microresearch/allcolours/comparator_v2/draftlayoutknobs_sm.png

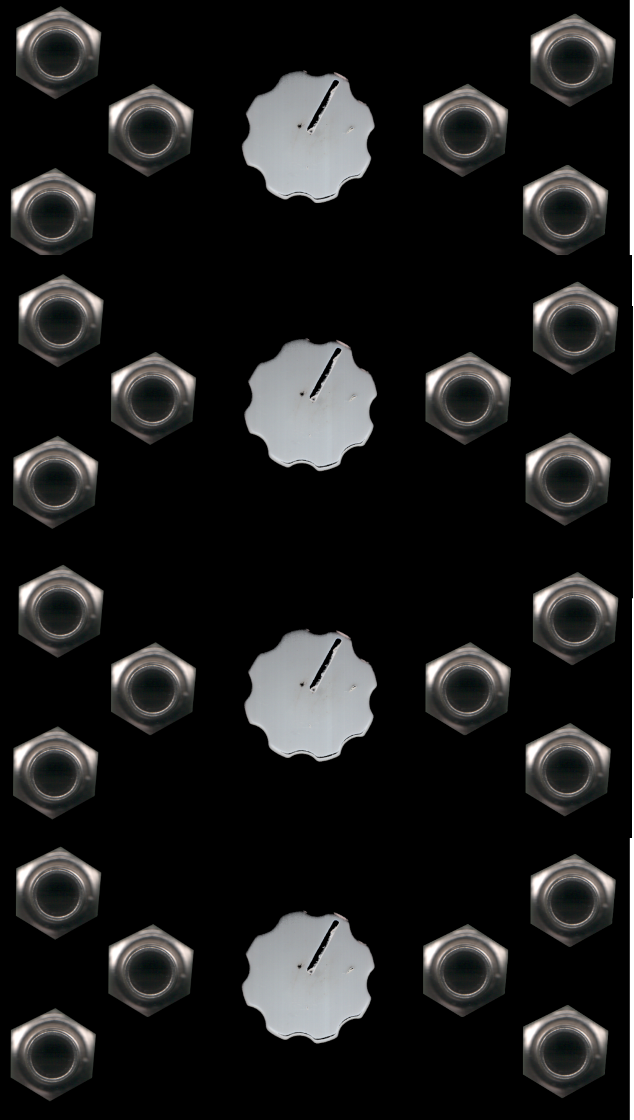
comparator_v2/draftlayoutknobs_sm.png
