microresearch/allcolours/all_colours_hardware_notes.org

* notes/phrases

- a flip flop is both memory and switch, swithcing back to oscillation to envelope and to change
- the gate is a gatekeeper
- self switching is the latch which is memory, positive feedback

* for manual/website

AURORA CONSURGENS ALL COLOURS AC

- start with Aurora Consurgens/rising dawn == All Colours stuff (see notebook - where???)
- A suggested signal path high frequency noise channeled to the gatekeeper ... same for low frequency

high and low, left and right, as above so below

- panels as a series of snakes/dragons from Ripley (collect these here alongisde other sources)

dragons also descending in harley 2407 - mouths in the basin/fountain

twin dragons also from 2407 manuscript sig page

** basic description (not for manual)

ouroboric noise at all frequencies

segments, quarters hung drawn and quartered...

walk ins from newer SR description

constructed for self-patching - this should always be undertaken in ouroboric fashion, feedbacking between the four segments...

* 3/7

clock as central - noise as clock, clock comparatored with noise,
shift reg clock, squared up noise as clock

clock as pulses

clock -> shift reg // filter // comp // as noise

all colours as pulse/noise/filter

ripley scroll

* 10/7

Shift reg/mostly in software:

https://www.embeddedrelated.com/showarticle/1112.php

https://www.avrfreaks.net/forum/256-bit-shift-register-required?page=all

http://electro-music.com/forum/topic-23881.html

* 19/7

- switch to MAX7490 - switched cap all purpose 2nd order x2 (so we can cascade
  for 4th order as compared to 8th order for MAX7400):

https://www.mouser.de/datasheet/2/256/MAX7490-MAX7491-91768.pdf

+5v, ext clock 100:1, QSOP16, 

- flip flop for shift register - flips on each clock/pulse

- shift register from http://www.cgs.synth.net/modules/cgs13v2_gated_comparator.html works well

16 shifted outs for clock OUTS in circle around

XOR also/ INS all buffered for fingers - TESTED

- to start adding to a test circuit...

* 26/7

- finger tested - op amp/buffer --|>---[] []---|>comp]=- (comparator with diode and 100k to GND)

- comparator also with finger voltage divider...

- question of AVR and/or shift reg/XOR etc. - but we need multiple ins
  and outs for AVR so maybe better served with ARM or with ATMEGA128

- TEST: how fast we can run shift reg, speeds and settings for various PWM

* 30/7

- manual in the form of a poster

- all digital sections (7490, AVR and even between both CLOCK) as blackboxed for 12v in and out = protection/ins and/or shift levels, CV in also

pulse inputs:
https://electronics.stackexchange.com/questions/43498/how-can-i-use-a-12-v-input-on-a-digital-arduino-pin
zener and resistor also as in microbd/SIR

pulse out as 2n2222, pulse in as transistor now

avr is 5v currently

- timing - for SR included code and simple pulse on/off is 130 KHz, fastest we can go with no code is 480 KHz

* 10/8

- have 16 pulse ins and outs and configure length of SR in software (maybe add one extra cv)

* 21/8

- have 7490 for bandpass or highpass and 7400 for lowpass (as is 8th stage and easier)
- gating of noise as pulses with primitive envelope/VCA with single transistor:

http://www.electro-music.com/forum/topic-33190-25.html

* 23/8

- maybe 7 ins/outs for pulses to micro, 7 envelopes-7 env is too many?

* 29/9

- see new ouroboros design as centre piece - perhaps exposed gold all
- check comparator out voltage and if we need to mix with micro/pwm for filter clock in
- new design follows eagle/worm/toad/earth
- earth as ripples in ripley sea
- LFSR as outer ouroboros
- check all possible signal paths for fingers and patchables
- standalone - fingers only with one input and out, euro - patchable internally and externally
- Q of switch for filter input between noise and other source (hand) 4066, 4053 - now dg419

* 29/11

- set 7490 as high pass and spec resistors - 10K for R2 and R4 and 200K for R3
- how to resolve finger/filter clock routings? - with another analogue switch // dg419

- list all jacks: *check this*

filter: in, clock in, lpoutx3, hpoutx3 [for feedback]

AVR/LFSR: cv_in, cv_in, clock pulse in, pulse in, pulse out, hf pulse out, hf pulse in

noise: 2x noise out for patchings, comp1, comp2, compout for processing

ouroboros: in and out

envelopes? - maybe leave as fingers only or one envelope in, in2, out

/////

- what is size in HP (for standalone we could use 4ms pod as 26, 32 or 60 HP - also frap tools)= 32HP=162.5mm or 42HP?=213mm

*20HP=101.4mm*

(height 128.5)

- how many pulse in/outs from atmega 6in 6out 2env? 6 ouroboros...

pulse in and out low and high frequency versions??? where to place?

6x pulse in/out low +1 pulse in HF, +1 pulse out HF

- sketch analogue only version for larger home etch... - fingers and two jacks...
- how to connect top and bottom pcb - jack height = 11mm (smd options for top panel?), how many connections 

eg reich: SL 2X36G SMD2,54 on one side and 8.5mm on the other

- comparator on one noise source

- normal signal path noise->comp->filter/pwm clock on filter->LP/HP OUT

- check comp as usual/flat gives straight noise out - which it would never do so we need to make this modular/seperate

* 30/11

- decision to make all patchable by jack and finger. so no switches/dg419, no norms
- thus we need to work out common patches so we can have all jacks

layers: 

filter
avr/LFSR/pulses
noise-ouroboros-osc

where we put comparator/env/low and high freq sections?

comparator=gatekeeper/triangle

- lose filter comp as we have comparator as modular, lose also avr comp for clock (replaced with pulse in)

- maybe add extra modular comp

* 4/12 ++  19/12

TODO:

- +check footprints for both projects...+
- misc graphical elements and overlays...
- noise as drops for analogue/etc
- flip-flops/toggle analogue switches (for touch open analogue version):

flip flops: 4013, 7474, 7473

dg419 or 4066/4053 or even transistor switch (as in rough envelope but then we have one way only - but we can use for other audio paths)

the simplest thing to do is to AC couple the in/out pins and bias them
to the middle of the 4053's power supply. In a +9V system, this only
needs a two resistor divider and a cap, then a resistor and capacitor
per in/out pin.

what are paths to switch

circles/layers:
1-exposed comparator
2-ouroboros
3-switched noise
4-SR
5-filter (paths in?) 

- test 7490 as bandpass again with noise source
- question of mhz for pwm -> test 

- *place low pass on output in case pwm comes through*

- for analogue only: flipflops for shift register so we have access to
  all ins (which are also outs but guess simpler/unbuffered), delay
  (switchable) on ouroboros - cap to gnd

- question of bias for ouroboros...

TEST: flipflop touch switch and SR, bias on ouroboros. delay on ouroboros

refs:

http://mickeydelp.com/blog/anatomy-of-a-drum-machine?

http://www.sdiy.org/richardc64/new_drums/dr110/dr110a1.html

transistor comparator: http://ch00ftech.com/2012/06/20/2279/

question of abstracting out connections and elements. eg. clocks, different clock sources and should we divide these?

* 3/1 design notes

- panel breakout for euro/less analogue version: replace pads, *how many?*, include voltages and in/out - interchangeable front panels hand-made perhaps
- hand drawn transistor ouroboros in centre
- led triggered by micro in middle underneath exposed/no soldermask portion (how to expose all?)

* 7/1 tests:

- 1M on ouroboros makes things quieter and more stable - we could use finger pads for bias up and down

- TODO/TEST:

- test sr cell idea(?) from philips pdf
- capacitor delay on ouroboros - say 1n between collector and base (noisier but need to see how it works properly)...

// for simple All Colours

+- pwm mhz changes DONE+

+- 7490 bandpass with noise sourceDONE+

- flip/flop touch 4013

- in out transistor micro pulses and inv/non-inv amps for finger ins? (buffers on first straight followers)

OUT - lose pull down and reduce collector to 1k, base is 10k - at highest freqency we lose gain (MHz)

IN - could reduce base resistor (47k) but seems to work ok with buffered signals, test more, and no pulldown, and with hc14?

- offsetted clocks with logical operations across clock rings - SR is
  NOT pulses (we could AND it with its clock), but out of micro SR
  simulation IS pulses

- different smd transistors tested for noise generators and re-check BEC layout etc...

* 29/1 2019 from touch: analogue/breakup tests

- only so many fingers, so use more flipflopped paths as a way of patching
- audio in/out path should not use fingers
- test individual circuits and keep simple ones as insignias...
- pads too small and too close to gnd/other signals
- for ouroboros we need switching in/out to avoid oscillation
- check transistor layouts!

* 7/2

- what we could do for test SMD assembly/quote - STM, base board or front panel with ouroboros and other simple circuits...

* 12/2

- ALL pulses/SR are in interrupts, all as multiple pulse outs without modes/cases for these, modes only for how SR connects and for slower SR stuff

- open and close ouroboros in one place with both touch flipflops and finger/transistor in

- spiral out from ouroboros with switch/latch/env elements/recursive/noise

* 20/3

- add extra 7490 in chain for extra poles
- add 4 or 8 bit DAC on shift register/AVR

* 21/6

- for all colours smaller panel: 20hp, one side is gold on bare
  pcb, other side is gold on black mask (or black mask on gold)

filtered low freq pwm, 4 bit DAC (for both low and high sides),
trimmers for noise level on back, finger osc centre pads into mix,
maybe top or bottom is diff amp (TO TEST) and other is comparator (x2
on each side)...

- tested comparator with pwm in and this can be interesting with external CV
- also mix back filter feedback is very crackly and could pulse nicely somehow? (env returned?)
- we need to swop pwm around so 16 bit is HF to get good range, and 8 bit is LF but we want to be able to change pulse width
- check all possible paths

* 25/7

- avr at 16 MHz 8 bit is too slow for fast shift register action so options:

outboard flipflops under hardware control - too complex
STM - which one, small package, easy development
FPGA - nice in long term?

we need:

1 or 2 timed and 2 pin interrupts, 2xPWM outs (so 3 or 4 timers), 4x CV ins ADC

GPIO in and out (3.3v): how many: 4ins(2 are interrupts), 5 pulse out, 1x4bitDACs,  2PWm outs, 4CV in (total 19!)

stm32 as we can use worm code and stlink programmer...

choose _==*> STM32F103CBT6 - see peaks, braids  - LQFP-48  72 MHz 5euros -> test board ordered

3 timers and one PWM... ok

//setup programming/build env/makefile/try pwm/gpio/ADC/interrupts/schematic

////////////////

///NO to below as programming is usb only via IC:

Cortex-M0+ - teensy LC, 48 MHz

M4 - teensy 3.2 72/96MHz 

MKL26Z64VFT4 Cortex-M0+

MK20DX256VLH7 Cortex-M4

//coding/programming - but teensy is programmed via usb?

https://github.com/PaulStoffregen/cores/blob/master/teensy3/Makefile

http://kevincuzner.com/2014/04/28/teensy-3-1-bare-metal/

https://github.com/djmdjm/teensy3

* 26/7 +

- different clocks for high and low pwm but keep diff of audio signals in to filters

*but how do we deal with PWM filter?*

STM32F103 base: https://github.com/trebisky/stm32f103/tree/master/interrupt

https://github.com/avislab/STM32F103/tree/master/Example_ADC

peaks: https://github.com/pichenettes/eurorack/tree/master/peaks

braids: https://github.com/pichenettes/eurorack/tree/master/braids

// TODO with blue pill test board:

- basic makefile, programming connection, blinky LED (GPIO pin 13 on C), how fast toggle pins=3.3 MHz with -O3

quick test: stm thing has from top: VDD, SWCLK, GND, SWDIO

we gnd boot0 on blue pill board, programmer header on this with usb (powered) at top is from left: 3v3, SWDIO, SWCLK, GND

and using templates example and:

:  st-flash write blink-cmsis_firmware.bin 0x08000000

this works/flashes!

//////////////

- pin input and pin interrupts, pin mappings, one or two PWM, timer interrupts x2 maybe, DAC=PA0-PA7, PB0, PB1

organise pins around what works for pwm and interrupts: TIM2 and 3 seem have global interrupts...

there are 4 timers -> 2 int->2 and 3 test, 2 pwm->1 and 4

- translate to schematic depending on timers etc.

** findings

- PWM is fast, but interrupt timer and interrupt pins peak at around
  700 KHz (which for high could translate as around 10-14K which is OK
  but we need to execute stuff!)

** refs

https://github.com/istepaniuk/stm32-templates.git

http://stefanfrings.de/stm32/stm32f1.html

https://satoshinm.github.io/blog/171212_stm32_blue_pill_arm_development_board_first_look_bare_metal_programming.html

https://github.com/rogerclarkmelbourne/Arduino_STM32

http://www.diller-technologies.de/stm32_wide.html#interrupts_extern

* 17/9

- panel left will need full solder mask and circles for ... IN or OUT?

  and circles need gold/mask or just soldermask - 5mm radius, 0.2mm thickness - and watch as
  some footprints are reversed/mirrored ???

* 23/9

- basic PCB assembled test: no heat and all voltages seem fine
- TODO: +test programming of STM+ and basic hardware

programming works fine!

TESTS/TODO: print jack layout, noise out, comps, filter with pwm, pulse in and out, finish programming, panels, xl for assembly quote 

* 9/10

- tested both noise outs - fine
- panel finished - check basic hardware before ordering - size is 101.4x128.5

* 10/10

- testing so far: we need to re-adjust /adj/ resistors on all comparators -> what did we use (we used 1k for testing now)

for noise we can use 10k-15k on positive, 1k-4k7 on negative.

but will depend on levels, also for pwm (level is 0-10v)?

- both PWMs now working fine/adjust range and dividers - filters working, check levels etc...
- ends of ADC knobs for speed are clicky - smoothing or???

* 14/10

PCB CHANGES:

- top of comp -> + adj res is now 10k, and lower to GND is 4.7k, changed on schematic but not on PCB/now changed on PCB

- we need to change the 4 incoming res to 100N caps by hand on PCB -> redo each precise location/recorded

comphf1in/r27->c10 153.71, 119.99 X

comphf_clkin/r44->c12 154.275, 79.95 

complf1in/r26->c11 104.53, 72.68 X

complf_clkin/r62->c13 102.3, 89.875 X

->>>DONE

- we need to change the 4392 comparator for a fast op amp with higher common mode input voltage, maybe also all op amps on 12v supply or?

!changed back to TL082 except for fast noise op amp!

* 21/10

- try replace 4392 with TLE2072 (mouser: 595-TLE2072IDR ) and see if bleedthrough /// 4392 on fast noise source is ok!
- no impedance issues on comp inputs
- TODO: recheck all noises, comps and filter levels with scope, clicks were
  not adc smoothing but changes - fixed to some degree with preload
  for pwm values but we can also try smoothing, check pulse in/with
  interrupts and pulse out, check timer interrupts

- study SR stuff and define precisely all modes, implement and test modes

modes.org -> max 64 modes= 4PWM x 16SR

* 28/10

- minimal bleedthrough with TLE2072 as U12 sub (rework on pcb an schematic)-DONE

doesn't bleed on pwm but signal in on C1ch 

-------> highest speed is 280KHz vpp 4.2v with TLE2072, with TL082 we
have 3.4v which seems to work fine for filter and with no
bleedthrough...

- check all levels VPP:

PWMH: 3.8v
PWML: 3.8v
noiseL: 2v (maybe increase R19)
noiseH: 3v (maybe increase R12)
compLC: 5v - as these 2 are limited by filter clock input diodes
compHC: 5v
compLA: 7v
compHA: 8v
filter outH: 2v
filter outL: 1.6v peak - maybe more gain on these ? - input we halve on way in from diffaudio which is the 2 compsLA and HA 

- check pulse outs: DONE all working
- check interrupt ins and regular pulse ins

problem is that we are on the same interrupt for both clock pins in: void EXTI9_5_IRQHandler(void)

[note if we want other pulse ins as interrupts these are on: PB6 and PB10 which are EXTI: 6 and EXTI: 10 I guess?

so 10 (HF side) would be on different interrupt: EXTI15_10_IRQHandler

but both work ok as interrupts - sample code toggles pulse out on each side... DONE

- check 2x timer interrupts: we use TIM2 for HF and TIM4 or LF! DONE!

- test that both mode CV knobs work ADC0 and ADC1 !-> yes!

/////////////////

- adc smoothing if we need // not necessary so far but might be for modes...

- define clearly all modes

* 29/10

- schematic reworked and some problems fixed so will need to re-order and test again

- started on modes// tested simple pulse outs and simple SR codeDONE but
  need to doublecheck with test.c lap code to make sureDONE

- speed of updates/sr interrupt means we can't use speed as offset, but maybe in pulses code!

* 30/10

// TODO: before we fill out all modes, deal with length and spacings - SRlengthh should not be <2
// ----: also deal with how we space the out bits - now is just length/2-DONE

// copy working length code from mode 0 to rest->DONE but we need to re-test all of them

// test lf and hf together with latest mode code - CLOSE

// thinking also whether clock/pulse should be toggle or other pulse as toggle?
// as other pulse is not normed to anything - leave as clock as toggle DONE

* 31/10

- added LF code - in TIM2 interrupt we need to watch how fast we can run it - otherwise it doesn't run - check all possibles!
- case 7 - electronotes crossover seems to work so far

* 1/11

- all SR modes implemented on high side - to re-test one by one, copy over to low

// questions of tap out for each

- start on clocked modes and pwm modes...

* 18/11  +

- TODO: test power/bleedDONE, clarify code, test modes, re-check/order PCB-DONE, re-test-check amp parts to alter, check panel/print itDONE

power is: 120mA at +12V, 30mA at -12V, 0mA at 5v

- test mode/case 7/electronotes on lap TESTED/DONE!

* 24/11+

- to re-do all SR as lower bits = faster = (so change looker and SR taps also) and other codes/re-test each mode and tweak DONE

////////////

- finish all modes with PWM
- test which modes can do without pulses in (not clock, other)

* 27/11+

- we need to fix levels (high freq noise now with 100k in feedback
  gives 5 VPP), fix range of comparators for this - so each is say
  4.7k top and bottom to give 2.5v-7.5v with centre at 5v

- testing HF SR modes DONE

* 9/12+

- change pulse outs to 1k from 10v to transistor TODO/DONE on schematic
  
- TODO: re-test all modes, amplitude tests with new R12, R19 (mark)

- question of SR/modes speed [on/off in pwm mode is 120 KHz max on x200 - do we need this to be faster?]

can't get much faster - new model on modes 0 in both gives us less instructions...

* 30/12

- changes on schematic and PCB: r61 to 24k, r102->24k, r12->100k, r19 to 240k TO TEST... how much 12,19 will vary with noise sources?

finalised here to R61=27k, r102=10k (for filters)

r12=100k, r19=470k for noise sources

- xls BOM format for pcbcart in progress/close to finished, double check before quote, check all new values also to finish

- software updates 

- *one sr as clock for the other - but hard to implement across different interrupts or... ? - maybe keep for next SR module*

* 6/1/2020

- how to scale filters 1v/oct? // logarithmic - we have 0-5 volts so that is 5 octaves

speedh=(ADCBuffer[2]>>4)+312; // adjust these base settings

so 12 bits is 4096

but which way round (we want end of log bit at lowest so subtract from Y)... and what is our range - here it is from 312 (highest frequency) to 4095+312 (lowest)

(2^5 = 32x)

freq for 4096 is: 12MHz (fastest)->312 = 38k / 32=1.2k approx which is a value of what in pwm = 10000 so that is our range (13 bits approx or map this to less bits in lookup)

or do we just map 2^5 and add the 312?

where is log_gen - here now!

so we need to measure this and check this somehow

[from worm: // 1v/oct for 5v = 2^5 = x32  generated by: log_gen.py
// xx=numpy.logspace(0, 5, num=1024, endpoint=True, base=2.0) # num is now many we want]

* 7/1/2020

- now PWM ranges from 7.5KHz to 220KHZ which is around 32x. to test with fixed voltage increments...

- 2nd build has all working but both low noise is 3vpp, high is 1vpp which is too low (both should be ideally around 6v), swop out Q1 for LF, Q3 for HF to try to fix

otherwise all fine...

- should we have SR timing also as logarithmic - test this (what scale though - at present it is: 

  speedhh=ADCBuffer[2]>>6;     // test changing counter for LF and HF IRQ 

so that's 10 bits - value 0-1024 for countings... but do we want this as octaves then we would only have 32 graduations or less as there is prescalar of 8 on this...

or how to do this without prescalar and period? or at least a lower prescalar? but we have both LF and HF sides running in this one...TEST?

- is it possible to have extra PWM modes for linear and range towards the top and bottom in both cases? (possibly 128 modes in that case)?

- do we make DAC for PWM follow the log array or....?

- *we need to test PWM DAC spacings and also this log option!*

// recheck schematic/all and rematch up parts to check is all there (print both)... check diodes=checked and caps=checked orientDONE -> nearly ready for quote...

* 8/1

list of TODOs for software and hardware before we do quote:

- test PWM range with 1v steps - DONE and FIXED!

- test SR timing as log and if we can go higher on prescalar/period with longer speedhh etc.

we can't go higher so can't really do a 1v log there - *so we need to decide what kind of range we have here* 

but maybe it should be logarithmic so more detailed at upper end... tho. this will involve repeats -> question of range is the one but *LOG IT*

- can we work in 128 modes with split of linear/exp and how to do this
  fast (can we handle 128 modes?) = test slippage, also would be more
  than 128 but maybe limit to selected modes...

so test slippage first: *we can only really have 64 modes*

- do we have PWM DAC follow LOG array? should be... test say mode 0 with DAC - DONE but gurgling results ->

maybe use less bits, spacings (but these will have to be dependent on size so we end up with lots of arrays, anyways)..

PWM sounds better withOUT LOG option and wide range which makes it gurgly, or what can we use to effect range?

////

- test PWM DAC spacings (how could these also be variable in one mode perhaps - in pulse mode?)

- do all modes make sense - what alternative modes there could be which take advantage of internal access to each SR bit?:::

//- CV as chance of a bit leaking or spreading either side, what could
be malfunctioning logic with CV as chance on bits, swap and msk bits
across two SRs,

(also. differing taps, shifting taps arrays) - *maybe we can have differing sets of modes for each side to get over constraints - eg. on lf side we have close taps*

0- pwm follows speed cv 

1- pwms follow clock pulse in for each - how we do this? speed CV as divider/multiplier of this - how to do for LOG scale 

2- pwm follows DAC from SR + pwm follows DAC - different range or spacings maybe in pulse modes - can have different PWM modes paired with pulse/cv modes?

3- pwm is offset against the other (with each speed as plus/minus offset) - if both have this mode then left one is set by speed CV
// how often do we update this last one...????? and we need to record this somewhere (or is as PWM -> check?)

analyse modes - what sounds the same, what new we can add

*also what we can keep for next one - eg. shifting the arrays of taps, arrays of spacings, one sr as clock for other (would need to be as function pointer maybe - try this out)*

* 9/1

- re-testing earlier comparator vs. newest and now stick with newer as less offset issues DONE-NO!see below

- TODO: fix on and test modes, any mode differences across each and alt taps stuff:

shifting the arrays of taps (4 taps in each one, limited to length) -> shift and wraparound 

* 13/1

hardware changes:

- we will revert to earlier comparator for better sound maybe.. (100k
  in on gnd is needed) and rest as old, but with one side comp gnded
  and we will need to select values - TODO, re-order PCB... extra parts and extra caps for +- power...

- C7 needs to be 1uF tantalum! 25V

- new diodes are 1N4148: Diodes - General Purpose, Power, Switching SURFACE MOUNT FAST SWITCHING DIODE  

1N4148W-7-F  Diodes Incorporated SOD-123 

- changed c7, changed comparator, changed 12v on pulse and pwm outs and added divider for pulse outs, added two protection diodes for 7400/7490

- added 1K in on both filter clocks.

[note in previous version lower should be 20k and upper 10k?)

* 14/1 TODO: 

- summarise software TODO:

1- review all modes and maybe squeeze in new mode with shifted tap arrays (test this anyways), also more modes for internal SR access *like what?*

list these, test these, note that we can have different modes for each side and different pwm/dac modes also depending on modes

potentially we could have ADC/DAC mode (now mode 12) which also sets the spacing of the taps, shifts these taps in real time...

add in as many modes as we can imagine and then trim down, also alt PWM modes...

2- what is the range for SR timing - it should also be logarithmic but not 1v/oct
3- PWM DAC spacings and maybe extra mode
4- for PWM how do we combine clock and knob in one...(clock is multiplier of knob?) but PWM is log array = we combine in mode 1 now = not as a single mode
5- so extra pwm mode with DAC spacings - also different ranges
5.5- for pwm and SR modes:  either 4x sections of 16 or 16 sections of 4??? latter is easier... try both
6- implement all modes and test - see notes below also for fixes
7- clean up comments and ordering of modes so that for example change of length is BANG in the quarters/middle of CV

* 15/1

- checked and doublechecked, added vias

- thinking to norm noiself_out to pulself1_in1 and noisehf_out to pulsehf1_in1 but we need to test this -> *test with all modes*

- do we have ADC in mode (for PWM out) - would be in pulse modes IN PROCESS mode 12...

- and also maybe we can get rid of pull downs on pulse in transistors: R79, R91, R104, R107 -> leave these for optional pull down 1M

TEST THIS! otherwise all ready to go - but perhaps finish and test software until we order... TESTED!

to order pcbcart: board is Board Size (width) 	101.2 mm 	Board Size (height) 	106.2 mm 

* 17/1 __+++

- norming works and all seems ok
- levels checked on older comparator: offset is maybe 300mV, Vpp is 8.5v (but without divider) - with divider is 4.5v
- changed lower divider of comps above to 47k - TESTED so around 2v positive

- re-check SR logic of shifts
- new ADC/DAC mode to test
- any additional or experimental modes

//NEW

- maybe norm pulseouts to diff audio in  instead of comparator so is full signal flow - try this idea out for different modes-> *STICK WITH NORMS AS IS*

- *Upper or lower bits for DAC out?* - how is this for other designs? mostly on lower bits

OUTS (but they have no DAC in):
TM: first 8 bits where pulse comes in
electronotes: wide spacing. lowest bits where shift in happens seems most popular
wiard: full 8 bits
others: top bit which is shifted out 

- ADC in on mode 12 is at upper bits now... *TEST*

how does spacing for DAC out work?

8 bits from different positions towards lower end...

DACOUT= ((shift_registerh>>pos[SRlengthh][0])&0x01) + ((shift_registerh>>pos[SRlengthh][1])&0x02) + ((shift_registerh>>pos[SRlengthh][2])&0x04) // etc 

pos[32][8]={

just need to calculate 8 bit arrays for positions based on length - basic positions table <<1 each time...

*TEST both options and spacings*

- mode where we invert speed of SR against PWM so does not track each other // where this could be

- fixed mode 13- electronotes: CV selects which bits to set to 1 = chance of change -> with lookup array -> TESTED/DONE

- question of entry of extra pulse bits in modes 10+

* 21/1

software:
- clean up codeDONE
- positions table for DACOUT spacings *DONE/TO_TEST*

*Note that spacings could be say in HF code side only (as is NOT a low pass)...*

- SR counter/timing range/array? speedhh *DONE/TO_TEST*
- combine clock and knob for mode 1 of PWM-discarded
- PWM/DAC range - *DONE/TO_TEST*
///

- new modes: to code and test:

+ shifting the array of taps (by CV or by pulse? try both), HOW both works? *DONEforfirstsetTEST-mode23*

CV shifts one selected by pulse 32=5 bits (%length), clock pulse shifts one selected by pulse 

+ from TM - TM with probability CV (using random bits from other SR!) // combined with variable length -> pulse mode

+ mode where we invert speed of SR against PWM so does not track each
  other // where this could be? - or we have pwm mode which inverts
  this... and get rid of following pwm mode was mode 3 (or mode 3 does
  that kind of thing anyways) = *finish and TEST!*

+ we can insert pulses into SR at points determined by CV or by pulses in - *DONEforfirstsetTEST-mode24*

+ we can make SR loops within SR at certain points/sizes determined by CV or pulses in - *DONEforfirstsetTEST-mode24*

* 24/1

- maybe ditch clock/pwm mode and following mode to just have CV/DAC modes doubled up by SR CV (speed/cv) working in opposite direction...

(do this outside modes for adc)

so 1-pwm from vc, 2-pwm from dac and next two are inverted *TEST*

* 28/1

- PCB ordered: all_colours_28012020.zip

* 29/1

TODO: 

- test all changes and new PWM mode work

---> do we use ADC/CV for offset in PWM DAC mode or - else inversion makes no sense ? otherwise we have 1 extra mode to deal with (3)

- test lengthbitl and lengthbith changes
- any other speedups
- re-check all the log arrays and logic
- test and finalise modes, which new modes to use?
- port all mdoes to LF and re-test all for speed

extra mode TODO:
+ from TM - TM with probability CV (using random bits from other SR!) // combined with variable length -> pulse mode *DONE-toTEST*

+ new mode with independent LFSR clocking regular SR (only in CV as speed) *TO TEST!*

*also added in length via incoming bit - this could also be used in modes which don't use the extra bit TEST*

* 7/2 +

- testing first of DAC/PWM modes -> we don't add offset from speedCV
  as this complexifies things, but it could be nice to fiddle with
  range somehow, 

- speedhh in that loop in general could be slower at one end (loggy this). logger: 2^14 -> *tested and seems a good range*

- but should DAC be loggy or straight? *loggy*

- what extra mode could be - different range for DAC or follower/offset mode as before? and how we could do range thing otherwise?

- 4th PWM mode could use bith/pulseout as gate to change the PWM (CV->PWM) *To implement and test...* - testing and change is not great

options for mode 3: 

-different range for DAC -maybe
-follower/offset mode -maybe
-gate mode - maybe
-offset+DAC mode noX

//- how to implement and test dual/crossover SR modes - for next SR model? *TODO* //

- extra mode - bits swop LF to HF *TO_TEST*

- that we don't necessarily need same sets of modes on each side so we can have lots of extra modes

* 17/2+

TODO:

- test new modes

extra modes which pulse SR using clock or input bits: only advance if
we have a bit but still output, only output if we have a bit etc... so
that we can gate on and off -> in both sets of pulse/speed modes!

TESTED above in speed modes only... TODO: implement and test in pulse modesTESTING-DONE

- *more maybe on LF side these ones*

/////// done and testingsDONE but can be expanded across different modes which don't make use of certain bits

extra modes use pulse or input bit as length controller

extra modes can also choose to output a pulse only if there is bith (modes for fast side only)

extra mode in which pulse on is triggered by bitH but gated off by input bit or pulse
  
/////

with extra modes we have 35 which is more than 16 across each side...

identify core modes which can be expanded and which we can lose...

which are more on low side=those which are gated

on high side=variable pulse side and short pulses (inversion of gating)

- finalise basic modes/test across both low and high side and test speed of these all together
- finalise PWM/DAC modes and test how both work together

* 24/2+

- test extra modes 50-53-TESTED... and also implement test:

      from case 26:
	// Independent LFSR clocking regular SR (only in CV as speed) - TESTED/WORKING!
	// can use input bit as length of either of the SR
	// also can still use in clocking side of things
	// no use of input bit...

TESTED

also we can use input bit as OR (in all modes with no input bit used)

- also extra mode where we use pulse to gate if we add in the input so
  can have like pulse noise in, or straight pulsing or gating of noise
  or another signal out (maybe this on LF side). use it as a toggled gate/tap TESTED

* 26/2+

- we can also use independent LFSR to clock own LFSR-DONE/tested!

- we can make a grid of uses of: CV, input clock pulse, clock pulse,
  SR type // and parameters such as gating, length etc. (= maybe as
  manual or just to classify or for new SR module)

- also for this one or for new SR module -> one SR clocks the other, gates the other, sets length of the other etc.

* 27/+

- check CMOS cookbook - eg. pulse in (CV mode only) divides down output SR ? how?

- refine looped SR so is logic XX on incoming bitTESTED/WORKING

- +how we could double pulses for filter clock?+

* 16/3+

- vary with CV the number of bits we shift!? TODO/TEST!TESTED fine

* 22/3+

- new hardware tested all fine - maybe re-check all levels! TODO! - 

* 26/3+

- re-checking modes/listening/ we need 16 modes... 8 each cv/pulse?

*THESE are CV modes*

- CV side HF: 3, 4, 7, 9, +4 from: 23, (25), 26or28, 29, 34, 35or36, (41)

*but now we want to have 16 each:*

*CV_HF: 0, 1, 2, 3, 4, 7, 9, 23, 25, 26, 28, 29, 34, 35, 36, 41*
*CV_LF: 0, 1, 2, 3, 4, 7, 9, 23, 30, 32, 33, 34, 35, 37, 39, 40*

- LF: 0or1, 9, 30or31, 32or33, 35, 37, 39, 40

       //->>>>>>>>>>>>>> 0- pulse (PB5) toggles loopback to OR with new input bit (PB6) /or just accept new input bit (CGS)

       LF**//->>>>>>>>>>>>>> 1- pulse (PB5) toggles loopback to XOR with new input bit (PB6) /or just accept new input bit (CGS)

       //->>>>>>>>>>>>>> 2- loopback ORed with input bit and pulses flip/leak bits INSIDE the SR selected with counter and pulse

       HF**//->>>>>>>>>>>>>> 3- pulse(1) inverts the cycling bit in - this is Turing Machine - cycle bit or invert bit (**no extra input bit is used)

       HF**//->>>>>>>>>>>>>> 4- parity for loopback XOR is determined by pulsed bits in -> select bits with pulse and queue 

       //->>>>>>>>>>>>>> 5- wiard1: pulse selects new data or loop old back into SR

       //->>>>>>>>>>>>>> 6- wiard2: pulse selects new data or inverted loop old back into SR

       HF**//->>>>>>>>>>>>>> 7- electronotes: bits of the first SR determine (via NAND) if we recycle 2nd SR, or add new bit from the first SR - no input needed Q of lengths?

       //->>>>>>>>>>>>>> 8- SHORT PULSES OUT as mode 0: pulse (PB7) toggles loopback to OR with new input bit (PB10) /or just accept new input bit (CGS)

	LFandHF**// 9- LFSR noise only with varying taps depending on length with new bit ORed in depending on pulse - for LF we can do mirroring!

      HF**case 23: // experimental modes 23+ here and 32+ in pulses - TESTED/WORKING!
	// shifting the array of LFSR taps = ghost_tapsH on the high side
	// clock pulse shifts one selected by pulse 

      case 24:
	// Insert pulses into SR at points determined by CV or by pulses in - very similar to mode 2 above - TESTED/WORKING!

      HF**case 25:
	// SR loops within SR at certain points?/sizes determined by CV or pulses in = basic SR of OR with incoming bits - TESTED/WORKING!

      HF**case 26:
	// Independent LFSR clocking regular SR (only in CV as speed) - TESTED/WORKING!
	// can use input bit as length of either SR
	// also can still use in clocking side of things
	// no use of input bit...

      case 27: //too complex?
	// if we have a bit then change/swop that bit from LFSR side... (could also be OR or other relation) - TESTED/WORKING! changed/TESTED

	/*
          extra modes which pulse SR using clock or input bits: only advance if
	  we have a bit but still output, only output if we have a bit etc, advance but only output if we have a bit: so 3 options:

	  if we have a bit: advance/output // advance/out anyways if or not // advance anyways, output if

	  that we can gate on and off -> in both sets of pulse/speed modes!	  
	*/

      HF**case 28:
	// Independent LFSR clocking regular SR (only in CV as speed) - as mode 26 but now we use 0x0080 bit also to see if we shift things...
	// no use of input bit... - TESTED/WORKING!

      HF**case 29:
	//->>>>>>>>>>>>>> 3- pulse(1) inverts the cycling bit in - this is Turing Machine - cycle bit or invert bit (**no extra input bit is used)-> our 3 options if we have a bit 0x0080

      LF**case 30:
	//->>>>>>>>>>>>>> 3- pulse(1) inverts the cycling bit in - this is Turing Machine - cycle bit or invert bit (**no extra input bit is used)-> our 3 options if we have a bit 0x0080

      case 31:
	//->>>>>>>>>>>>>> 3- pulse(1) inverts the cycling bit in - this is Turing Machine - cycle bit or invert bit (**no extra input bit is used)-> our 3 options if we have a bit 0x0080

      LF**case 32:
	// extra mode in which (both) pulse on is triggered by bitH but gated off by input bit or pulse - but do we need like a toggle?????
	//-BASE it on::: >>>>>>>>>>>>>> 3- pulse(1) inverts the cycling bit in - this is Turing Machine - cycle bit or invert bit (**no extra input bit is used)

      case 33: // and invert the above
	// extra mode in which (both) pulse on is triggered by bitH but gated off by input bit or pulse - but do we need like a toggle?????
	//-BASE it on::: >>>>>>>>>>>>>> 3- pulse(1) inverts the cycling bit in - this is Turing Machine - cycle bit or invert bit (**no extra input bit is used)
	
      HF**case 34:
	// extra modes use pulse or input bit as length of SR controller: see mode 42 below
	/// length thing	
	
      LF**case 35:
	// Independent LFSR clocking regular SR (only in CV as speed) - TESTED/WORKING!
	// can use input bit as length of either SR = here is regularSR

      case 36:
	// Independent LFSR clocking regular SR (only in CV as speed) - TESTED/WORKING!
	// can use input bit as length of either SR = here is shift_regx

      LF**case 37:
	// Independent LFSR clocking regular SR (only in CV as speed) - TESTED/WORKING!
	// with input bit or'ed in

      case 38:
	// follows case 3 TM but we TESTY - use 0x0080 to toggle any output = gating
	//->>>>>>>>>>>>>> 3- pulse(1) inverts the cycling bit in - this is Turing Machine - cycle bit or invert bit

      LF**case 39:
	// as above but LFSR?

      LF**case 40:
	// pulse in means a divide/flip flop

      HF**case 41:
	// pulse in means double a step..

*//// THESE ones are PULSE MODES:*

*but now we want to have 16 each:*

*PULSE_HF: 10, 11, 12, 13, 14, 15, 43, 44, 45, 48, 50, 52, 53, 56, 57, 58*
*PULSE_LF: 10, 11, 12, 13, 14, 15, 43, 44, 45, 48, 50, 52, 53, 56, 57, 58*

- pulse side HF: 10, 11, 12, 13,  43, 45 or 46, 52, 53
- LF: 14, 15, 44, 48, 10, 11, 12, 13

    **BOTHcase 10:
      //->>>>>>>>>>>>>> entry into SR from CV - TM = no input bit 

    **BOTHcase 11: // MAYBE put this in middle of CV select mode for easy access TODO
      //->>>>>>>>>>>>>> CV selects length of SR which will stay with us .. -> LFSR here
	
    **BOTHcase 12: // works fine with cv in
      //->>>>>>>>>>>>>> NEW mode TESTY: entry of ADC in from CV into upper bits?

    **BOTHcase 13:
      //->>>>>>>>>>>>>> Electronotes: CV selects which bits to set to 1 = chance of change

    LF**case 14: // could replace mode or one of these ???
      //->>>>>>>>>>>>>> uses CV as speed/flipflop/clock divider
	
    LF**case 15:
      //->>>>>>>>>>>>>> as mode 14=speed divider with XOR rungler: XOR out with input bit

      // experimental modes some tested!
    case 42:
      // + from TM - TM with probability CV (using random bits from other SR!) // combined with variable length -> pulse mode - TESTED/WORKING!

    HF**case 43:
      // as above but other way round with CV for length and incoming bits for probability of TM

      // more experimental modes
	/* 

	  modes 10 and 13 don't use input bit 0x0400 so we can use this for= case 10 as test case// try with 13:

          extra modes which pulse SR using clock or input bits: only advance if - *more maybe on LF side these ones*
	  we have a bit but still output, only output if we have a bit etc, advance but only output if we have a bit: so 3 options:

	  if we have a bit: advance/output // advance/out anyways if or not // advance anyways, output if

	  that we can gate on and off -> in both sets of pulse/speed modes!	  

	*/
      
   LF**case 44:
      // as mode 10 
      //->>>>>>>>>>>>>> entry into SR from CV - TM = no input bit = 1st option of above... - *more maybe on LF side these ones*

    HF**case 45:
      //->>>>>>>>>>>>>> entry into SR from CV - TM = no input bit = 3rd option of above...

    case 46:
      //->>>>>>>>>>>>>> entry into SR from CV - TM = no input bit = 2nd option of above...

    case 47:
      // *we could use CV to set length of pulse (say up to 128 which is 7 bits >> 9)*
      //->>>>>>>>>>>>>> as mode 14=speed divider with XOR rungler: XOR out with input bit
      	// - TESTED/WORKING! - not so exciting ....

    LF**case 48:
      //      	  extra mode in which pulse on is triggered by bitH but gated off by input bit or pulse
      // use mode 13 as example here:::
      //->>>>>>>>>>>>>> Electronotes: CV selects which bits to set to 1 = chance of change

    case 49:
      // and we can have the inversion of 48
      //      	  extra mode in which pulse on is triggered by bitH but gated off by input bit or pulse
      // use mode 13 as example here:::
      //->>>>>>>>>>>>>> Electronotes: CV selects which bits to set to 1 = chance of change

      /// TO TEST: mode 13 with the 3 timing options
    case 50:
      //->>>>>>>>>>>>>> Electronotes: CV selects which bits to set to 1 = chance of change

    case 51:
      //->>>>>>>>>>>>>> Electronotes: CV selects which bits to set to 1 = chance of change

    HF**case 52:
      //->>>>>>>>>>>>>> Electronotes: CV selects which bits to set to 1 = chance of change

      /////////////new /exp      
    HF**case 53:
      // - after case 25 - SR loops within SR at certain points?/sizes determined by CV or pulses in = basic SR of OR with incoming bits

    case 54:
      // - after case 25 - SR loops within SR at certain points?/sizes determined by CV or pulses in = basic SR of OR with incoming bits
      // shift only on that bit

    case 55:
      // another loop variation, bith and loopback XORed (or other logic eg. OR) back in to first bit:
      //       - TESTED/working
	
    case 56:
      // Independent LFSR clocking regular SR (only in CV as speed) - TESTED/WORKING!
      // can use CV as length of either SR = here is regularSR

    case 57:
      // Independent LFSR clocking regular SR (only in CV as speed) - TESTED/WORKING!
      // can use CV as length of either SR = here is SRx

    case 58: // change the shifting amount - sort of works but not a great range and we need to take care of length

* 27/3+

- still question of slowest speeds of DAC PWM SR mode -> slower on LF side or?

note:: *2- pwm follows DAC from SR + pwm follows DAC - different range or spacings maybe in pulse modes - can have different PWM modes paired with pulse/cv modes?*

* 28/3+

- now thinking to have no DAC mode so just the 2 pwm modes inverted, so we have 32 modes on each side -so 16 cv, and 16 pulse

* 1/4/2020+

- implemented high side of modes. TODO: port required modes over to left side, test individually and  test all with speeds...

- if we can go faster in main.c? max is 40 in   TIM_TimeBase_InitStructure.TIM_Period = 40;

- re-checked all levels VPP:

PWMH: 4.4
PWML: 4.4
noiseL: 4
noiseH: 6
compLC: 4.5
compHC: 4.5
compLA: 4.4
compHA: 4.4
filter outH: 5v
filter outL: 5v

////
- maybe compare switch with function call approach -> how to automate this?

with func call approach in func_it.c we can come down to period 38 but this needs to be tested thoroughly

* 2/4 

- tested func call and is not fast/ crashes on interrupt to back to other which is stable at 50 Period. trying a few speedups here...

48 now

- maybe also identify which modes are slowest
- we need to decide if we change SR lengths across the whole thing?

////

- note for MANUAL - that we can untie comparatored noise from filter diff in by plugging blank/nowhere cable into diff - then we an use comp just for normed SR in say

* 14/4

- ongoing testing - speed dropped to 50
- we don't change length for all functions but just in certain functions... static tho as needs to run across some...
- re-test each SR mode after this - we leave arrays as they are...

* 18/4

- we lowered PWM on LF side so starts slower - divider now of 1
- new version with mode 0 (right side) as DAC - to test out

* 21/4

- keeping with DAC mode but might need slowing down - can't have different timings tho as we still have SR pulsings...

testing 16 bit loggen for SR, can also be 15 bits

DAC should now not be LOG - so we need to change this...

- more ADC and bit inputs maybe in modes working with DAC - so we have maybe all modes in the switch and no if...

eg. case 18 we had ADC in -> now we copy and play with new versions here for ADC/DAC modes

* 25/4

- added new modes for DAC side but now we need to do large integration and rework all DAC/log stuff - maybe some modes have different ranges

* 29/4

- re-working log stuff: remember to add in new modes for DAC and we can also change range of DAC in some cases if we like
- working first on lf side

- there are 10 DAC mode now - so 9 new modes... how do we distribute these - maybe need even more DAC modes in this case

- *test each pulse mode with straight DAC to see which make sense to keep!*

- *should also be inverted or we're stuck at the high end!*

* 1/5 // 4/5

- working through and fixed inversion on 32-47 LF DAC modes
- TODO: fix 48-63 HF test DAC modes on pulse side and re-investigate the new pulse DAC modes with the change of inversion FIX

FIXED - now all modes should be there - 

+that there could also be a few DAC modes where we process the SR faster than the DAC (say DAC is 4x slower in some cases) -> this on speed/sv side only+

*Test each and every mode AGAIN!*

// in process - changed mode 39 so that we can trigger PWM out!

*in some cases maybe change DAC range*

*TEST, PLAY?RECORD and then clean up code*

* 5/5 // 12/5

- testing out interpolation in mode 47 seems to work ok but do we want this?
- try equal weighting DAC? also seems to work?

- TIM3 for LF pre-scalar as 0 or 1?

- test current with overclock to 128 MHz???

- +more amplitude on output of filters - HF- R102 (try 18K) was 10k, LF- R61 (try 33k) was 27k+

+revert these to 10K as we made other changes - could be say 12k both+

- LF as 10k and HF now as 10k

- recap on adjustable resistors to *leave OFF BOM*: noise high: R19 noise low: R12

- finalize DAC policy = *mix it up, equal weightings, OR just interpolate, OR interpolate only in speed mode...*

- *we need to add 10uF for 7490_IN_LOW (both)*
- *also remove diodes on IN LOW too, remove c40 or keep as jumpered 10R*
- *for 2 upper PWM comps we have now 15k upper and 1k lower for divider*

- dividers for TIM1 and TIM3 changed for overclock...

- added even slower SR array

- maybe second (lower one which is: on LF, on HF) pulse out should be divided down for some variation - try on 47! DONE both sides

and go back to not-so-slow SR speed array DONE - tested, but we need to decide if we want all modes to have same divider or *YES*

- top of each filter range is kind of arbitrary - seems C8 on HF, LF we don't know

new array for LF much lower...

measure current now???

[former: power is: 120mA at +12V, 30mA at -12V, 0mA at 5v] - recheck now is more like 145/150 so not so much difference...

now is 170mA at +12V, 30mA at =12)

* 15/5/2020

- we need smoothing on DACs for speeds DONE
- added smoothing also for modes and seems about right now - +TO TEST!+ - tested OK!

* 22/5/2020

- testing interpolation - fixed overflow but need to test on HARDWARE
- fixed and working on hardware but needed to reduce speed of interrupt in main.c
- maybe 12k or 15k on HF filter (testing now with 15k)

* 2/6/2020++

- implementing divide down on HF side - question of modes such as 20,21 to test which already do divide downs, watch for lengthbith! // to test

- TODO: DAC modes:

 interpol 32-47 (CV) - DONE, TESTED but we can have different ranges for some...

 spacings 48-63 (pulse) - DONE/TO_TEST note that some of these have special DAC out modes already (which - these are 58-63 on HF side) TESTED

- test all pulses OUT and dividers on HF side - DONE

- fixed pulse divider on mode 20 and 21 - do this also for low side when we check thatDONE
- fixed lengthbith so makes sense now -   do this also for low side when we check thatDONE

- finish divide down on LF side and test allDONE

- interpol and spacings for LF side and test all

- changed mode 38 on both sides

* 4/2/2020

- finished all DAC modes on both sides - to test all in practice

- on low side we also have different ranges???

- new exp. mode -> so we take DAC from other SR and use this as speed! frees up CV and PULSE... mode 65 - but where shall we put this on each side - to replace?

lose 25 on LF side - as this just repeats and then we can place as mode 31 but we need to add as CV mode DONE

and on HF side what to replace? but we want as 15 so is part of CV

or as mode 1 so we can find it!

* 5/2/2020

- we changed interpol in mode 32 so is every x bits - do this for all or keep different programs?

(to do this also for unweighted DAC modes 48->58 - test in 48 -> revert back to no timing here as is smoother

- speed control by DAC is now as mode 0 and placed inside speed loop on both sides_ TEST if IN or OUT!?
- fixed smoothing which was missing mode 0

- program different DACs across DAC modes - so some with different ranges and some with speeds

// so we have on each side: 

0-15 -CV NO DAC
16-31 -pulse NO DAC

//DACS:
32-48 -CV and DAC -> interpol options (how many bits to wait if any, all modes now have basic waiting) and different ranges in either case

49-57 -pulse and unweighted DAC - different ranges, 8, 16 or 32 bits, weighted DAC in some cases 

58-63 -pulse and other DACS

* for quote

board is Board Size (width) 	101.2 mm 	Board Size (height) 	106.2 mm 

order new prototype TODO

all_colours_1911 already ordered

allcolours_in_progress.xls

* TRACKLIST

These are in fromzoom_2020 on intenso HD: copied to recordings here in AC as first:

387: internal patching and single DUSG as modulation source 
394: internal patching, static (no twiddling)
435: internal patching, single DUSG, some smooth slow changes
439: internal patching, single DUSG, some smooth slow changes
451: dual DUSG with changes across all, small changes
453: same 2 modulations **
454: as above

- july_zoom_transfer?

low no ext 152 160*
high 154 161-ext*
156** 165** 159

low 166/163 with ext env in

- fromzoomoct30? 

no ext 000, 3,4,5,6,7,8,13,14,15/16,9extmod**,10lowextmod, 50-hi-speech in, 54-no cv, 55low

- octnovdec2020 - latest (keep all on zoom)// octnovdecstillonzoom

0017 - hf with one external source in (DUSG) mode 57
0018 - as above mode 58
0019 - as above +1 extra modulation source mode 61
0020//21 - as above mode 62
0022 - as above mode 63

* future module - name? Heaven's Gate, Walker, Stalker

- note that Turing machine 8 bit DAC uses DAC0800

https://www.mouser.co.uk/ProductDetail/Texas-Instruments/DAC0800LCMX-NOPB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

- from TM - TM with probability CV (or probability from other SR!) combined with variable length

- from above:

also what we can keep for next one - eg. shifting the arrays of taps, arrays of spacings, one sr as clock for other (would need to be as function pointer maybe - try this out)

* older notes

- ignore other all_colours schematics in ERD!
- copy and add to git so can change schematic - DONE

- add one shot flip flop. monoflop/uniflop from DDR book - where we put this or
  could be in atmega? - makes pulses of uniform length before 7400?
  and after comparator

monoflop=monostable multivibrator?

- Henry noise seems to be low for input into 7400/test
- external clock for 7400 only works with comparator/noise not external signal
- test inputs to 7400

  - add clock input diode limiters DONE added on proto
  - add maxim 7400 input limiters using tl071 DONE
  - is Sample/HOld working? - try reverse GSD to DSG for our 2N5457 and try remove R20 - maybe needs re-design for right parts and slew NOT USED
  - how to deal with multiple switching paths for feedback JACKS
  - shift register in feedback path? ATMEGA
  - further elaboration with hand/finger/capacitive sensing mandala? - changing high freq clock with hand/fingers?

* older key 

sockets from left into pins 

sockets: 2143 ???why???

pins: 00001234

CO  comp out
BI  buffer in
BO  buffer out
BI  buffer in
BO  buffer out
SHI samp/hold in
SHO samp/hold out
SHC samp/hold clock

COC comp cv
COI comp in
HNO henry noise out
YNO yusynth noise out
74O 7400 out
74C 7400 clock
74I 7400 in
G   GND
