microresearch/allcolours/TOAD/notes.org

** towards manual = booklet/fanzine

language of vision of ripley

*Which Venom kills, and saveth such as Venom chance to take*

When busie at my Book I was upon a certain Night,
This Vision here exprest appear’d unto my dimmed sight:
A Toad full Ruddy I saw, did drink the juice of Grapes so fast,
Till over-charged with the broth, his Bowels all to brast:
And after that, from poyson’d Bulk he cast his Venom fell,
For Grief and Pain whereof his Members all began to swell;
With drops of Poysoned sweat approaching thus his secret Den,
His Cave with blasts of fumous Air he all bewhited then:
And from the which in space a Golden Humour did ensue,
Whose falling drops from high did stain the soyl with ruddy hue.
And when his Corps the force of vital breath began to lack,
This dying Toad became forthwith like Coal for colour Black:
Thus drowned in his proper veins of poysoned flood;
For term of Eighty days and Four he rotting stood
By Tryal then this Venom to expel I did desire;
For which I did commit his Carkass to a gentle Fire:
Which done, a Wonder to the sight, but more to be rehearst;
The Toad with Colours rare through every side was pierc’d;
And White appear’d when all the sundry hews were past:
Which after being tincted Ruddy, for evermore did last.
Then of the Venom handled thus a Medicine I did make;
Which Venom kills, and saveth such as Venom chance to take:
Glory be to him the granter of such secret ways,
Dominion, and Honour both, with Worship, and with Praise.
Amen.

Which Venom kills, and saveth such as Venom chance to take

 Sweet are the uses of adversity;
         Which like the toad, ugly and venomous,
         Wears yet a precious jewel in his head.

see: https://www.alchemywebsite.com/toad.html

- collect resources
- what we need to show: normings, possible patches
- desc: hermaphrodite analogue computer driven by the times of pulses

Mindlin
Sprott

the operators in the centre of the scroll - the 7+1 roundels joined... notes on this!

*headings of sections like in: http://www.levity.com/alchemy/rpvision.html*

- show norms

- show patches: 

- bare patch sheets

- info: hot, general, norms, background

** basic description

hermaphrodite analogue computer driven by the times of pulses

** HW/desc notes

- +12v 100mA
- -12v 100mA

is now 24HP=121.6mm. depth

** 17/10/2023

need more metallic droney tracks,,, feedbackyyy, lower frequency

17/10 is 587++

- recordings review...

looking at earlier and now down from 586 (latest) to 410...

could look earlier

489-550odd are all very low volume but could be salvaged...

** 21/9/2023

- solved mismatch as XXX board is probably earlier with 1st and 2nd integrators in opposite formation to non-XXX

latest is M20 2nd left as int1_out, M12 as int2_out

R2 and R7 as 33k now ...

** 20/9/2023

- looking last time at voltages for 4051, 4024, change 330R we had back to 1k

+R2 and R7 on XX marked board now 33k which gives us +8/-8v (max for 4024/4051 is 18v)+

** 10/8/2023

- cell multipliers are designed for 5v as unity gain (as we don't divide on the multiplier) - should we change or not?
- top ones are not the case - but they need to stay at 10v for internals 

see below:

NON//- think about doubling top mults so x2 total... R115, 116, 117 -> 680K // ordered 0805 

can fix in UTIL/offset????

** 12/7/2023

manual/basic description* 

Q of peaky re-test????*

** 17/7/2023

- think about doubling top mults so x2 total... R115, 116, 117 -> 660K =- just have 511K // or halve non multed inputs=20k on r69, r79 

// trying but hard to see differences

// *key is if we want 10v or 5v to be peak 1x - as we have 10v from offset!*

** 3/7/2023

PCB TODO:

DONE- swop norms on M11 and M19: this in FINAL_FINAL

DONEnew file for:
- swop position of [M11][M12] and [M20][M19] and swop around so normy on outside
- maybe add pinheader for main outs/cell outs and un-normed cell ins: how many?
- also swop as above...

//checked/ check flow and I/O

** 29/6/2023

Qs - why IN4 and IN5 go so easily thru?

- tests with changing all mults to 47k (os x8 not x4) just raises pitch...

// other options: just with multiplier... leave as is!

leave weights for offsets...//weight 1,2 and 3 INs as x8, x4, x2 or x1 and test with/without multipliers

- thinking to swop norms for M11=nowCOMP1_IN (1Y) and M19=nowCOMP2_IN (last one) on edges

** 27-28/6/2023

- DONE/28/6/tested same: replicate hardware so we know that all works fine: add in norms on
  older board to match new ones - norm for comp2 and norm comps to
  intergrators...

- DONEtrial ad633 to see if match voltages: we have (as is /10 on result of multiplication - we just compensate 4x out amp for /2 on each input)

- say for 10v is 1x in multiplier (we could halve that and have x8: 47k and 330k (300k is there) ... *maybe trial this on all mults?*

- TEST: IN4 and IN5 - do they ever have a changing output signal? values there...

[... +as seems like 3rd integrator doesn't work so well/possibly in  comparator... as seems fine with changing signal rather than
  pulse... but seems ok with basic input - more about norming+ ]

** 23/6/2023

TOAD and CD: later wavs - 253, 254, 255, 256, 257, 258, 259**

** 22/6/2023

- checking HW, seems fine so far... add new norms to our diagram! // was added

CD/AC/TOAD: 240->249.wav

MANUALA?

** 9/6/2023

- checked DRC all new - should be fine for assembly/BOM after test last prototype...

** 7/6/2023

- changed very slightly M20 position... updated new panel for this shift...

** 19/5/2023

- revised PCB for new norms: new norm for comp2, also norm comp1 and comp2 to integratorVCAs

, removed 3 jacks and swopped m19 and m20 so comp/norm is on the outside

to check/send after playing with...

** 17/5/2023

CD and TOAD (and offset):
186.wav
187.wav
188.wav **
189.wav - +AC too
190.wav - +AC
191.wav - +AC
192.wav - +AC
193.wav - +AC
194.wav - +AC
195.wav - +AC
196.wav - +AC  ***
197.wav - +AC
198.wav - +AC
199.wav - +AC

[last ones till 195 signum in=int1out, signum out to clock on int2, also signum out to free collector in]

** 16/5/2023

- DONE: do we need to swop M20 and M19 so input is on outside? swopped...

- how we diagram for manual the normings?

*tests and changes to test on:*

- +voltage from divider and also 330R there for current/any bleed??? - dividers now 22k seems very samey,,, R3 and R13 still 330R+

*NOOO!!*

(we can change lower part of dividers for power supply to 22k to raise voltage there to 7.5v but... -> R2 and R7

- NON!amplify square (eg. 2.5 x 2.5=6.25 /10=0.625 *4 = 2.5) = 1x1 =1 = 8x???  700k on R75 // or try 470k

- amp signum (reduce R34 56k to????)??

- NON!amp on all multipliers so 5v is 1x = 8x then so 100k/700k // leave inner cell mults as is??? R115, R116, R117

all signals high so no amps...

*start on manual ideas*

** 15/5/2023

further tests from notebook and below:

- SIGNUM: 1.8vpp but works ok

- DONEschematic: added extra TOAD out jack, new norm for comp2 - means?, also norm comp1 and comp2 to integratorVCAs

DONE//TODO: how to map out basic bintic filter and sprott - diagrams,,,? 

** 8-9/5/2023

- DONE:TODOnorm of cmp2/clk2 to 2nd set ins?

- fixing PCB:

1st 2 cells working... check 3rd - no!

3rd cell now works: - fixed was badly placed R23, checked all parts, continuity, replaced 4051, very weak signal peaked at 10v from last section....

//NON! -bleed is more about norming...  or first 2 work otherwise and 3rd is fine??? // compare to breadboard each section...

- multiplier signal seems fine - just last part INT3...
- changed R3 and R13 to 330ohm for more power but still...

(we can change lower part of dividers for power supply to 22k to raise voltage there to 7.5v but... -> R2 and R7

what is overall current? what is measured voltage? 11.8v -11.9v

from pnp/npn power - 5v is a bit low...

91mA -V
90mA +V

///square seems low? ok - compare to breadboard//

- work through all signal path... // do we want the normings...?

TEST/TODO//change:

- DONEadd extra TOAD INT1 out
- change VDD from transistors... and see how this effects things
- try amping multiplier a bit...
- check full signal path
- re-test signum (we have norms there too)... INT3->SIGNUM

** DONE: 

//size of PCB: height of seg base pcb was 108mm

is now 24HP=121.6mm

+TRY width is 28HP=142.24mm+

DONE- check norms, check all schematic, see how looks as PCB/parts/size*

*DID WE//no!:norm multipliers to +V and need to adjust for 5v in/mult????means that we should double out (we have 1/2 in and x4 out so far)*

// DONE:norm in mindlin*, do clock normsX, other norms??? (multX and clock inX)

- DONEwe can norm both XY mult inputs to clock input! - means clock in on say Y in on both

- DONEprint TOAD/ripley to size... panel design and size

- NO:if we want extra multiplier and fix signum equation for variable B and C (probably not...)

- **but we can also start to think about expanders for TOAD (more*
  multipliers, if we can start to look further into neural spiking
  equations)...

- **also as expander we can have switched comparators and signum*

** 16/4/2023

- checked SVF setup patch - TOAD out from collector (as HP) works well in all configs 

- but for norming to make sense we would need to insert blank jacks to cut connections...

- that we can also have different weightings for multipliers... (x10, x100)... TRY THIS!

** 12/4/2023

RECHECKS!!
- DONE- still peaky//re-check sprott again// then with fixed signum

- mindlin in basic format... INV3 and INV4 (no in resistor) are now fixed 100n integrators...

- check peaks/floor/ceiling in all sections - bit by bit - without feedback?

trashed first VCA (replaced part chasing offsets from source), first switched cap is odd for sure)

multiplier instead of VCA for offset Q - how to test??? // and we need to double output for 5v

** 11/4/2023

- DONE:return to THAT style multipliers... and think on how could deal with 10x in INV/collector...

- DONEretest comparator circuit, 

DONE//TEST-10x on INV

- check ins and outs on schematic

** 6/4/2023

DONEpatch notes: clock in from pulse out of main audio CD and main CD into one of xy of toad

- TESTED 10k in to mults/1k out // and 1k out of integrator (NOT from VCA) - but should be fine...

- CHANGED now///tested straight clock in: bleeds in signal and does not give fine clock... added divider after diode and 47k GND - fixed...

4.2v is high level in...

- we can norm both XY mult inputs to clock input!

- do we want 4x mults in - so add one mult

** 4/4/2023

- tested offset thing - needs to adjust VCA/amp values 
- TODO: 
-test 10k in to mults, test with straight signal into counter//see below
-layout/prototype schematic

** 2/4/2023

103.wav all ins from CD!
104.wav with AC also

** 1/4/2023++

- already more or less tested with input impedance and out for each section. out=1k, in=10k/100k

// just test multiplier... with 10k in

decide on 10k ins...

- for INTcells we have 100k in already, but need out

- invertor could be 10k/100k - we have 10k already
- adapt multiplier... 10k in // which we did test
- signum is 10k // can be 100k - not so diferent

- TODO: test with signal into counter (no protection, no comparator - say use AC comp out) -> pin1 but we need to lose R20/1K and D3...
- DONE - test with offset/atten board/vca to build/test BUILT 

TESTED:
- now with sprott signum section as fixed and followed by multiplier - no INV after and works ok. but still very high
- trying now without amp after mults (as was in THAT) but still with divided input - similar and peaky...
- now with no dividers (as we first had) - somehow bit rougher so maybe keep as option
- then Mindlin - seems fine. to test further...

** 31/3/2023

- all switched cap sections seem to behave differently - adding 100nf on -rail to schematic - TO_TEST - seems much more stable!

2nd integrator has very high output though...

/// to change back mults to see what differences are...

[maybe after patch sprott - first with signum as we have it (but then no mult) _inv then... - need fixed signum!]

sprott so far - first integrator is very high

// note integrator cell is vca followed by integration

///TODO:

- DONEtry fixed signum with multiplier in // [check sign again but looks like inverted...]

- make offset/atten board and try mindlin with this on mult ins...
- check again mindlin with VCA before integrator in each cell
- check voltage for VCA to open, adjust to 5V and find simulations .txt

- trial with first multiplier option (not analogue thing)
- figure out all impedances (esp for offset and atten, and if that should be seperate)
- document well and design as normed modular system...
- base with jacks and no panel yet // with or without norming

** 30/3/2023+

- modular scheme???

// test new schemes

Mindlin: new layout fine, still clipping, to trial THAT multiplier works

behaves differently on last switched caps - so maybe first is not functioning well (square waves)...

but no indication why that is??? replacing one cap...47nF check... no wasn't it

- *TOAD_FINAL/TOAD2 is the one...* // maybe make copy of this! *FINAL_FINAL*

//start working on this for modular scheme

// new layout of sprott to test: fixed signum into mult. *but do we need to invert it? test and document this clearly*

- breadboard vca and offsets... // or solder... 
- comparators and delta sig - delta sig is on other board - to be tested!

** newer 22/7/2022+

// how to fix hard hitting: retrial Mindlin with just multipliers then trial extensions...DONE - still hits hard but can follow with smaller amp...

or go back to dual/double filter notion: shared/normed clock - shared ins/as/outs?

** 2/10

- pcb/proto for Mindlin... and also utilities as one we have

should it hit bounds (we follow circuit exactly)????

** 1/10

mindlin seems always hit peaks....

- fixed resistor works ok, but some variable?

no extension

all bit high frequency as is... how to lower + we need fixed resistors

** 28-30/10/2022

first attempts with Mindlin: first attempts still peak...

- DONEtoo many VCAs, to trial with fixed resistors, trial with 2 mults replaced by VCA, and extension from sprottXX

- design/test double filter proto - where to cross over.... proto 2x independent filters with all crossovers exposed on pins...

(or part build old big proto board to handle sprott as we have all there - just a bit messy on breadboard for mindlin...)

// sprott has 3x integrators

// 

sprott/filter:

- 1st inv feedback goes straght into inv / no 10k/100k

in chamberlain example we have 100k/200r divider for 3080

** 27/10/2022

- +check all elements for reason hard clip then:+ just bintic, extended bintic : both go to rails quite often, vca2 from 1st to 2nd inv is key somehow

fixed feedback from 2nd integrator into inv/adder

vca input should not go to zero in!

1st 2 vcas could be chained/same control

(in case now we double up first vca,,, fixed)

 just mindlin with mults

breadboard vca was 2x at max.../// fixed now

** 26/10/2022

- trial with 2k into each INTegrator... DONE - helps a bit with sound but still clips/hard

- question if peaking is hardware fault - trial each integrator... (3rd is not at fault, could be 1st) - tested first two as fixed to no avail...

*** 13/10/2022

- fixed hardware problem below. but still too aggressive and hitting bounds...

*** 11/10/2022

- output is still too high (20 Vpp from B3???), sometimes for all

is issue with last integrator???? U6 or U1 // fixed as was power on q1 transistor - replaced

*** 6/10/2022 ++

- TOAD_FINAL/TOAD2 is the one... 

- check schematic against breadboard 
  - we have scaling of multiplier vca on inverted op amp (see below) followed by +

shoud be x10 or x100 ???

  - is B2->B2RET pos or neg? - this effects direction of pot POSITIVE
  - we have VCA between 1st inv and 1st int which works well - do we need vca then on audio in (total 7 VCA?)
  - check the 3 outs!

//// circuit itself to fix on: multiplier, VCA from inv to first integrator, + or -  B2->B2RET

- check ERC/DONE

- check footprints - again which ones we use for production??? -> but in kicad 6 we need check all SOIC, 1206=3126 (metric), 

Xcheck NPNX MMBT3904

Xcheck PNP!!! MMBT3906

- start on PCB layout - height is? width we determine but for x knobs and x outs we could say X U

height of seg base pcb was 108mm

width was 101.3 = 20HP

// we have 11 jacks: 6 VCA, 3 outs, clock in, input

6 pots: 6 VCA sections - but see below for 7

*** 25/7

- we calculate sprott res r68 as 2.5M - what do we have? 2.2M

- testing fully extended with vca also 1st inv->1st int so 7x vca if we include input.. works well

// multiplier always seems a bit lacking... but *now realising that was from mindlin we got rid of other 2x mults which divide by 10 is all out of scale*

- but if we return those we lose VCAs or is over complex - then fixed paths back...

or we amplify output of 2nd mult with inv op-amp then non-inv vca WORKING - multiply by 10 to scale up

still q of switch feedback 1st inv

- test other options and switching of +- 1st int return... (clk norm to sprott out, out1 from 1st int to input)

*** 23/7

- start from scratch, tested all VCA and all switched capsDONE - on basic bintic damping does little, trial also with 10k to gnd, still nothing much, 
- test multipliers...DONE

TODO:
- DONEtrial straight Mindlin // working well - again B2->return invertor is inverted pot // extended from b3 2nd int with extra INT and sprott also works ok

Q of first invertor vca to int (some odd sounds but), extended vca b3 to 3rd int - could be// not so exciting...

= trial again with first invertor to vca without extension

- trial straight sprott
- try just potTODO on cgs/bintic

** oops

Sprott extended Mindlin now // mistake in proto so no more so...

3out, 1clkin, 1input

6xCvins 6xknobs 

norms: OUT3(sprott) for feedback in, OUT1 for clk

// 21/7/2022 error on prototype as we had last stage of multiplier going back to B3 and not on to BB3 (and B3 was straight to BB3)

// we need to re-check all.../// in bintic 1st integrator return is inverted//

** previous:

- switched sprott/mindlin
- one slower mindlin controls another...
- sort mult outs and level of outs is too hot
- direction of knobs - eg. vca1 from 1st int back to inv should be inverted as goes high to low

** 27/6/2022

- working on schematic, added 3x OUTS: B2->OUT1, B3->OUT2, new OUT3 from sigg/sprott

3out
1clkin
1input

6xCvins 6xknobs 

** 13/6/2022

- DONE-draw up schematic we have bit - *we still need to consider level - do when we prototype* of outs and different outs

3x OUTs: B2, B3, 

- drawn up/to re-check, check and check again...

// mark which way pots should go for VCA - *on damp/1st inv vca should be other way round*

test signum out//out we have is 1st int//2nd int - would be 3 outs - working but 1st can be with 10k to our regular schematic out..

** 7/6/2022

// as it is now switched version seems cover different frequencies and
also we have vca of mindlin isolated - only works for that one, we
would need to share signal to vca for entry into sprott 3rd

*retry addition: addition now from 2nd integrator looks good so far - with standard sprott with inversion!*

- reworked some loose conns on smd pcb

- forgot one fixed 10k feedback path (from 2nd int to inv) on switched sprott - to re-try.,..
seems more unstable/oscillating at high freq with switch in... but that could just be breadboarding

- need take account of both feedbacks... or just leave in mindlin one... 

// measured 7.5v comes out as 5v

** 6/6/2022

Mindlin:

Mindlin extended justnow: we go to invert from 2nd integ then into 3rd integ->sprott
*but before we had extension after 2nd mult! - better/kindof... still not convinced on extension

- think about double mindlin, controlled slews into mindlin VCA???

no vca between inv and 1st int... 

** 4/6/2022

- redo solo with corrections- so all 10k input into invertor - works much better with input (re-check again)

- try sprott extension - works well with out from 2nd int to pot to
  bb3/r1 (3rd int) then into signum and then into independent inv and back in 10k first
  inv

TRY: could also replace pot with inv vca and do without inv here... TEST with extra VCA borrowed from input - tested.fine

** 3/6/2022

- we will have to redo mindlin as we had all feedback on one 10k into first invertorDONEimproved...

- remake of sprott but still sign of 1st int is wrong (+ still) when we use invertor on breadboard, but not on pcb???

pcb one has 1k dd1 into inv // and on sprott we go straight in (try this) - so that was solution

TODO: solo mindlin with correctionsGOOD, switched sprott/mindlin, extended mindlinYES/switchedNON

** 2/6/2022

- testing with switch across both (top of ADG is inv of lower section so switches in 1st int feedback and Gsprott section)
works ok, bit switchy but problem/question is int1 (d1-dd1) now works only with NON-INV ??? 

- to re-test +sprott+ and mindlin alone, finally remake extended mindlin, test switch in or out extension

// +whichever decision input on mindlin is dominating-was mistake on ins+ and out is too heavy/strong

** 1/6/2022

- 2x parallel filters with control and cross routing/switches - or just possibility of this for 2 of them

- TODO: basic touch switch module with ADG412 instead of 4066 and changed logic/power (see touch_toggle_smd) - make up in KICAD

working with touch_toggle and use _Q (pin 2) for inversion - so for 2x spdt we have lower 412 as on/upper as inverted

[need to add comparator and test this]

** 31/5/2022

- added in 3rd/int->sprott from 1st int (v out) and back into feedback path and seems to work well - maybe doesn't need switch...

[into BB3, R1 to sig1 and sig2/outfromsig to 1st inv in (no inv), so we keep original mindlin feedback

still on mindlin input is a odd as cuts so much...

- test switch - ADG 412 BRZ  SO16 slim: switch working in itself, but need to test with finger thing and comparator setup

- re-test sprott with manual connection for r9/feedback

** 30/5/2022

- input into mindlin? could also be VCA - so total of 6 VCA??? also
  need to try with proper inv - (remove r9 fixed feedback or just use
  074 on breadboard - tried)

- what are possible outs from Mindlin? from 1st int, 2nd int - v and w... we tried and v (first int) is harder and louder

- *from Sprott?*

... and one is in [enclosed G function] - so does it matter if that is shared with one Mindlin out?

- check we can just enter into either Mindlin or Sprott and switch outs?

- number of VCAs for each - should be equal if we have/try vca from inv to first integrator

each has 5 VCAs so far (for mindline: 4+1 if we test new mindlin one - tested and works ok - +VCA as sprott)

but in sprott one VCA is in [G/signum] - control goes to both? split?

// -[inv]-[int 1]->[int 2]->[G/signumetc->feedback to inv]
                 ->feedback+/- to inv [mind is +, sprott is -         

// just to document: idea is now to have as above - two integrators and switch in difference of mindlin, sprott....

5 VCA in, 2 clock in, 2 or 3 outs, touch in // size//design is central toad from Ripley

** 12/5/2022

- extend with extra integrator/bintic and signum neg into signum but
  we don't have spare VCA so just use pot/inv (not inv4)// also hard to know where to extend from....

tried from out of 2nd integrator/not neg -> bb3 then r1 into signum and back into first integrator - (invertor)

mindlin test layout: 
R1 highest - C3 x
R2 lowest - C1
R3 mid - C2 x
r1 and r3 were mults

and C4 is first R

** 10/5/2022

- either dual/split or switching (then need to find good switch) or some hybrid of this
2 branches join...

*first Mindlin notes:*

- setup as book but 1st R between integrators works well at 100ohm (tried 1k.10k then is more like sprott ringing)

- can also be VCA (noninv)

- try: replace invertors with VCA inv (to test)DONE... +on one it only works with one of the invertors??? (inv4) which is the one we turned into integrator! [but with that extra integrator+

- simplifying... we can remove B(t) multiplier and just use VCA, same for E(t) or vice versa

- q scaling of these ins and also of VCA vs mult (see above - both do similar job)

+r2 doesn't do much,,,but...+

** 9/5/2022

- thinking about split/combine of mindlin/sprott - that can be just 2 sides rather than doubled up, and with norms across one to other
or switches of paths one to other...
- also norm of sprott out back to its own clock
- investigate other outs: B1x, B2x, B3x, R1 (we use)

- now patch mindlin: nada at first (also norm q for 2 inputs), multiplier always hot: *ad633 ar soic has different pins to what we have on pcb...*

+where are DIP for testings?+

- think of smaller utilities eg. onebit/sigmadelta

** 6/5/2022

analogue thing: 

- *for G(x)= -B(x) + Csgn(x) // which is just with inverter before the G(x) so is what we had below with last VCA inverted!*

but we have adjustable ratio within the signum...

from sprott (a new class): B=1.2, C=2.0

1/1.2 for signal = 8.333k vs 1k ref
Vs/C = 10/2 = 50k for signum

but on coeff6: signum = same more or less as signal: try with own circuit (and scope?): r68 (leave as 2M)

** 5/5/2022

- signum trials with analogue thing:

implemented with comparator and with no input we have chaos with exact
equation/layout but with very precise settings for signum relationship!

also very low freq but now add inbetween coeffs - still low and unstable 

coeff5 is signum amount
coeff6 is siganl in Cx-bsgnX

- trial last integrator is not switched - change last INV4 (r90) to 10n integrator and ditch r89:

again nothing when have last VCA non-inverted....// and double checked vca4 is all fine

- under what conditions it stops (as is just extra feedback?)

Q if is inversion before b3 which counts or??? as long as there is inversion (so can also be after signum)
try sans signum(still inversion issue)

*stability of signum with no gnd bias on comparator?* - how to re-test this 

- maybe ditch signum so is just bintic merge with mindlin // bintic vs. mindlin...

** 4/5/2022

- fixed up all VCAs with new values (not think on CV in now) 

- test BINTIC [d1->dd1 inv], rest +

bintic is fine, but still SIGNUM thing on positive vca (so minus back in) just bumps down/up to rails...

** 3/5/2022

- according to equations last/3rd/signum path should not be inverting ????

X''' = -G(x) + Ax'' + x'

- 100k also in last path is necessary (we have 22k in R72 already but up to 100K)

- worried about impedance in LM13700 inputs - how can we change this - LM13700 is fine but prob in current control

also 1k in bintics to check and 100k for gnd on damper to maybe add...

Iabc is control current max 2mA // recalculate

say for 1st R40 and R41 is 100K then r44 is 22k (we can also change top in pot/divider) - seems to work fine as is with changes noted

- temp remove r9 to test 1st invertor as is offset...// replaced

** 2/5/2022

- if we invert b3->bb3 (so input to 3rd integral - x which goes to
  signum) then seems stable and quite interesting 

** 29/4/2022

r68 try 1.5m according to calcs for 12v // try 2m as no 1.5 -- trying but still unstable

** 28/4/2022

- revisiting - had to resolder u1 1st amp does have connection to b3 through r9 which explains what we thought was bleed

////
- +basic bintic with 2x switched caps and 3x vca is strong on clock and not much input+ - was one cap unsoldered now fixed and behaves well...
- bit now with 3x bintic/integrators and signum is 10v no signal out from R1->out amplifier

signals from others... is bb3 bin/int working??? fixed r24 and worked a bit/not now//signum?

d1 to dd1 is inverted...

- how did we calc values for VCAs - halving signal at max?

** 22/12/2021

- if we think of a simple switching analogue comp - with several 4066
  switch points which can be switched by hand (a switch, touch/toggle)
  or by CV->comparator

what voltage can 4066 handle/what is its max power? as on touch toggle
we use +-9v to power - i think is 18v so we need to design around this

** 19/10/2021

TOAD test/configurations: bottom ad633 needs replacing,
sigma-delta-comparator is wrong way round for data return so only
works with invQ - but why doesn’t work with high freq AC signal - as
need to raise gnd from clk comparator as in bintic comp...  bintic to
test still, vca to test fully-works

- we change r68 for x-signum(x) as the signum is very high (-12 to +12v) so we have 1M for the moment and looks better

- we need to test bintic with VCA

sort of works in odd ways but ok with simple set up with 2x switched caps and damping in signum/or inversion

TODO from above/notes: swop sigma-delt comp +- for data return, fix clock comparator in there/test on breadboard maybe

** //////

In progress - from previous filter design but now merge of SIGNUM
chaos, WASP 4069 filter with extra integrator, and bintic switched
cap filter:

To note for new schematic:

- +12v and GND only throughout except first and last stage
- maybe add OTA/VCA on input too
- OTA control of b1/bb1 - b2/bb2 and b3/bb3 is all from same CV - one knob/cv

- OTA control of VCA in, damping?? and SIGNUM feedback is all CV - so 2 or 3 more knob/CV

- all 4069 are seperate to avoid heating - do we need to GND extra pins? no

- TEST: WASP feedback with diodes ->

- On breadboard is from where damping would be //2nd stage// - we just have 100k and
  pot at moment - test with wasp feedback - tested and works well but
  we can't put under voltage control

- Original damping option with 22k (or otherwise) to GND and OTA
  feedback (on sprott that was inverting then into inverting in so we
  test it non-inverting ??) TEST

- test LM13700 with extra op-amp (we tried this for first stage B1/BB1 and seems to work but then we need to go inv and inv - TEST for all

- prototype PCB with all stages pluggable, NLC-style SIGNUM also patchable and invert/non-inv input options for each OTA  

- note that in HAIBLE/DUAL WASP there is 1k in parallel with 10k LIN pot and 1k and diode at bottom of pot - this is to turn into log pot?

- in sprott what we have for last SIGNUM feedback stage is x-signum(x) which is same as in Sprott paper "A new class of chaotic circuit"

G(x)=Bx-Csgn(x) which plugs into x``` + Ax`` + x` = G(x)

x``` + Ax`` + x` = Bx-Csgn(x)

so: x``` + Ax`` + x` - [Bx-Csgn(x)] = 0

which is close to:

sprott manual is ax``` + bx`` + [cSGN(x) - dx] = 0

where is x` ??? 

* TODO

- front vca or not? TESTED and gets complicated...

so we have 3 mid stages controlled by one CV, damping-CV, SIGNUM CV = 3xCV so maybe

- 47k for ota stages

- test different feedback options for damping/first feedback loop:
  tested 51k to GND and straight 13700 through (+) and this works
  fine: maybe leave WASP feedback as an option on test pcb

- test all feedthrough 13700 with extra op amp and inv/inv setup - so 2 extra to do - seems to work out also but values will need to be tweaked

- test extra op-amp on signum but then we reverse the OTA! - tested but not sure - so leave as is...

- maybe leave out alt signum
