microresearch/allcolours/SR_segments/notes.org

* notes started 30/9/2020

** 18/1/2021

TODO: 

- Code basics for 4x shift registers for SEGMENTS - add artificial drift and dropped bits
- wrap up schematic notes and I/O

** schematic 

pulses/ADC for CV/amps. in and out.

- 6 bits ADC in (what is switched voltage in?) level pot and CV also for input
- X bits DAC out from STM as this gives us more configuration but we still need to amp and buffer

- 4 shift registers: noise (top), left and right, overlay (lower) with mode(knob only), speed, length (with cv both), 
- left and right have clock/pulse and pulse in, 2 outs/divided one
- noise and overlay have clock in, overlay/out has 2 pulse outs

total pulses: 6 in, 6 out

- ADC/noise in mode for noise, DAC/out mode for overlay

+or just 2 SR with each own ADC, DAC and overlay...???+

- how drop or walk-ins could work with each?

- DAC is now from the STM32F446 as in TOUCH - we copy micro.sch across

but we keep ADC as analogue 6 bits in 

** notes 30/12/2020+

- +note that now we have only 4x pulse outs which is one from each SR!+

** 1/4/2021

- now there are 6 pulse outs, 2 from each side, 2 from lower and fake norming ones which could be from uppers
- only one PWM clock to drive normed clock in for ADC/LFSER top
