microresearch/allcolours/touch_toggle_final/touch_toggle_latest_panel/donum_deus_progress001_new_cutpanel.png

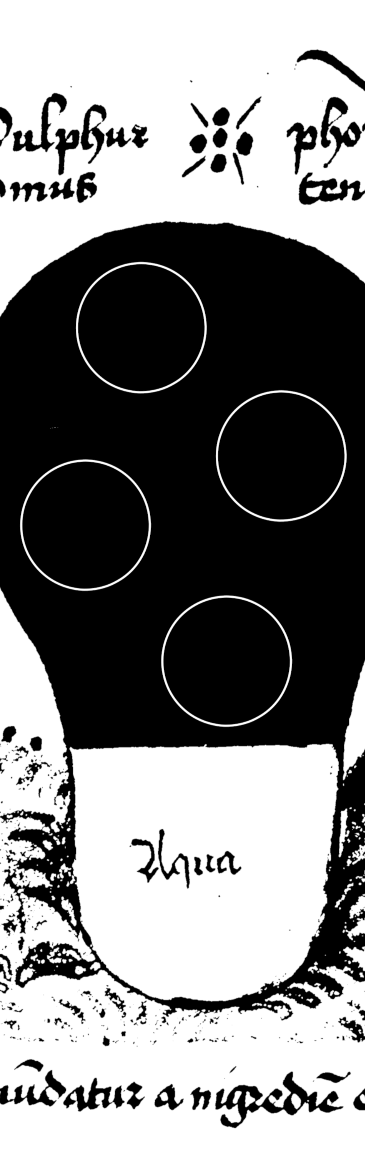
touch_toggle_final/touch_toggle_latest_panel/donum_deus_progress001_new_cutpanel.png
