microresearch/allcolours/SR_segments/heavensG_BOM_in_progress27092021.xls

Manufacturer | Manufacturer Part Number | Designator | Qty | Description | Case | SMD, BGA, LCC, OR TH | Top/Bottom | Points | Total Points | Comment
KEMET | C0805C104J5RAC | C2, C9, C10, C11, C15, C17, C18, C21, C23, C24, C25, C26, C27, C28, C29, C38, C42, C43 | 18 | 50V 0.1uF X7R 0805 5% | 0805 | SMD | Bottom | 2 | 36
KEMET | C0805C100J3HACTU | C1 | 1 | 25V 10pF X8R 0805 5% | 0805 | SMD | Bottom | 2 | 2
AVX | TAJA105M025SNJ | C40 | 1 | Tantalum Capacitors - Solid SMD 25V 1uF 20% 1206 Code A | 1206 A | SMD | Bottom | 2 | 2
AVX | TAJA475M025SNJ | C22 | 1 | Tantalum Capacitors - Solid SMD 25V 4.7uF 20% 1206 Code A | 1206 A | SMD | Bottom | 2 | 2
AVX | TAJA106K010YNJ | C8, C14, C16 | 3 | Tantalum Capacitors - Solid SMD 10V 10uF 10% 1206 Code A ESR= 3 Ohms AEC-Q200 | 1206 A | SMD | Bottom | 2 | 6
AVX | TCJA106M020R0150E | C12, C13, C39 | 3 | Tantalum Capacitors - Polymer SMD 20V 10uF 20% 1206 Code A ESR=150mOhm | 1206 A | SMD | Bottom | 2 | 6
KEMET | C0805C470J5HACTU | C7 | 1 | Multilayer Ceramic Capacitors MLCC - SMD/SMT 50V 47pF X8R 0805 5% | 0805 | SMD | Bottom | 2 | 2
KEMET | C0805C180J5HACTU | C19, C20 | 2 | Multilayer Ceramic Capacitors MLCC - SMD/SMT 50V 18pF X8R 0805 5% | 0805 | SMD | Bottom | 2 | 4
KEMET | C0805C102J5RAC | C30, C31, C32, C33, C34, C35, C36, C37 | 8 | Multilayer Ceramic Capacitors MLCC - SMD/SMT 50V 1000pF X7R 0805 5% | 0805 | SMD | Bottom | 2 | 16
Diodes Incorporated | 1N5819HW-7-F | D7, D8 | 2 | Schottky Diodes & Rectifiers Vr/40V Io/1A T/R SOD-123 | SOD-123 | SMD | Bottom | 2 | 6
Texas Instruments | LM4040C10IDBZR | D9 | 1 | Voltage References 10-V Prec Micropower Shunt 0.5% accuracy SOT23-3 | SOT-23-3 | SMD | Bottom | 3 | 3
KEMET | MMZ1608A252BTD25 | L1 | 1 | Ferrite Beads 2500ohms 200mA 25% DCR=800mOh 0603 | 0603 | SMD | Bottom | 2 | 2
ON Semiconductor | MMBT3904LT1G | Q7, Q8, Q9, Q10, Q11, Q12, Q13, Q14, Q15, Q16, Q17, Q18 | 12 | Bipolar Transistors - BJT NPN GENERAL PURPOSE NPN_BEC SOT23-3 | SOT-23-3 | SMD | Bottom | 3 | 36
Panasonic | ERJ-6GEYJ101V | R98 | 1 | Thick Film Resistors - SMD 0805 100ohms 5% AEC-Q200 125mW | 0805 | SMD | Bottom | 2 | 2
Panasonic | ERJ-6GEYJ104V | R1, R36, R39, R45, R51, R57, R62, R64, R66, R68, R74, R76, R78, R80, R92, R95 | 16 | Thick Film Resistors - SMD 0805 100Kohms 5% AEC-Q200 125mW | 0805 | SMD | Bottom | 2 | 32
Panasonic | ERJ-6GEYJ103V | R38, R42, R44, R49, R50, R55, R56, R61, R86, R89, R94, R97 | 12 | Thick Film Resistors - SMD 0805 10Kohms 5% AEC-Q200 125mW | 0805 | SMD | Bottom | 2 | 24
Panasonic | ERJ-6GEYJ134V | R35 | 1 | Thick Film Resistors - SMD 0805 130Kohms 5% AEC-Q200 125mW | 0805 | SMD | Bottom | 2 | 2
Panasonic | ERJ-T06J102V | R37, R41, R43, R47, R48, R53, R54, R58, R60, R87, R88, R90, R91 | 13 | Thick Film Resistors - SMD 0805 1Kohms 5% AEC-Q200 250mW | 0805 | SMD | Bottom | 2 | 26
Panasonic | ERJ-6GEYJ105V | R40, R46, R52, R59, R93, R96 | 6 | Thick Film Resistors - SMD 0805 1Mohms 5% AEC-Q200 250mW | 0805 | SMD | Bottom | 2 | 12
Panasonic | ERJ-6GEYJ204V | R2, R63, R65, R67, R69, R75, R77, R79, R81 | 9 | Thick Film Resistors - SMD 0805 200Kohms 5% AEC-Q200 125mW | 0805 | SMD | Bottom | 2 | 18
Panasonic | ERJ-6GEYJ333V | R3 | 1 | Thick Film Resistors - SMD 0805 33Kohms 5% AEC-Q200 125mW | 0805 | SMD | Bottom | 2 | 2
Panasonic | ERJ-6GEYJ683V | R34 | 1 | Thick Film Resistors - SMD 0805 68K ohms 5% AEC-Q200 125mW | 0805 | SMD | Bottom | 2 | 2
Panasonic | ERJ-6GEYJ203V | R33 | 1 | Thick Film Resistors - SMD 0805 20Kohms 5% AEC-Q200 125mW | 0805 | SMD | Bottom | 2 | 2
YAGEO | RC0805FR-0766K5L | R70, R71, R72, R73, R82, R83, R84, R85 | 8 | Thick Film Resistors - SMD 66.5Kohms 1% | 0805 | SMD | Bottom | 2 | 16
Texas Instruments | LM1117IDTX-3.3/NOPB | U7 | 1 | 3.3V LDO Voltage Regulators 800mA LDO Linear Reg TO-252 | TO-252 | SMD | Bottom | 3 | 3
Texas Instruments | LM1117IDTX-5.0/NOPB | U6 | 1 | 5V LDO Voltage Regulators 800mA LDO Linear Reg TO-252 | TO-252 | SMD | Bottom | 3 | 3
MICROCHIP | MCP6002T-I/SN | U1, U9, U10, U11, U12 | 5 | MCP6002 Operational Amplifiers - Op Amps Dual 1.8V 1MHz SOIC-8 | SOIC-8-N | SMD | Bottom | 8 | 40
STMicroelectronics | STM32F446RET6 | U8 | 1 | STM32F446 ARM Microcontrollers - MCU 32BIT Cortex M4 LQFP-64 | LQFP-64_10x10mm | SMD | Bottom | 64 | 64 | LQFP-64 (10x10mm)
STMicroelectronics | TL071CDT | U4 | 1 | TL071 Operational Amplifiers - Op Amps Single low noise JFET SOIC-8 | SOIC-8-N | SMD | Bottom | 8 | 8
ECS | ECS-80-18-5PX-TR | Y1 | 1 | Crystals CRYSTAL 8MHz HC49-SD SMD | HC49-SD | SMD | Bottom | 2 | 2 | HC49/US
