microresearch/allcolours/touch/touch_kicad_new2024/touch_final_000_22050223.xls

Manufacturer | Manufacturer Part Number | Designator | Qty | Description | Case | SMD, BGA, LCC, OR TH | Top/Bottom | Points | Total Points | Comment
KEMET | C0805C104J5RAC | C4, C6, C8, C31, C33, C34, C35, C36, C37, C38, C49, C50, C51, C52, C53, C54, C55, C56, C57, C58, C59, C60, C63, C64, C65, C66 | 26 | 50V 0.1uF X7R 0805 5% | 0805 | SMD | Bottom | 2 | 52
AVX | TAJA475M025SNJ | C21, C22, C23, C24, C32 | 5 | Tantalum Capacitors - Solid SMD 25V 4.7uF 20% 1206 Code A | 1206 A | SMD | Bottom | 2 | 10
AVX | TAJA106K010YNJ | C3, C5, C7 | 3 | Tantalum Capacitors - Solid SMD 10V 10uF 10% 1206 Code A ESR= 3 Ohms AEC-Q200 | 1206 A | SMD | Bottom | 2 | 6
AVX | TCJA106M020R0150E | C1, C2 | 2 | Tantalum Capacitors - Polymer SMD 20V 10uF 20% 1206 Code A ESR=150mOhm | 1206 A | SMD | Bottom | 2 | 4
KEMET | C0805C101J5HACTU | C25, C26, C27, C28 | 4 | Multilayer Ceramic Capacitors MLCC - SMD/SMT 50V 100pF X8R 0805 5% | 0805 | SMD | Bottom | 2 | 8
KEMET | C0805C180J5HACTU | C29, C30 | 2 | Multilayer Ceramic Capacitors MLCC - SMD/SMT 50V 18pF X8R 0805 5% | 0805 | SMD | Bottom | 2 | 4
KEMET | C0805C102J5RAC | C9, C10, C11, C12, C13, C14, C15, C16, C17, C18, C19, C20 | 12 | Multilayer Ceramic Capacitors MLCC - SMD/SMT 50V 1000pF X7R 0805 5% | 0805 | SMD | Bottom | 2 | 24
MULTICOMP PRO | BAT54S+ | D8, D6, D3, D4, D5, D11, D9, D7, D10 | 9 | Small Signal Schottky Diode, Dual Series, 30 V, 200 mA, 400 mV, 600 mA | SOT-23-3 | SMD | Bottom | 3 | 27
Diodes Incorporated | 1N5819HW-7-F | D1, D2 | 2 | Schottky Diodes & Rectifiers Vr/40V Io/1A T/R SOD-123 | SOD-123 | SMD | Bottom | 2 | 4
KEMET | MMZ1608A252BTD25 | L1 | 1 | Ferrite Beads 2500ohms 200mA 25% DCR=800mOh 0603 | 0603 | SMD | Bottom | 2 | 2
Panasonic | ERJ-T06J102V | R1, R2, R3, R4, R5, R6, R15, R16, R17, R18, R35, R36, R37, R38, R39, R40, R47, R48, R49, R50, R51, R61, R62, R63, R64, R65, R66 | 27 | Thick Film Resistors - SMD 0805 1Kohms 5% AEC-Q200 250mW | 0805 | SMD | Bottom | 2 | 54
Panasonic | ERJ-6GEYJ224V | R7, R8, R9, R10, R67, R68, R69, R70 | 8 | Thick Film Resistors – SMD 0805 220Kohms 5% AEC-Q200 125mW | 0805 | SMD | Bottom | 2 | 16
Panasonic | ERJ-6GEYJ333V | R11, R12, R13, R14 | 4 | Thick Film Resistors - SMD 0805 33Kohms 5% AEC-Q200 125mW | 0805 | SMD | Bottom | 2 | 8
Panasonic | ERJ-6GEYJ104V | R19, R20, R21, R22 | 4 | Thick Film Resistors - SMD 0805 100Kohms 5% AEC-Q200 125mW | 0805 | SMD | Bottom | 2 | 8
Panasonic | ERJ-6GEYJ103V | R27, R28, R71, R85, R86, R87, R88, R89, R90 | 9 | Thick Film Resistors - SMD 0805 10Kohms 5% AEC-Q200 125mW | 0805 | SMD | Bottom | 2 | 18
Panasonic | ERJ-6GEYJ101V | R46 | 1 | Thick Film Resistors - SMD 0805 100ohms 5% AEC-Q200 125mW | 0805 | SMD | Bottom | 2 | 2
Panasonic | ERJ-6GEYJ203V | R25, R52 | 2 | Thick Film Resistors - SMD 0805 20Kohms 5% AEC-Q200 125mW | 0805 | SMD | Bottom | 2 | 4
Panasonic | ERJ-6GEYJ273V | R23, R24, R26 | 3 | Thick Film Resistors - SMD 0805 27Kohms 5% AEC-Q200 125mW | 0805 | SMD | Bottom | 2 | 6
Panasonic | ERJ-6GEYJ335V | R29, R30, R31, R32, R33, R34, R41, R42, R43, R44, R45 | 11 | Thick Film Resistors - SMD 0805 3.3Mohms 5% AEC-Q200 250mW | 0805 | SMD | Bottom | 2 | 22
Panasonic | ERJ-6GEYJ621V | R53, R54, R55, R56, R57, R58, R59, R60 | 8 | Thick Film Resistors - SMD 0805 620ohms 5% AEC-Q200 125mW | 0805 | SMD | Bottom | 2 | 16
ON Semiconductor | MMBT3906LT1G | Q1, Q2, Q3, Q4 | 4 | Bipolar Transistors - BJT PNP GENERAL PURPOSE PNP_BEC SOT23-3 | SOT-23-3 | SMD | Bottom | 3 | 12
Texas Instruments | CD40106BM | U13, U14 | 2 | Inverters Hex Schmitt Trigger Six Trigger Circuit | SOIC-14-NSMD |  | Bottom | 14 | 28
Texas Instruments | CD4051BM96 | U6 | 1 | Multiplexer Switch ICs CMOS Sgl 8-Ch Ana Multipl/Dmultiplexer | SOIC-16-N | SMD | Bottom | 16 | 16
Texas Instruments | LM13700M/NOPB | U7, U8 | 2 | Transconductance Amplifier, 2 Amplifier, 36 V, 2 MHz, -5 V, 5 V, SOIC | SOIC-16-N | SMD | Bottom | 16 | 32
Texas Instruments | TL074CDR | U3, U4, U5, U9, U10 | 5 | Operational Amplifier, 4 Amplifier, 3 MHz, 13 V/µs, 7V to 36V, SOIC, 14 Pins | SOIC-14-N | SMD | Bottom | 14 | 70
Texas Instruments | LM1117IDTX-3.3/NOPB | U2 | 1 | 3.3V LDO Voltage Regulators 800mA LDO Linear Reg TO-252 | TO-252 | SMD | Bottom | 3 | 3
Texas Instruments | LM1117IDTX-5.0/NOPB | U1 | 1 | 5V LDO Voltage Regulators 800mA LDO Linear Reg TO-252 | TO-252 | SMD | Bottom | 3 | 3
STMicroelectronics | STM32F413RGT6 | U11 | 1 | STM32F413 ARM Microcontrollers - MCU 32BIT Cortex M4 LQFP-64 | LQFP-64_10x10mm | SMD | Bottom | 64 | 64 | LQFP-64 (10x10mm)
ECS | ECS-80-18-5PX-TR | Y1 | 1 | Crystals CRYSTAL 8MHz HC49-SD SMD | HC49-SD | SMD | Bottom | 2 | 2 | HC49/US
