microresearch/allcolours/comparator_v2/comparator_guidelines.dxf

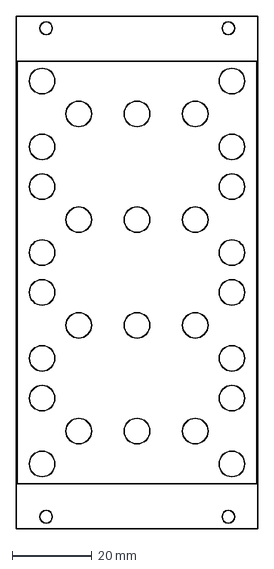
[picture p3: CAD file, 2023-06-08]
comparator_v2/comparator_guidelines.dxf
60.6 x 128.5 mm
