microresearch/allcolours/populus/touch_toggle_KICAD/touch_toggle_latest_ADG.step

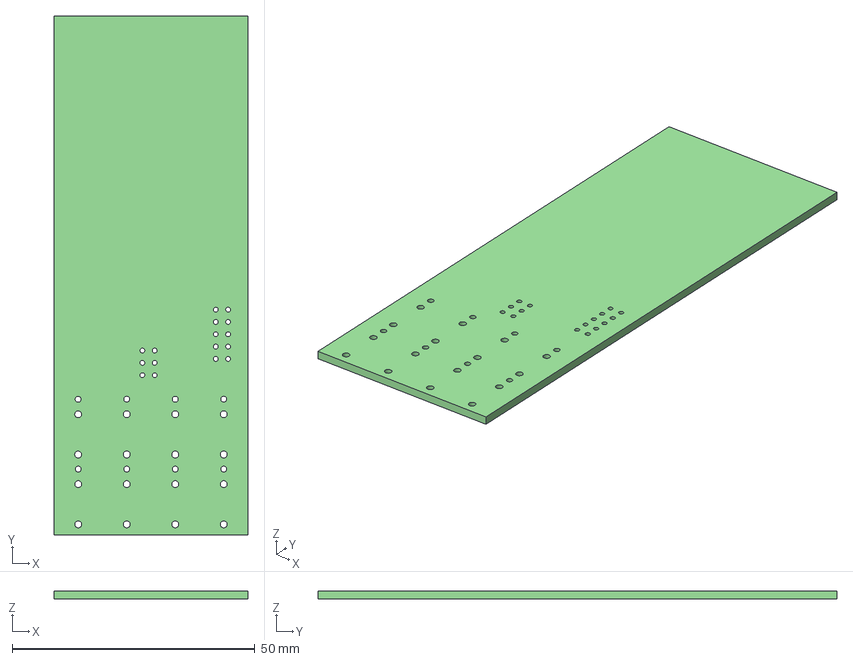
[picture p4: CAD file, 2023-06-08]
populus/touch_toggle_KICAD/touch_toggle_latest_ADG.step
40.0 x 107.0 x 1.60 mm
