microresearch/allcolours/comparator_v2/comparator_guidelines_v2.dxf

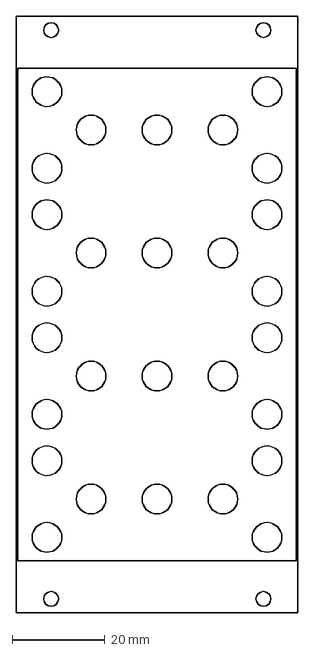
[picture p5: CAD file, 2023-06-08]
comparator_v2/comparator_guidelines_v2.dxf
60.6 x 128.5 mm
