microresearch/allcolours/SR_segments/dossier_segments.pdf

# SEGMENTS

## anonymous

## March 8, 2021

# 1 SEGMENTS

## 1. PROGRESS/NOTES

## - Second set PCBs ordered - 0403

2

## 2. SCHEMATICS

3

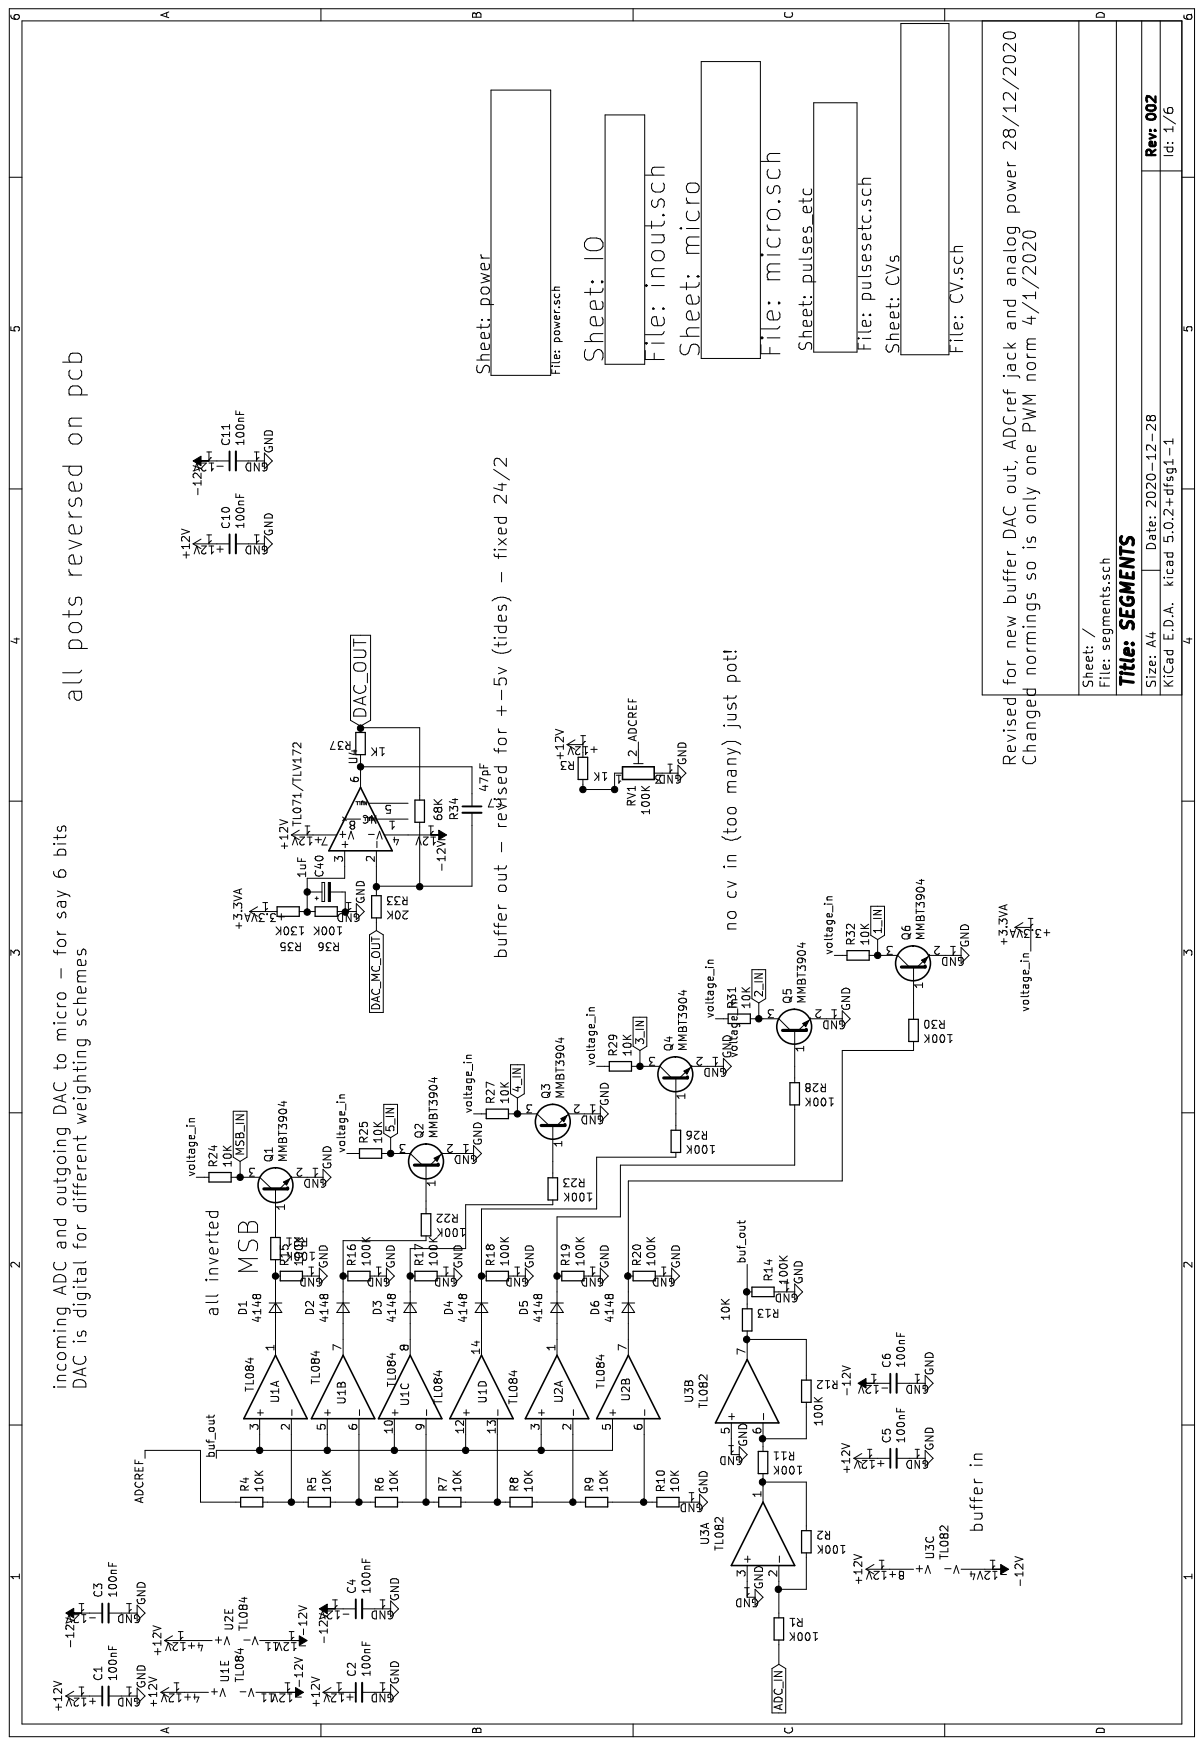
[picture p6: page 3]

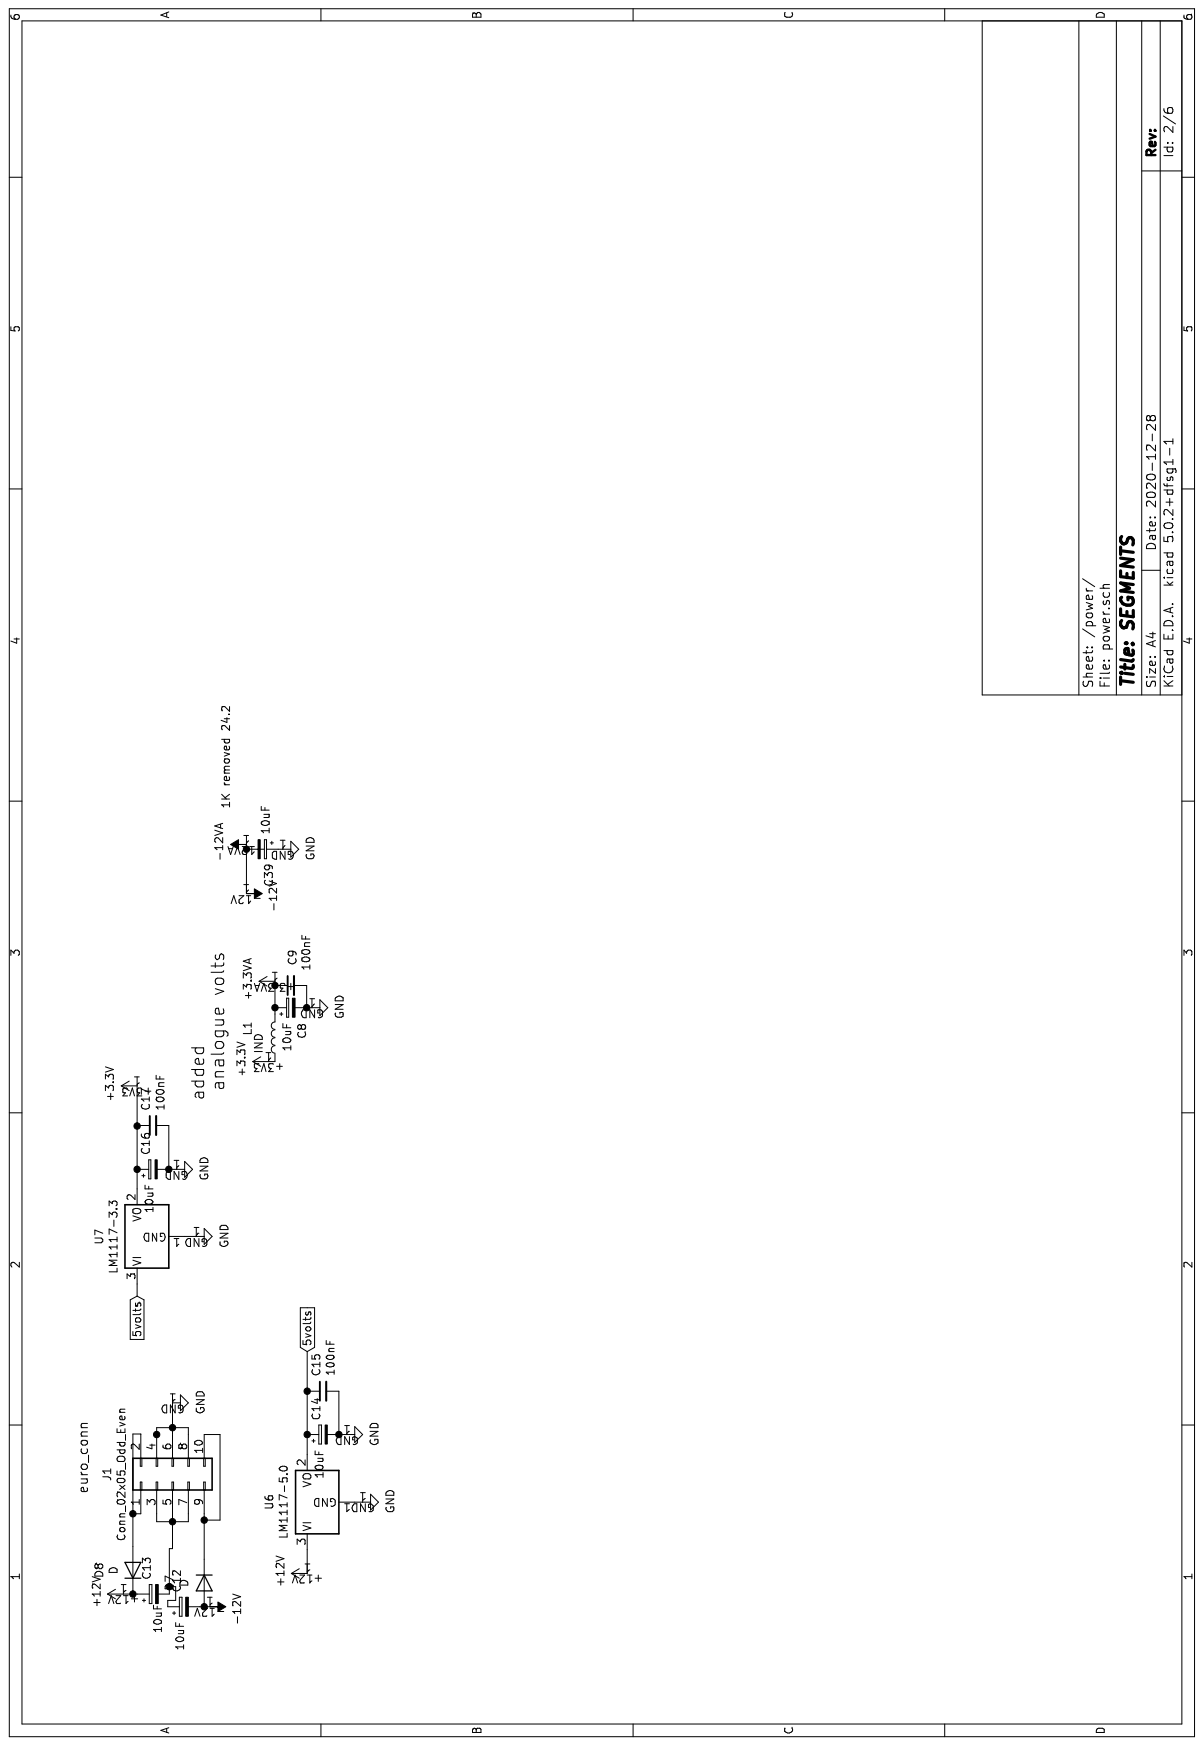
[picture p7: page 4]

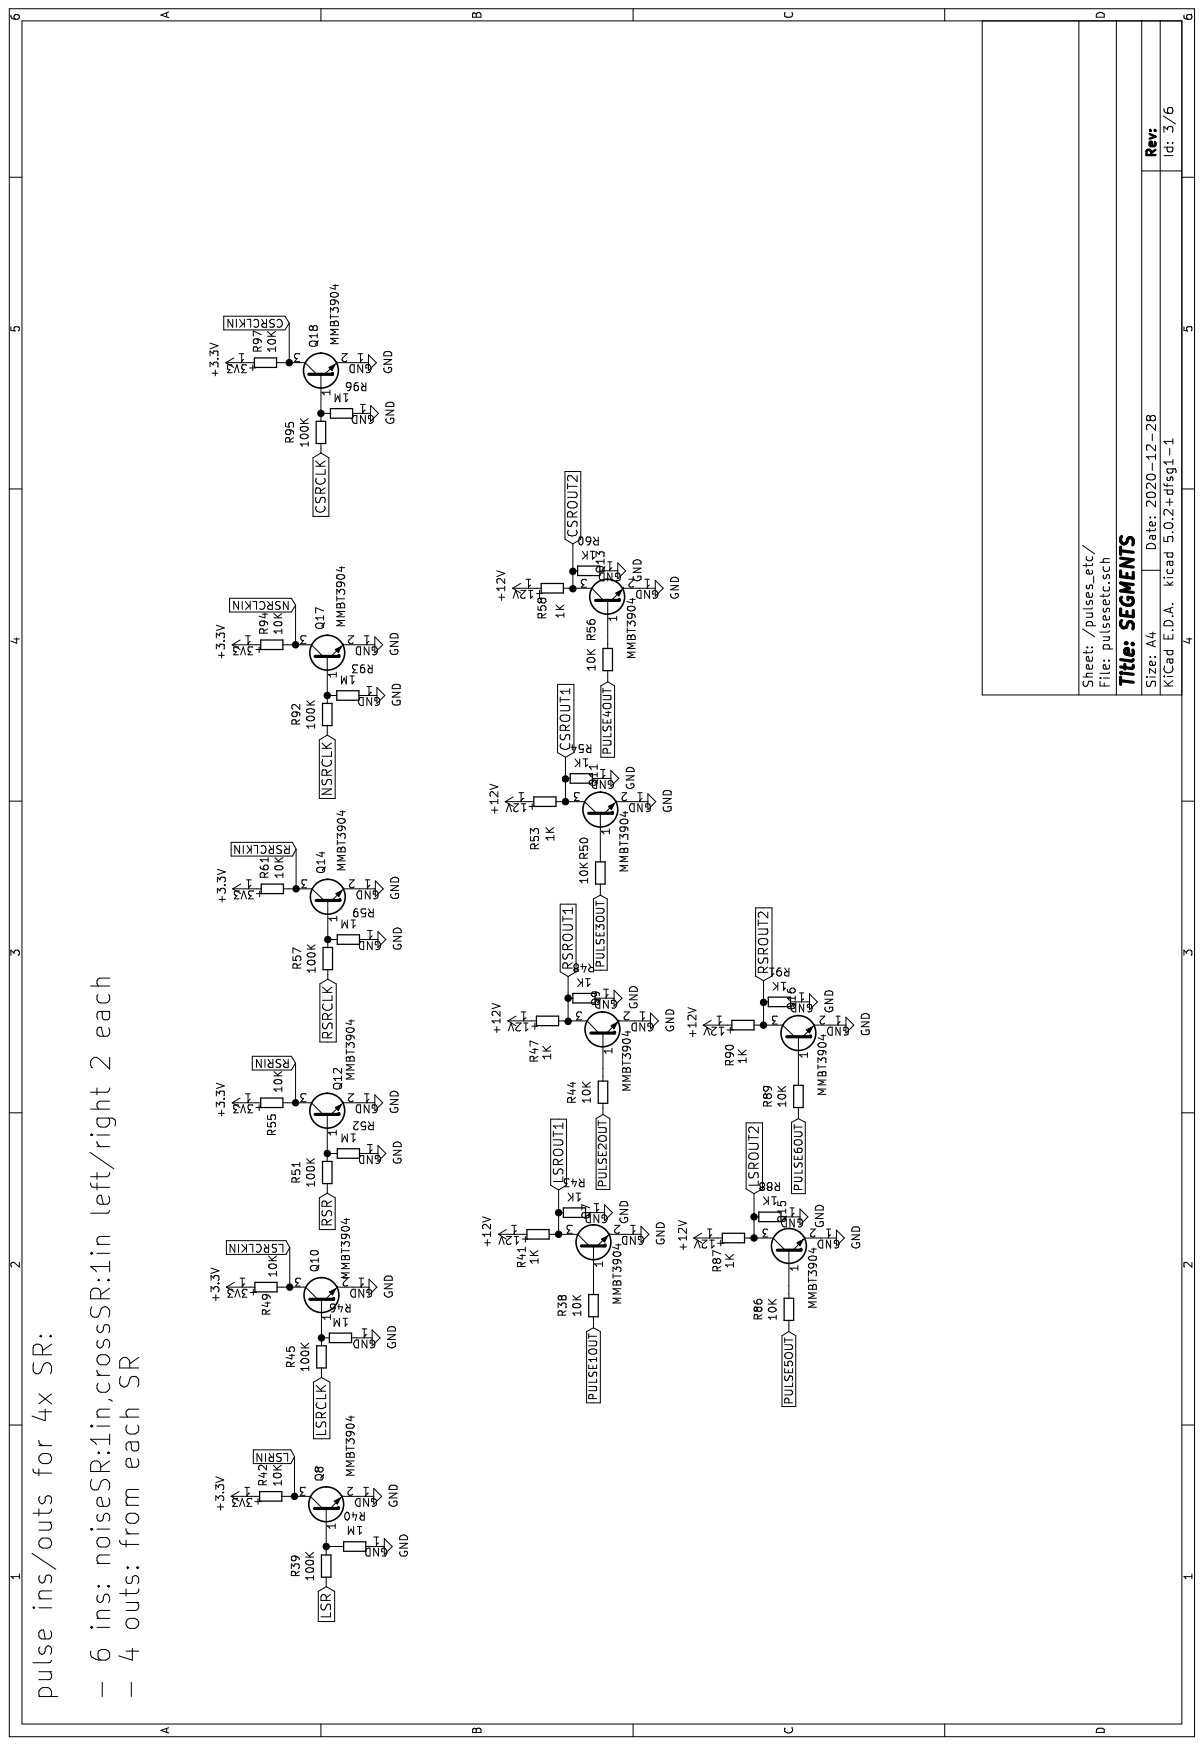
[picture p8: page 5]

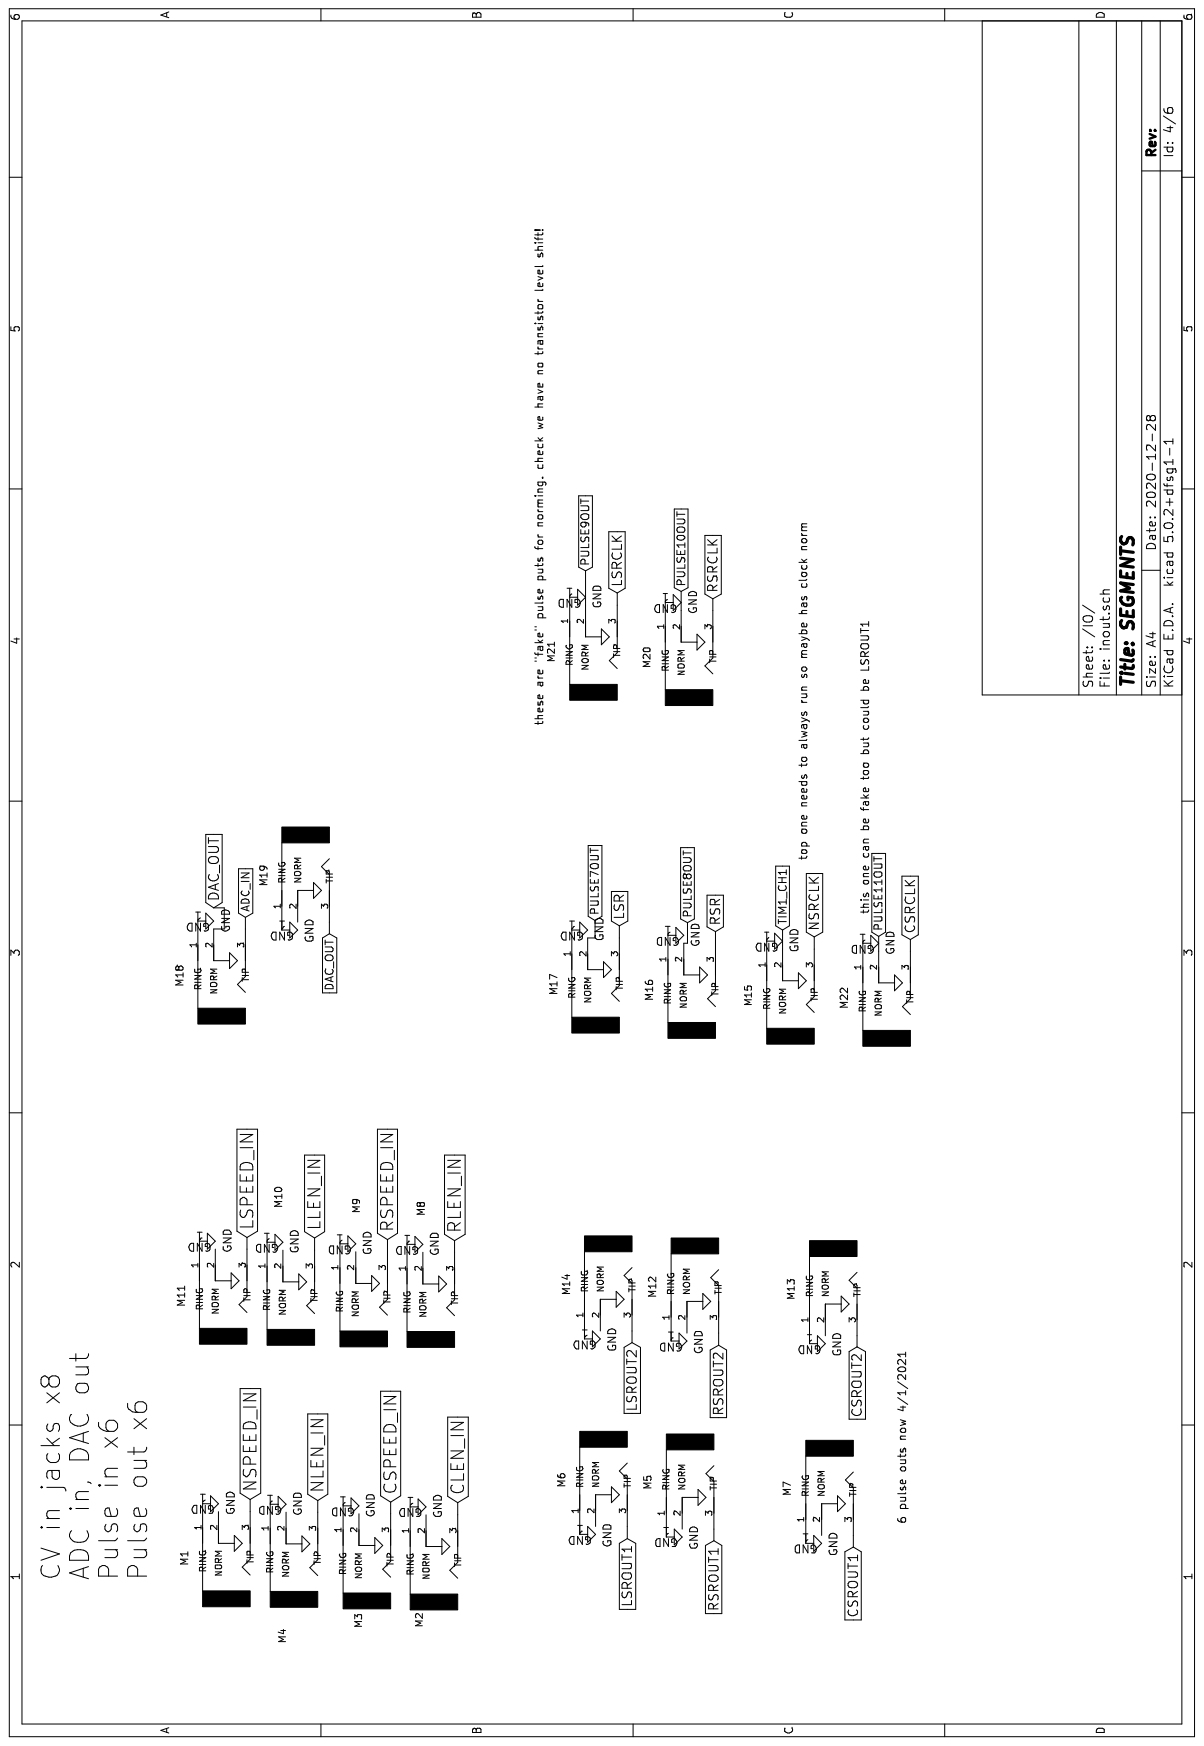
[picture p9: page 6]

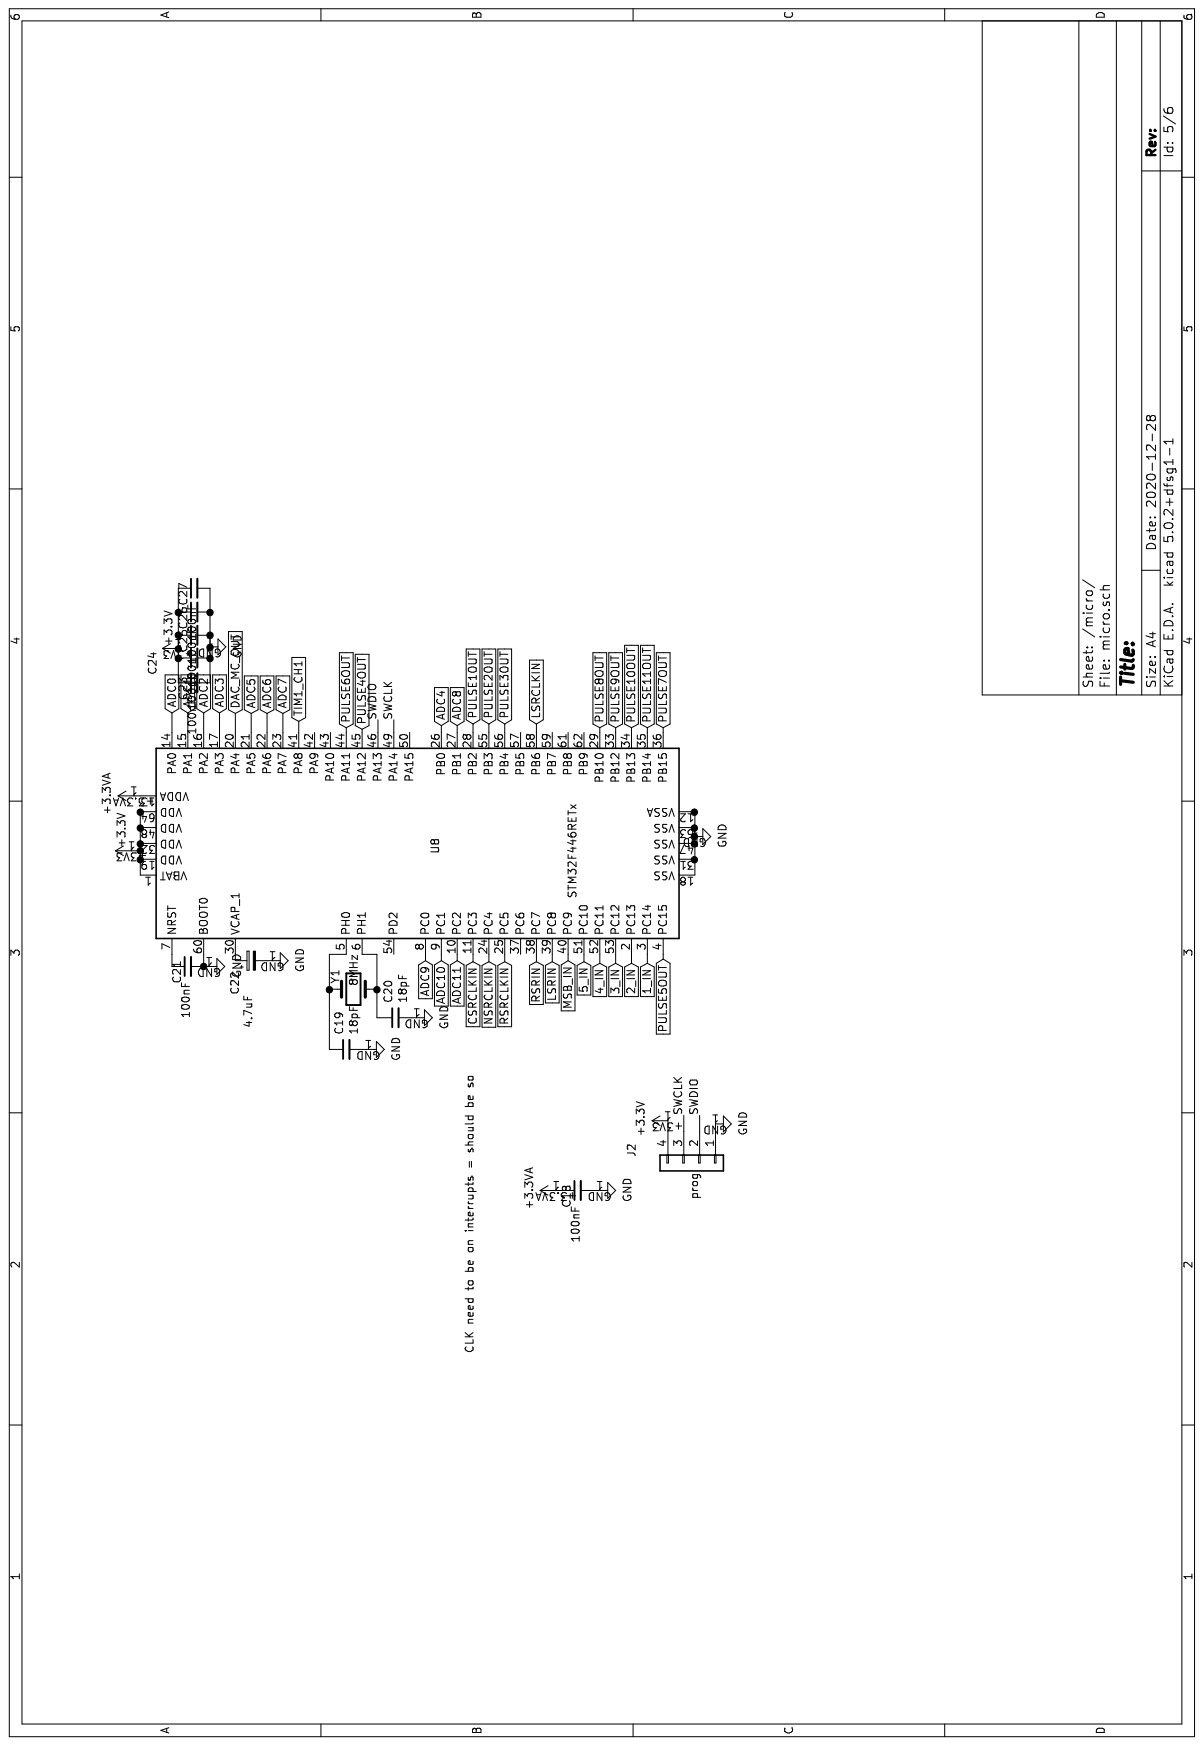
[picture p10: page 7]

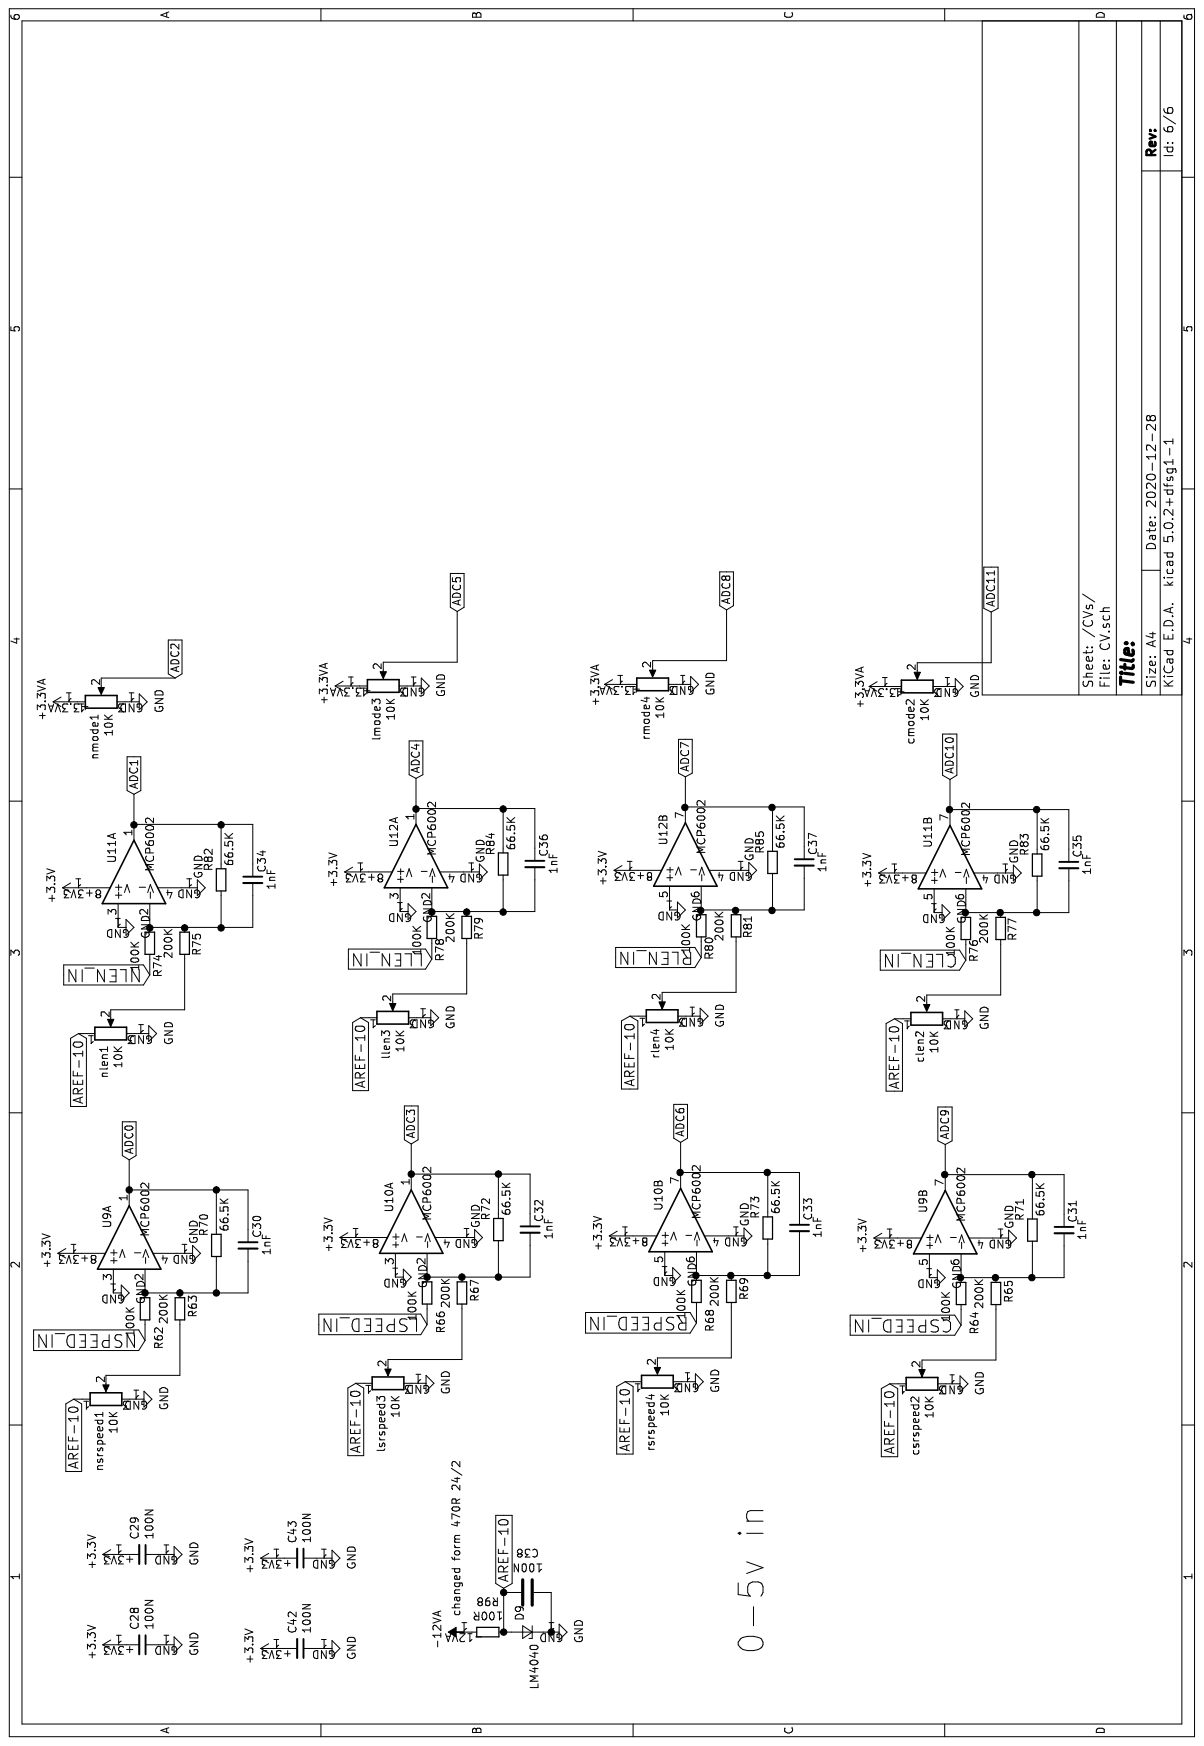
[picture p11: page 8]

## 3. PANEL layout

10

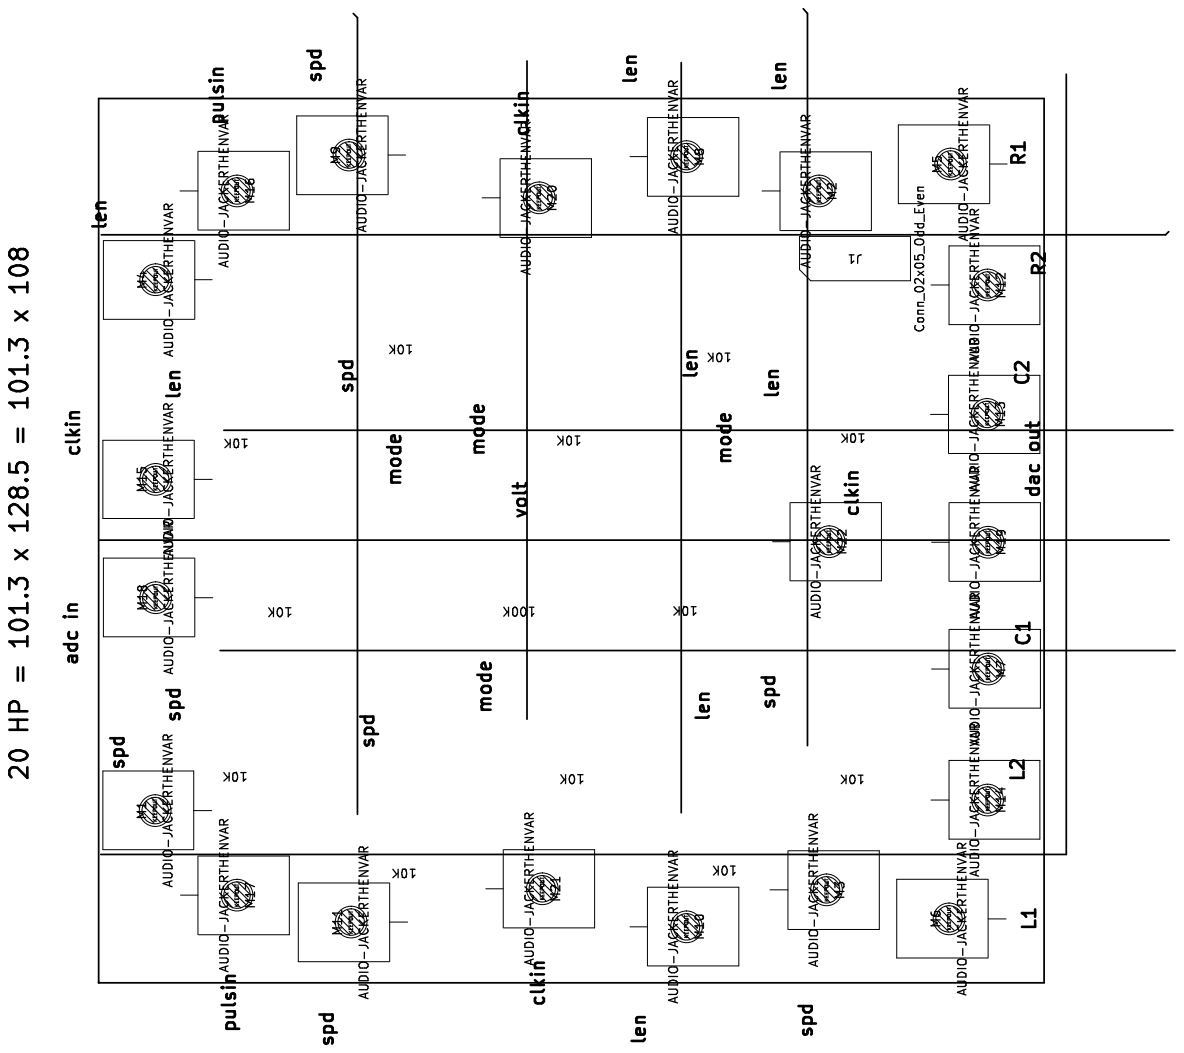
[picture p12: page 10]

## 4. PCB

12

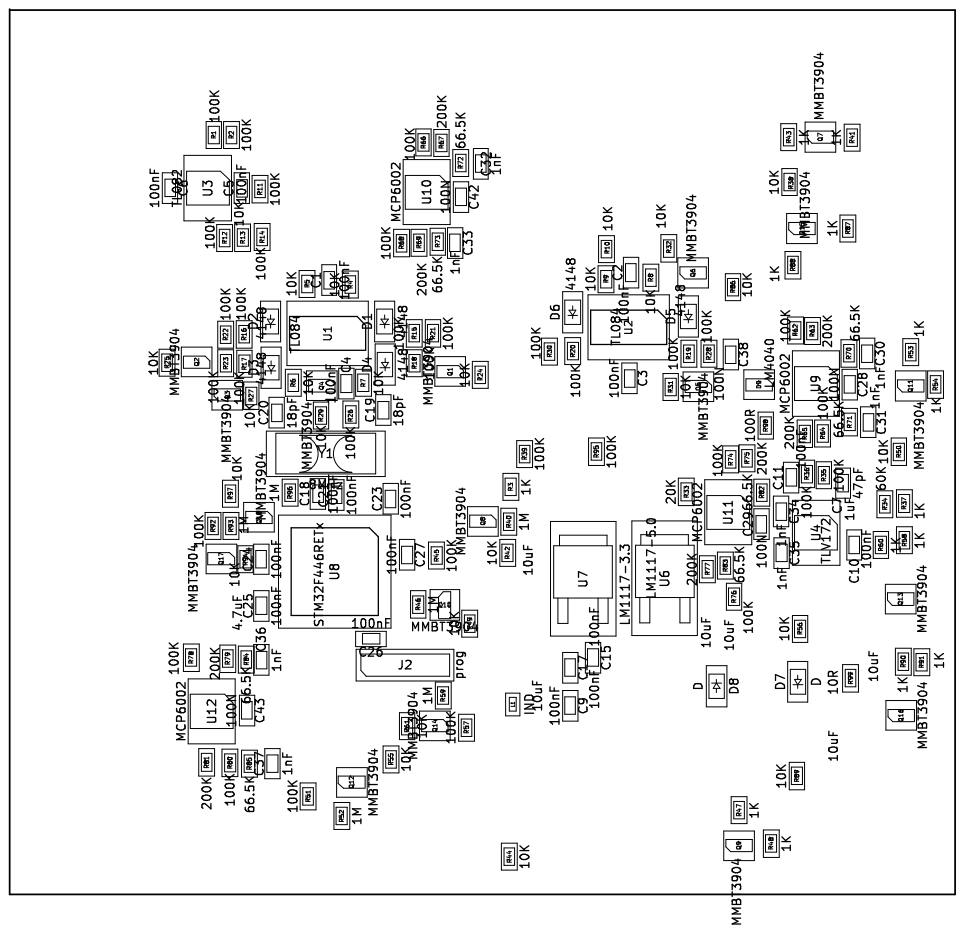
[picture p13: page 12]

## 5. BOM and orderings

14

# SEGMENTS BOM REV 002

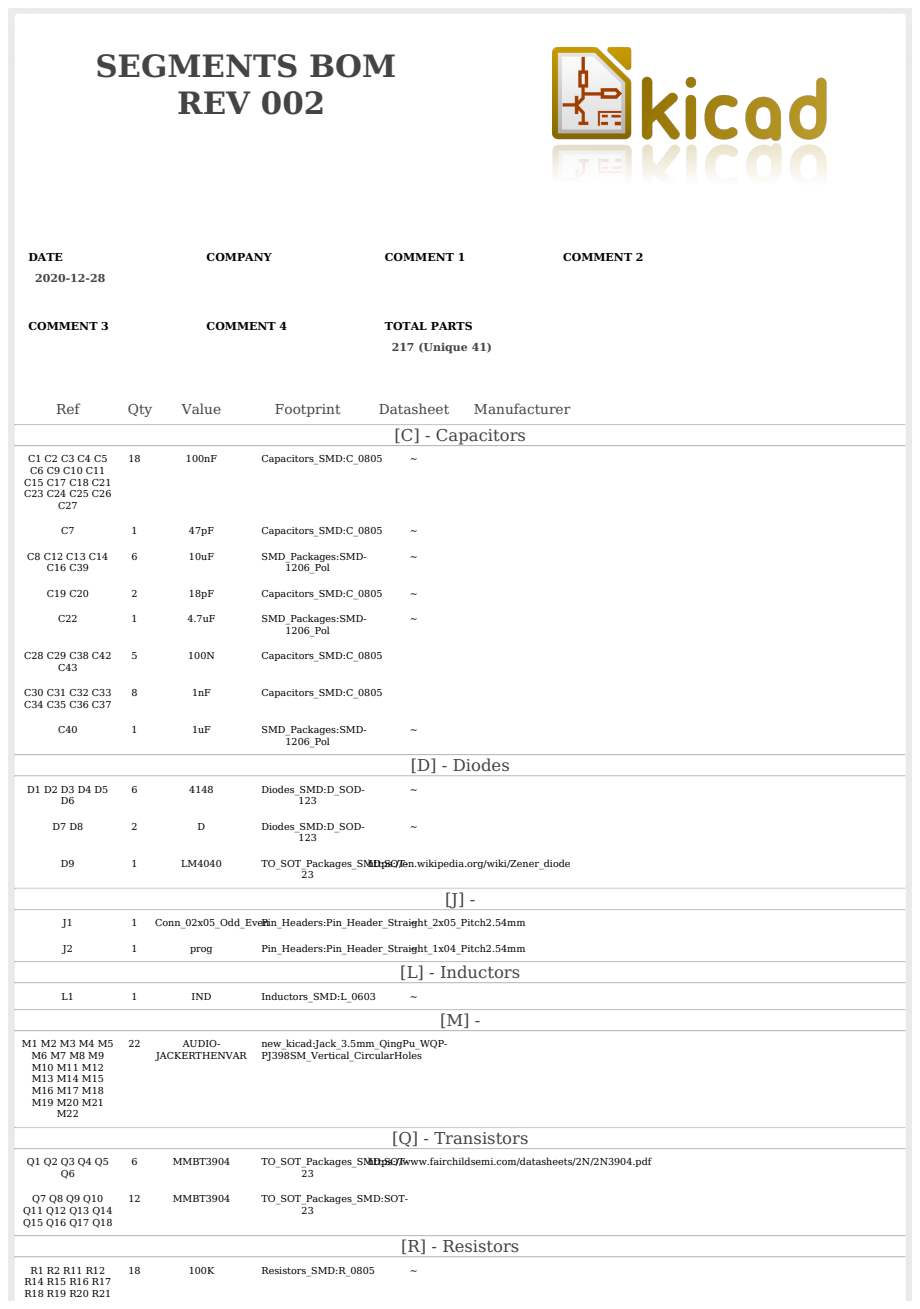
[picture p14: page 14]

https://en.wikipedia.org/wiki/Zener_diode

https://www.fairchildsemi.com/datasheets/2N/2N3904.pdf

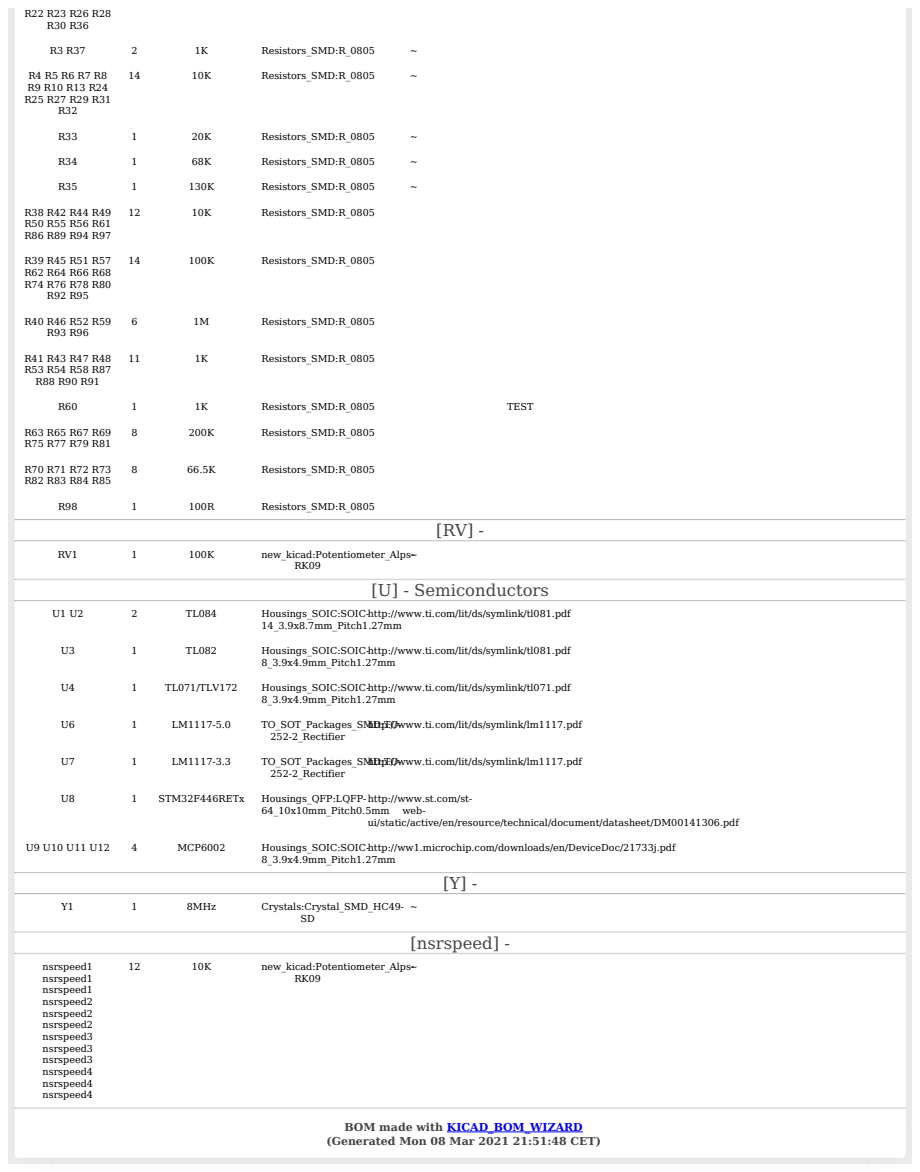
[picture p15: page 15]

http://www.ti.com/lit/ds/symlink/tl081.pdf

http://www.ti.com/lit/ds/symlink/tl071.pdf

http://www.ti.com/lit/ds/symlink/lm1117.pdf

http://www.st.com/st- web-

ui/static/active/en/resource/technical/document/datasheet/DM00141306.pdf

http://ww1.microchip.com/downloads/en/DeviceDoc/21733j.pdf

BOM made with KICAD_BOM_WIZARD
(Generated Mon 08 Mar 2021 21:51:48 CET)
