microresearch/allcolours/SR_segments/segments/layout.pdf

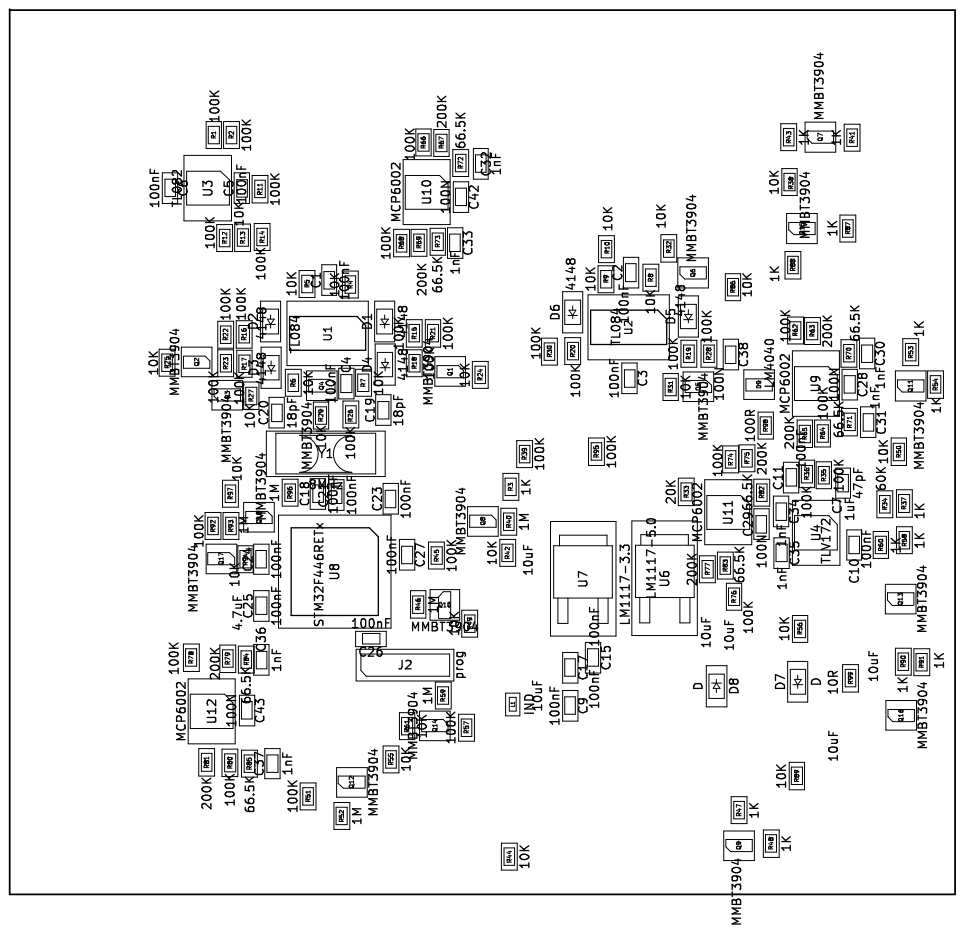
[picture p16: page 1]
