microresearch/allcolours/SR_segments/segments/panel.pdf

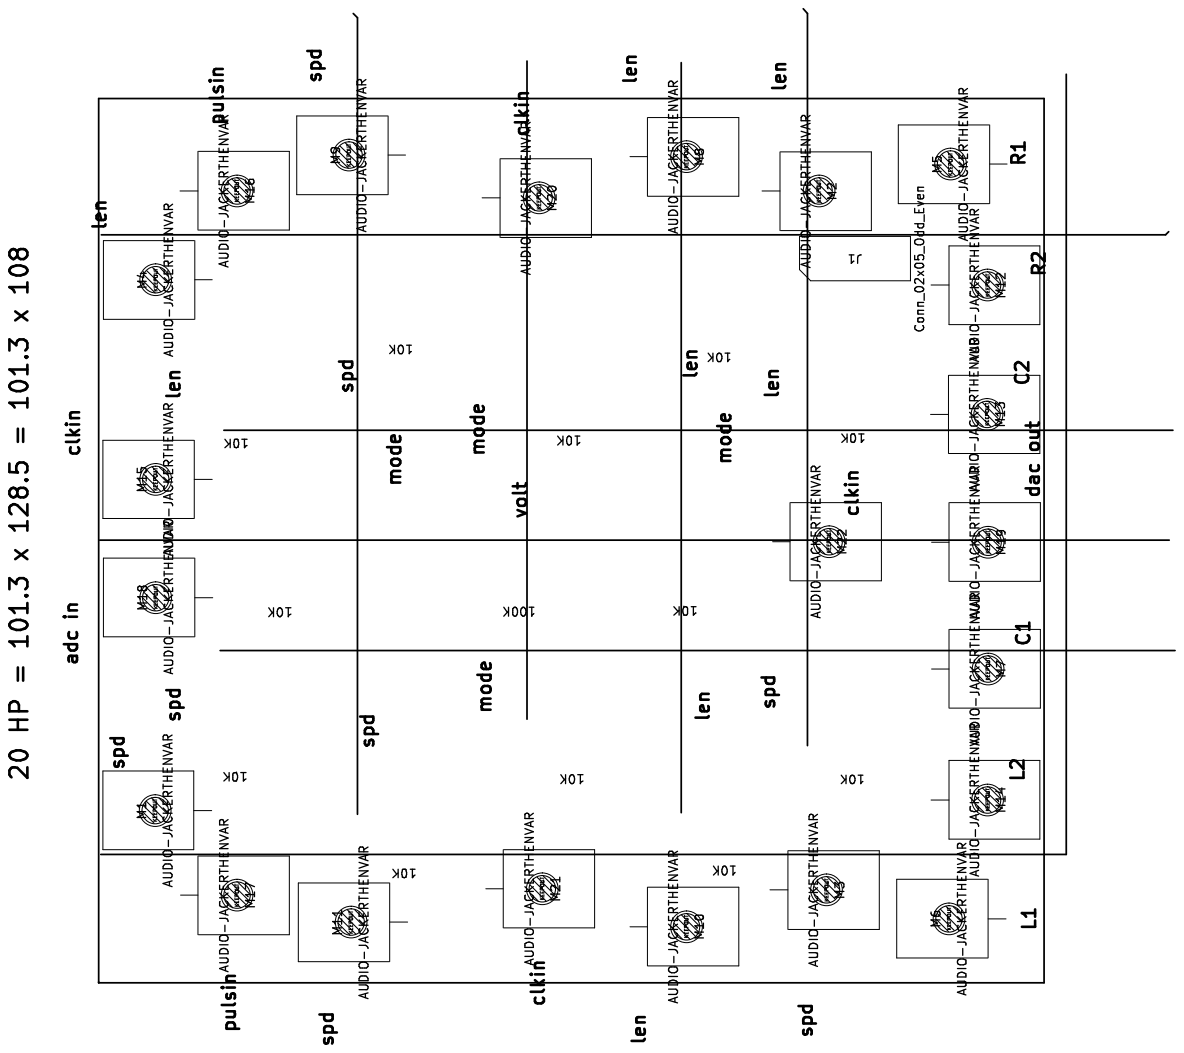
[picture p17: page 1]
