microresearch/allcolours/touch/touch_kicad_new2024/touch_panel_filter/NEWmoontestpanelfilled.-F_Cu.pdf

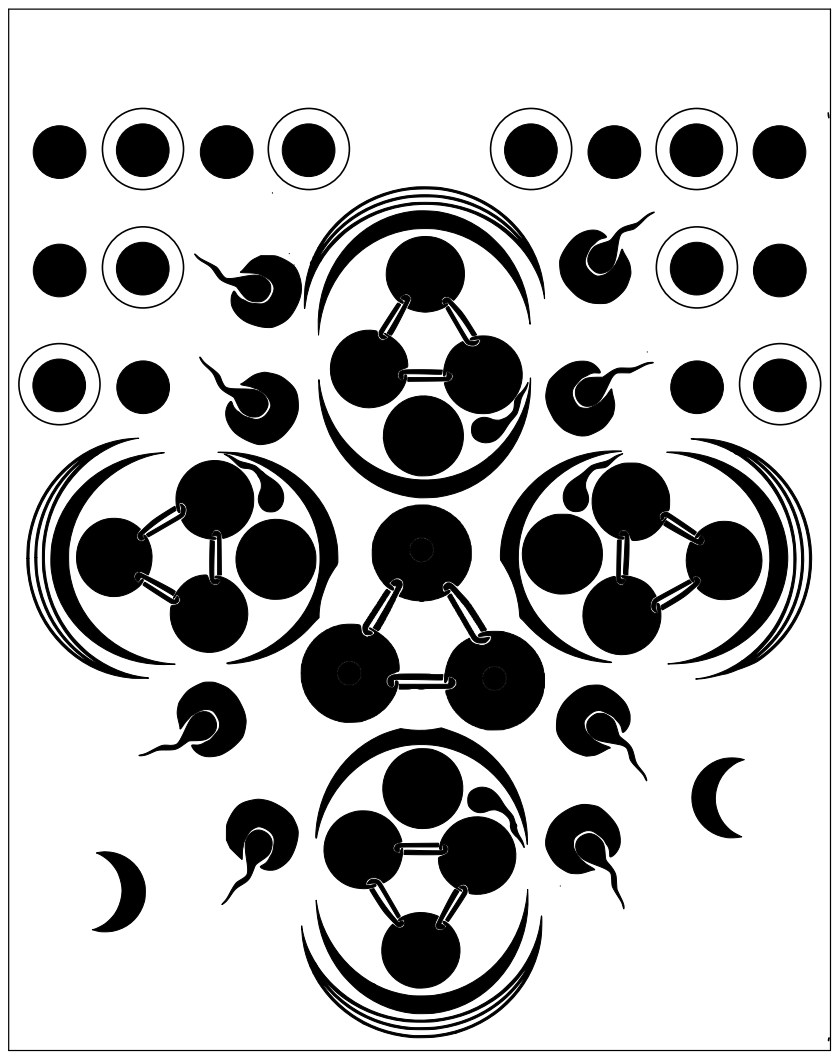
[picture p18: page 1]
