microresearch/allcolours/touch/touch_kicad_new2024/touch_panel_filter/NEWmoontestpanelfilled.-F_Fab.pdf

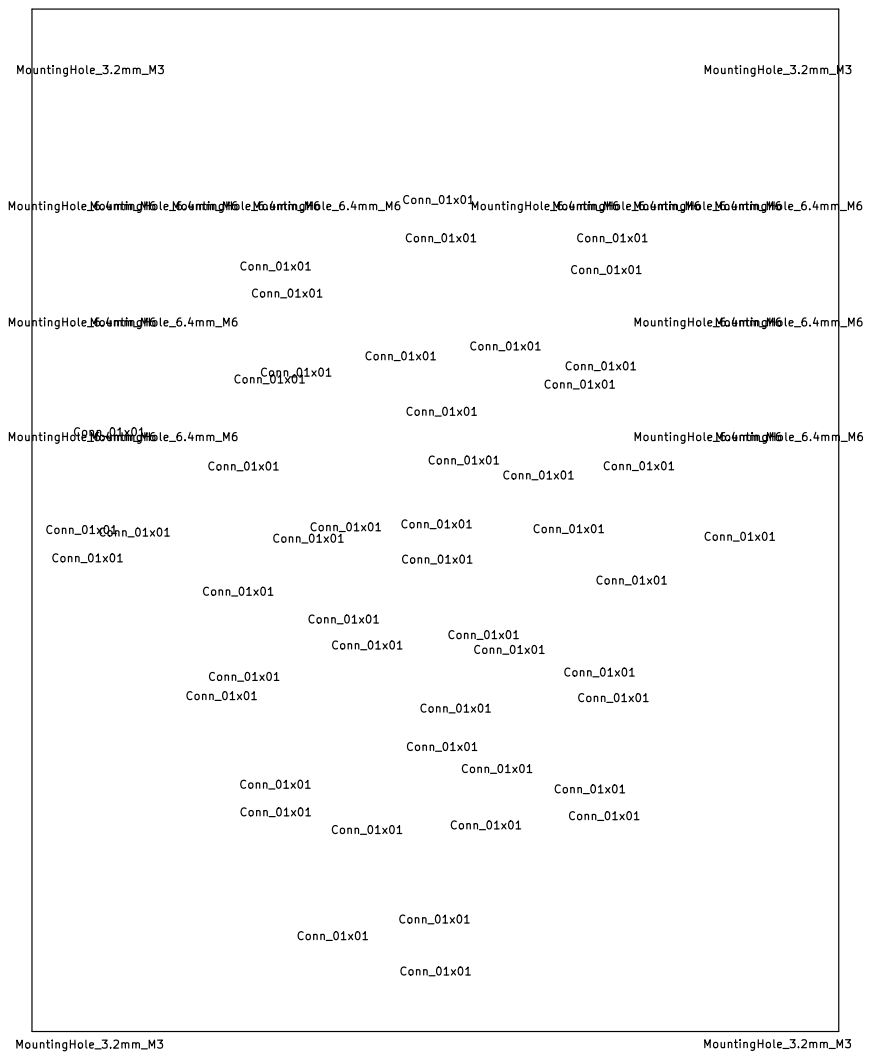
[picture p19: page 1]
