microresearch/allcolours/populus/POPULUS_kicad_old-panelnew/populus_panel/populus_panel.kicad_pcb

## KiCad design populus/POPULUS_kicad_old-panelnew/populus_panel/populus_panel.kicad_pcb (2024-10-09, an earlier design)

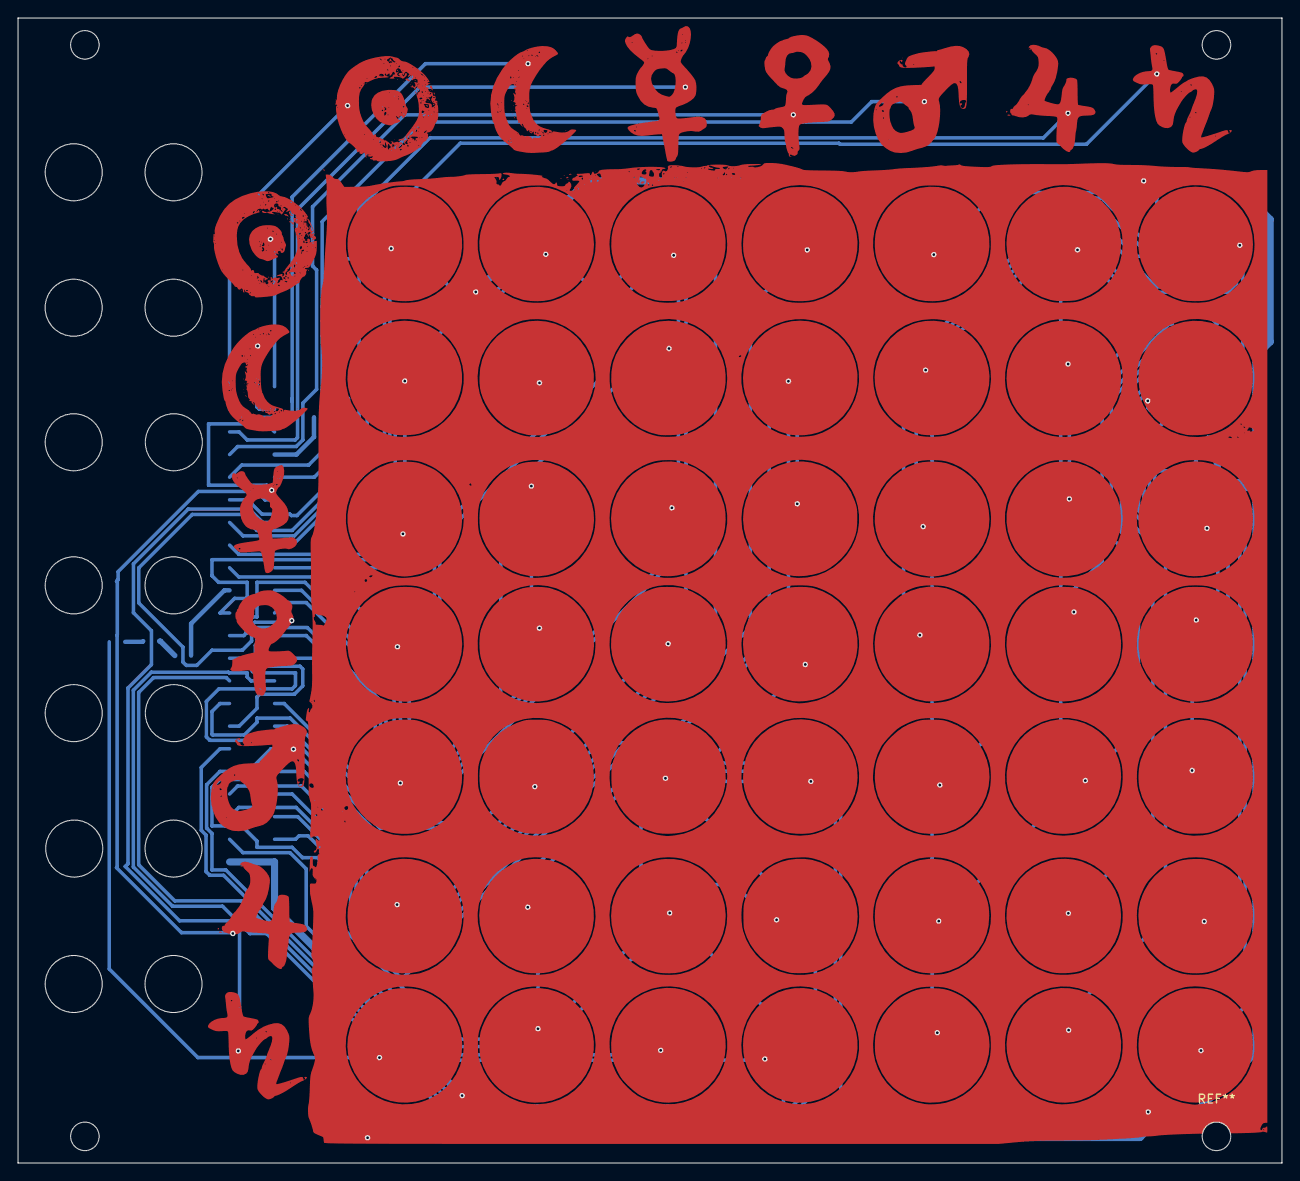
[picture p20: board populus_panel.kicad_pcb from above]

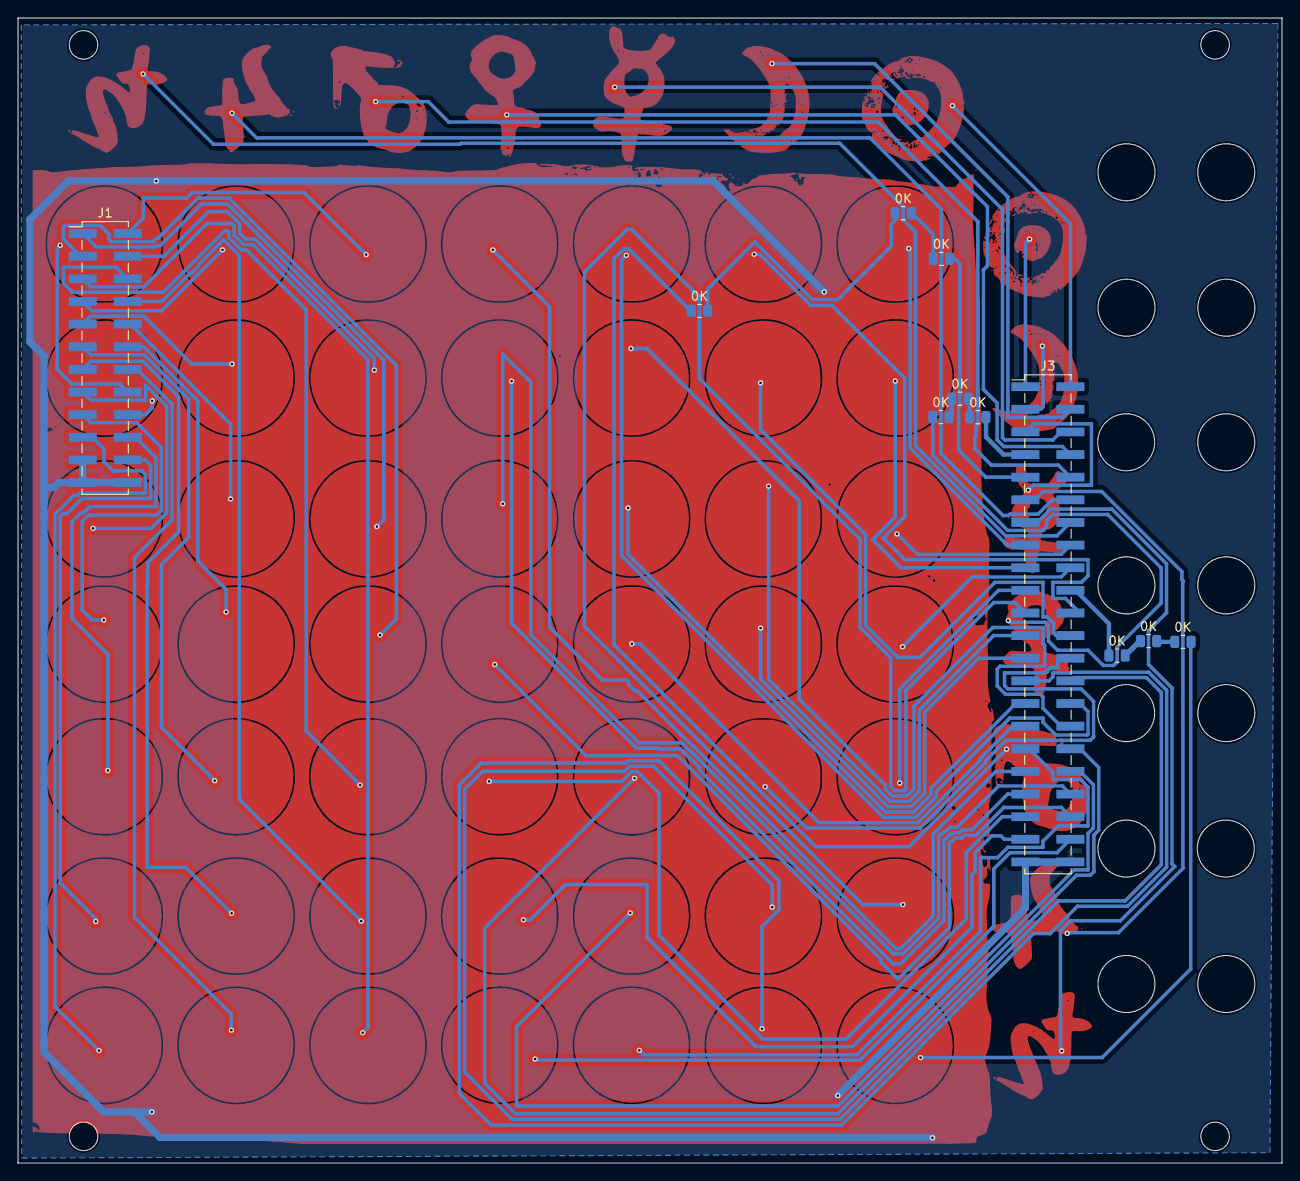
[picture p21: board populus_panel.kicad_pcb from below]

Board: 2 copper layers, 141.8 x 128.5 mm, 78 parts (11 on the bottom side), 64 nets.

Parts:
0K, 0K#2, 0K#3, 0K#4, 0K#5, 0K#6, 0K#7, 0K#8, 0K#9: R_0805_2012Metric
J1: Conn_02x12_Odd_Even; PinHeader_2x12_P2.54mm_Vertical_SMD
J2, J4, J5, J6, J7, J8, J9, J10, J11, J12, J13, J14, J15, J16, J17, J18, J19, J20, J21, J22, J23, J24, J25, J26, J27, J28, J29, J30, J31, J32, J33, J34, J35, J36, J37, J38, J39, J40, J41, J42, J43, J44, J45, J47, J48, J49, J50, J51, J52, J53, J54, J55, J56, J57, J58, J59, J60, J61, J62, J63, J64, J65, J66, J67, J68, J69, J70: Conn_01x01_Pin; TestPoint_Pad_1.0x1.0mm_nosilk
J3: Conn_02x18_Odd_Even; PinHeader_2x22_P2.54mm_Vertical_SMD

Connections:
/In1: J2.1, J3.1
/In2: J3.3, J4.1
/In3: J3.5, J5.1
/In4: 0K.1, 0K.2, 0K#2.1, 0K#2.2, 0K#8.1, 0K#8.2, J3.7, J6.1
/In5: 0K#6.1, 0K#6.2, 0K#7.1, 0K#7.2, 0K#9.1, 0K#9.2, J3.9, J7.1
/In6: J3.11, J8.1
/In7: J3.13, J9.1
/OutA: J3.2, J45.1
/OutB: J3.4, J44.1
/OutC: J3.6, J43.1
/OutD: J3.8, J42.1
/OutE: J3.10, J41.1
/OutF: J3.12, J40.1
/OutG: J3.14, J39.1
/SW_A1: J3.15, J10.1
/SW_A2: J3.17, J11.1
/SW_A3: J3.16, J38.1
/SW_A4: J3.18, J37.1
/SW_A5: J3.19, J12.1
/SW_A6: J3.21, J13.1
/SW_A7: 0K#3.1, 0K#3.2, 0K#4.1, 0K#4.2, 0K#5.1, 0K#5.2, J3.20, J36.1
/SW_B1: J3.22, J35.1
/SW_B2: J3.24, J34.1
/SW_B3: J3.23, J14.1
/SW_B4: J3.25, J15.1
/SW_B5: J3.26, J33.1
/SW_B6: J3.28, J32.1
/SW_B7: J3.27, J16.1
/SW_C1: J3.30, J31.1
/SW_C2: J3.32, J30.1
/SW_C3: J3.29, J17.1
/SW_C4: J3.31, J18.1
/SW_C5: J3.34, J29.1
/SW_C6: J3.36, J28.1
/SW_C7: J3.33, J19.1
/SW_D1: J3.35, J20.1
/SW_D2: J3.37, J21.1
/SW_D3: J3.38, J27.1
/SW_D4: J3.40, J26.1
/SW_D5: J3.39, J22.1
/SW_D6: J3.41, J23.1
/SW_D7: J3.42, J25.1
/SW_E1: J1.2, J70.1
/SW_E2: J1.4, J69.1
/SW_E3: J1.1, J47.1
/SW_E4: J1.3, J48.1
/SW_E5: J1.6, J68.1
/SW_E6: J1.8, J67.1
/SW_E7: J1.5, J49.1
/SW_F1: J1.7, J50.1
/SW_F2: J1.9, J51.1
/SW_F3: J1.10, J66.1
/SW_F4: J1.12, J65.1
/SW_F5: J1.11, J52.1
/SW_F6: J1.13, J53.1
/SW_F7: J1.14, J64.1
/SW_G1: J1.16, J63.1
/SW_G2: J1.18, J62.1
/SW_G3: J1.15, J54.1
/SW_G4: J1.17, J55.1
/SW_G5: J1.20, J61.1
/SW_G6: J1.22, J60.1
/SW_G7: J1.19, J56.1
GND: J1.21, J1.23, J1.24, J3.43, J3.44, J24.1, J57.1, J58.1, J59.1
