microresearch/allcolours/touch/touch_kicad_new2024/touch.kicad_pcb

## KiCad design touch/touch_kicad_new2024/touch.kicad_pcb (continued)

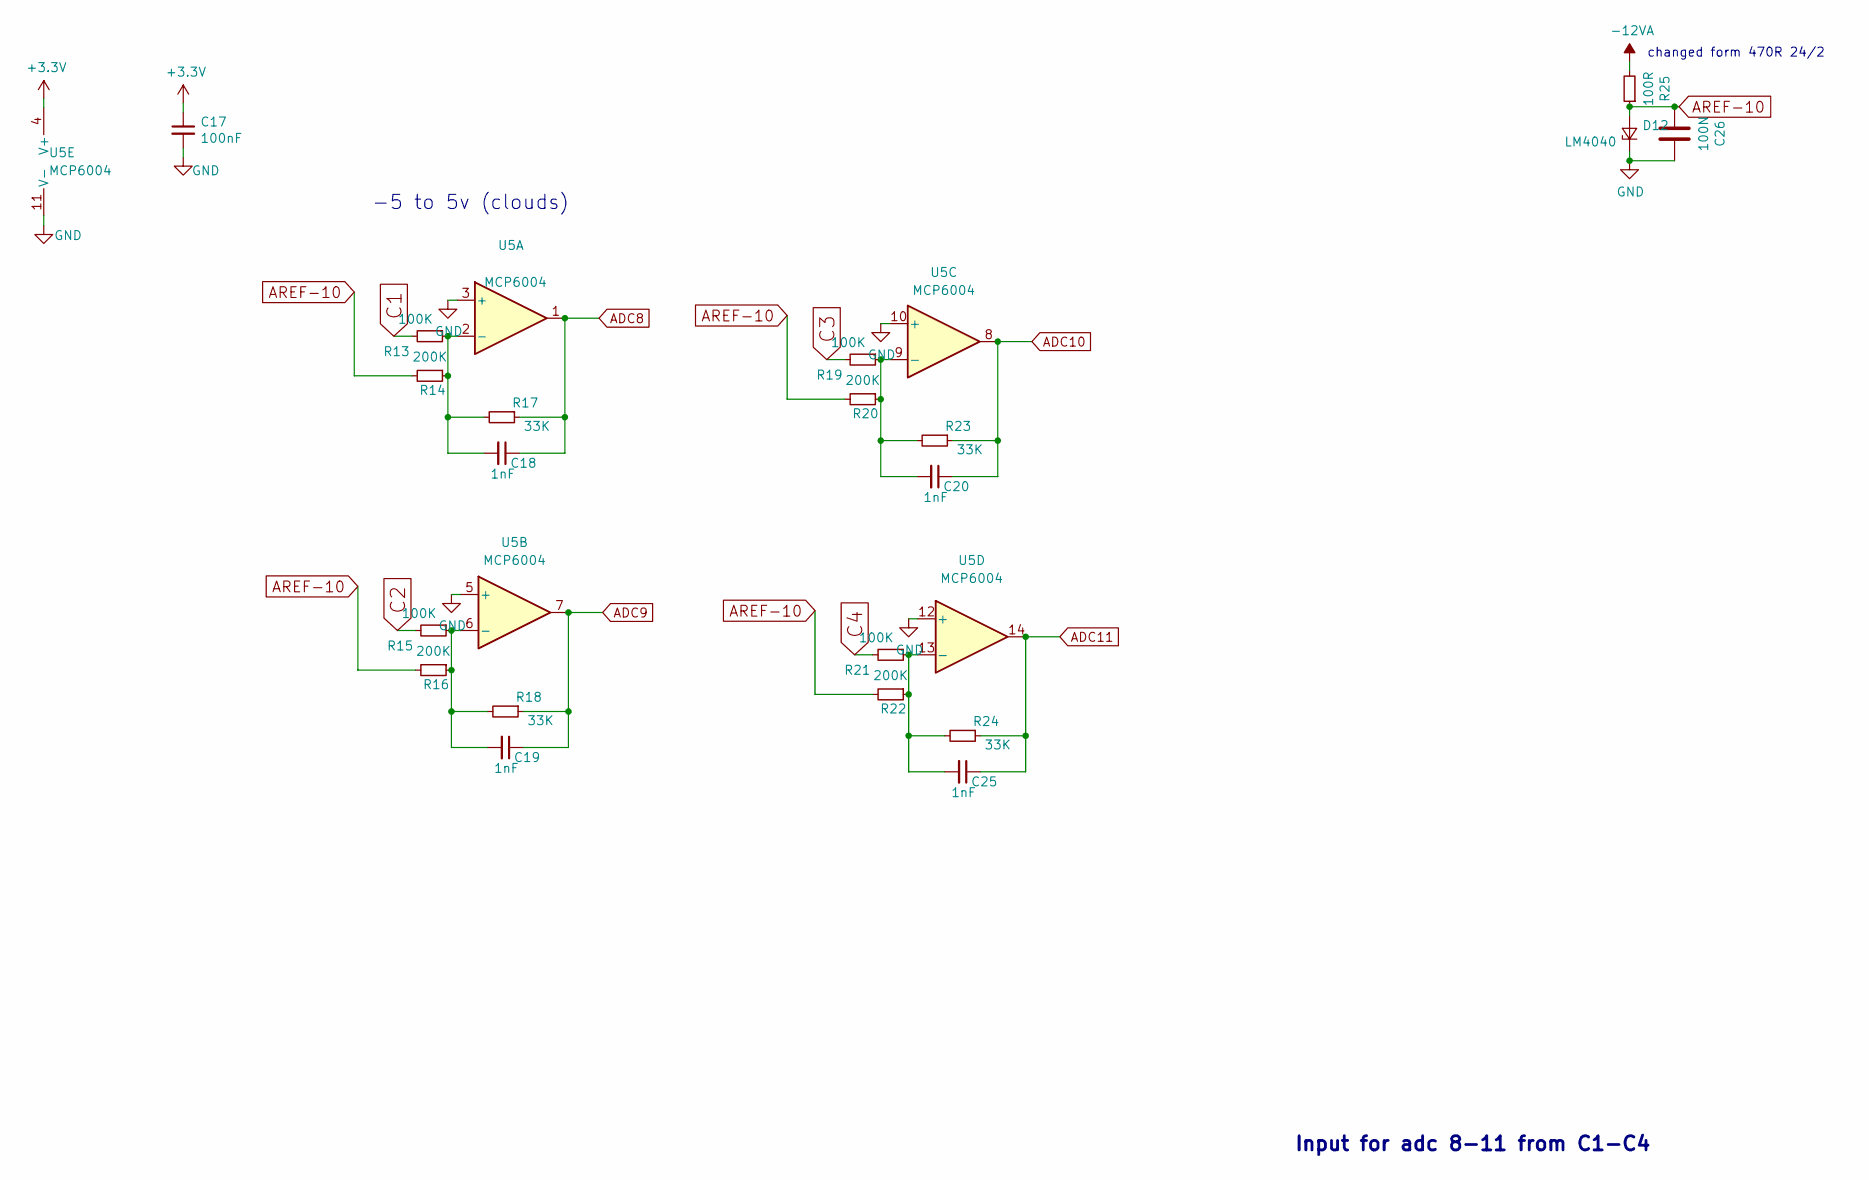
[picture p29: schematic inp.kicad_sch]

Parts:
C17: 100nF; C_0805_2012Metric
C18, C19, C20, C25: 1nF; C_0805_2012Metric
C26: 100N; C_0805_2012Metric
D12: LM4040; SOT-23
R13, R15, R19, R21: 100K; R_0805_2012Metric
R14, R16, R20, R22: 200K; R_0805_2012Metric
R17, R18, R23, R24: 33K; R_0805_2012Metric
R25: 100R; R_0805_2012Metric
U5: MCP6004; SOIC-14_3.9x8.7mm_P1.27mm

Connections:
+3.3V: C17.1, U5.4 (V+); also elsewhere on the board
-12VA: R25.2
ADC8: C18.1, R17.1, U5.1; also elsewhere on the board
ADC9: C19.1, R18.1, U5.7; also elsewhere on the board
ADC10: C20.1, R23.1, U5.8; also elsewhere on the board
ADC11: C25.1, R24.1, U5.14; also elsewhere on the board
AREF-10: C26.2, D12.2 (A), R14.2, R16.2, R20.2, R22.2, R25.1
C1: R13.2; also elsewhere on the board
C2: R15.2; also elsewhere on the board
C3: R19.2; also elsewhere on the board
C4: R21.2; also elsewhere on the board
GND: C17.2, C26.1, D12.1 (K), U5.3 (+), U5.5 (+), U5.10 (+), U5.11 (V-), U5.12 (+); also elsewhere on the board
unnamed: C18.2, R13.1, R14.1, R17.2, U5.2 (-)
unnamed: C19.2, R15.1, R16.1, R18.2, U5.6 (-)
unnamed: C20.2, R19.1, R20.1, R23.2, U5.9 (-)
unnamed: C25.2, R21.1, R22.1, R24.2, U5.13 (-)

Notes on the sheet:
Input for adc 8-11 from C1-C4
changed form 470R 24/2
-5 to 5v (clouds)

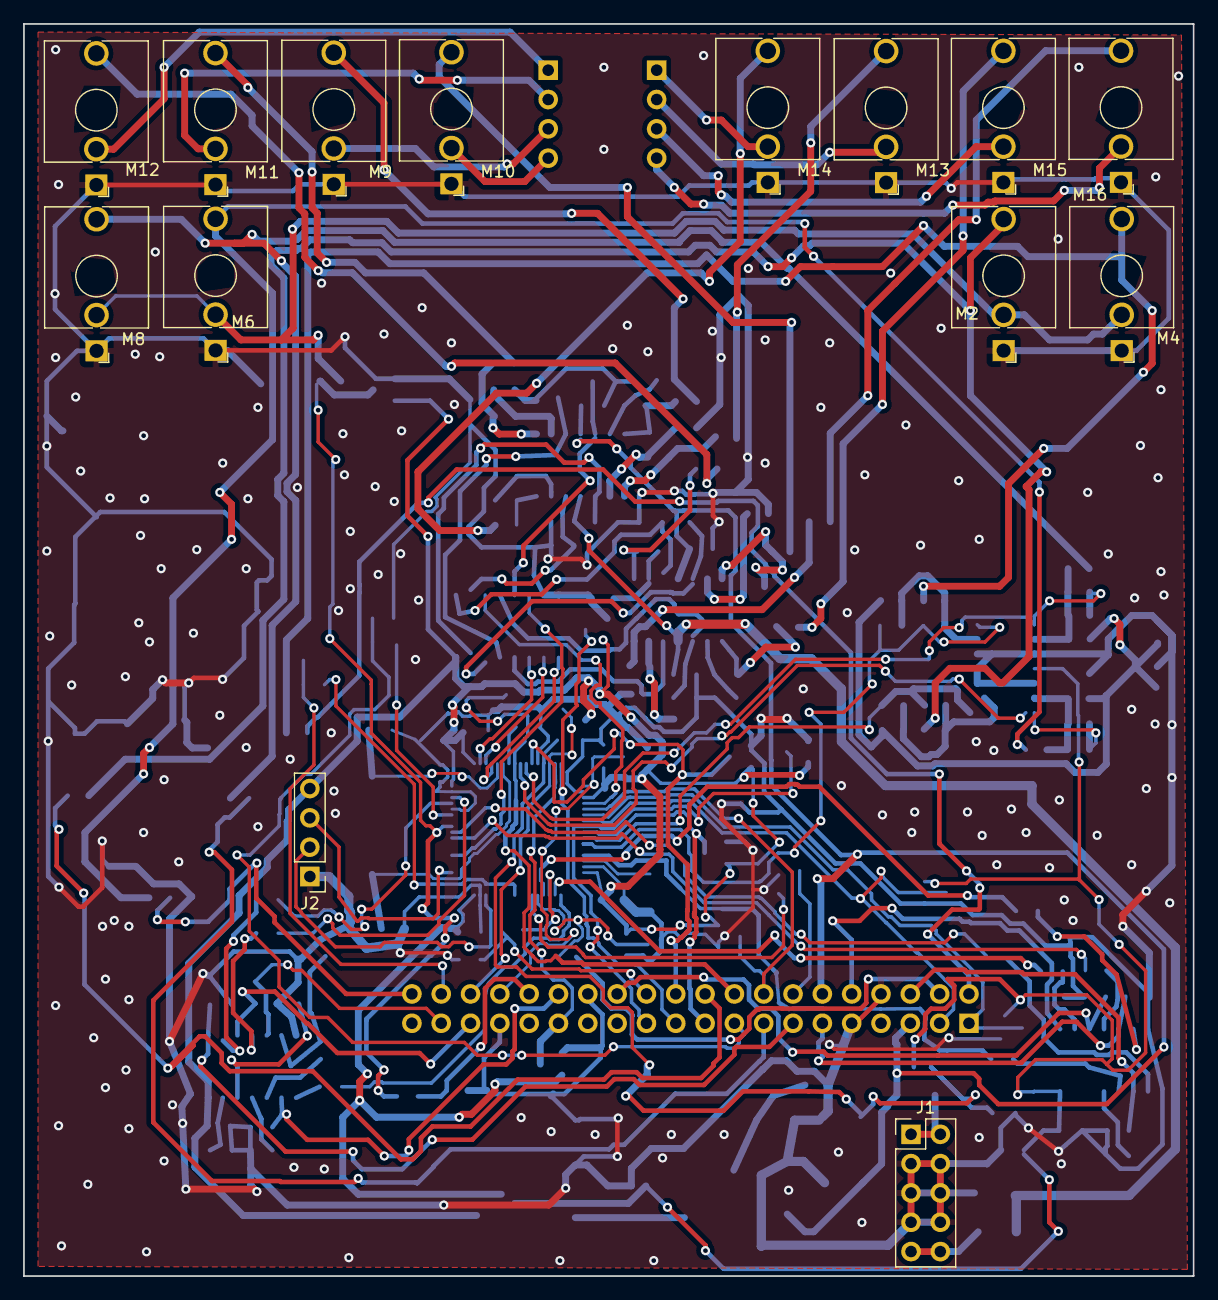
[picture p30: board touch/touch_kicad_new2024/touch.kicad_pcb from above]

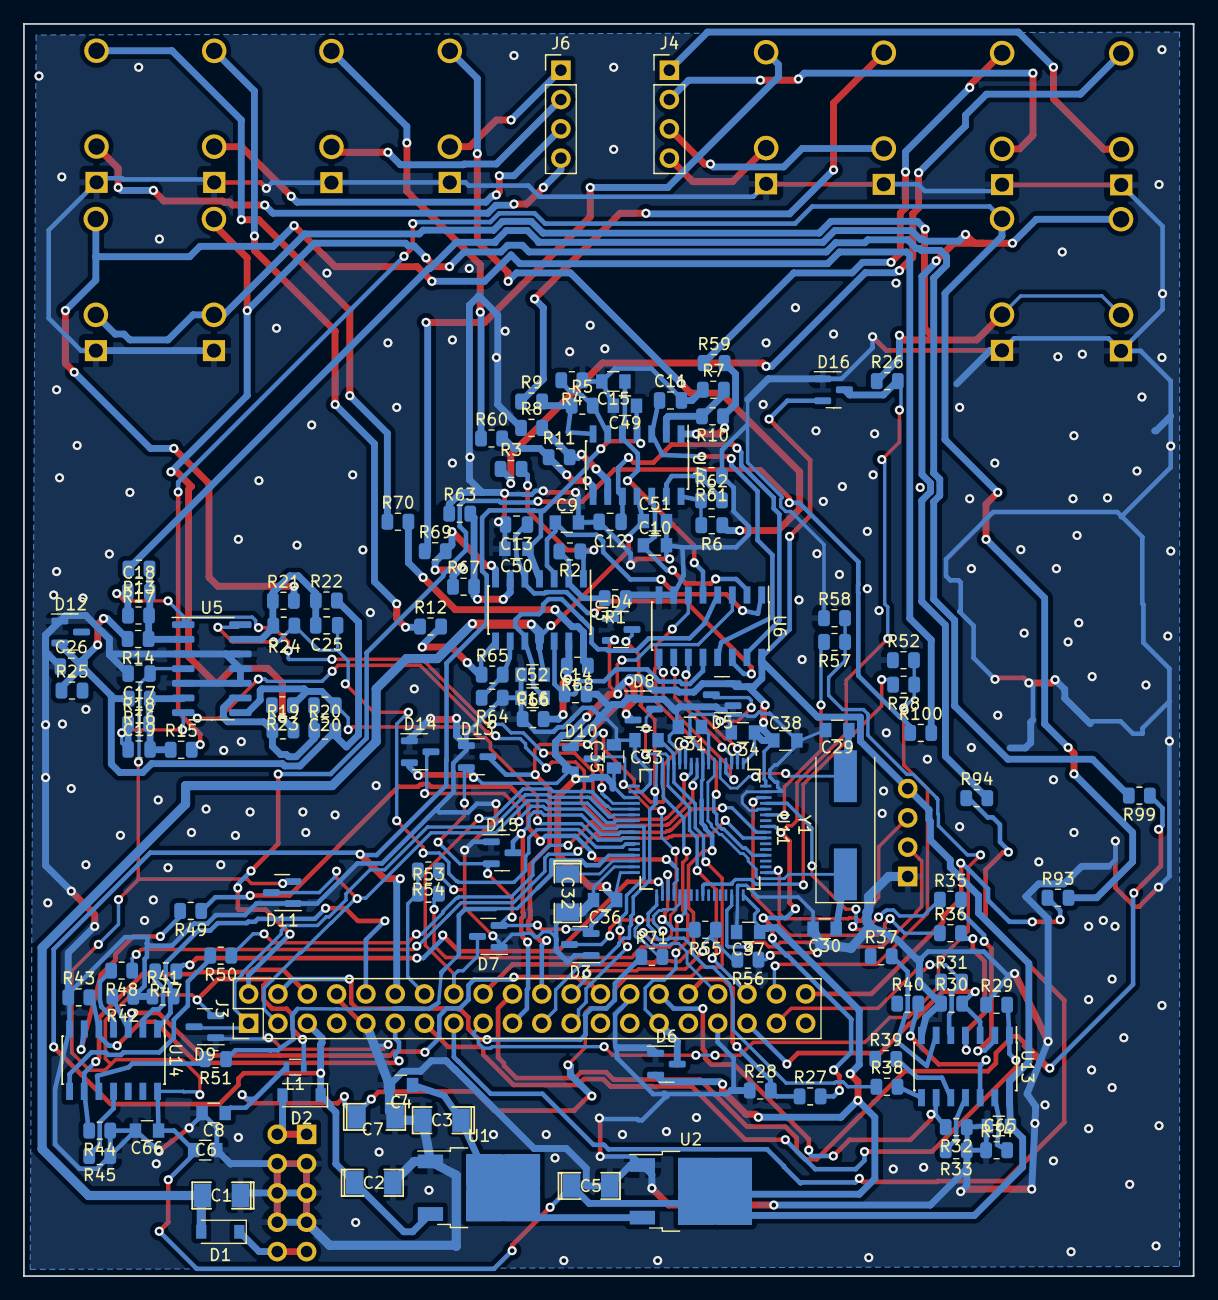
[picture p31: board touch/touch_kicad_new2024/touch.kicad_pcb from below]

Board: 2 copper layers, 101.3 x 108.5 mm, 157 parts (143 on the bottom side), 130 nets.
