microresearch/allcolours/pyro000_PCB/pyro000_kicad.kicad_pcb

## KiCad design pyro000_PCB/pyro000_kicad.kicad_pcb (2024-08-30)

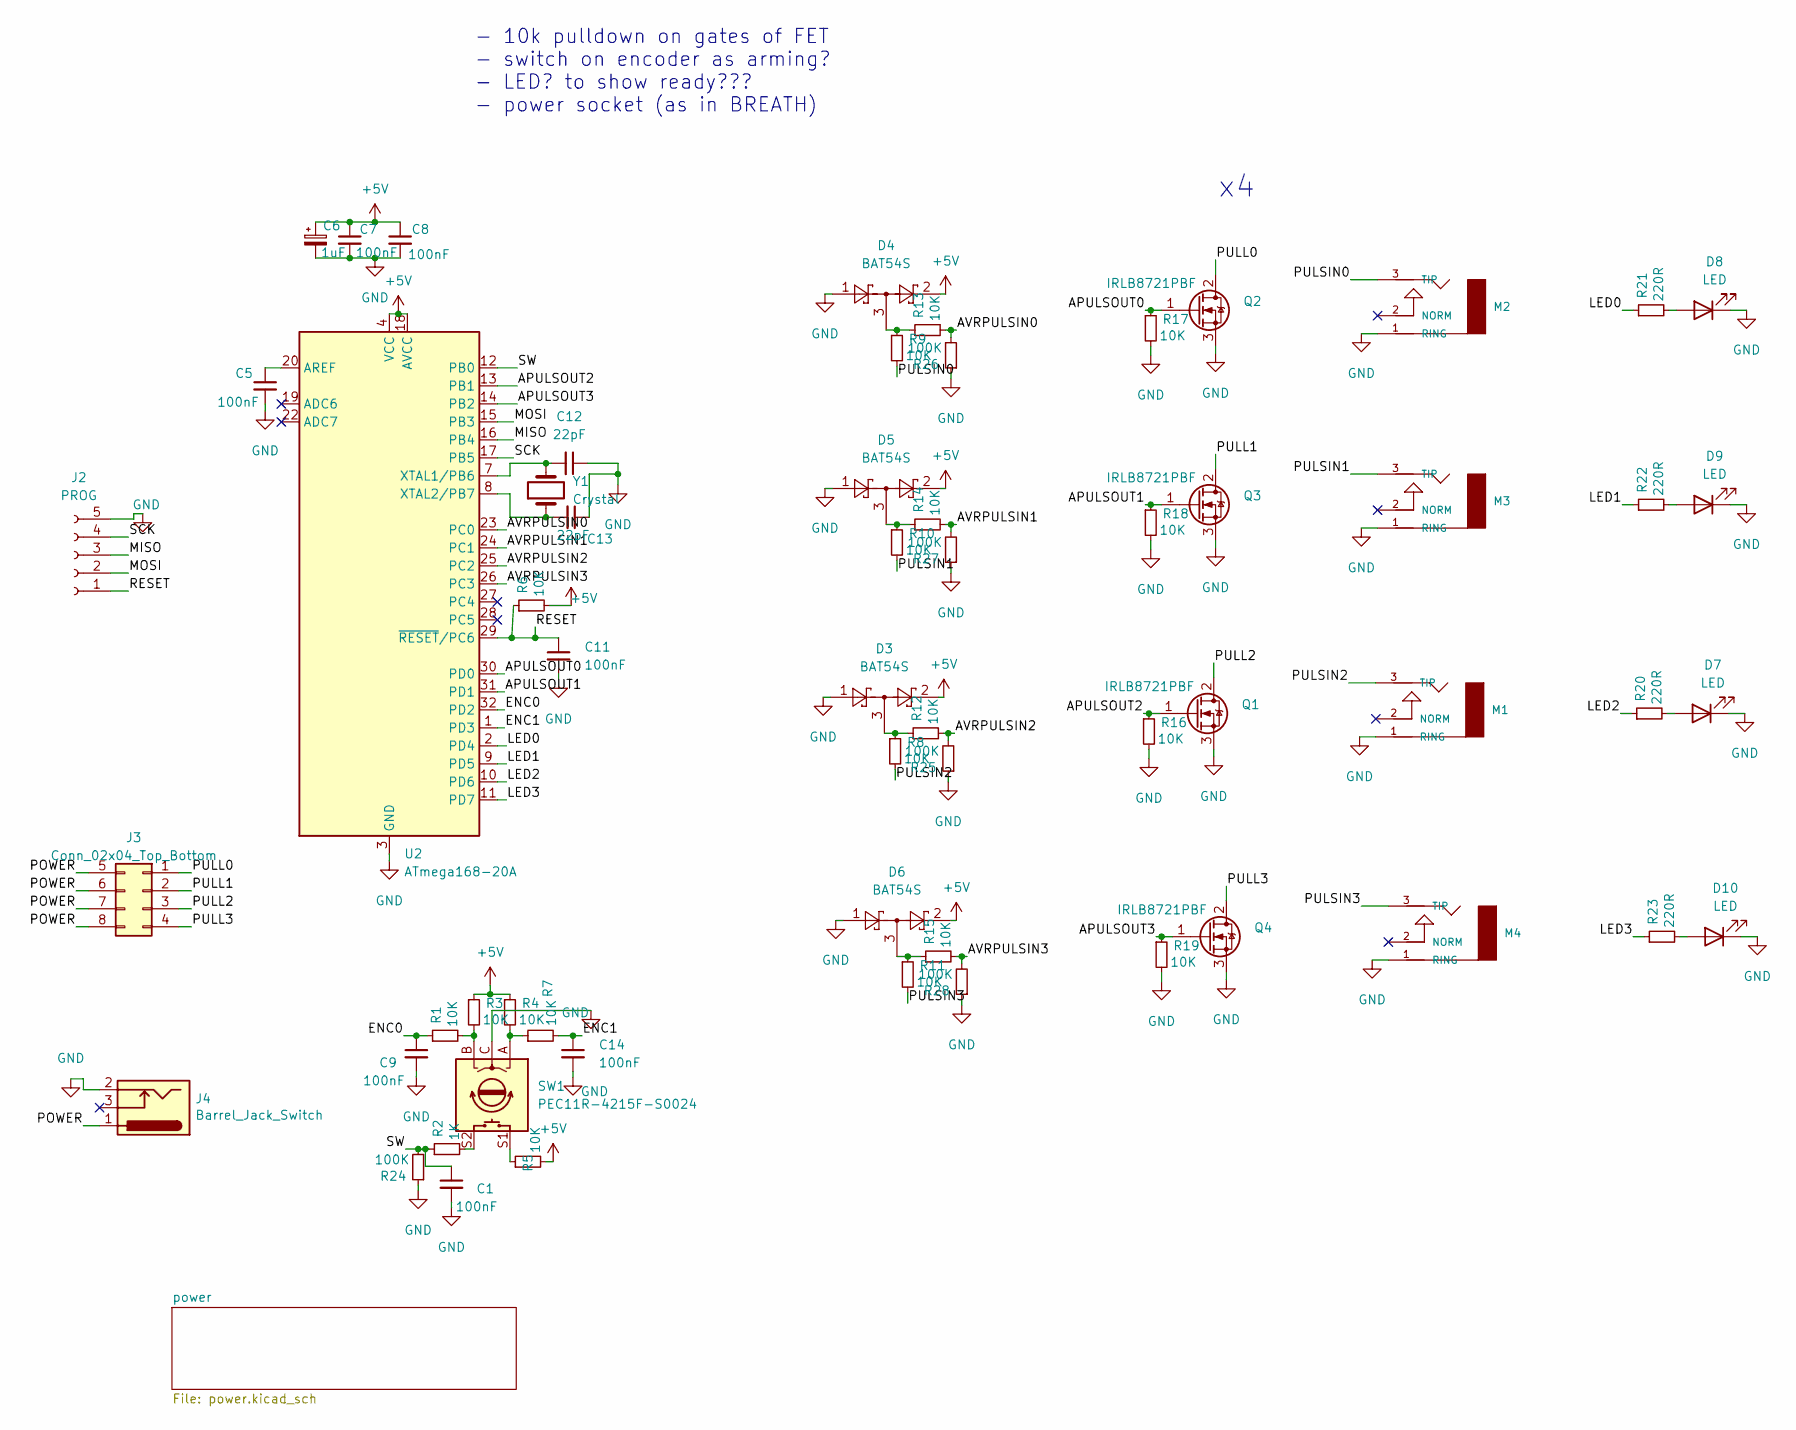
[picture p36: schematic pyro000_kicad.kicad_sch]

Parts:
C1, C5, C7, C8, C9, C11, C14: 100nF; C_0805_2012Metric; LCSC C49678
C6: 1uF; C_0805_2012Metric; LCSC C1953188
C12, C13: 22pF; C_0805_2012Metric; LCSC C1804
D3, D4, D5, D6: BAT54S; SOT-23; LCSC C8592
D7, D8, D9, D10: LED; LED_0805_2012Metric; LCSC C2827267
J2: PROG; PinHeader_1x05_P2.54mm_Vertical
J3: Conn_02x04_Top_Bottom; Push_terminals_2x4_Cliff_FE6930
J4: Barrel_Jack_Switch; BARREL_JACK
M1, M2, M3, M4: AUDIO-JACKERTHENVAR-PJ398-allcolours-rescue; Jack_3.5mm_QingPu_WQP-PJ398SM_Vertical_CircularHolesKEEPOUT
Q1, Q2, Q3, Q4: IRLB8721PBF; TO-220-3_Horizontal_TabDown_DrainHeatSink
R1, R3, R4, R5, R6, R7, R8, R9, R10, R11, R12, R13, R14, R15, R16, R17, R18, R19: 10K; R_0805_2012Metric; LCSC C17414
R2: 1K; R_0805_2012Metric; LCSC C17513
R20, R21, R22, R23: 220R; R_0805_2012Metric; LCSC C114519
R24, R25, R26, R27, R28: 100K; R_0805_2012Metric; LCSC C149504
SW1: PEC11R-4215F-S0024; XDCR_PEC11R-4215F-S0024
U2: ATmega168-20A; TQFP-32_7x7mm_P0.8mm; LCSC C8728
Y1: Crystal; Crystal_SMD_HC49-SD

Connections:
+5V: C6.1, C7.1, C8.1, D3.2, D4.2, D5.2, D6.2, R3.1, R4.1, R5.2, R6.2, U2.4 (VCC), U2.6 (VCC), U2.18 (AVCC); also elsewhere on the board
/APULSOUT0: Q2.1 (G), R17.1, U2.30 (PD0)
/APULSOUT1: Q3.1 (G), R18.1, U2.31 (PD1)
/APULSOUT2: Q1.1 (G), R16.1, U2.13 (PB1)
/APULSOUT3: Q4.1 (G), R19.1, U2.14 (PB2)
/AVRPULSIN0: R13.2, R26.2, U2.23 (PC0)
/AVRPULSIN1: R14.2, R27.2, U2.24 (PC1)
/AVRPULSIN2: R12.2, R25.2, U2.25 (PC2)
/AVRPULSIN3: R15.2, R28.2, U2.26 (PC3)
/ENC0: C9.1, R1.1, U2.32 (PD2)
/ENC1: C14.1, R7.2, U2.1 (PD3)
/LED0: R21.1, U2.2 (PD4)
/LED1: R22.1, U2.9 (PD5)
/LED2: R20.1, U2.10 (PD6)
/LED3: R23.1, U2.11 (PD7)
/MISO: J2.3, U2.16 (PB4)
/MOSI: J2.2, U2.15 (PB3)
/POWER: J3.5, J3.6, J3.7, J3.8, J4.1
/PULL0: J3.1, Q2.2 (D)
/PULL1: J3.2, Q3.2 (D)
/PULL2: J3.3, Q1.2 (D)
/PULL3: J3.4, Q4.2 (D)
/PULSIN0: M2.3 (TIP), R9.2
/PULSIN1: M3.3 (TIP), R10.2
/PULSIN2: M1.3 (TIP), R8.2
/PULSIN3: M4.3 (TIP), R11.2
/RESET: C11.1, J2.1, R6.1, U2.29 (~RESET/PC6)
/SCK: J2.4, U2.17 (PB5)
/SW: C1.1, R2.1, R24.2, U2.12 (PB0)
GND: C1.2, C5.2, C6.2, C7.2, C8.2, C9.2, C11.2, C12.1, C13.1, C14.2, D3.1, D4.1, D5.1, D6.1, D7.1 (K), D8.1 (K), D9.1 (K), D10.1 (K), J2.5, J4.2, M1.1 (RING), M1.2 (NORM), M2.1 (RING), M2.2 (NORM), M3.1 (RING), M3.2 (NORM), M4.1 (RING), M4.2 (NORM), Q1.3 (S), Q2.3 (S), Q3.3 (S), Q4.3 (S), R16.2, R17.2, R18.2, R19.2, R24.1, R25.1, R26.1, R27.1, R28.1, SW1.C, U2.3 (GND), U2.5 (GND), U2.21 (GND); also elsewhere on the board
unnamed: C5.1, U2.20 (AREF)
unnamed: C12.2, U2.7 (XTAL1/PB6), Y1.2
unnamed: C13.2, U2.8 (XTAL2/PB7), Y1.1
unnamed: D3.3, R8.1, R12.1
unnamed: D4.3, R9.1, R13.1
unnamed: D5.3, R10.1, R14.1
unnamed: D6.3, R11.1, R15.1
unnamed: D7.2 (A), R20.2
unnamed: D8.2 (A), R21.2
unnamed: D9.2 (A), R22.2
unnamed: D10.2 (A), R23.2
unnamed: R1.2, R3.2, SW1.B
unnamed: R2.2, SW1.S2
unnamed: R4.2, R7.1, SW1.A
unnamed: R5.1, SW1.S1

Notes on the sheet:
- 10k pulldown on gates of FET - switch on encoder as arming? - LED? to show ready??? - power socket (as in BREATH)

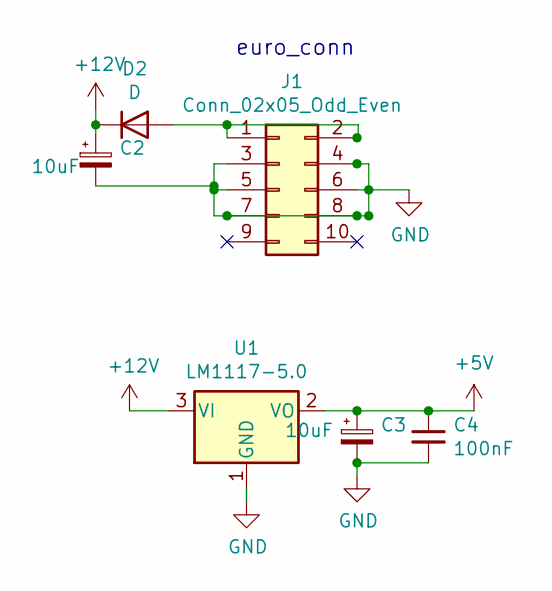
[picture p37: schematic power.kicad_sch]

Parts:
C2, C3: 10uF; CP_EIA-3216-18_Kemet-A
C4: 100nF; C_0805_2012Metric
D2: D; D_SOD-123
J1: Conn_02x05_Odd_Even; PinHeader_2x05_P2.54mm_Vertical
U1: LM1117-5.0; TO-252-2

Connections:
+5V: C3.1, C4.1, U1.2 (VO); also elsewhere on the board
+12V: C2.1, D2.1 (K), U1.3 (VI)
GND: C2.2, C3.2, C4.2, J1.3, J1.4, J1.5, J1.6, J1.7, J1.8, U1.1 (GND); also elsewhere on the board
unnamed: D2.2 (A), J1.1, J1.2

Notes on the sheet:
euro_conn
