microresearch/allcolours/pyro000_PCB/pyro000_kicad.kicad_pcb

## KiCad design pyro000_PCB/pyro000_kicad.kicad_pcb (continued)

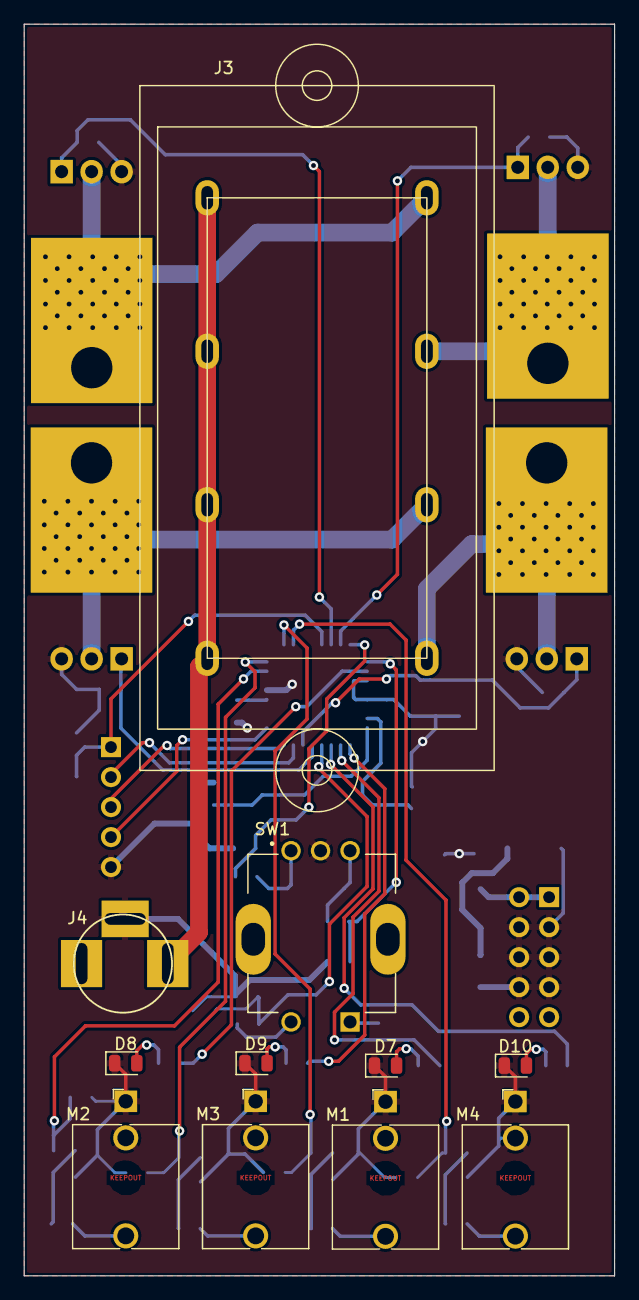
[picture p38: board pyro000_kicad.kicad_pcb from above]

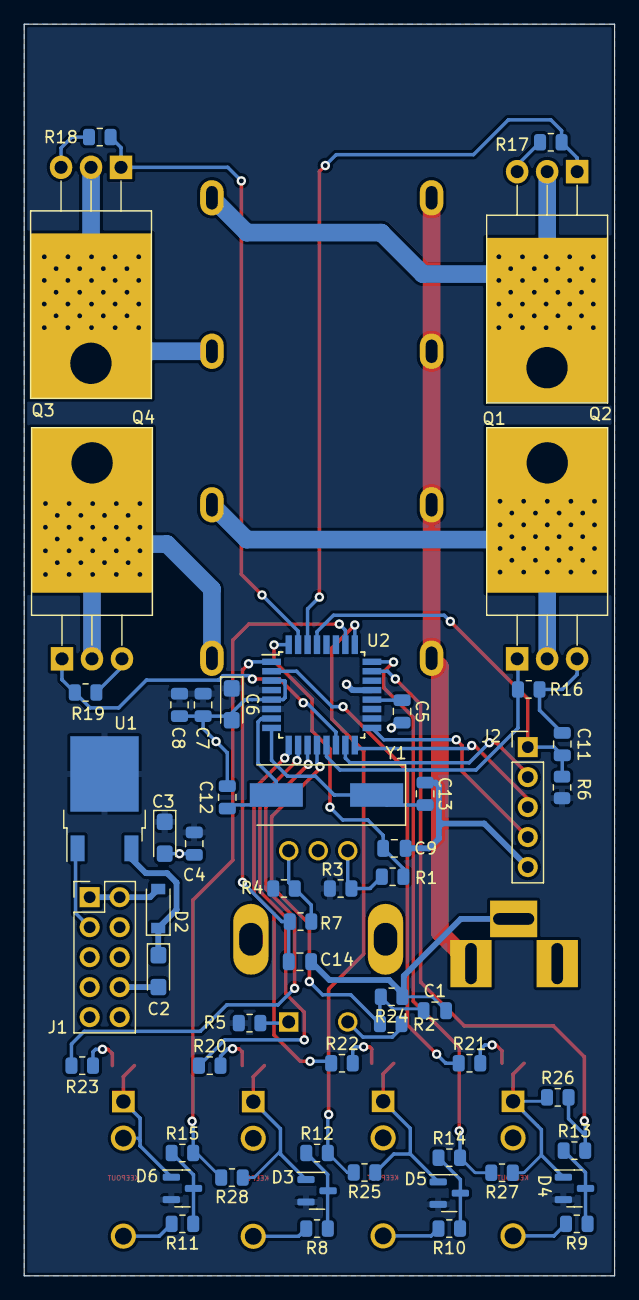
[picture p39: board pyro000_kicad.kicad_pcb from below]

Board: 2 copper layers, 50.0 x 106.0 mm, 66 parts (55 on the bottom side), 47 nets.
