microresearch/allcolours/touch/touch_kicad_new2024/touch_panel/touch_panel.kicad_pcb

## KiCad design touch/touch_kicad_new2024/touch_panel/touch_panel.kicad_pcb (2020-12-01)

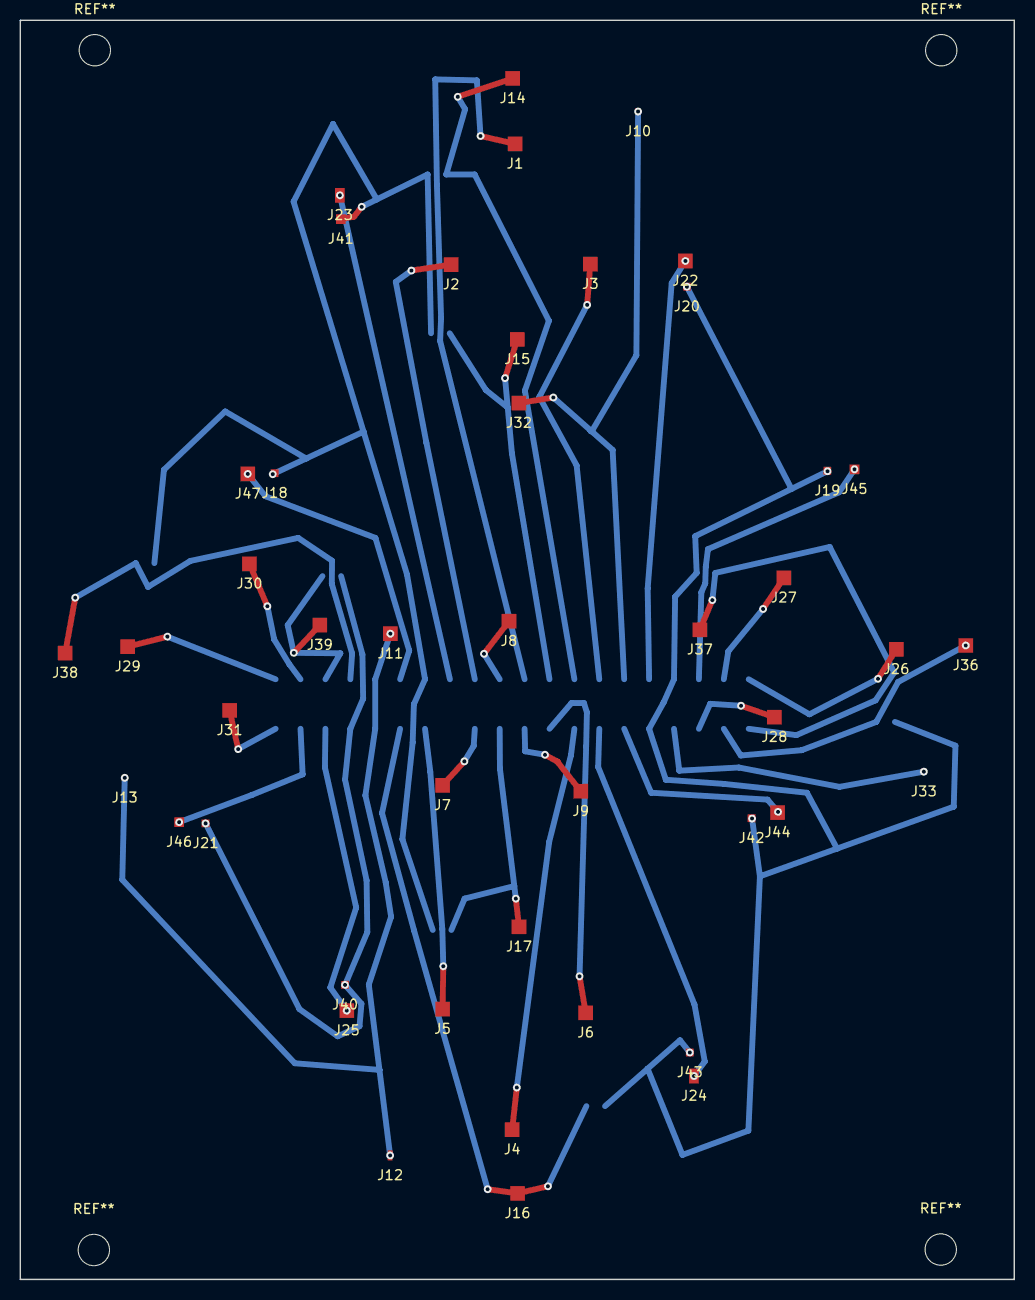
[picture p40: board touch/touch_kicad_new2024/touch_panel/touch_panel.kicad_pcb from above]

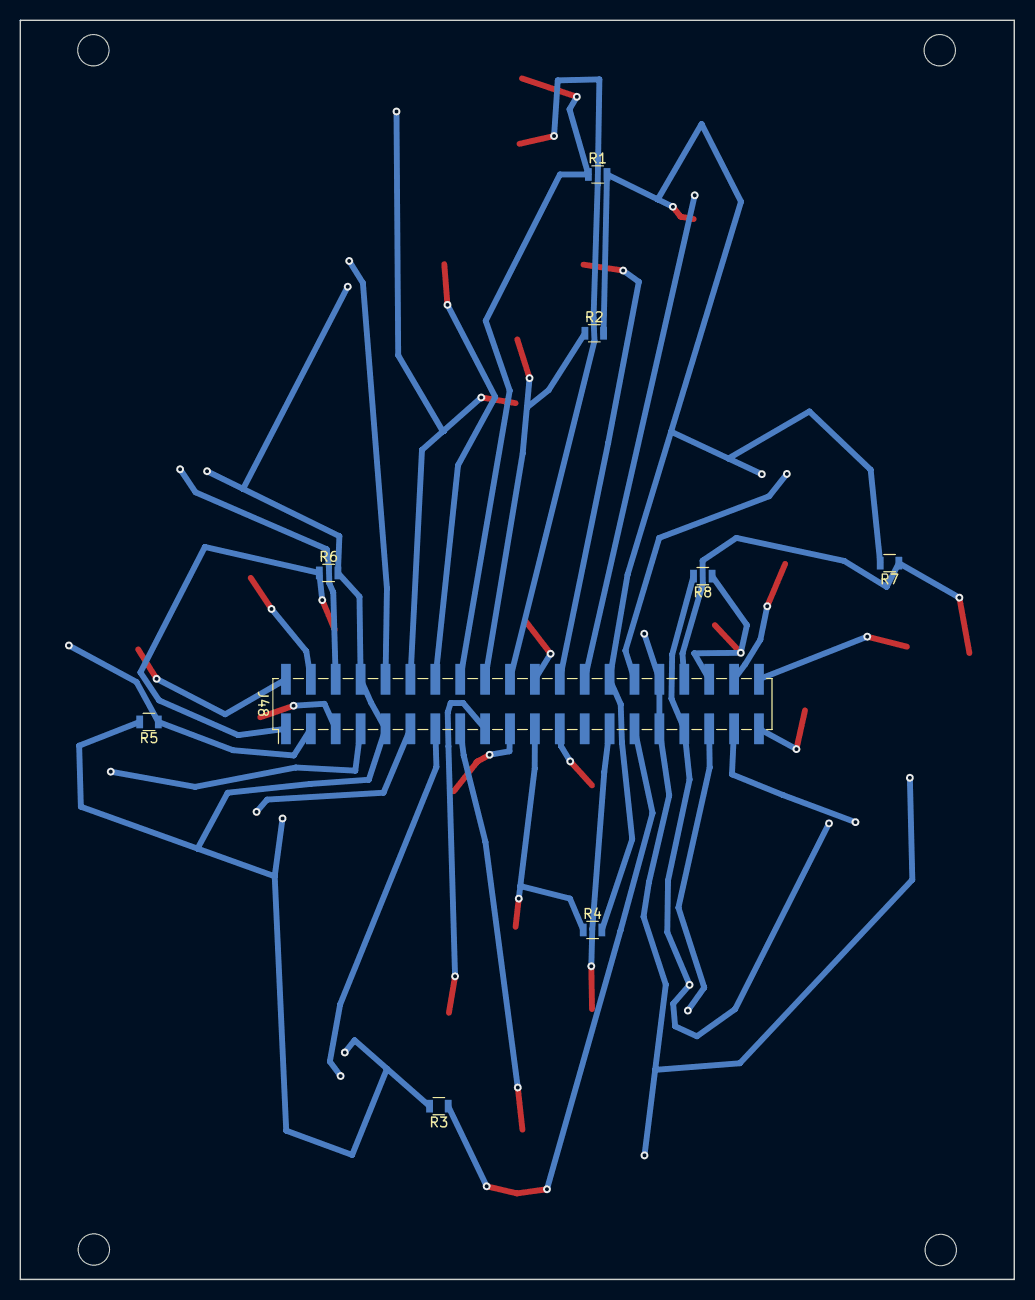
[picture p41: board touch/touch_kicad_new2024/touch_panel/touch_panel.kicad_pcb from below]

Board: 2 copper layers, 101.4 x 128.5 mm, 54 parts (9 on the bottom side), 33 nets.

Parts:
J1, J2, J3, J4, J5, J6, J7, J8, J9, J10, J11, J12, J13, J14, J15, J16, J17, J18, J19, J20, J21, J22, J23, J24, J25, J26, J27, J28, J29, J30, J31, J32, J33, J36, J37, J38, J39, J40, J41, J42, J43, J44, J45, J46, J47: Conn_01x01; Measurement_Point_Square-SMD-Pad_Small
J48: Conn_02x20_Counter_Clockwise; Pin_Header_Straight_2x20_Pitch2.54mm_SMD
R1, R2, R3, R4, R5, R6, R7, R8: 470K; R_0805

Connections:
+3.3VA: J10.1, J11.1, J12.1, J13.1, J32.1, J33.1, J48.7, J48.12, J48.25, J48.31, J48.32
ADC0: J17.1, J48.21, R4.1
ADC1: J16.1, J48.29, R3.1
ADC2: J39.1, J48.36, R8.1
ADC3: J38.1, J48.34, R7.1
ADC4: J15.1, J48.18, R2.1
ADC5: J14.1, J48.16, R1.1
ADC6: J37.1, J48.1, R6.1
ADC7: J36.1, J48.3, R5.1
B1: J5.1, J48.27
B2: J30.1, J48.38
B3: J2.1, J48.24
B4: J27.1, J48.4
C1: J4.1, J48.15
C2: J29.1, J48.40
C3: J1.1, J48.20
C4: J26.1, J48.2
F1: J24.1, J48.13
F2: J25.1, J48.35
F3: J46.1, J48.37
F4: J47.1, J48.30
F5: J22.1, J48.10
F6: J23.1, J48.26
F7: J44.1, J48.11
F8: J45.1, J48.6
Fplay: J7.1, J48.23
Fpush: J8.1, J48.22
Frec: J9.1, J48.19
GND: J18.1, J19.1, J20.1, J21.1, J40.1, J41.1, J42.1, J43.1, J48.8, J48.9, J48.28, J48.33, R1.2, R2.2, R3.2, R4.2, R5.2, R6.2, R7.2, R8.2
IN1: J6.1, J48.17
IN2: J31.1, J48.39
IN3: J3.1, J48.14
IN4: J28.1, J48.5
