microresearch/allcolours/touch_toggle_final/touch_toggle_latest_panel/latest_panel_kicad/latest_panel_kicad.kicad_pcb

## KiCad design touch_toggle_final/touch_toggle_latest_panel/latest_panel_kicad/latest_panel_kicad.kicad_pcb (2023-12-01)

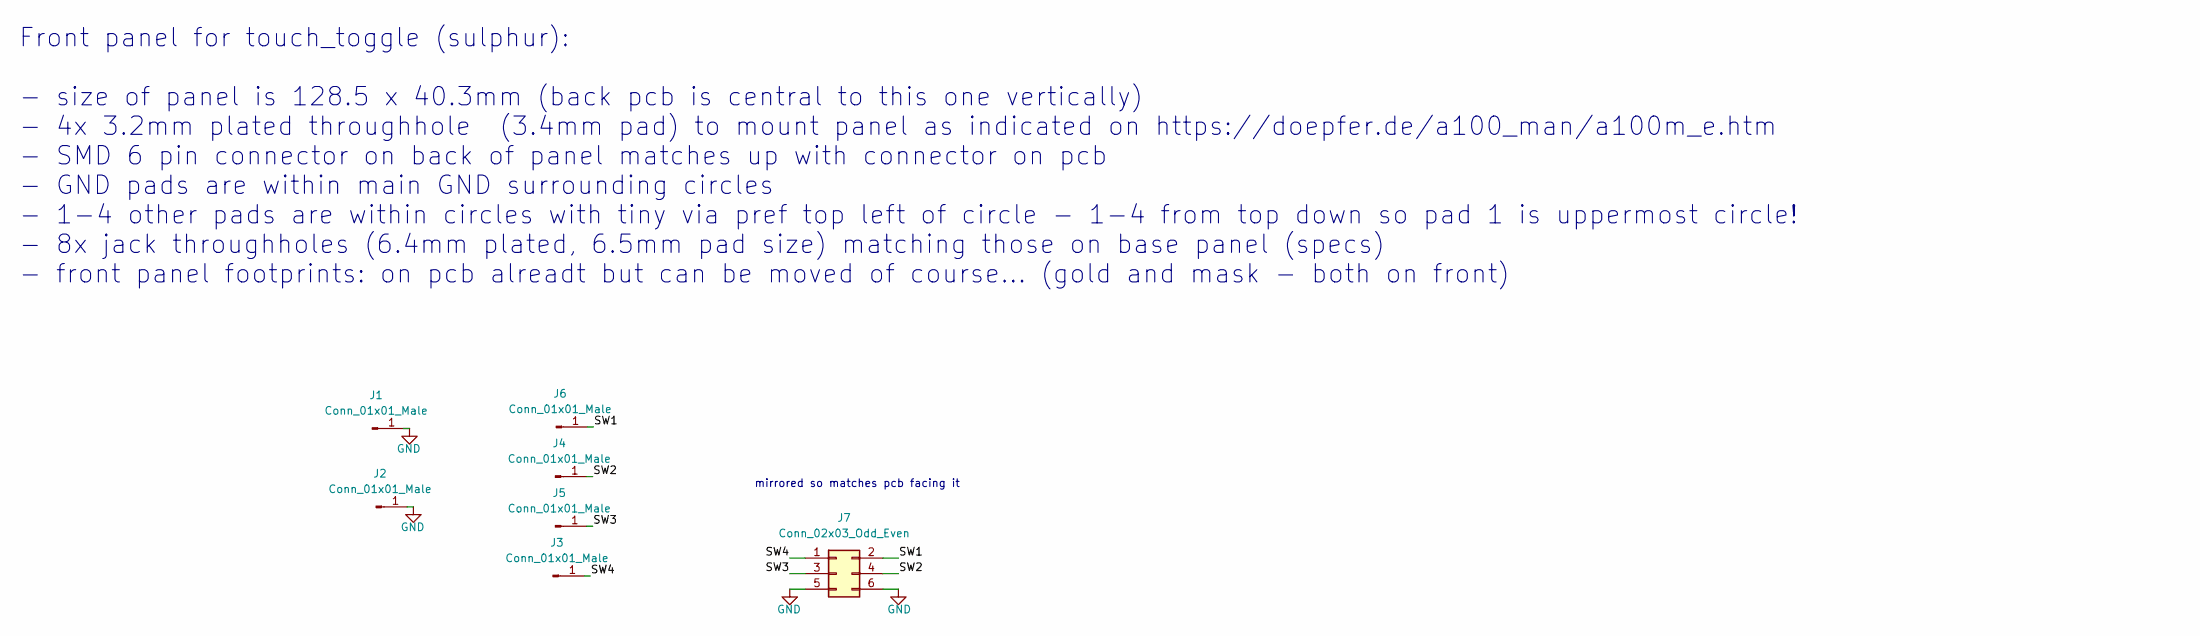
[picture p47: schematic latest_panel_kicad.kicad_sch]

Parts:
J1, J2, J3, J4, J5, J6: Conn_01x01_Male; TestPoint_Pad_1.5x1.5mm
J7: Conn_02x03_Odd_Even; PinHeader_2x03_P2.54mm_Vertical_SMD

Connections:
/SW1: J6.1, J7.2
/SW2: J4.1, J7.4
/SW3: J5.1, J7.3
/SW4: J3.1, J7.1
GND: J1.1, J2.1, J7.5, J7.6

Notes on the sheet:
Front panel for touch_toggle (sulphur): - size of panel is 128.5 x 40.3mm (back pcb is central to this one vertically) - 4x 3.2mm plated throughhole (3.4mm pad) to mount panel as indicated on https://doepfer.de/a100_man/a100m_e.htm - SMD 6 pin connector on back of panel matches up with connector on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
mirrored so matches pcb facing it

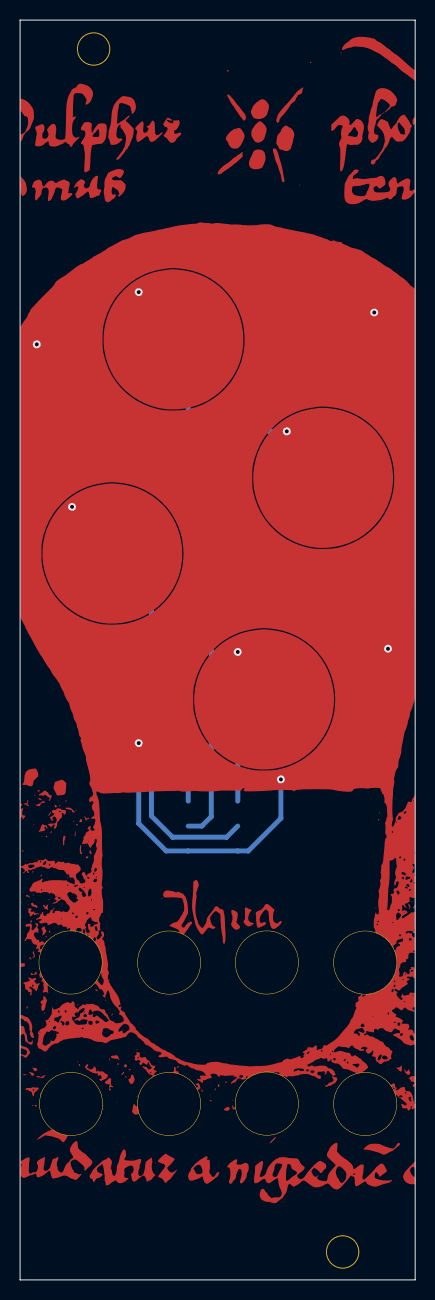
[picture p48: board latest_panel_kicad.kicad_pcb from above]

Board: 2 copper layers, 40.3 x 128.5 mm, 7 parts (1 on the bottom side), 5 nets.
