microresearch/allcolours/Offset_torework/offset_kicad.kicad_pcb

## KiCad design Offset_torework/offset_kicad.kicad_pcb (2023-12-01)

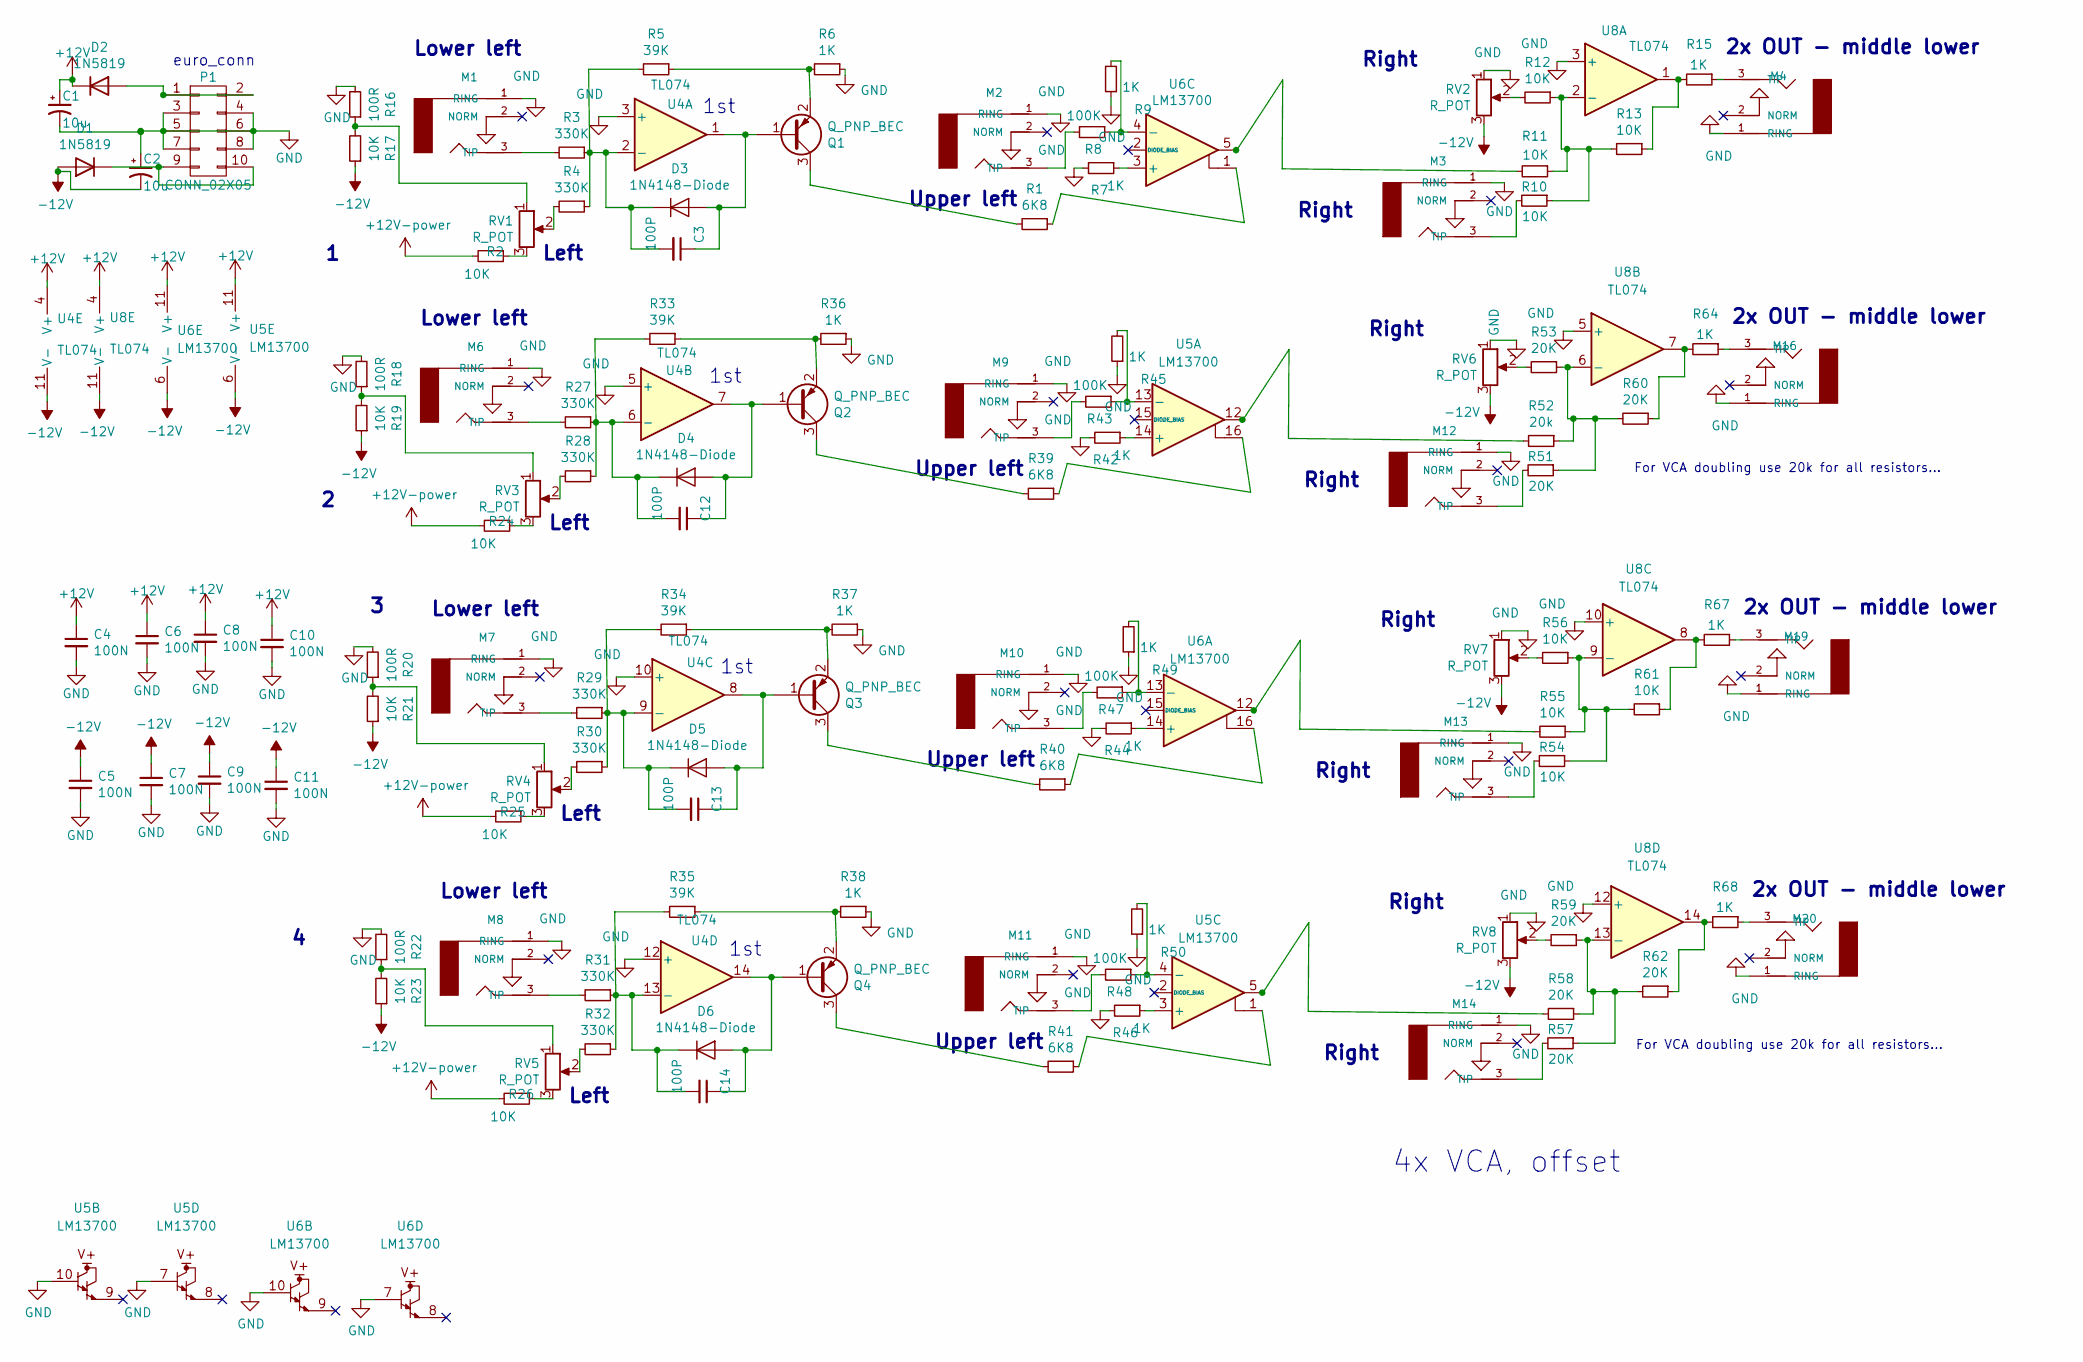
[picture p49: schematic offset_kicad.kicad_sch]

Parts:
C1, C2: 10u; CP_EIA-3216-18_Kemet-A
C3, C12, C13, C14: 100P; C_0805_2012Metric; LCSC C1790
C4, C5, C6, C7, C8, C9, C10, C11: 100N; C_0805_2012Metric; LCSC C49678
D1, D2: 1N5819; D_SOD-123; LCSC C82544
D3, D4, D5, D6: 1N4148-Diode; D_SOD-123; LCSC C81598
M1, M2, M3, M4, M6, M7, M8, M9, M10, M11, M12, M13, M14, M16, M19, M20: AUDIO-JACKERTHENVAR-PJ398; Jack_3.5mm_QingPu_WQP-PJ398SM_Vertical_CircularHolesKEEPOUT
P1: CONN_02X05; PinHeader_2x05_P2.54mm_Vertical
Q1, Q2, Q3, Q4: Q_PNP_BEC; SOT-23; LCSC C53444
R1, R39, R40, R41: 6K8; R_0805_2012Metric; LCSC C114550
R2, R10, R11, R12, R13, R17, R19, R21, R23, R24, R25, R26, R54, R55, R56, R61: 10K; R_0805_2012Metric; LCSC C17414
R3, R4, R27, R28, R29, R30, R31, R32: 330K; R_0805_2012Metric; LCSC C17629
R5, R33, R34, R35: 39K; R_0805_2012Metric; LCSC C25632
R6, R8, R9, R15, R36, R37, R38, R43, R45, R47, R48, R49, R50, R64, R67, R68: 1K; R_0805_2012Metric; LCSC C17513
R7, R42, R44, R46: 100K; R_0805_2012Metric; LCSC C149504
R16, R18, R20, R22: 100R; R_0805_2012Metric; LCSC C106949
R51, R53, R57, R58, R59, R60, R62: 20K; R_0805_2012Metric; LCSC C4328
R52: 20k; R_0805_2012Metric; LCSC C4328
RV1, RV2, RV3, RV4, RV5, RV6, RV7, RV8: R_POT; Potentiometer_Alps-RK09
U4, U8: TL074; SOIC-14_3.9x8.7mm_P1.27mm; LCSC C12594
U5, U6: LM13700; SOIC-16_3.9x9.9mm_P1.27mm; LCSC C174050

Connections:
-12V: C2.2, C5.1, C7.1, C9.1, C11.1, D1.2 (A), R17.1, R19.1, R21.1, R23.1, RV2.3, RV6.3, RV7.3, RV8.3, U4.11 (V-), U5.6 (V-), U6.6 (V-), U8.11 (V-)
GND: C1.2, C2.1, C4.2, C5.2, C6.2, C7.2, C8.2, C9.2, C10.2, C11.2, M1.1 (RING), M2.1 (RING), M3.1 (RING), M4.1 (RING), M6.1 (RING), M7.1 (RING), M8.1 (RING), M9.1 (RING), M10.1 (RING), M11.1 (RING), M12.1 (RING), M13.1 (RING), M14.1 (RING), M16.1 (RING), M19.1 (RING), M20.1 (RING), P1.3, P1.4, P1.5, P1.6, P1.7, P1.8, R6.1, R8.2, R9.1, R16.2, R18.2, R20.2, R22.2, R36.1, R37.1, R38.1, R43.2, R45.1, R47.2, R48.2, R49.1, R50.1, RV2.1, RV6.1, RV7.1, RV8.1, U4.3 (+), U4.5 (+), U4.10 (+), U4.12 (+), U5.7, U5.10, U6.7, U6.10, U8.3 (+), U8.5 (+), U8.10 (+), U8.12 (+)
unnamed: C3.1, D3.2 (A), Q1.1 (B), U4.1
unnamed: C3.2, D3.1 (K), R3.1, R4.1, R5.2, U4.2 (-)
unnamed: C12.1, D4.2 (A), Q2.1 (B), U4.7
unnamed: C12.2, D4.1 (K), R27.1, R28.1, R33.2, U4.6 (-)
unnamed: C13.1, D5.2 (A), Q3.1 (B), U4.8
unnamed: C13.2, D5.1 (K), R29.1, R30.1, R34.2, U4.9 (-)
unnamed: C14.1, D6.2 (A), Q4.1 (B), U4.14
unnamed: C14.2, D6.1 (K), R31.1, R32.1, R35.2, U4.13 (-)
unnamed: D1.1 (K), P1.9, P1.10
unnamed: D2.2 (A), P1.1, P1.2
unnamed: M1.3 (TIP), R3.2
unnamed: M2.3 (TIP), R7.2
unnamed: M3.3 (TIP), R10.2
unnamed: M4.3 (TIP), R15.1
unnamed: M6.3 (TIP), R27.2
unnamed: M7.3 (TIP), R29.2
unnamed: M8.3 (TIP), R31.2
unnamed: M9.3 (TIP), R42.2
unnamed: M10.3 (TIP), R44.2
unnamed: M11.3 (TIP), R46.2
unnamed: M12.3 (TIP), R51.2
unnamed: M13.3 (TIP), R54.2
unnamed: M14.3 (TIP), R57.2
unnamed: M16.3 (TIP), R64.1
unnamed: M19.3 (TIP), R67.1
unnamed: M20.3 (TIP), R68.1
unnamed: Q1.2 (E), R5.1, R6.2
unnamed: Q1.3 (C), R1.2
unnamed: Q2.2 (E), R33.1, R36.2
unnamed: Q2.3 (C), R39.2
unnamed: Q3.2 (E), R34.1, R37.2
unnamed: Q3.3 (C), R40.2
unnamed: Q4.2 (E), R35.1, R38.2
unnamed: Q4.3 (C), R41.2
unnamed: R1.1, U6.1
unnamed: R2.1, RV1.3
unnamed: R4.2, RV1.2
unnamed: R7.1, R9.2, U6.4 (-)
unnamed: R8.1, U6.3 (+)
unnamed: R10.1, R11.1, R12.1, R13.2, U8.2 (-)
unnamed: R11.2, U6.5
unnamed: R12.2, RV2.2
unnamed: R13.1, R15.2, U8.1
unnamed: R16.1, R17.2, RV1.1
unnamed: R18.1, R19.2, RV3.1
unnamed: R20.1, R21.2, RV4.1
unnamed: R22.1, R23.2, RV5.1
unnamed: R24.1, RV3.3
unnamed: R25.1, RV4.3
unnamed: R26.1, RV5.3
unnamed: R28.2, RV3.2
unnamed: R30.2, RV4.2
unnamed: R32.2, RV5.2
unnamed: R39.1, U5.16
unnamed: R40.1, U6.16
unnamed: R41.1, U5.1
unnamed: R42.1, R45.2, U5.13 (-)
unnamed: R43.1, U5.14 (+)
unnamed: R44.1, R49.2, U6.13 (-)
unnamed: R46.1, R50.2, U5.4 (-)
unnamed: R47.1, U6.14 (+)
unnamed: R48.1, U5.3 (+)
unnamed: R51.1, R52.1, R53.1, R60.2, U8.6 (-)
unnamed: R52.2, U5.12
unnamed: R53.2, RV6.2
unnamed: R54.1, R55.1, R56.1, R61.2, U8.9 (-)
unnamed: R55.2, U6.12
unnamed: R56.2, RV7.2
unnamed: R57.1, R58.1, R59.1, R62.2, U8.13 (-)
unnamed: R58.2, U5.5
unnamed: R59.2, RV8.2
unnamed: R60.1, R64.2, U8.7
unnamed: R61.1, R67.2, U8.8
unnamed: R62.1, R68.2, U8.14

Notes on the sheet:
Upper left
Lower left
1st
4x VCA, offset
2x OUT - middle lower
Left
For VCA doubling use 20k for all resistors...
Right
euro_conn
Right

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
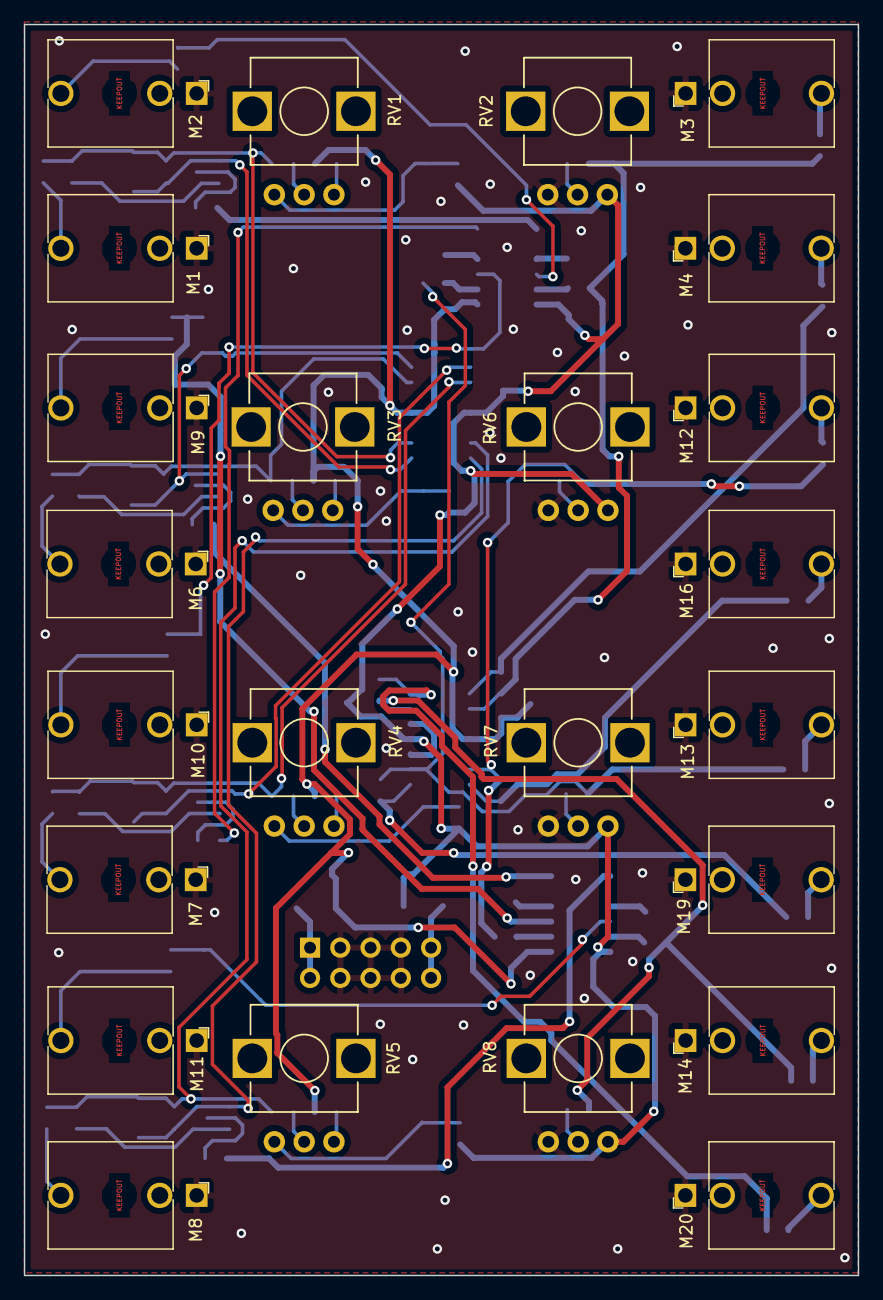
[picture p50: board offset_kicad.kicad_pcb from above]

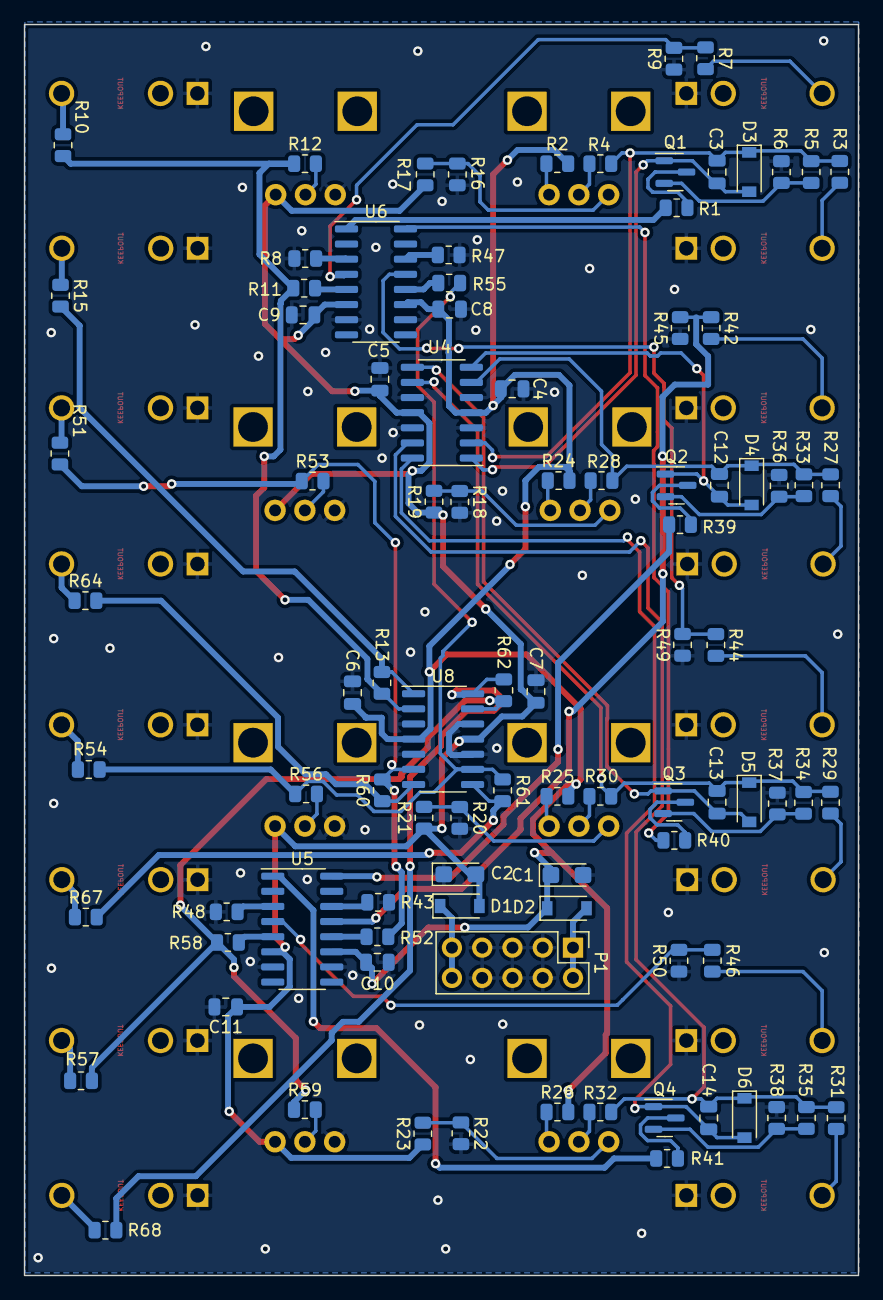
[picture p51: board offset_kicad.kicad_pcb from below]

Board: 2 copper layers, 70.0 x 105.0 mm, 117 parts (93 on the bottom side), 77 nets.
