microresearch/allcolours/TOAD/FINAL_FINAL/toad2.kicad_pcb

## KiCad design TOAD/FINAL_FINAL/toad2.kicad_pcb (2023-07-03)

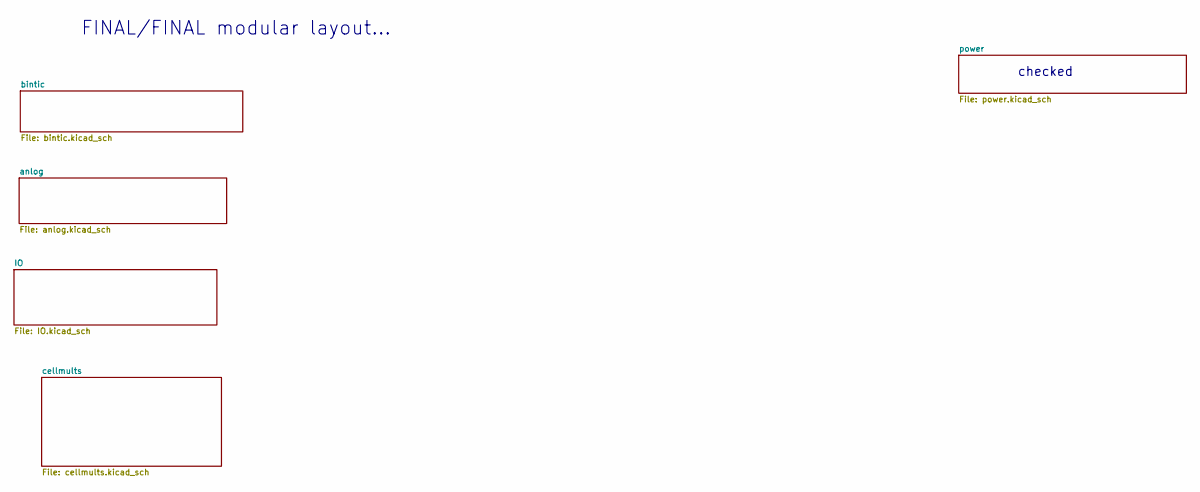
[picture p52: schematic toad2.kicad_sch]

Notes on the sheet:
FINAL/FINAL modular layout...
checked

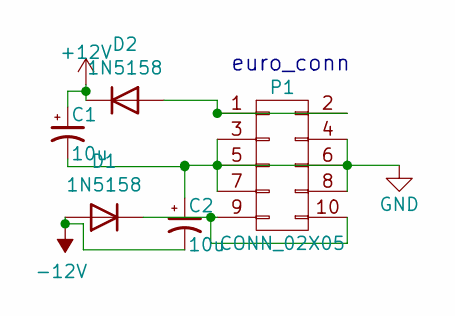
[picture p53: schematic power.kicad_sch]

Parts:
C1, C2: 10u; CP_EIA-3216-18_Kemet-A
D1, D2: 1N5158; D_SOD-123
P1: CONN_02X05; PinHeader_2x05_P2.54mm_Vertical

Connections:
-12V: C2.2, D1.2 (A); also elsewhere on the board
GND: C1.2, C2.1, P1.3, P1.4, P1.5, P1.6, P1.7, P1.8; also elsewhere on the board
unnamed: D1.1 (K), P1.9, P1.10
unnamed: D2.2 (A), P1.1, P1.2

Notes on the sheet:
euro_conn

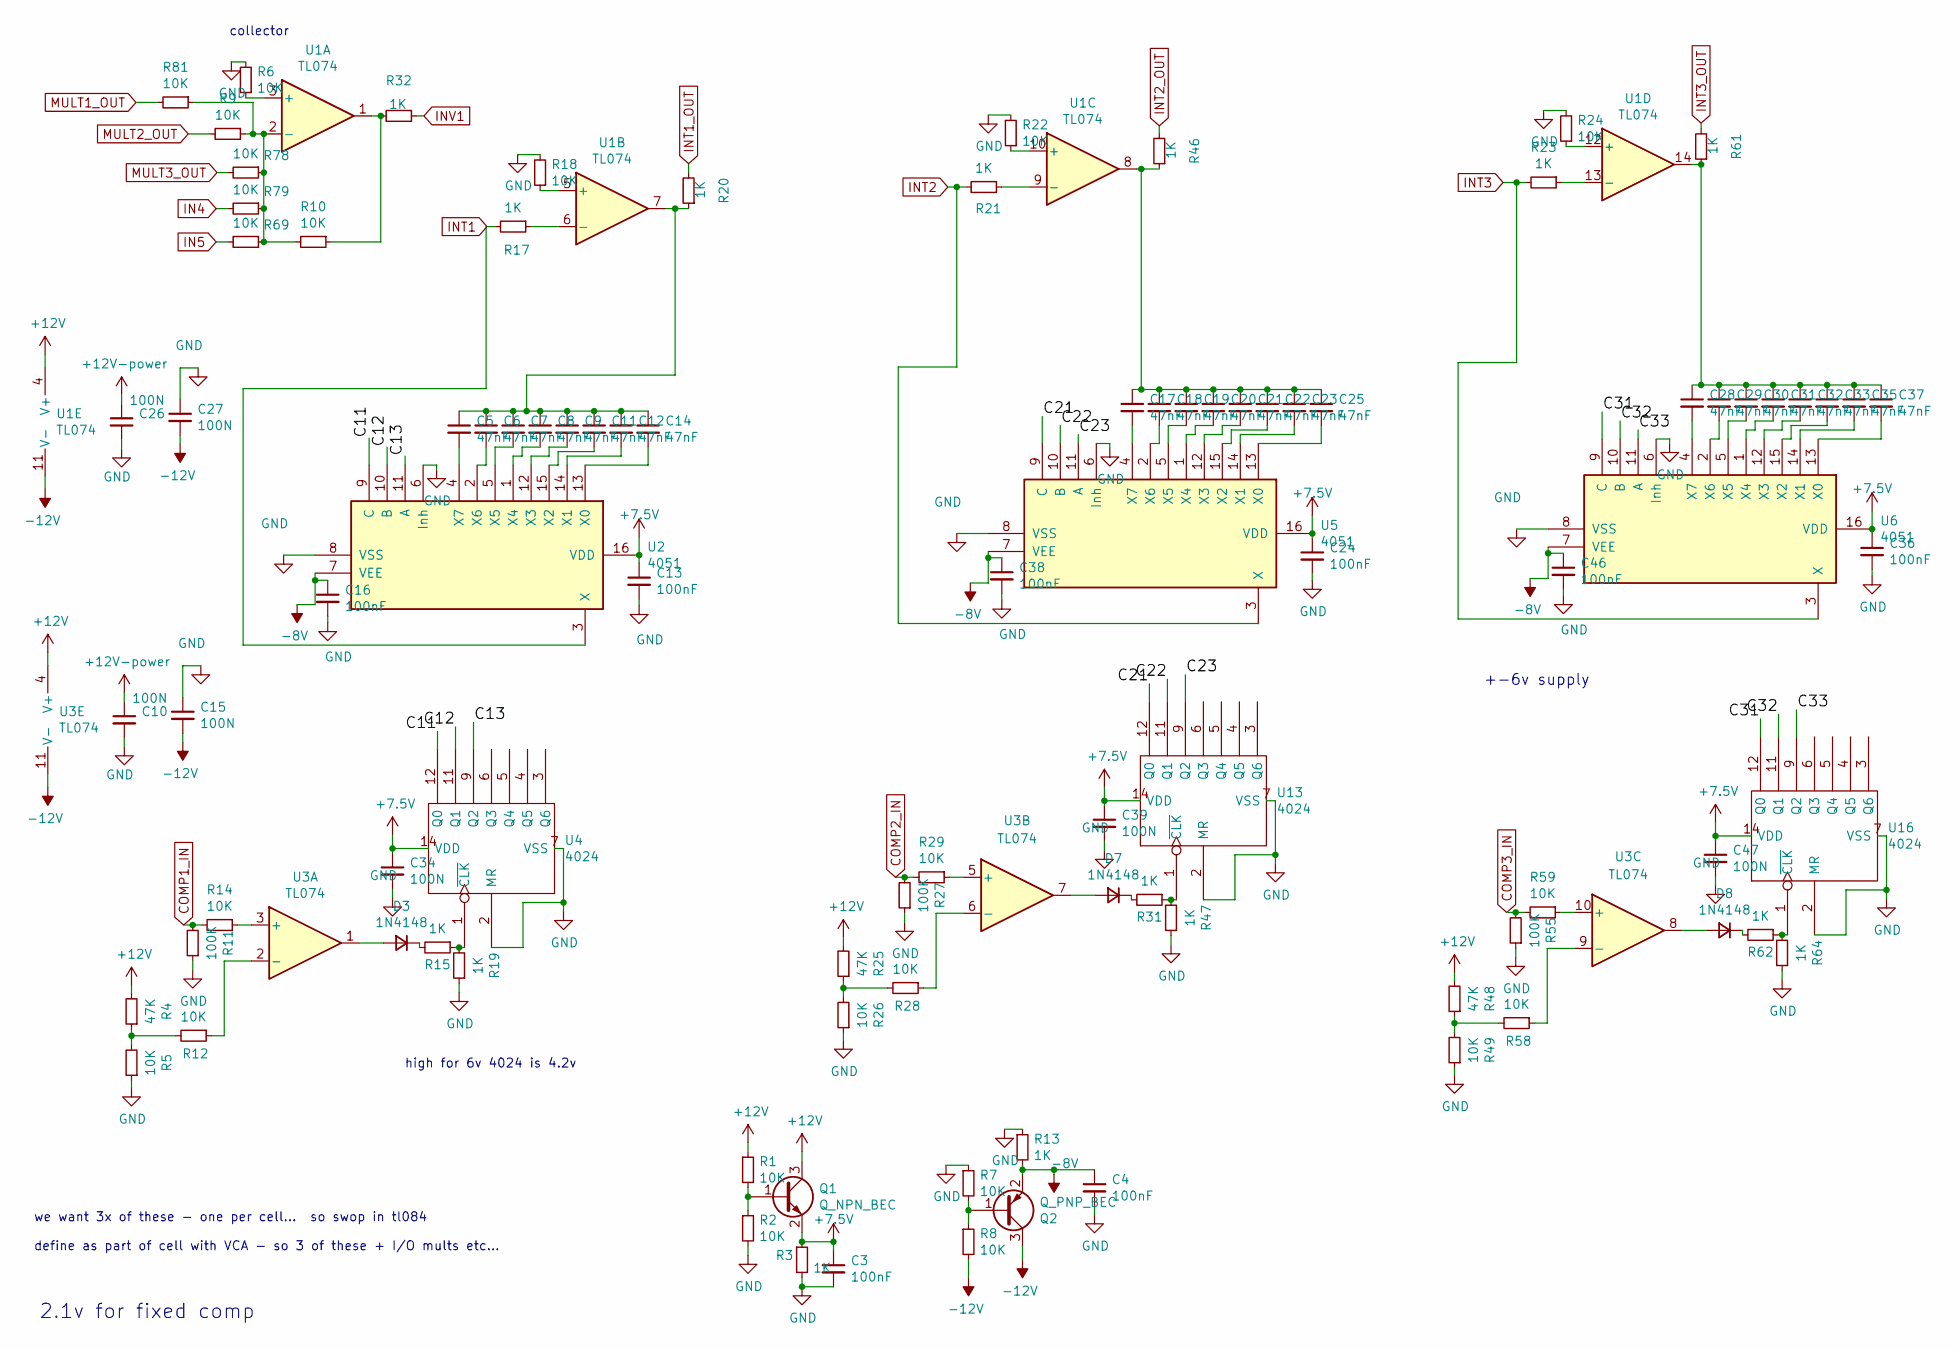
[picture p54: schematic bintic.kicad_sch]

Parts:
C3, C4, C13, C16, C24, C36, C38, C46: 100nF; C_0805_2012Metric
C5, C6, C7, C8, C9, C11, C12, C14, C17, C18, C19, C20, C21, C22, C23, C25, C28, C29, C30, C31, C32, C33, C35, C37: 47nF; C_0805_2012Metric
C10, C15, C26, C27, C34, C39, C47: 100N; C_0805_2012Metric
D3, D7, D8: 1N4148; D_SOD-123
Q1: Q_NPN_BEC; TSOT-23
Q2: Q_PNP_BEC; TSOT-23
R1, R2, R5, R6, R7, R8, R9, R10, R12, R14, R18, R22, R24, R26, R28, R29, R49, R58, R59, R69, R78, R79, R81: 10K; R_0805_2012Metric
R3, R13, R15, R17, R19, R20, R21, R23, R31, R32, R46, R47, R61, R62, R64: 1K; R_0805_2012Metric
R4, R25, R48: 47K; R_0805_2012Metric
R11, R27, R55: 100K; R_0805_2012Metric
U1, U3: TL074; SOIC-14_3.9x8.7mm_P1.27mm
U2, U5, U6: 4051; SOIC-16_3.9x9.9mm_P1.27mm
U4, U13, U16: 4024; SOIC-14_3.9x8.7mm_P1.27mm

Connections:
+7.5V: C3.1, C13.1, C24.1, C34.1, C36.1, C39.1, C47.1, Q1.2 (E), R3.1, U2.16 (VDD), U4.14 (VDD), U5.16 (VDD), U6.16 (VDD), U13.14 (VDD), U16.14 (VDD)
-8V: C4.1, C16.1, C38.1, C46.1, Q2.2 (E), R13.2, U2.7 (VEE), U5.7 (VEE), U6.7 (VEE)
-12V: C15.2, C27.2, Q2.3 (C), R8.2, U1.11 (V-), U3.11 (V-); also elsewhere on the board
/bintic/C11: U2.9 (C), U4.12 (Q0)
/bintic/C12: U2.10 (B), U4.11 (Q1)
/bintic/C13: U2.11 (A), U4.9 (Q2)
/bintic/C21: U5.9 (C), U13.12 (Q0)
/bintic/C22: U5.10 (B), U13.11 (Q1)
/bintic/C23: U5.11 (A), U13.9 (Q2)
/bintic/C31: U6.9 (C), U16.12 (Q0)
/bintic/C32: U6.10 (B), U16.11 (Q1)
/bintic/C33: U6.11 (A), U16.9 (Q2)
COMP1_IN: R11.2, R14.2; also elsewhere on the board
COMP2_IN: R27.2, R29.2; also elsewhere on the board
COMP3_IN: R55.2, R59.2; also elsewhere on the board
GND: C3.2, C4.2, C10.2, C13.2, C15.1, C16.2, C24.2, C26.2, C27.1, C34.2, C36.2, C38.2, C39.2, C46.2, C47.2, R2.2, R3.2, R5.1, R6.2, R7.1, R11.1, R13.1, R18.2, R19.1, R22.2, R24.2, R26.1, R27.1, R47.1, R49.1, R55.1, R64.1, U2.6 (Inh), U2.8 (VSS), U4.2 (MR), U4.7 (VSS), U5.6 (Inh), U5.8 (VSS), U6.6 (Inh), U6.8 (VSS), U13.2 (MR), U13.7 (VSS), U16.2 (MR), U16.7 (VSS); also elsewhere on the board
IN4: R79.2; also elsewhere on the board
IN5: R69.2; also elsewhere on the board
INT1: R17.2, U2.3 (X); also elsewhere on the board
INT1_OUT: R20.2; also elsewhere on the board
INT2: R21.2, U5.3 (X); also elsewhere on the board
INT2_OUT: R46.2; also elsewhere on the board
INT3: R23.2, U6.3 (X); also elsewhere on the board
INT3_OUT: R61.2; also elsewhere on the board
INV1: R32.1; also elsewhere on the board
MULT1_OUT: R81.2; also elsewhere on the board
MULT2_OUT: R9.2; also elsewhere on the board
MULT3_OUT: R78.2; also elsewhere on the board
unnamed: C5.2, U2.4 (X7)
unnamed: C6.2, U2.2 (X6)
unnamed: C7.2, U2.5 (X5)
unnamed: C8.2, U2.1 (X4)
unnamed: C9.2, U2.12 (X3)
unnamed: C5.1, C6.1, C7.1, C8.1, C9.1, C11.1, C12.1, C14.1, R20.1, U1.7
unnamed: C11.2, U2.15 (X2)
unnamed: C12.2, U2.14 (X1)
unnamed: C14.2, U2.13 (X0)
unnamed: C17.1, C18.1, C19.1, C20.1, C21.1, C22.1, C23.1, C25.1, R46.1, U1.8
unnamed: C17.2, U5.4 (X7)
unnamed: C18.2, U5.2 (X6)
unnamed: C19.2, U5.5 (X5)
unnamed: C20.2, U5.1 (X4)
unnamed: C21.2, U5.12 (X3)
unnamed: C22.2, U5.15 (X2)
unnamed: C23.2, U5.14 (X1)
unnamed: C25.2, U5.13 (X0)
unnamed: C28.1, C29.1, C30.1, C31.1, C32.1, C33.1, C35.1, C37.1, R61.1, U1.14
unnamed: C28.2, U6.4 (X7)
unnamed: C29.2, U6.2 (X6)
unnamed: C30.2, U6.5 (X5)
unnamed: C31.2, U6.1 (X4)
unnamed: C32.2, U6.12 (X3)
unnamed: C33.2, U6.15 (X2)
unnamed: C35.2, U6.14 (X1)
unnamed: C37.2, U6.13 (X0)
unnamed: D3.1 (K), R15.2
unnamed: D3.2 (A), U3.1
unnamed: D7.1 (K), R31.2
unnamed: D7.2 (A), U3.7
unnamed: D8.1 (K), R62.2
unnamed: D8.2 (A), U3.8
unnamed: Q1.1 (B), R1.2, R2.1
unnamed: Q2.1 (B), R7.2, R8.1
unnamed: R6.1, U1.3 (+)
unnamed: R10.1, R32.2, U1.1
unnamed: R9.1, R10.2, R69.1, R78.1, R79.1, R81.1, U1.2 (-)
unnamed: R12.1, U3.2 (-)
unnamed: R4.1, R5.2, R12.2
unnamed: R14.1, U3.3 (+)
unnamed: R15.1, R19.2, U4.1 (~CLK)
unnamed: R17.1, U1.6 (-)
unnamed: R18.1, U1.5 (+)
unnamed: R21.1, U1.9 (-)
unnamed: R22.1, U1.10 (+)
unnamed: R23.1, U1.13 (-)
unnamed: R24.1, U1.12 (+)
unnamed: R25.1, R26.2, R28.2
unnamed: R28.1, U3.6 (-)
unnamed: R29.1, U3.5 (+)
unnamed: R31.1, R47.2, U13.1 (~CLK)
unnamed: R48.1, R49.2, R58.2
unnamed: R58.1, U3.9 (-)
unnamed: R59.1, U3.10 (+)
unnamed: R62.1, R64.2, U16.1 (~CLK)

Notes on the sheet:
+-6v supply
high for 6v 4024 is 4.2v
we want 3x of these - one per cell... so swop in tl084 define as part of cell with VCA - so 3 of these + I/O mults etc...
2.1v for fixed comp
collector

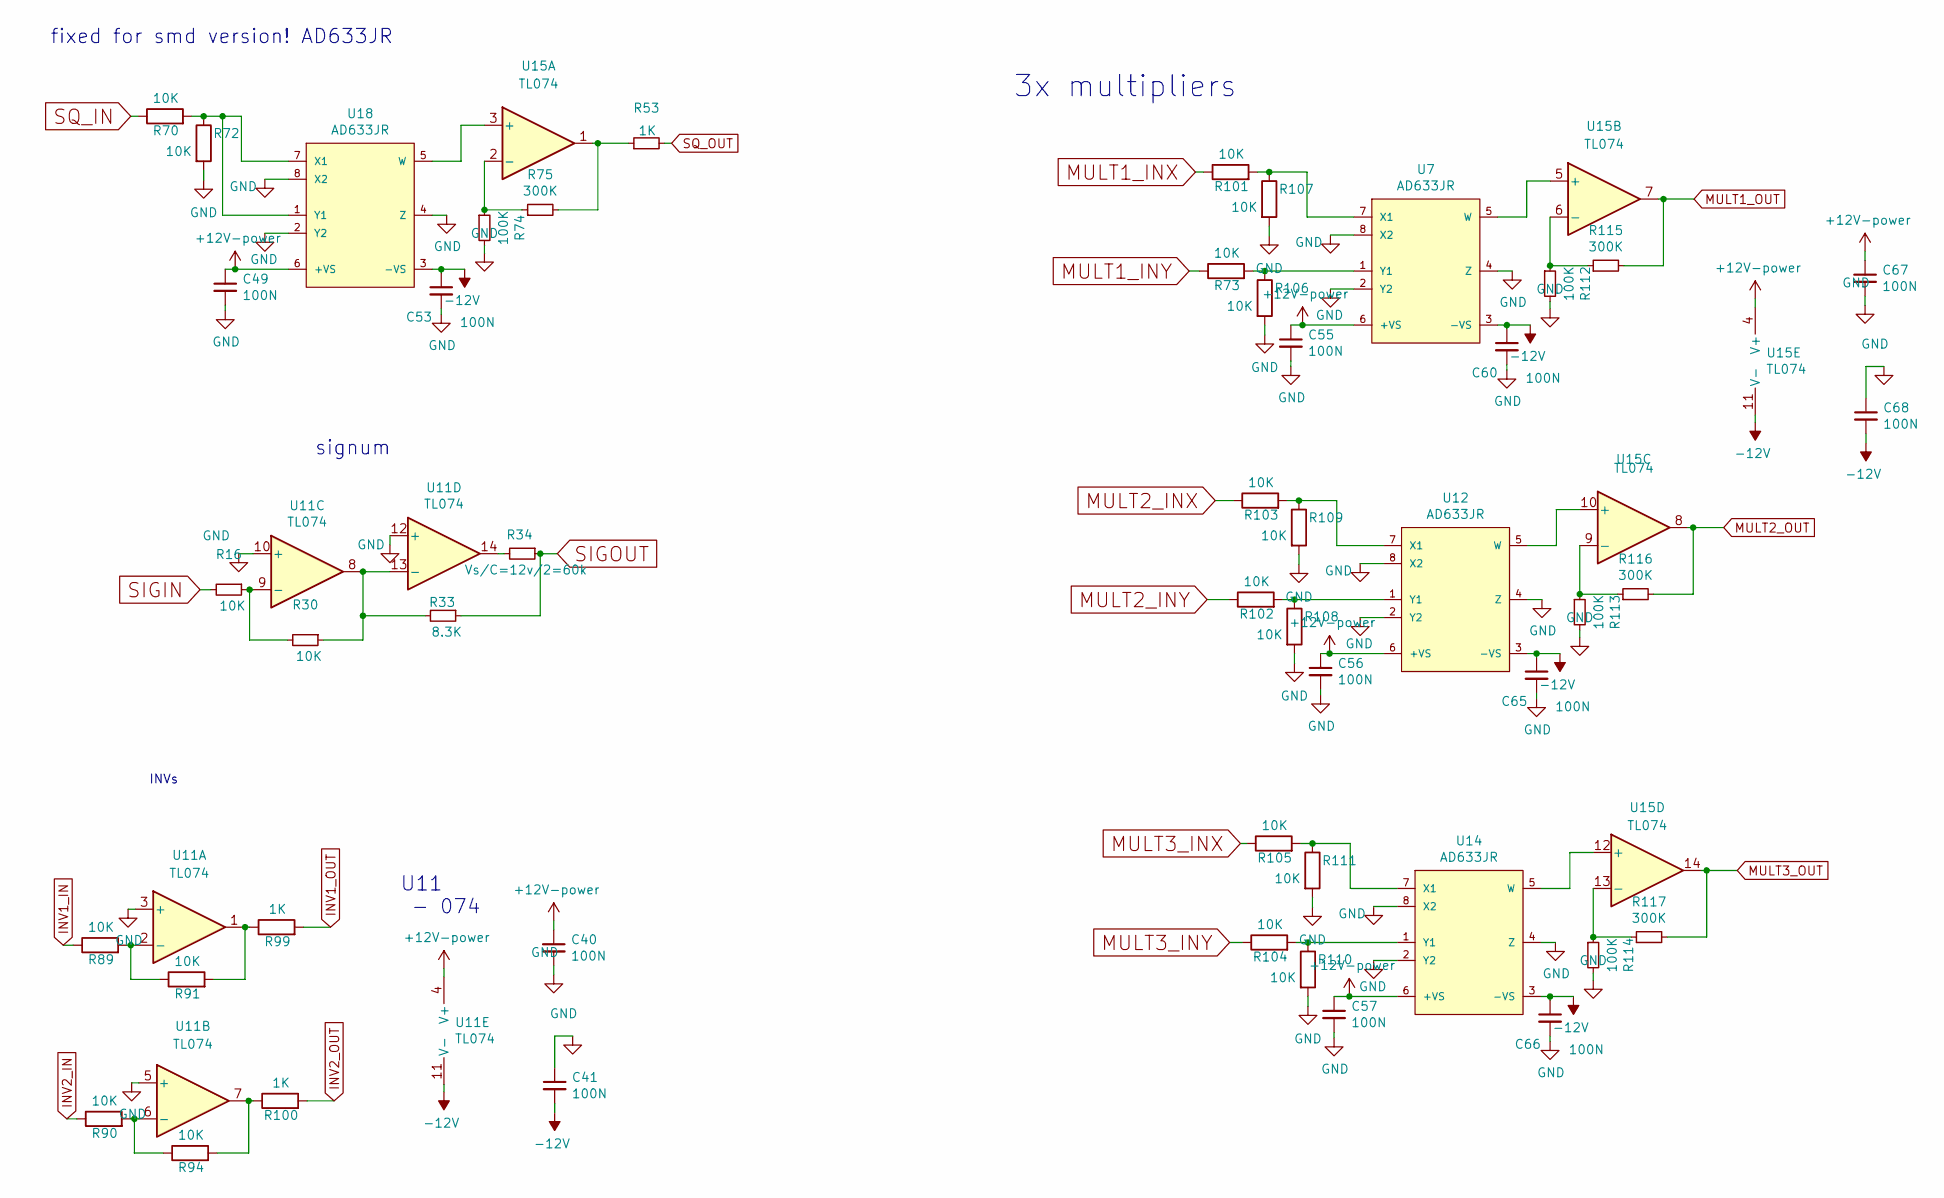
[picture p55: schematic anlog.kicad_sch]

Parts:
C40, C41, C49, C53, C55, C56, C57, C60, C65, C66, C67, C68: 100N; C_0805_2012Metric
R16, R30, R70, R72, R73, R89, R90, R91, R94, R101, R102, R103, R104, R105, R106, R107, R108, R109, R110, R111: 10K; R_0805_2012Metric
R33: 8.3K; R_0805_2012Metric
R34: Vs/C=12v/2=60k; R_0805_2012Metric
R53, R99, R100: 1K; R_0805_2012Metric
R74, R112, R113, R114: 100K; R_0805_2012Metric
R75, R115, R116, R117: 300K; R_0805_2012Metric
U7, U12, U14, U18: AD633JR; SOIC-8_3.9x4.9mm_P1.27mm
U11, U15: TL074; SOIC-14_3.9x8.7mm_P1.27mm

Connections:
-12V: C41.2, C53.1, C60.1, C65.1, C66.1, C68.2, U7.3 (-VS), U11.11 (V-), U12.3 (-VS), U14.3 (-VS), U15.11 (V-), U18.3 (-VS); also elsewhere on the board
GND: C40.2, C41.1, C49.2, C53.2, C55.2, C56.2, C57.2, C60.2, C65.2, C66.2, C67.2, C68.1, R72.2, R74.2, R106.2, R107.2, R108.2, R109.2, R110.2, R111.2, R112.2, R113.2, R114.2, U7.2 (Y2), U7.4 (Z), U7.8 (X2), U11.3 (+), U11.5 (+), U11.10 (+), U11.12 (+), U12.2 (Y2), U12.4 (Z), U12.8 (X2), U14.2 (Y2), U14.4 (Z), U14.8 (X2), U18.2 (Y2), U18.4 (Z), U18.8 (X2); also elsewhere on the board
INV1_IN: R89.1; also elsewhere on the board
INV1_OUT: R99.2; also elsewhere on the board
INV2_IN: R90.1; also elsewhere on the board
INV2_OUT: R100.2; also elsewhere on the board
MULT1_INX: R101.1; also elsewhere on the board
MULT1_INY: R73.1; also elsewhere on the board
MULT1_OUT: R115.2, U15.7; also elsewhere on the board
MULT2_INX: R103.1; also elsewhere on the board
MULT2_INY: R102.1; also elsewhere on the board
MULT2_OUT: R116.2, U15.8; also elsewhere on the board
MULT3_INX: R105.1; also elsewhere on the board
MULT3_INY: R104.1; also elsewhere on the board
MULT3_OUT: R117.2, U15.14; also elsewhere on the board
unnamed: R16.1, R30.2, U11.9 (-)
unnamed: R30.1, R33.2, U11.8, U11.13 (-)
unnamed: R34.2, U11.14
unnamed: R53.1, R75.2, U15.1
unnamed: R70.2, R72.1, U18.1 (Y1), U18.7 (X1)
unnamed: R74.1, R75.1, U15.2 (-)
unnamed: R89.2, R91.1, U11.2 (-)
unnamed: R90.2, R94.1, U11.6 (-)
unnamed: R91.2, R99.1, U11.1
unnamed: R94.2, R100.1, U11.7
unnamed: R101.2, R107.1, U7.7 (X1)
unnamed: R102.2, R108.1, U12.1 (Y1)
unnamed: R103.2, R109.1, U12.7 (X1)
unnamed: R104.2, R110.1, U14.1 (Y1)
unnamed: R105.2, R111.1, U14.7 (X1)
unnamed: R73.2, R106.1, U7.1 (Y1)
unnamed: R112.1, R115.1, U15.6 (-)
unnamed: R113.1, R116.1, U15.9 (-)
unnamed: R114.1, R117.1, U15.13 (-)
unnamed: U12.5 (W), U15.10 (+)
unnamed: U14.5 (W), U15.12 (+)
unnamed: U15.3 (+), U18.5 (W)
unnamed: U7.5 (W), U15.5 (+)
SIGIN: R16.2; also elsewhere on the board
SIGOUT: R33.1, R34.1; also elsewhere on the board
SQ_IN: R70.1; also elsewhere on the board
SQ_OUT: R53.2; also elsewhere on the board

Notes on the sheet:
U11 - 074
3x multipliers
INVs
fixed for smd version! AD633JR
signum

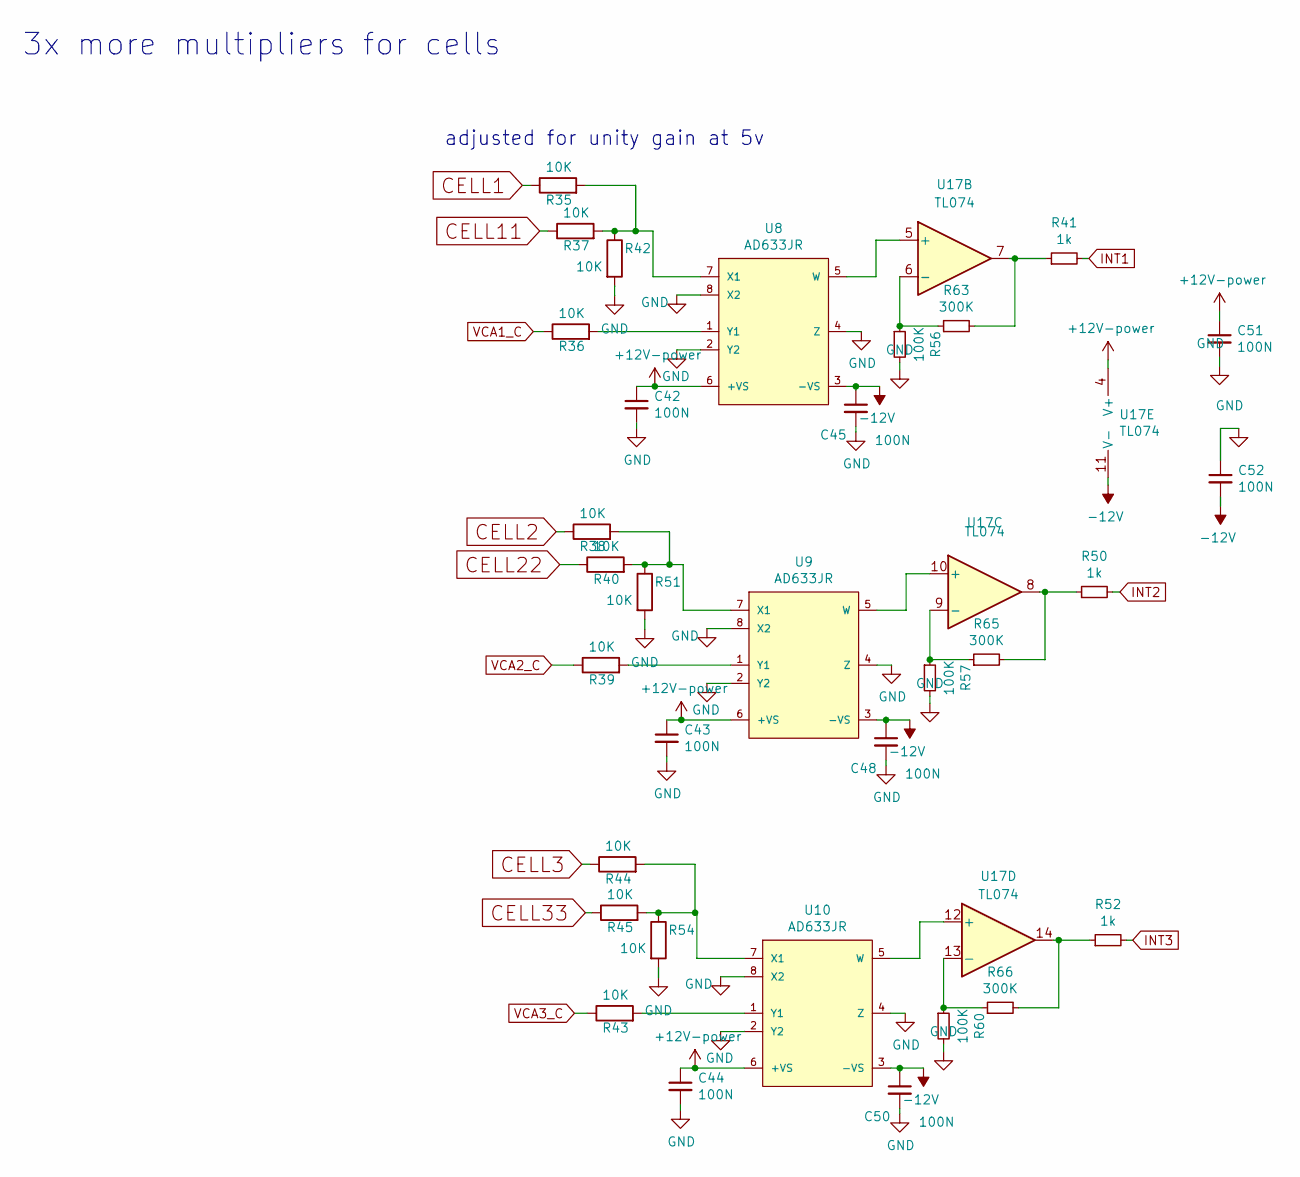
[picture p56: schematic cellmults.kicad_sch]

Parts:
C42, C43, C44, C45, C48, C50, C51, C52: 100N; C_0805_2012Metric
R35, R36, R37, R38, R39, R40, R42, R43, R44, R45, R51, R54: 10K; R_0805_2012Metric
R41, R50, R52: 1k; R_0805_2012Metric
R56, R57, R60: 100K; R_0805_2012Metric
R63, R65, R66: 300K; R_0805_2012Metric
U8, U9, U10: AD633JR; SOIC-8_3.9x4.9mm_P1.27mm
U17: TL074; SOIC-14_3.9x8.7mm_P1.27mm

Connections:
-12V: C45.1, C48.1, C50.1, C52.2, U8.3 (-VS), U9.3 (-VS), U10.3 (-VS), U17.11 (V-); also elsewhere on the board
CELL1: R35.1; also elsewhere on the board
CELL2: R38.1; also elsewhere on the board
CELL3: R44.1; also elsewhere on the board
CELL11: R37.1; also elsewhere on the board
CELL22: R40.1; also elsewhere on the board
CELL33: R45.1; also elsewhere on the board
GND: C42.2, C43.2, C44.2, C45.2, C48.2, C50.2, C51.2, C52.1, R42.2, R51.2, R54.2, R56.2, R57.2, R60.2, U8.2 (Y2), U8.4 (Z), U8.8 (X2), U9.2 (Y2), U9.4 (Z), U9.8 (X2), U10.2 (Y2), U10.4 (Z), U10.8 (X2); also elsewhere on the board
INT1: R41.2; also elsewhere on the board
INT2: R50.2; also elsewhere on the board
INT3: R52.2; also elsewhere on the board
unnamed: R35.2, R37.2, R42.1, U8.7 (X1)
unnamed: R36.2, U8.1 (Y1)
unnamed: R38.2, R40.2, R51.1, U9.7 (X1)
unnamed: R39.2, U9.1 (Y1)
unnamed: R41.1, R63.2, U17.7
unnamed: R43.2, U10.1 (Y1)
unnamed: R44.2, R45.2, R54.1, U10.7 (X1)
unnamed: R50.1, R65.2, U17.8
unnamed: R52.1, R66.2, U17.14
unnamed: R56.1, R63.1, U17.6 (-)
unnamed: R57.1, R65.1, U17.9 (-)
unnamed: R60.1, R66.1, U17.13 (-)
unnamed: U10.5 (W), U17.12 (+)
unnamed: U8.5 (W), U17.5 (+)
unnamed: U9.5 (W), U17.10 (+)
VCA1_C: R36.1; also elsewhere on the board
VCA2_C: R39.1; also elsewhere on the board
VCA3_C: R43.1; also elsewhere on the board

Notes on the sheet:
adjusted for unity gain at 5v
3x more multipliers for cells
