microresearch/allcolours/TOAD/FINAL_FINAL/toad2.kicad_pcb

## KiCad design TOAD/FINAL_FINAL/toad2.kicad_pcb (continued)

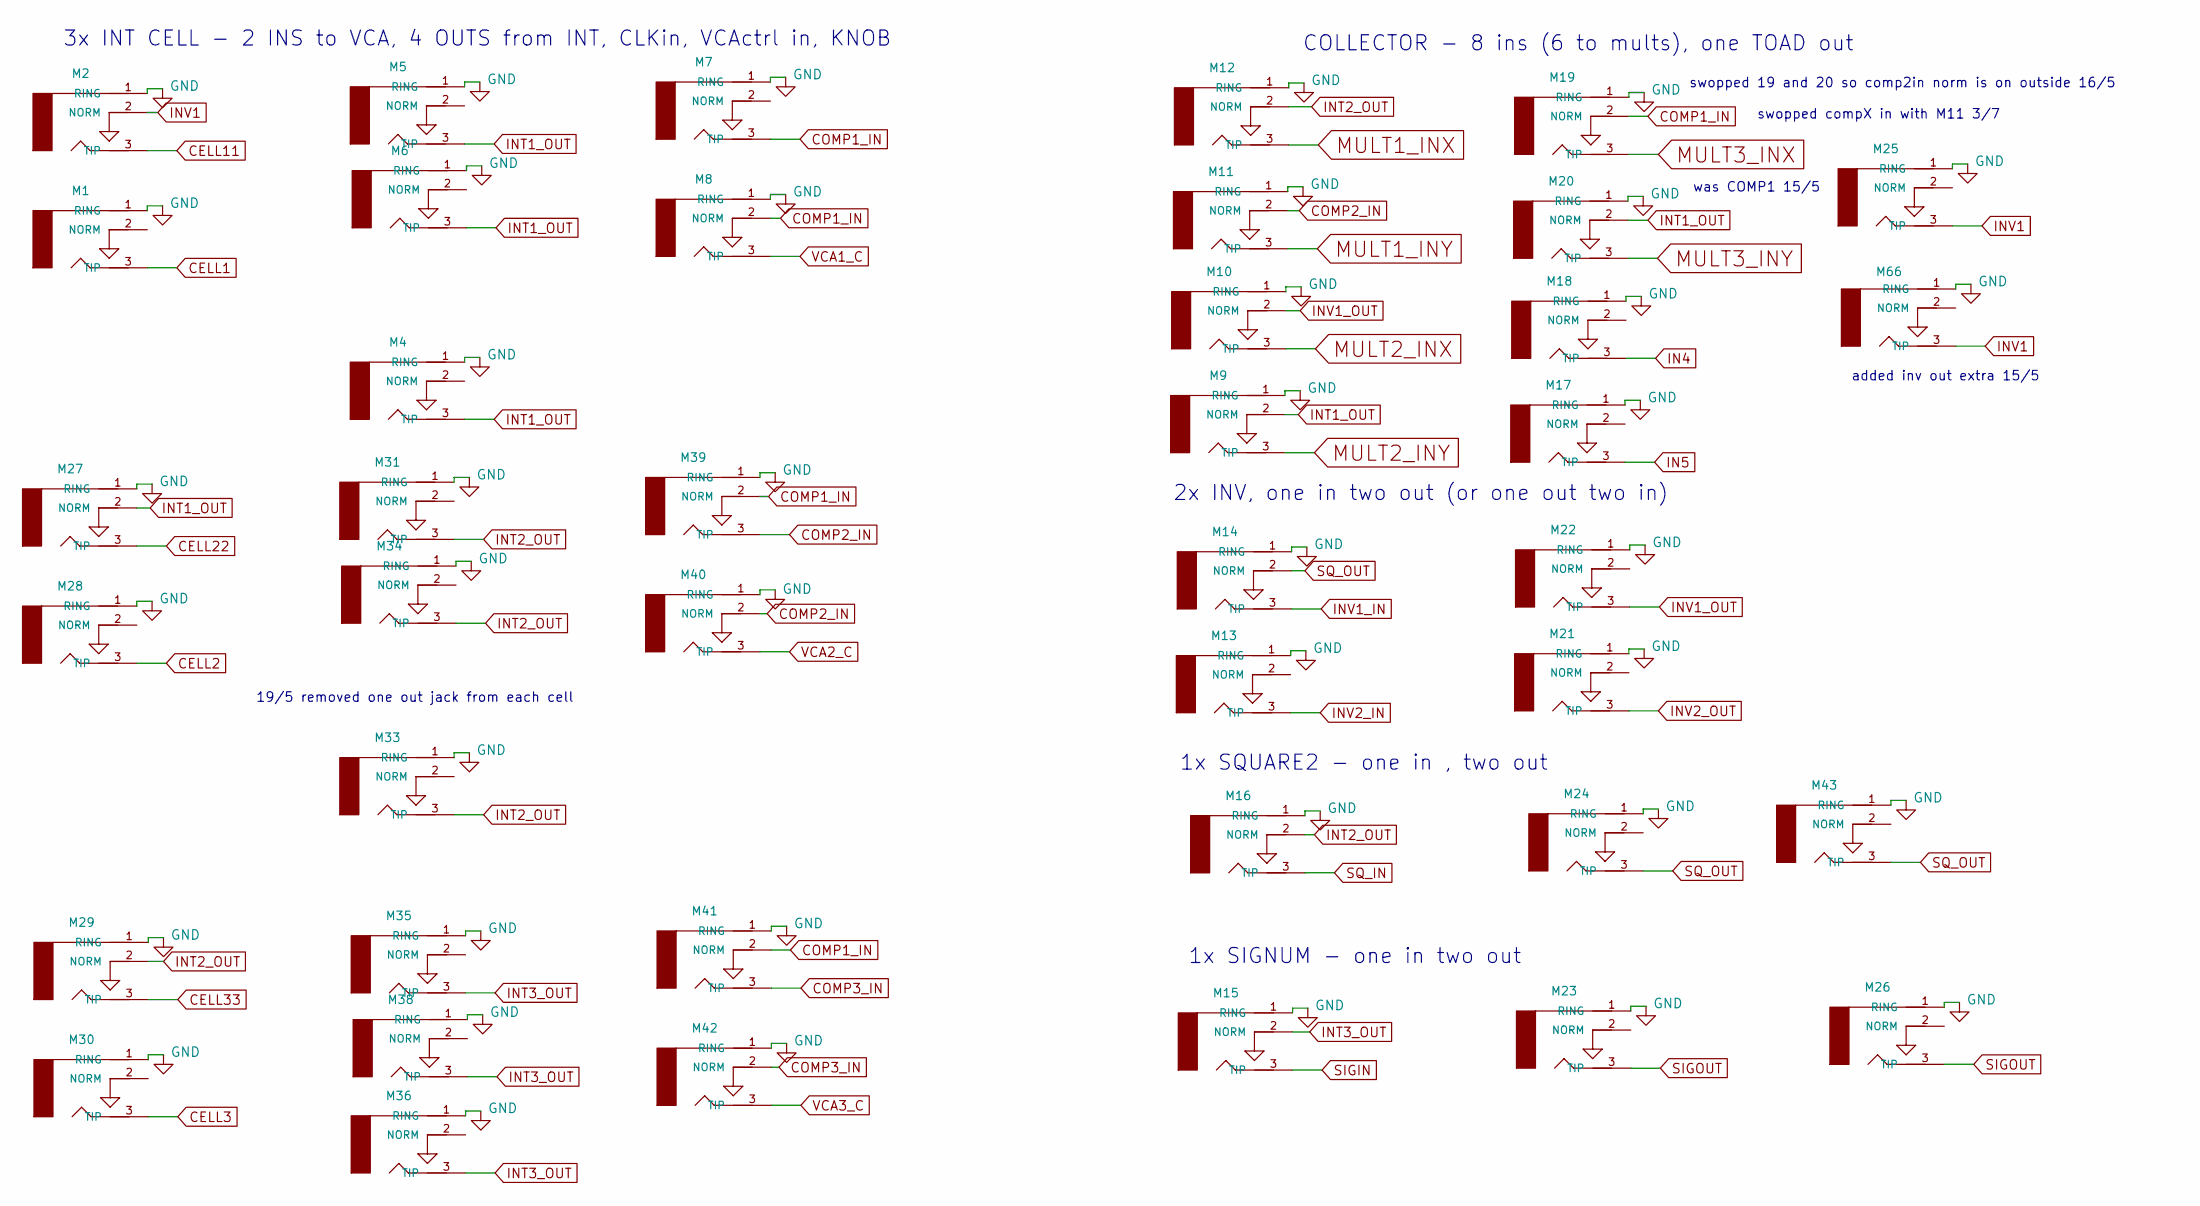
[picture p57: schematic IO.kicad_sch]

Parts:
M1, M2, M4, M5, M6, M7, M8, M9, M10, M11, M12, M13, M14, M15, M16, M17, M18, M19, M20, M21, M22, M23, M24, M25, M26, M27, M28, M29, M30, M31, M33, M34, M35, M36, M38, M39, M40, M41, M42, M43, M66: AUDIO-JACKERTHENVAR-PJ398-allcolours-rescue; Jack_3.5mm_QingPu_WQP-PJ398SM_Vertical_CircularHoles

Connections:
CELL1: M1.3 (TIP); also elsewhere on the board
CELL2: M28.3 (TIP); also elsewhere on the board
CELL3: M30.3 (TIP); also elsewhere on the board
CELL11: M2.3 (TIP); also elsewhere on the board
CELL22: M27.3 (TIP); also elsewhere on the board
CELL33: M29.3 (TIP); also elsewhere on the board
COMP1_IN: M7.3 (TIP), M8.2 (NORM), M19.2 (NORM), M39.2 (NORM), M41.2 (NORM); also elsewhere on the board
COMP2_IN: M11.2 (NORM), M39.3 (TIP), M40.2 (NORM); also elsewhere on the board
COMP3_IN: M41.3 (TIP), M42.2 (NORM); also elsewhere on the board
GND: M1.1 (RING), M2.1 (RING), M4.1 (RING), M5.1 (RING), M6.1 (RING), M7.1 (RING), M8.1 (RING), M9.1 (RING), M10.1 (RING), M11.1 (RING), M12.1 (RING), M13.1 (RING), M14.1 (RING), M15.1 (RING), M16.1 (RING), M17.1 (RING), M18.1 (RING), M19.1 (RING), M20.1 (RING), M21.1 (RING), M22.1 (RING), M23.1 (RING), M24.1 (RING), M25.1 (RING), M26.1 (RING), M27.1 (RING), M28.1 (RING), M29.1 (RING), M30.1 (RING), M31.1 (RING), M33.1 (RING), M34.1 (RING), M35.1 (RING), M36.1 (RING), M38.1 (RING), M39.1 (RING), M40.1 (RING), M41.1 (RING), M42.1 (RING), M43.1 (RING), M66.1 (RING); also elsewhere on the board
IN4: M18.3 (TIP); also elsewhere on the board
IN5: M17.3 (TIP); also elsewhere on the board
INT1_OUT: M4.3 (TIP), M5.3 (TIP), M6.3 (TIP), M9.2 (NORM), M20.2 (NORM), M27.2 (NORM); also elsewhere on the board
INT2_OUT: M12.2 (NORM), M16.2 (NORM), M29.2 (NORM), M31.3 (TIP), M33.3 (TIP), M34.3 (TIP); also elsewhere on the board
INT3_OUT: M15.2 (NORM), M35.3 (TIP), M36.3 (TIP), M38.3 (TIP); also elsewhere on the board
INV1: M2.2 (NORM), M25.3 (TIP), M66.3 (TIP); also elsewhere on the board
INV1_IN: M14.3 (TIP); also elsewhere on the board
INV1_OUT: M10.2 (NORM), M22.3 (TIP); also elsewhere on the board
INV2_IN: M13.3 (TIP); also elsewhere on the board
INV2_OUT: M21.3 (TIP); also elsewhere on the board
MULT1_INX: M12.3 (TIP); also elsewhere on the board
MULT1_INY: M11.3 (TIP); also elsewhere on the board
MULT2_INX: M10.3 (TIP); also elsewhere on the board
MULT2_INY: M9.3 (TIP); also elsewhere on the board
MULT3_INX: M19.3 (TIP); also elsewhere on the board
MULT3_INY: M20.3 (TIP); also elsewhere on the board
SIGIN: M15.3 (TIP); also elsewhere on the board
SIGOUT: M23.3 (TIP), M26.3 (TIP); also elsewhere on the board
SQ_IN: M16.3 (TIP); also elsewhere on the board
SQ_OUT: M14.2 (NORM), M24.3 (TIP), M43.3 (TIP); also elsewhere on the board
VCA1_C: M8.3 (TIP); also elsewhere on the board
VCA2_C: M40.3 (TIP); also elsewhere on the board
VCA3_C: M42.3 (TIP); also elsewhere on the board

Notes on the sheet:
was COMP1 15/5
1x SQUARE2 - one in , two out
1x SIGNUM - one in two out
COLLECTOR - 8 ins (6 to mults), one TOAD out
19/5 removed one out jack from each cell
swopped 19 and 20 so comp2in norm is on outside 16/5
swopped compX in with M11 3/7
2x INV, one in two out (or one out two in)
added inv out extra 15/5
3x INT CELL - 2 INS to VCA, 4 OUTS from INT, CLKin, VCActrl in, KNOB

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
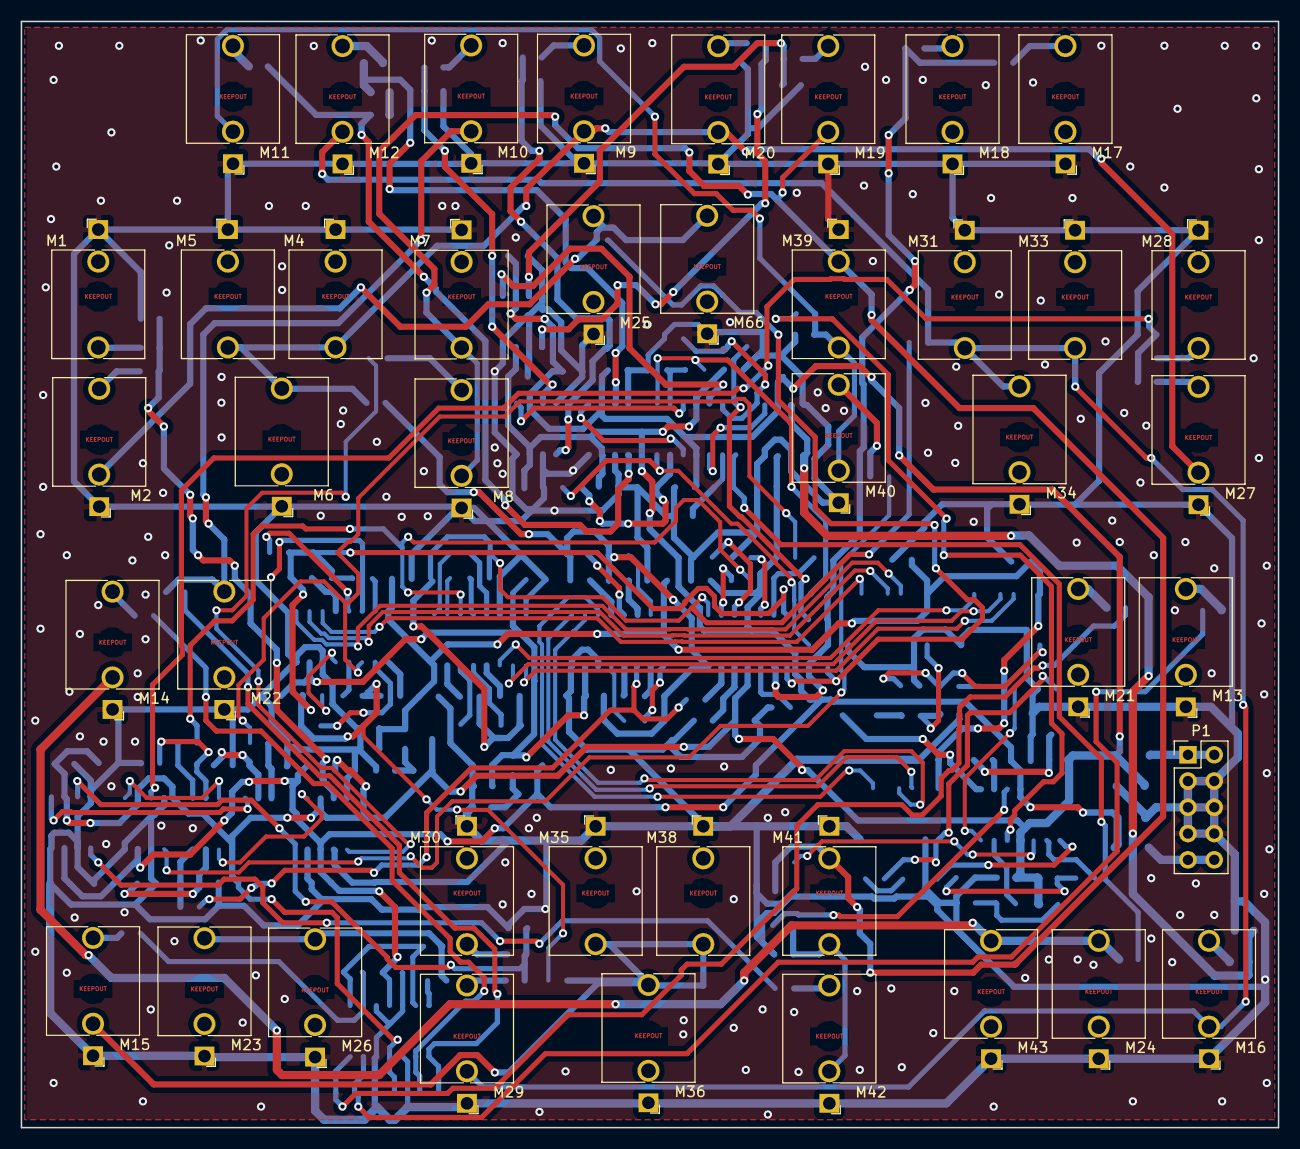
[picture p58: board toad2.kicad_pcb from above]

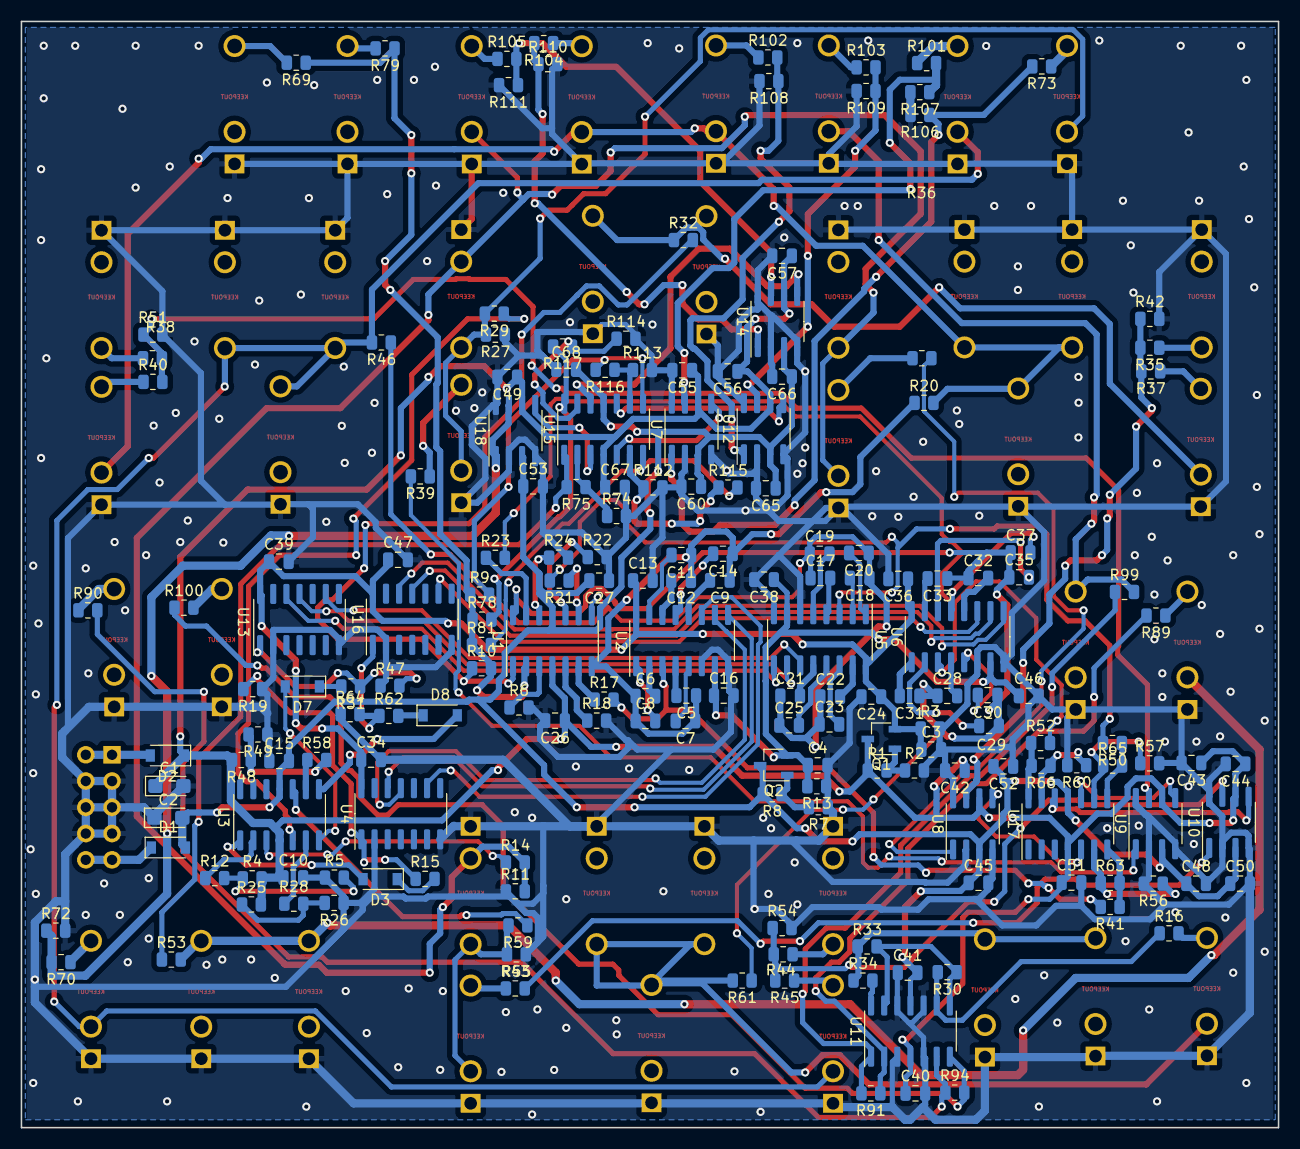
[picture p59: board toad2.kicad_pcb from below]

Board: 2 copper layers, 121.6 x 107.0 mm, 226 parts (184 on the bottom side), 148 nets.
