microresearch/allcolours/SR_segments/segments_fixed_adc/segments.kicad_pcb

## KiCad design SR_segments/segments_fixed_adc/segments.kicad_pcb (2023-04-05)

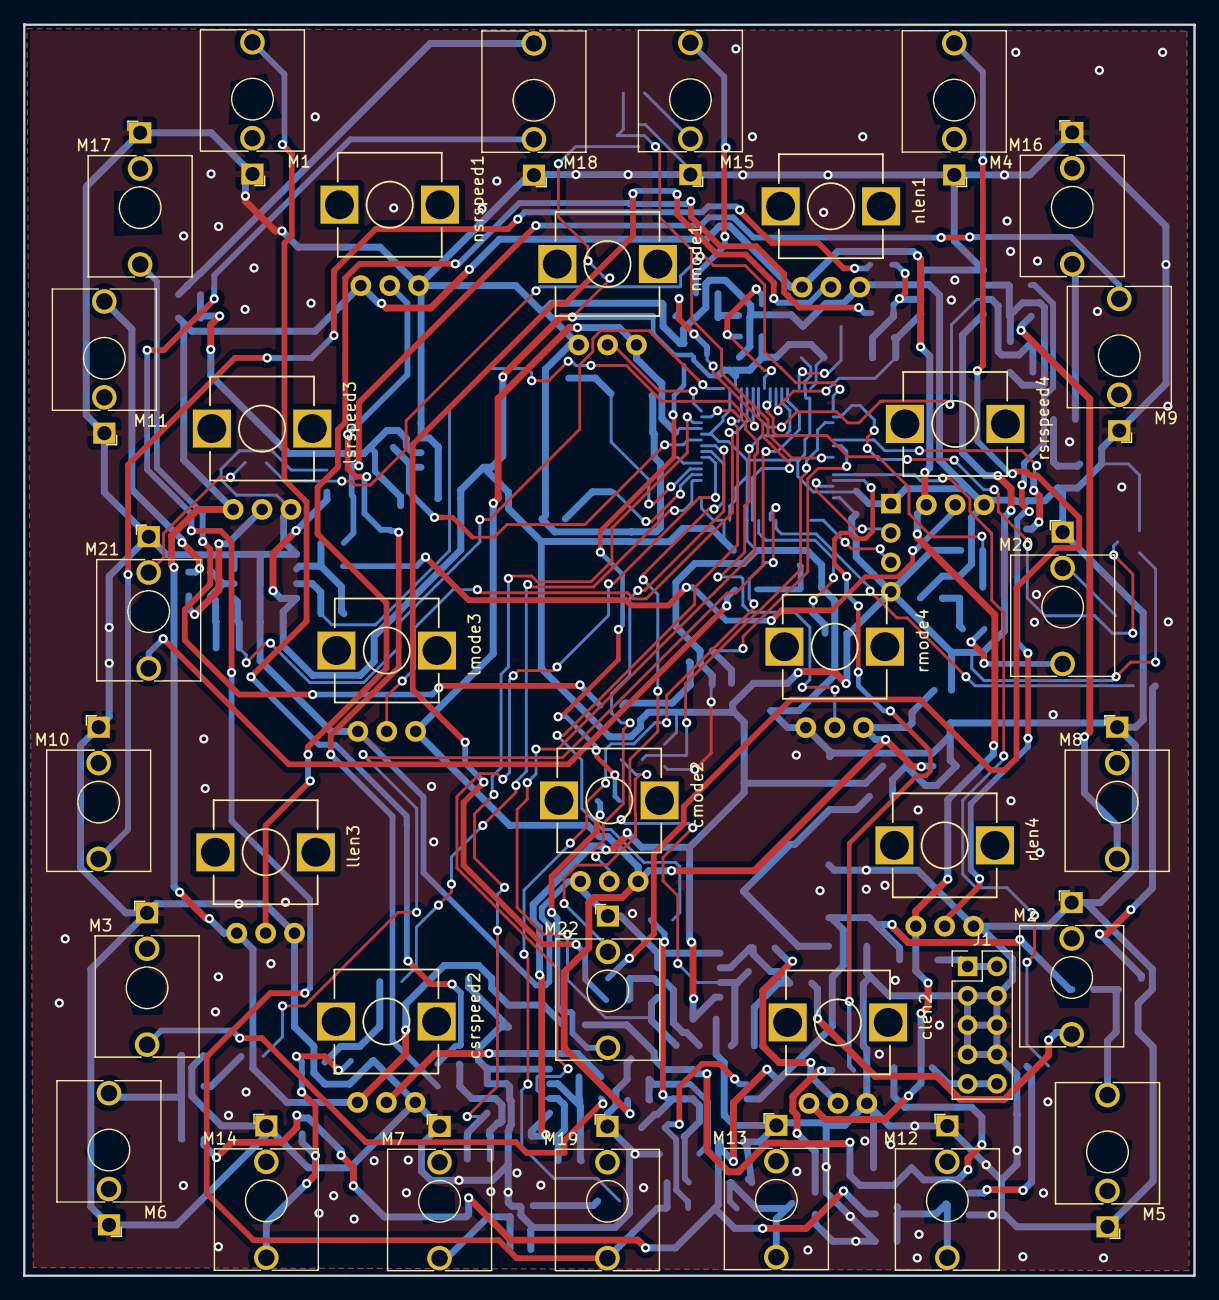
[picture p60: board segments.kicad_pcb from above]

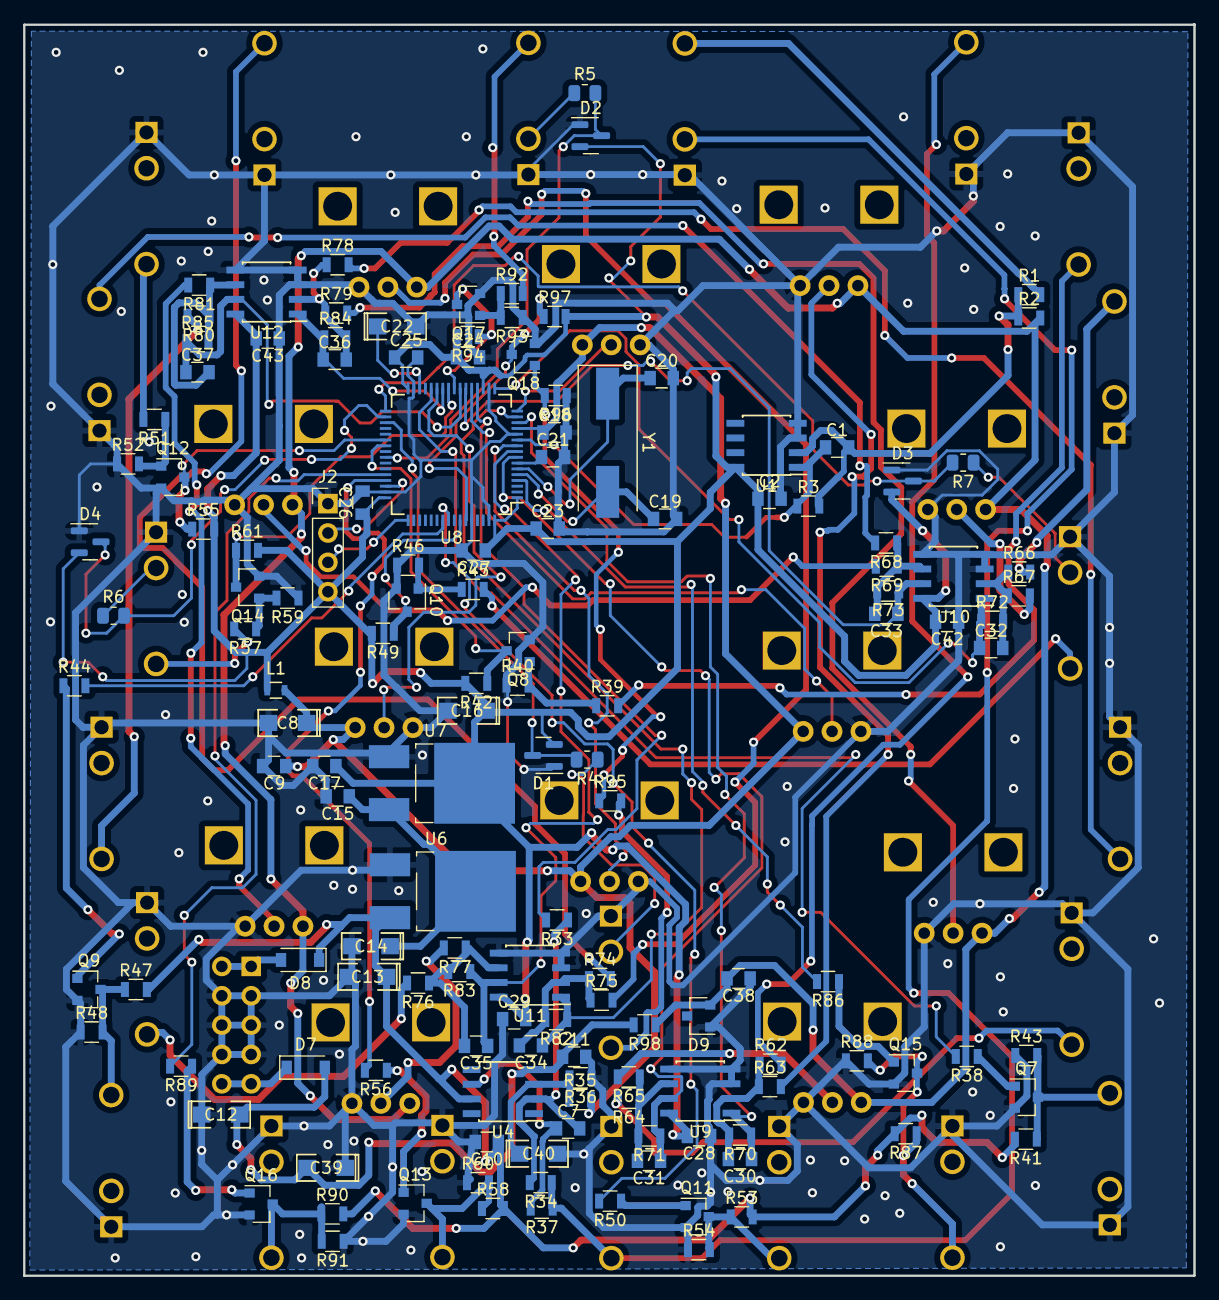
[picture p61: board segments.kicad_pcb from below]

Board: 2 copper layers, 101.3 x 108.3 mm, 177 parts (142 on the bottom side), 102 nets.

Parts:
C1: 10pF; C_0805
C2, C9, C10, C11, C15, C17, C18, C21, C23, C24, C25, C26, C27: 100nF; C_0805
C7: 47pF; C_0805
C8, C12, C13, C14, C16, C39: 10uF; SMD-1206_Pol1.4mmnew
C19, C20: 18pF; C_0805
C22: 4.7uF; SMD-1206_Pol1.4mmnew
C28, C29, C38, C42, C43: 100N; C_0805
C30, C31, C32, C33, C34, C35, C36, C37: 1nF; C_0805
C40: 1uF; SMD-1206_Pol1.4mmnew
D1, D2, D3, D4: BAT54S; SOT-23
D7, D8: D; D_SOD-123
D9: LM4040; SOT-23
J1: Conn_02x05_Odd_Even; Pin_Header_Straight_2x05_Pitch2.54mm
J2: prog; Pin_Header_Straight_1x04_Pitch2.54mm
L1: IND; L_0603
M1, M2, M3, M4, M5, M6, M7, M8, M9, M10, M11, M12, M13, M14, M15, M16, M17, M18, M19, M20, M21, M22: AUDIO-JACKERTHENVAR; Jack_3.5mm_QingPu_WQP-PJ398SM_Vertical_CircularHoles
Q7, Q8, Q9, Q10, Q11, Q12, Q13, Q14, Q15, Q16, Q17, Q18: MMBT3904; SOT-23
R1, R36, R39, R45, R51, R57, R62, R64, R66, R68, R74, R76, R78, R80, R92, R95: 100K; R_0805
R2: 390K; R_0805
R3, R70, R71, R72, R73, R82, R83, R84, R85: 66.5K; R_0805
R4, R5, R6, R7: 10K; R_0805_2012Metric
R33: 20K; R_0805
R34: 33K; R_0805
R35: 130K; R_0805
R37, R41, R43, R47, R48, R53, R54, R58, R60, R87, R88, R90, R91: 1K; R_0805
R38, R42, R44, R49, R50, R55, R56, R61, R86, R89, R94, R97: 10K; R_0805
R40, R46, R52, R59, R93, R96: 1M; R_0805
R63, R65, R67, R69, R75, R77, R79, R81: 200K; R_0805
R98: 100R; R_0805
U1, U9, U10, U11, U12: MCP6002; SOIC-8_3.9x4.9mm_Pitch1.27mm
U4: TL071/TLV172; SOIC-8_3.9x4.9mm_Pitch1.27mm
U6: LM1117-5.0; TO-252-2_Rectifier
U7: LM1117-3.3; TO-252-2_Rectifier
U8: STM32F446RETx; LQFP-64_10x10mm_Pitch0.5mm
Y1: 8MHz; Crystal_SMD_HC49-SD
clen2: 10K; Potentiometer_Alps-RK09
cmode2: 10K; Potentiometer_Alps-RK09
csrspeed2: 10K; Potentiometer_Alps-RK09
llen3: 10K; Potentiometer_Alps-RK09
lmode3: 10K; Potentiometer_Alps-RK09
lsrspeed3: 10K; Potentiometer_Alps-RK09
nlen1: 10K; Potentiometer_Alps-RK09
nmode1: 10K; Potentiometer_Alps-RK09
nsrspeed1: 10K; Potentiometer_Alps-RK09
rlen4: 10K; Potentiometer_Alps-RK09
rmode4: 10K; Potentiometer_Alps-RK09
rsrspeed4: 10K; Potentiometer_Alps-RK09

Connections:
5volts: C14.1, C15.1, U6.2 (VO), U7.3 (VI)
+3.3VA: C8.1, C9.1, C18.1, L1.2, R35.2, U8.13 (VDDA), cmode2.3, lmode3.3, nmode1.3, rmode4.3
+3V3: C2.1, C16.1, C17.1, C23.1, C24.1, C25.1, C26.1, C27.1, C28.2, C29.2, C42.2, C43.2, D1.2, D2.2, D3.2, D4.2, J2.4, L1.1, R42.2, R49.2, R55.2, R61.2, R94.2, R97.2, U1.8 (V+), U7.2 (VO), U8.1 (VBAT), U8.19 (VDD), U8.32 (VDD), U8.48 (VDD), U8.64 (VDD), U9.8 (V+), U10.8 (V+), U11.8 (V+), U12.8 (V+)
+12V: C10.1, C13.1, D8.1 (K), R41.2, R47.2, R53.2, R58.2, R87.2, R90.2, U4.7 (V+), U6.3 (VI)
-12V: C11.1, C12.2, C39.2, D7.2 (A), R98.2, U4.4 (V-)
/micro/SWCLK: J2.3, U8.49 (PA14)
/micro/SWDIO: J2.2, U8.46 (PA13)
ADC0: C30.1, R70.1, U8.14 (PA0), U9.1
ADC1: C34.1, R82.1, U8.15 (PA1), U11.1
ADC2: U8.16 (PA2), nmode1.2
ADC3: C32.1, R72.1, U8.17 (PA3), U10.1
ADC4: C36.1, R84.1, U8.26 (PB0), U12.1
ADC5: U8.21 (PA5), lmode3.2
ADC6: C33.1, R73.1, U8.22 (PA6), U10.7
ADC7: C37.1, R85.1, U8.23 (PA7), U12.7
ADC8: U8.27 (PB1), rmode4.2
ADC9: C31.1, R71.1, U8.8 (PC0), U9.7
ADC10: C35.1, R83.1, U8.9 (PC1), U11.7
ADC11: U8.10 (PC2), cmode2.2
ADC12: C1.1, R3.1, U1.1, U8.11 (PC3)
ADC_IN: M18.3 (TIP), R1.2
AREF-10: C38.2, D9.2 (A), R2.2, R98.1, clen2.1, csrspeed2.1, llen3.1, lsrspeed3.1, nlen1.1, nsrspeed1.1, rlen4.1, rsrspeed4.1
CLEN_IN: M2.3 (TIP), R76.2
CSPEED_IN: M3.3 (TIP), R64.2
CSRCLK: M22.3 (TIP), R95.2
CSRCLKIN: Q18.3 (C), R97.1, U8.59 (PB7)
CSROUT1: M7.3 (TIP), Q11.3 (C), R53.1, R54.2
CSROUT2: M13.3 (TIP), Q13.3 (C), R58.1, R60.2
DAC_MC_OUT: R33.2, U8.20 (PA4)
DAC_OUT: M18.2 (NORM), M19.3 (TIP), R34.1, R37.1
GND: C2.2, C8.2, C9.2, C10.2, C11.2, C12.1, C13.2, C14.2, C15.2, C16.2, C17.2, C18.2, C19.2, C20.2, C21.2, C22.2, C23.2, C24.2, C25.2, C26.2, C27.2, C28.1, C29.1, C38.1, C39.1, C40.2, C42.1, C43.1, D1.1, D2.1, D3.1, D4.1, D9.1 (K), J1.3, J1.4, J1.5, J1.6, J1.7, J1.8, J2.1, M1.1 (RING), M2.1 (RING), M3.1 (RING), M4.1 (RING), M5.1 (RING), M6.1 (RING), M7.1 (RING), M8.1 (RING), M9.1 (RING), M10.1 (RING), M11.1 (RING), M12.1 (RING), M13.1 (RING), M14.1 (RING), M15.1 (RING), M16.1 (RING), M17.1 (RING), M18.1 (RING), M19.1 (RING), M20.1 (RING), M21.1 (RING), M22.1 (RING), Q7.2 (E), Q8.2 (E), Q9.2 (E), Q10.2 (E), Q11.2 (E), Q12.2 (E), Q13.2 (E), Q14.2 (E), Q15.2 (E), Q16.2 (E), Q17.2 (E), Q18.2 (E), R36.1, R40.1, R43.1, R46.1, R48.1, R52.1, R54.1, R59.1, R60.1, R88.1, R91.1, R93.1, R96.1, U1.3 (+), U1.4 (V-), U6.1 (GND), U7.1 (GND), U8.12 (VSSA), U8.18 (VSS), U8.31 (VSS), U8.47 (VSS), U8.60 (BOOT0), U8.63 (VSS), U9.3 (+), U9.4 (V-), U9.5 (+), U10.3 (+), U10.4 (V-), U10.5 (+), U11.3 (+), U11.4 (V-), U11.5 (+), U12.3 (+), U12.4 (V-), U12.5 (+), clen2.3, cmode2.1, csrspeed2.3, llen3.3, lmode3.1, lsrspeed3.3, nlen1.3, nmode1.1, nsrspeed1.3, rlen4.3, rmode4.1, rsrspeed4.3
LLEN_IN: M10.3 (TIP), R78.2
LSPEED_IN: M11.3 (TIP), R66.2
LSR: M17.3 (TIP), R39.2
LSRCLK: M21.3 (TIP), R45.2
LSRCLKIN: Q10.3 (C), R49.1, U8.58 (PB6)
LSRIN: Q8.3 (C), R42.1, U8.39 (PC8)
LSROUT1: M6.3 (TIP), Q7.3 (C), R41.1, R43.2
LSROUT2: M14.3 (TIP), Q15.3 (C), R87.1, R88.2
NLEN_IN: M4.3 (TIP), R74.2
NSPEED_IN: M1.3 (TIP), R62.2
NSRCLK: M15.3 (TIP), R92.2
NSRCLKIN: Q17.3 (C), R94.1, U8.24 (PC4)
unnamed: C1.2, R1.1, R2.1, R3.2, U1.2 (-)
unnamed: C7.1, R37.2, U4.6
unnamed: C7.2, R33.1, R34.2, U4.2 (-)
unnamed: C19.1, U8.5 (PH0), Y1.2
unnamed: C20.1, U8.6 (PH1), Y1.1
unnamed: C21.1, U8.7 (NRST)
unnamed: C22.1, U8.30 (VCAP_1)
unnamed: C30.2, R62.1, R63.1, R70.2, U9.2 (-)
unnamed: C31.2, R64.1, R65.1, R71.2, U9.6 (-)
unnamed: C32.2, R66.1, R67.1, R72.2, U10.2 (-)
unnamed: C33.2, R68.1, R69.1, R73.2, U10.6 (-)
unnamed: C34.2, R74.1, R75.1, R82.2, U11.2 (-)
unnamed: C35.2, R76.1, R77.1, R83.2, U11.6 (-)
unnamed: C36.2, R78.1, R79.1, R84.2, U12.2 (-)
unnamed: C37.2, R80.1, R81.1, R85.2, U12.6 (-)
unnamed: C40.1, R35.1, R36.2, U4.3 (+)
unnamed: D7.1 (K), J1.9, J1.10
unnamed: D8.2 (A), J1.1, J1.2
unnamed: M20.2 (NORM), R6.1
unnamed: M21.2 (NORM), R7.1
unnamed: M22.2 (NORM), R4.1
unnamed: Q7.1 (B), R38.1
unnamed: Q8.1 (B), R39.1, R40.2
unnamed: Q9.1 (B), R44.1
unnamed: Q10.1 (B), R45.1, R46.2
unnamed: Q11.1 (B), R50.1
unnamed: Q12.1 (B), R51.1, R52.2
unnamed: Q13.1 (B), R56.1
unnamed: Q14.1 (B), R57.1, R59.2
unnamed: Q15.1 (B), R86.1
unnamed: Q16.1 (B), R89.1
unnamed: Q17.1 (B), R92.1, R93.2
unnamed: Q18.1 (B), R95.1, R96.2
unnamed: R63.2, nsrspeed1.2
unnamed: R65.2, csrspeed2.2
unnamed: R67.2, lsrspeed3.2
unnamed: R69.2, rsrspeed4.2
unnamed: R75.2, nlen1.2
unnamed: R77.2, clen2.2
unnamed: R79.2, llen3.2
unnamed: R81.2, rlen4.2
PULSE1OUT: R38.2, U8.28 (PB2)
PULSE2OUT: R44.2, U8.55 (PB3)
PULSE3OUT: R50.2, U8.56 (PB4)
PULSE4OUT: R56.2, U8.45 (PA12)
PULSE5OUT: R86.2, U8.4 (PC15)
PULSE6OUT: R89.2, U8.44 (PA11)
PULSE9OUT: D3.3, R7.2, U8.33 (PB12)
PULSE10OUT: D4.3, R6.2, U8.34 (PB13)
PULSE11OUT: D1.3, R4.2, U8.35 (PB14)
RLEN_IN: M8.3 (TIP), R80.2
RSPEED_IN: M9.3 (TIP), R68.2
RSR: M16.3 (TIP), R51.2
RSRCLK: M20.3 (TIP), R57.2
RSRCLKIN: Q14.3 (C), R61.1, U8.25 (PC5)
RSRIN: Q12.3 (C), R55.1, U8.38 (PC7)
RSROUT1: M5.3 (TIP), Q9.3 (C), R47.1, R48.2
RSROUT2: M12.3 (TIP), Q16.3 (C), R90.1, R91.2
TIM1_CH1: D2.3, R5.2, U8.41 (PA8)
