microresearch/allcolours/TOAD/testsother/testsother.kicad_pcb

## KiCad design TOAD/testsother/testsother.kicad_pcb (2022-11-04)

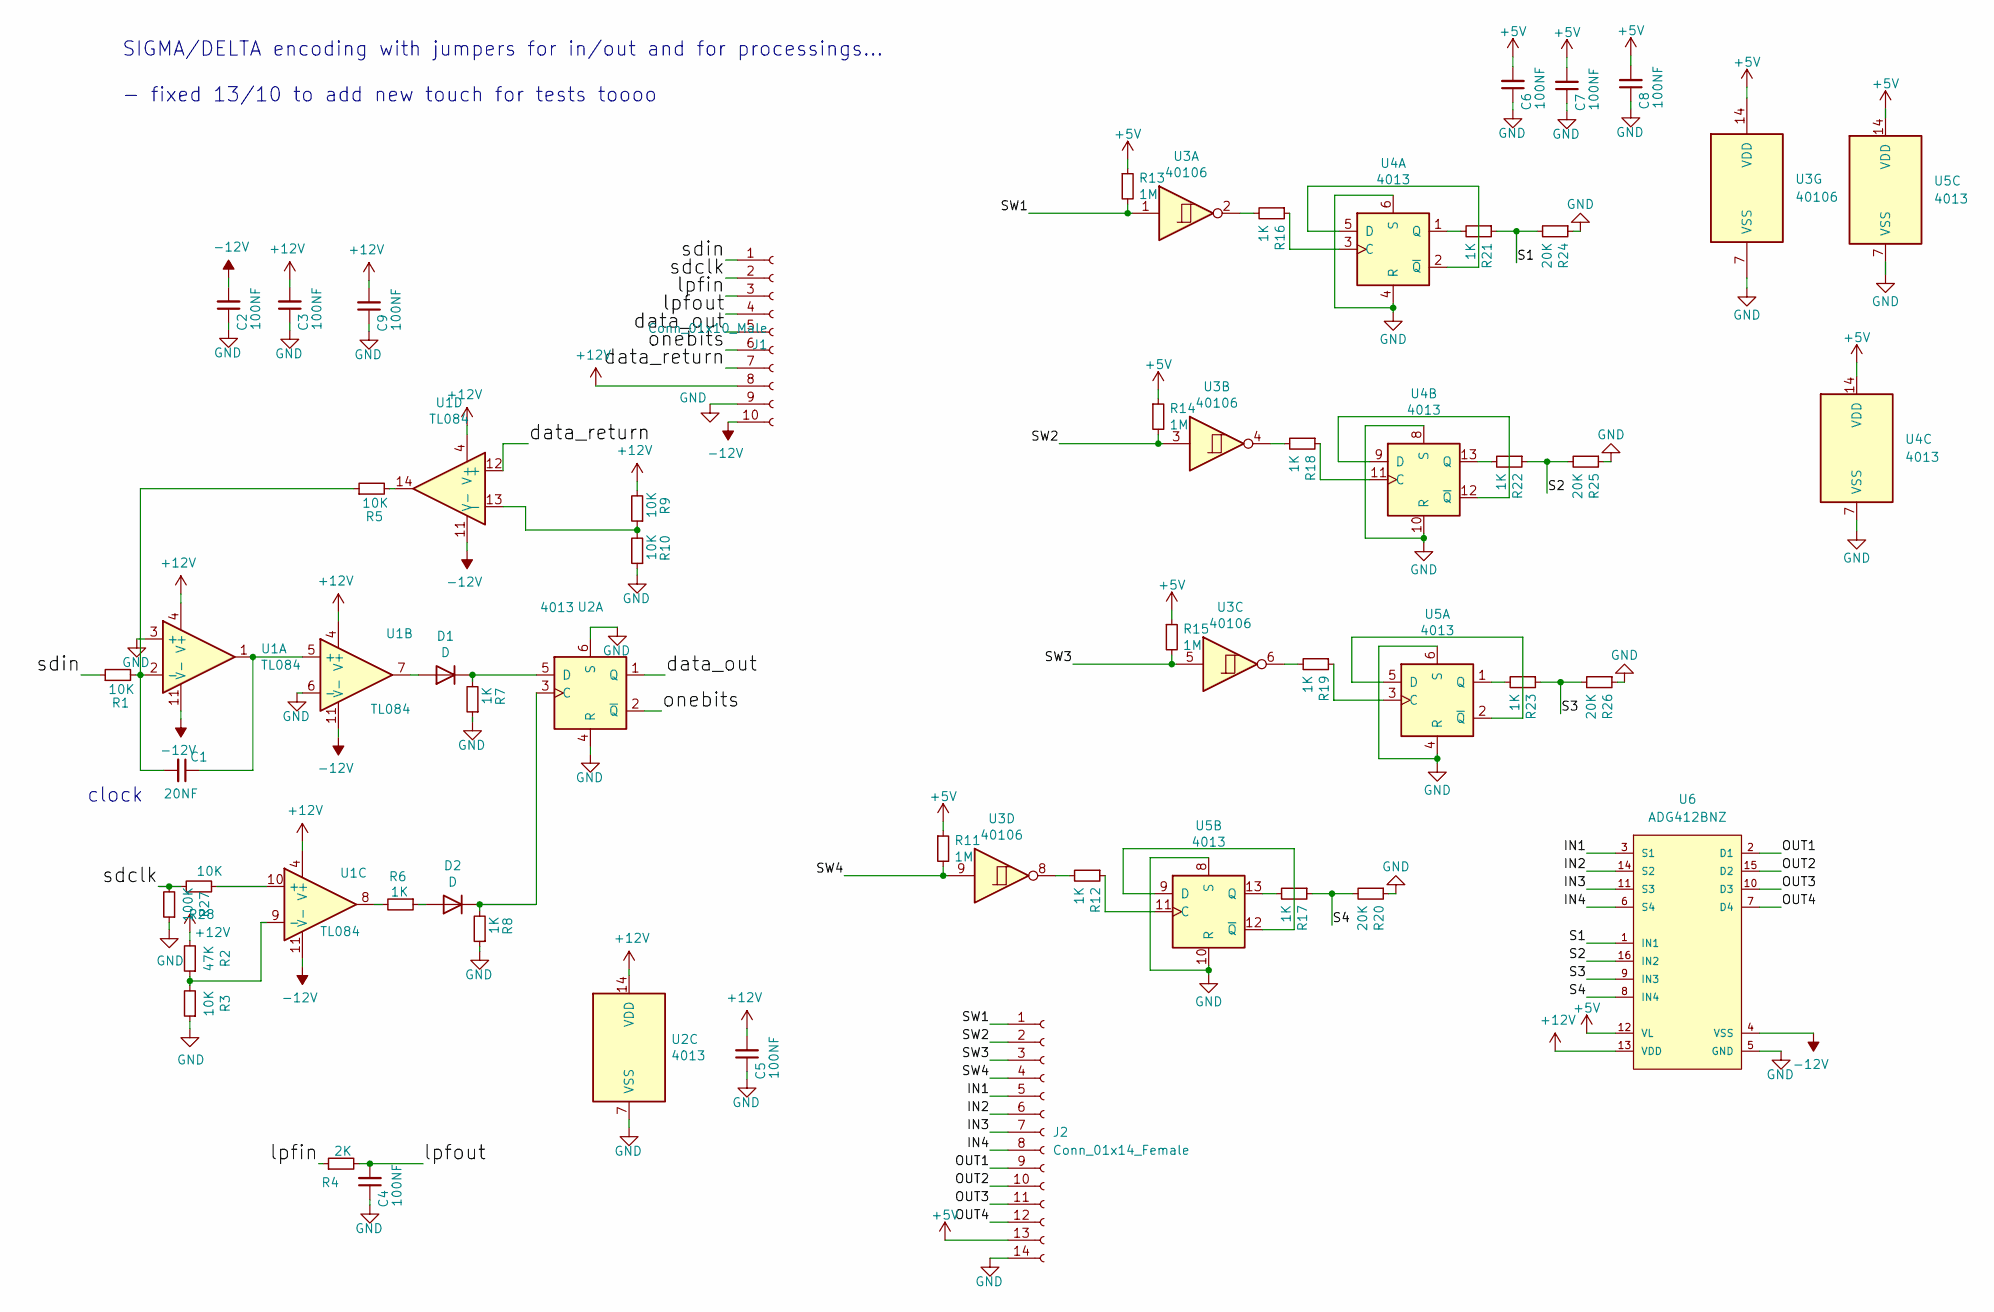
[picture p62: schematic testsother.kicad_sch]

Parts:
C1: 20NF; C_0805_2012Metric
C2, C3, C4, C5, C6, C7, C8, C9: 100NF; C_0805_2012Metric
D1, D2: D; D_SOD-123
J1: Conn_01x10_Male; PinHeader_1x10_P2.54mm_Vertical
J2: Conn_01x14_Female; PinHeader_1x14_P2.54mm_Vertical
R1, R3, R5, R9, R10, R28: 10K; R_0805_2012Metric
R2: 47K; R_0805_2012Metric
R4: 2K; R_0805_2012Metric
R6, R7, R8, R12, R16, R17, R18, R19, R21, R22, R23: 1K; R_0805_2012Metric
R11, R13, R14, R15: 1M; R_0805_2012Metric
R20, R24, R25, R26: 20K; R_0805_2012Metric
R27: 100K; R_0805_2012Metric
U1: TL084; SOIC-14_3.9x8.7mm_P1.27mm
U2, U4, U5: 4013; SOIC-14_3.9x8.7mm_P1.27mm
U3: 40106; SOIC-14_3.9x8.7mm_P1.27mm
U6: ADG412BNZ; SOIC-16_3.9x9.9mm_P1.27mm

Connections:
-12V: C2.2, J1.10, U1.11 (V-), U6.4 (VSS)
/IN1: J2.5, U6.3 (S1)
/IN2: J2.6, U6.14 (S2)
/IN3: J2.7, U6.11 (S3)
/IN4: J2.8, U6.6 (S4)
/OUT1: J2.9, U6.2 (D1)
/OUT2: J2.10, U6.15 (D2)
/OUT3: J2.11, U6.10 (D3)
/OUT4: J2.12, U6.7 (D4)
/S1: R21.1, R24.2, U6.1 (IN1)
/S2: R22.1, R25.2, U6.16 (IN2)
/S3: R23.1, R26.2, U6.9 (IN3)
/S4: R17.1, R20.2, U6.8 (IN4)
/SW1: J2.1, R13.2, U3.1
/SW2: J2.2, R14.2, U3.3
/SW3: J2.3, R15.2, U3.5
/SW4: J2.4, R11.2, U3.9
/data_out: J1.5, U2.1 (Q)
/data_return: J1.7, U1.12 (+)
/lpfin: J1.3, R4.1
/lpfout: C4.2, J1.4, R4.2
/onebits: J1.6, U2.2 (~Q)
/sdclk: J1.2, R27.2, R28.1
/sdin: J1.1, R1.1
GND: C2.1, C3.1, C4.1, C5.1, C6.1, C7.1, C8.1, C9.1, J1.9, J2.14, R3.1, R7.1, R8.1, R10.1, R20.1, R24.1, R25.1, R26.1, R27.1, U1.3 (+), U1.6 (-), U2.4 (R), U2.6 (S), U2.7 (VSS), U3.7 (VSS), U4.4 (R), U4.6 (S), U4.7 (VSS), U4.8 (S), U4.10 (R), U5.4 (R), U5.6 (S), U5.7 (VSS), U5.8 (S), U5.10 (R), U6.5 (GND)
unnamed: C1.1, U1.1, U1.5 (+)
unnamed: C1.2, R1.2, R5.1, U1.2 (-)
unnamed: D1.1 (K), R7.2, U2.5 (D)
unnamed: D1.2 (A), U1.7
unnamed: D2.1 (K), R8.2, U2.3 (C)
unnamed: D2.2 (A), R6.1
unnamed: R2.1, R3.2, U1.9 (-)
unnamed: R5.2, U1.14
unnamed: R6.2, U1.8
unnamed: R9.1, R10.2, U1.13 (-)
unnamed: R12.1, U5.11 (C)
unnamed: R12.2, U3.8
unnamed: R16.1, U4.3 (C)
unnamed: R16.2, U3.2
unnamed: R17.2, U5.13 (Q)
unnamed: R18.1, U4.11 (C)
unnamed: R18.2, U3.4
unnamed: R19.1, U5.3 (C)
unnamed: R19.2, U3.6
unnamed: R21.2, U4.1 (Q)
unnamed: R22.2, U4.13 (Q)
unnamed: R23.2, U5.1 (Q)
unnamed: R28.2, U1.10 (+)
unnamed: U4.2 (~Q), U4.5 (D)
unnamed: U4.9 (D), U4.12 (~Q)
unnamed: U5.2 (~Q), U5.5 (D)
unnamed: U5.9 (D), U5.12 (~Q)

Notes on the sheet:
clock
SIGMA/DELTA encoding with jumpers for in/out and for processings... - fixed 13/10 to add new touch for tests toooo

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
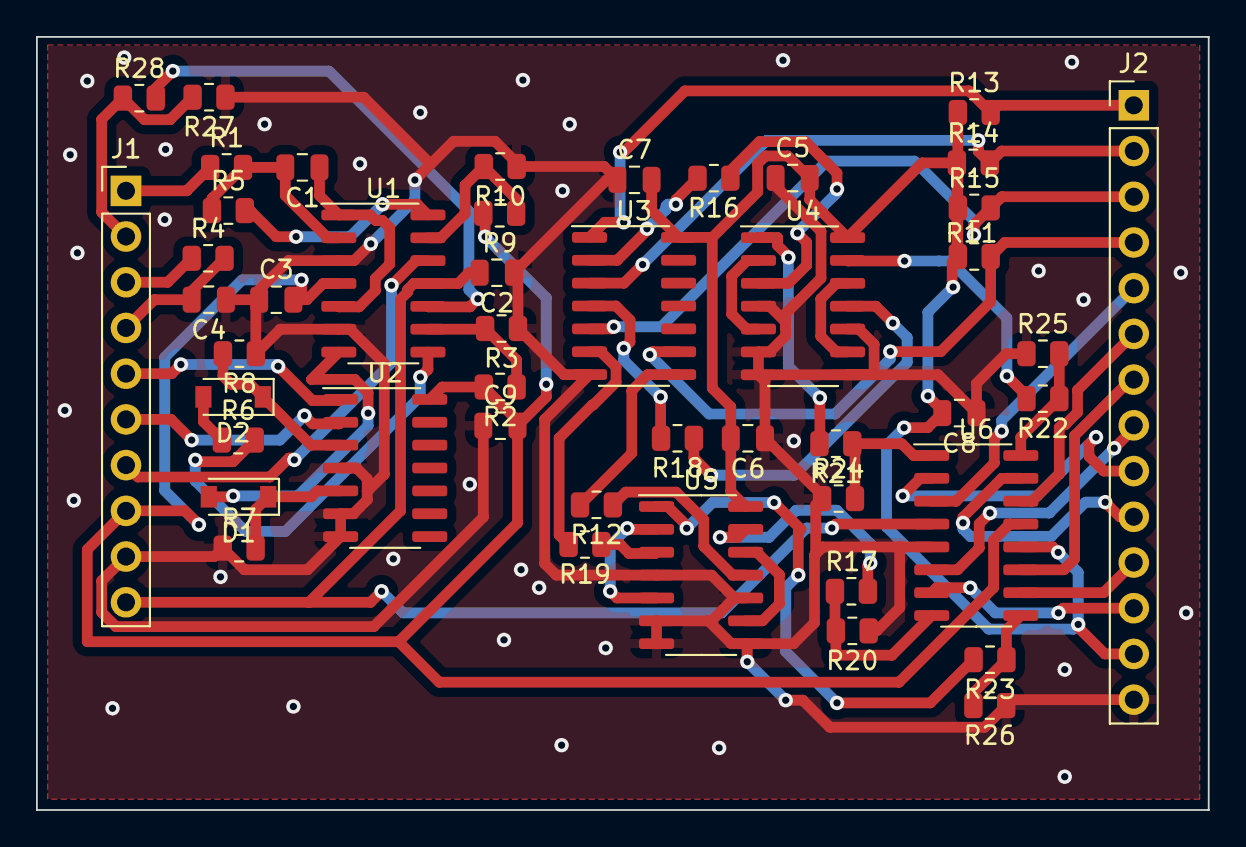
[picture p63: board testsother.kicad_pcb from above]

Board: 2 copper layers, 65.1 x 43.0 mm, 47 parts (0 on the bottom side), 54 nets.
