microresearch/allcolours/own_touch/touch.kicad_pcb

## KiCad design own_touch/touch.kicad_pcb (2020-06-26, an earlier design)

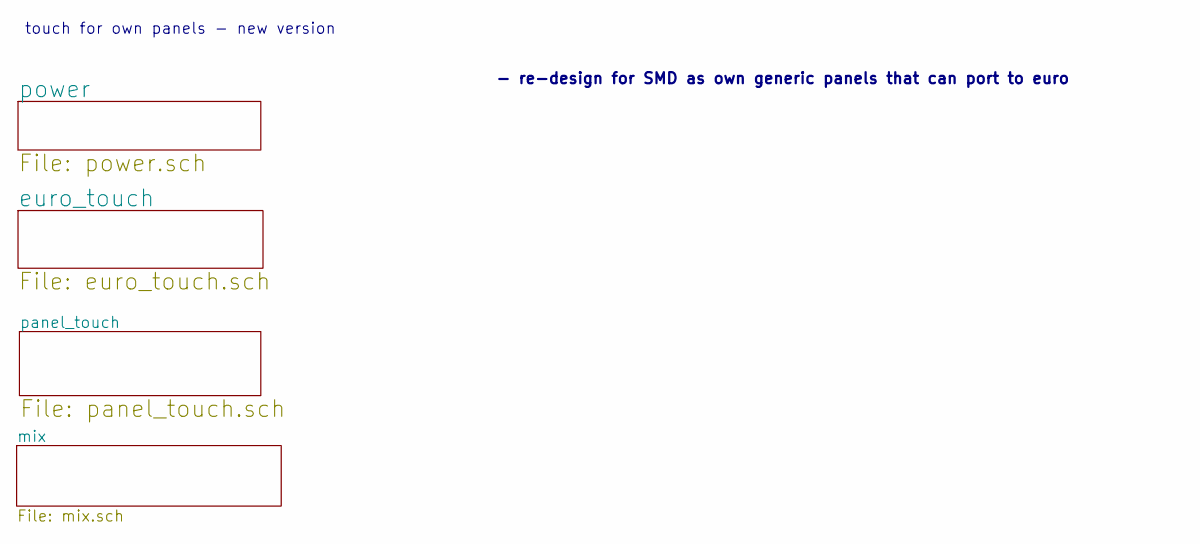
[picture p64: schematic touch.sch]

Notes on the sheet:
touch for own panels - new version
- re-design for SMD as own generic panels that can port to euro

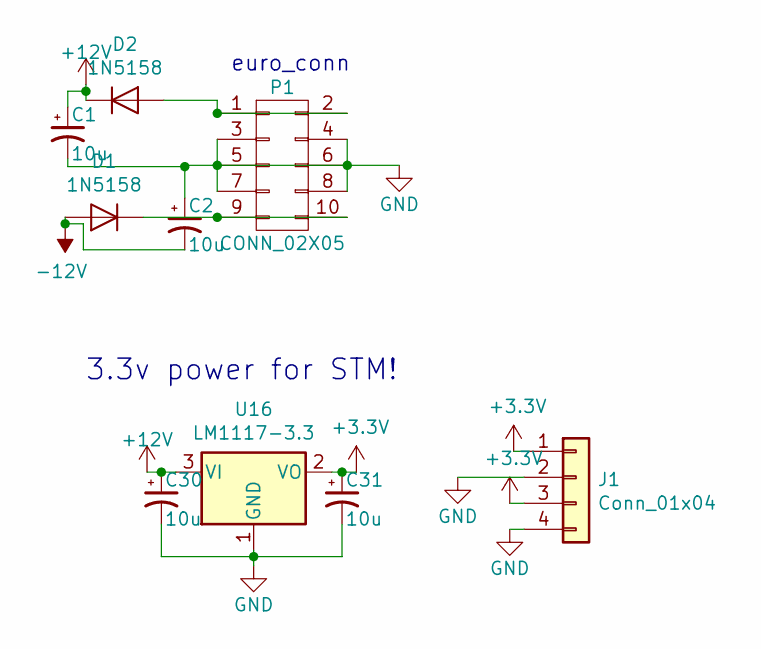
[picture p65: schematic power.sch]

Parts:
C1, C2, C30, C31: 10u; CP_Radial_D4.0mm_P1.50mm
D1, D2: 1N5158; D_A-405_P10.16mm_Horizontal
J1: Conn_01x04; Pin_Header_Straight_1x04_Pitch2.54mm
P1: CONN_02X05; Pin_Header_Straight_2x05_Pitch2.54mm
U16: LM1117-3.3; TO-220_Vertical

Connections:
+3V3: C31.1, J1.1, J1.3, U16.2 (VO); also elsewhere on the board
+12V: C1.1, C30.1, D2.1 (K), U16.3 (VI); also elsewhere on the board
-12V: C2.2, D1.2 (A); also elsewhere on the board
GND: C1.2, C2.1, C30.2, C31.2, J1.2, J1.4, P1.3, P1.4, P1.5, P1.6, P1.7, P1.8, U16.1 (GND); also elsewhere on the board
unnamed: D1.1 (K), P1.9, P1.10
unnamed: D2.2 (A), P1.1, P1.2

Notes on the sheet:
euro_conn
3.3v power for STM!
