microresearch/allcolours/own_touch/touch.kicad_pcb

## KiCad design own_touch/touch.kicad_pcb (continued)

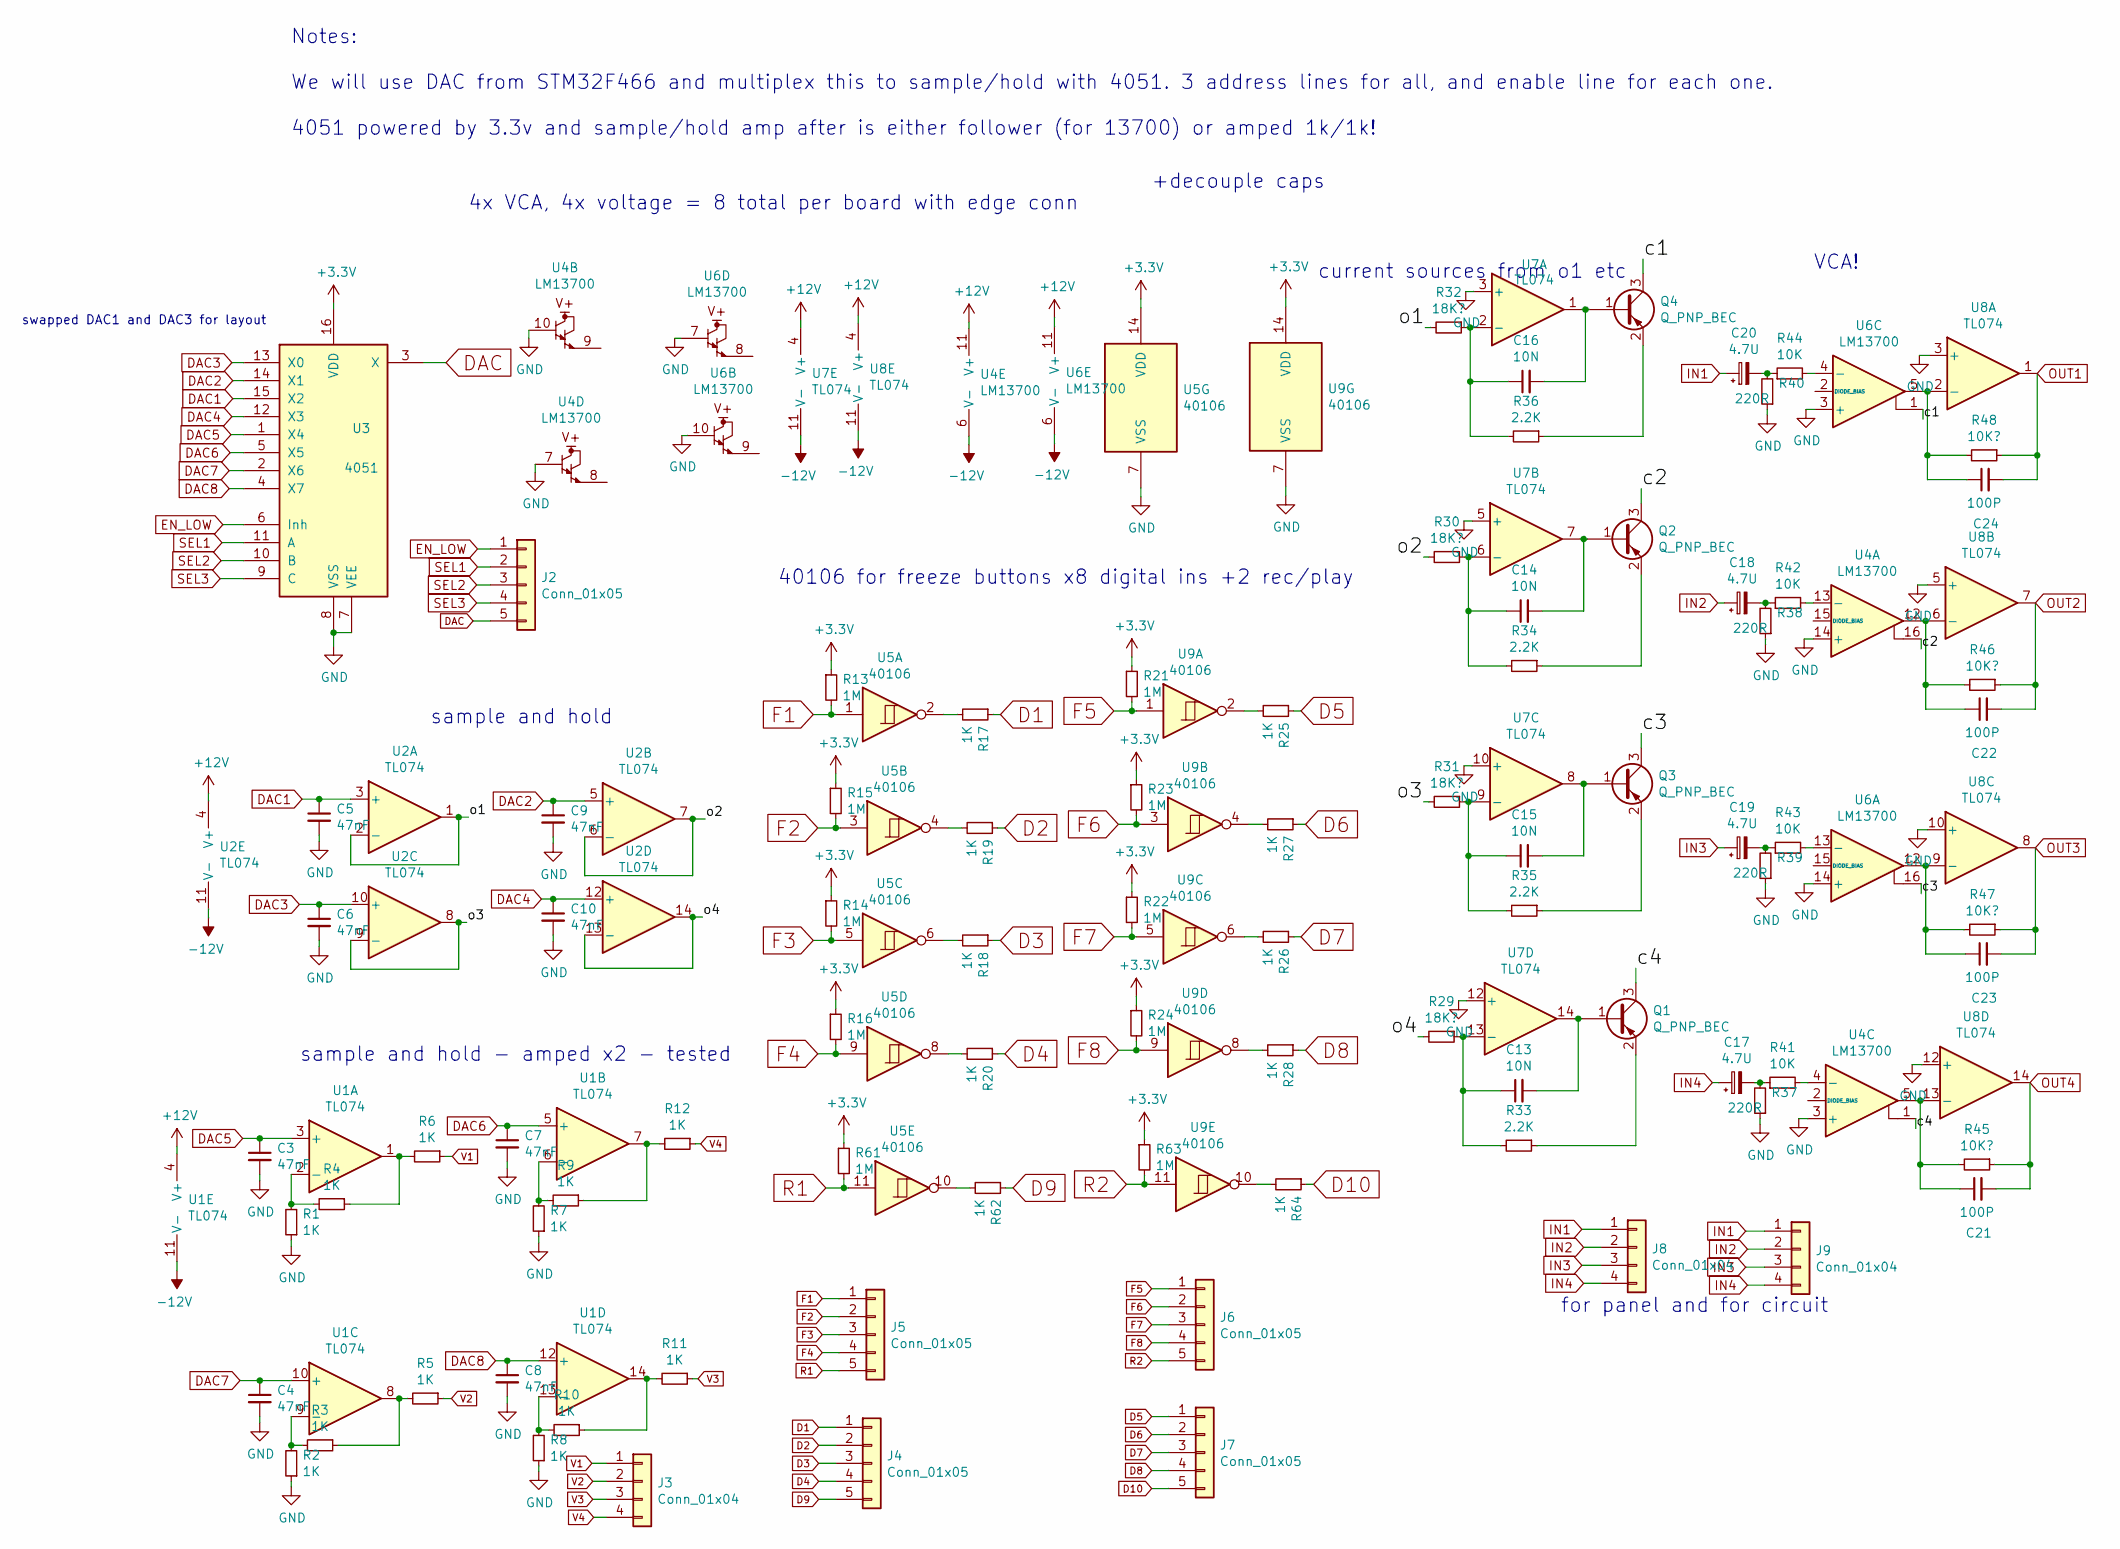
[picture p66: schematic euro_touch.sch]

Parts:
C3, C4, C5, C6, C7, C8, C9, C10: 47nF; C_Rect_L13.0mm_W4.0mm_P10.00mm_FKS3_FKP3_MKS4
C13, C14, C15, C16: 10N; C_Disc_D3.0mm_W1.6mm_P2.50mm
C17, C18, C19, C20: 4.7U; CP_Radial_D4.0mm_P1.50mm
C21, C22, C23, C24: 100P; C_Disc_D3.0mm_W1.6mm_P2.50mm
J2, J4, J5, J6, J7: Conn_01x05; Pin_Header_Straight_1x05_Pitch2.54mm
J3, J8, J9: Conn_01x04; Pin_Header_Straight_1x04_Pitch2.54mm
Q1, Q2, Q3, Q4: Q_PNP_BEC; TO-92_Inline_Wide
R1, R2, R3, R4, R5, R6, R7, R8, R9, R10, R11, R12, R17, R18, R19, R20, R25, R26, R27, R28, R62, R64: 1K; R_Axial_DIN0207_L6.3mm_D2.5mm_P10.16mm_Horizontal
R13, R14, R15, R16, R21, R22, R23, R24, R61, R63: 1M; R_Axial_DIN0207_L6.3mm_D2.5mm_P10.16mm_Horizontal
R29, R30, R31, R32: 18K?; R_Axial_DIN0207_L6.3mm_D2.5mm_P10.16mm_Horizontal
R33, R34, R35, R36: 2.2K; R_Axial_DIN0207_L6.3mm_D2.5mm_P10.16mm_Horizontal
R37, R38, R39, R40: 220R; R_Axial_DIN0207_L6.3mm_D2.5mm_P10.16mm_Horizontal
R41, R42, R43, R44: 10K; R_Axial_DIN0207_L6.3mm_D2.5mm_P10.16mm_Horizontal
R45, R46, R47, R48: 10K?; R_Axial_DIN0207_L6.3mm_D2.5mm_P10.16mm_Horizontal
U1, U2, U7, U8: TL074; DIP-14_W7.62mm_LongPads
U3: 4051; DIP-16_W7.62mm_LongPads
U4, U6: LM13700; DIP-16_W7.62mm_LongPads
U5, U9: 40106; DIP-14_W7.62mm_LongPads

Connections:
+3V3: R13.1, R14.1, R15.1, R16.1, R21.1, R22.1, R23.1, R24.1, R61.1, R63.1, U3.16 (VDD), U5.14 (VDD), U9.14 (VDD); also elsewhere on the board
+12V: U1.4 (V+), U2.4 (V+), U4.11 (V+), U6.11 (V+), U7.4 (V+), U8.4 (V+); also elsewhere on the board
-12V: U1.11 (V-), U2.11 (V-), U4.6 (V-), U6.6 (V-), U7.11 (V-), U8.11 (V-); also elsewhere on the board
/euro_touch/c1: Q4.3 (C), U6.1
/euro_touch/c2: Q2.3 (C), U4.16
/euro_touch/c3: Q3.3 (C), U6.16
/euro_touch/c4: Q1.3 (C), U4.1
/euro_touch/o1: R32.2, U2.1, U2.2 (-)
/euro_touch/o2: R30.2, U2.6 (-), U2.7
/euro_touch/o3: R31.2, U2.8, U2.9 (-)
/euro_touch/o4: R29.2, U2.13 (-), U2.14
D1: J4.1, R17.1
D2: J4.2, R19.1
D3: J4.3, R18.1
D4: J4.4, R20.1
D5: J7.1, R25.1
D6: J7.2, R27.1
D7: J7.3, R26.1
D8: J7.4, R28.1
D9: J4.5, R62.1
D10: J7.5, R64.1
DAC: J2.5, U3.3 (X)
DAC1: C5.1, U2.3 (+), U3.15 (X2)
DAC2: C9.1, U2.5 (+), U3.14 (X1)
DAC3: C6.1, U2.10 (+), U3.13 (X0)
DAC4: C10.1, U2.12 (+), U3.12 (X3)
DAC5: C3.1, U1.3 (+), U3.1 (X4)
DAC6: C7.1, U1.5 (+), U3.5 (X5)
DAC7: C4.1, U1.10 (+), U3.2 (X6)
DAC8: C8.1, U1.12 (+), U3.4 (X7)
EN_LOW: J2.1, U3.6 (Inh)
F1: J5.1, R13.2, U5.1
F2: J5.2, R15.2, U5.3
F3: J5.3, R14.2, U5.5
F4: J5.4, R16.2, U5.9
F5: J6.1, R21.2, U9.1
F6: J6.2, R23.2, U9.3
F7: J6.3, R22.2, U9.5
F8: J6.4, R24.2, U9.9
GND: C3.2, C4.2, C5.2, C6.2, C7.2, C8.2, C9.2, C10.2, R1.1, R2.1, R7.1, R8.1, R37.1, R38.1, R39.1, R40.1, U3.7 (VEE), U3.8 (VSS), U4.3 (+), U4.7, U4.10, U4.14 (+), U5.7 (VSS), U6.3 (+), U6.7, U6.10, U6.14 (+), U7.3 (+), U7.5 (+), U7.10 (+), U7.12 (+), U8.3 (+), U8.5 (+), U8.10 (+), U8.12 (+), U9.7 (VSS); also elsewhere on the board
IN1: C20.1, J8.1, J9.1
IN2: C18.1, J8.2, J9.2
IN3: C19.1, J8.3, J9.3
IN4: C17.1, J8.4, J9.4
unnamed: C13.1, R29.1, R33.2, U7.13 (-)
unnamed: C13.2, Q1.1 (B), U7.14
unnamed: C14.1, R30.1, R34.2, U7.6 (-)
unnamed: C14.2, Q2.1 (B), U7.7
unnamed: C15.1, R31.1, R35.2, U7.9 (-)
unnamed: C15.2, Q3.1 (B), U7.8
unnamed: C16.1, R32.1, R36.2, U7.2 (-)
unnamed: C16.2, Q4.1 (B), U7.1
unnamed: C17.2, R37.2, R41.1
unnamed: C18.2, R38.2, R42.1
unnamed: C19.2, R39.2, R43.1
unnamed: C20.2, R40.2, R44.1
unnamed: C21.1, R45.2, U4.5, U8.13 (-)
unnamed: C22.1, R46.2, U4.12, U8.6 (-)
unnamed: C23.1, R47.2, U6.12, U8.9 (-)
unnamed: C24.1, R48.2, U6.5, U8.2 (-)
unnamed: Q1.2 (E), R33.1
unnamed: Q2.2 (E), R34.1
unnamed: Q3.2 (E), R35.1
unnamed: Q4.2 (E), R36.1
unnamed: R1.2, R4.2, U1.2 (-)
unnamed: R2.2, R3.2, U1.9 (-)
unnamed: R3.1, R5.2, U1.8
unnamed: R4.1, R6.2, U1.1
unnamed: R7.2, R9.2, U1.6 (-)
unnamed: R10.1, R11.2, U1.14
unnamed: R8.2, R10.2, U1.13 (-)
unnamed: R9.1, R12.2, U1.7
unnamed: R17.2, U5.2
unnamed: R18.2, U5.6
unnamed: R19.2, U5.4
unnamed: R20.2, U5.8
unnamed: R25.2, U9.2
unnamed: R26.2, U9.6
unnamed: R27.2, U9.4
unnamed: R28.2, U9.8
unnamed: R41.2, U4.4 (-)
unnamed: R42.2, U4.13 (-)
unnamed: R43.2, U6.13 (-)
unnamed: R44.2, U6.4 (-)
unnamed: R62.2, U5.10
unnamed: R64.2, U9.10
OUT1: C24.2, R48.1, U8.1; also elsewhere on the board
OUT2: C22.2, R46.1, U8.7; also elsewhere on the board
OUT3: C23.2, R47.1, U8.8; also elsewhere on the board
OUT4: C21.2, R45.1, U8.14; also elsewhere on the board
R1: J5.5, R61.2, U5.11
R2: J6.5, R63.2, U9.11
SEL1: J2.2, U3.11 (A)
SEL2: J2.3, U3.10 (B)
SEL3: J2.4, U3.9 (C)
V1: J3.1, R6.1
V2: J3.2, R5.1
V3: J3.3, R11.1
V4: J3.4, R12.1

Notes on the sheet:
Notes: We will use DAC from STM32F466 and multiplex this to sample/hold with 4051. 3 address lines for all, and enable line for each one. 4051 powered by 3.3v and sample/hold amp after is either follower (for 13700) or amped 1k/1k!
current sources from o1 etc
+decouple caps
VCA!
sample and hold
4x VCA, 4x voltage = 8 total per board with edge conn
sample and hold - amped x2 - tested
40106 for freeze buttons x8 digital ins +2 rec/play
for panel and for circuit
swapped DAC1 and DAC3 for layout

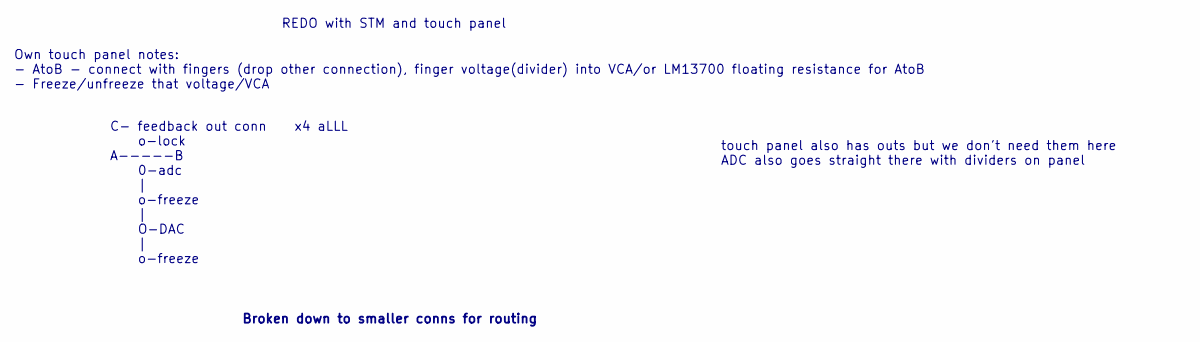
[picture p67: schematic panel_touch.sch]

Notes on the sheet:
Own touch panel notes: - AtoB - connect with fingers (drop other connection), finger voltage(divider) into VCA/or LM13700 floating resistance for AtoB - Freeze/unfreeze that voltage/VCA
C- feedback out conn x4 aLLL o-lock A-----B 0-adc | o-freeze | O-DAC | o-freeze
touch panel also has outs but we don't need them here ADC also goes straight there with dividers on panel
REDO with STM and touch panel
Broken down to smaller conns for routing

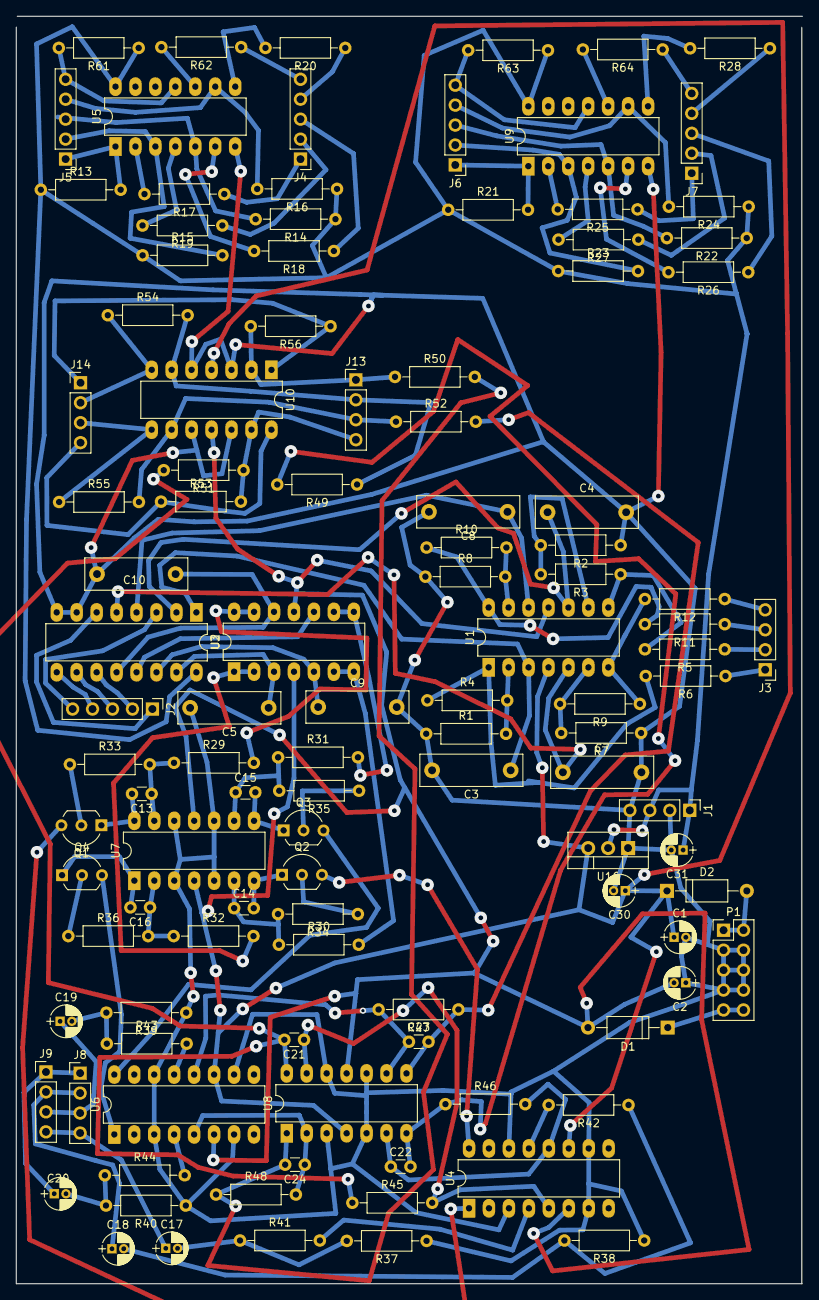
[picture p68: board own_touch/touch.kicad_pcb from above]

Board: 2 copper layers, 100.1 x 161.3 mm, 112 parts (0 on the bottom side), 109 nets.

Other parts of the board:
J13, J14: Conn_01x04; Pin_Header_Straight_1x04_Pitch2.54mm
R49, R50, R51, R52, R53, R54, R55, R56: 10K; R_Axial_DIN0207_L6.3mm_D2.5mm_P10.16mm_Horizontal
U10: TL074; DIP-14_W7.62mm_LongPads

Their connections:
+12V: U10.4; also elsewhere on the board
-12V: U10.11; also elsewhere on the board
GND: U10.3, U10.5, U10.10, U10.12; also elsewhere on the board
OUT1: R50.2; also elsewhere on the board
OUT2: R49.2; also elsewhere on the board
OUT3: R52.2; also elsewhere on the board
OUT4: R51.2; also elsewhere on the board
OUTT1: J13.1, R50.1, R56.2, U10.2
OUTT2: J13.2, R49.1, R54.2, U10.6
OUTT3: J13.3, R52.1, R55.2, U10.9
OUTT4: J13.4, R51.1, R53.2, U10.13
OUTTT1: J14.1, R56.1, U10.1
OUTTT2: J14.2, R54.1, U10.7
OUTTT3: J14.3, R55.1, U10.8
OUTTT4: J14.4, R53.1, U10.14
