microresearch/allcolours/all_colours_kicad_analogue/allcolours_analogue.kicad_pcb

## KiCad design all_colours_kicad_analogue/allcolours_analogue.kicad_pcb (2018-12-08)

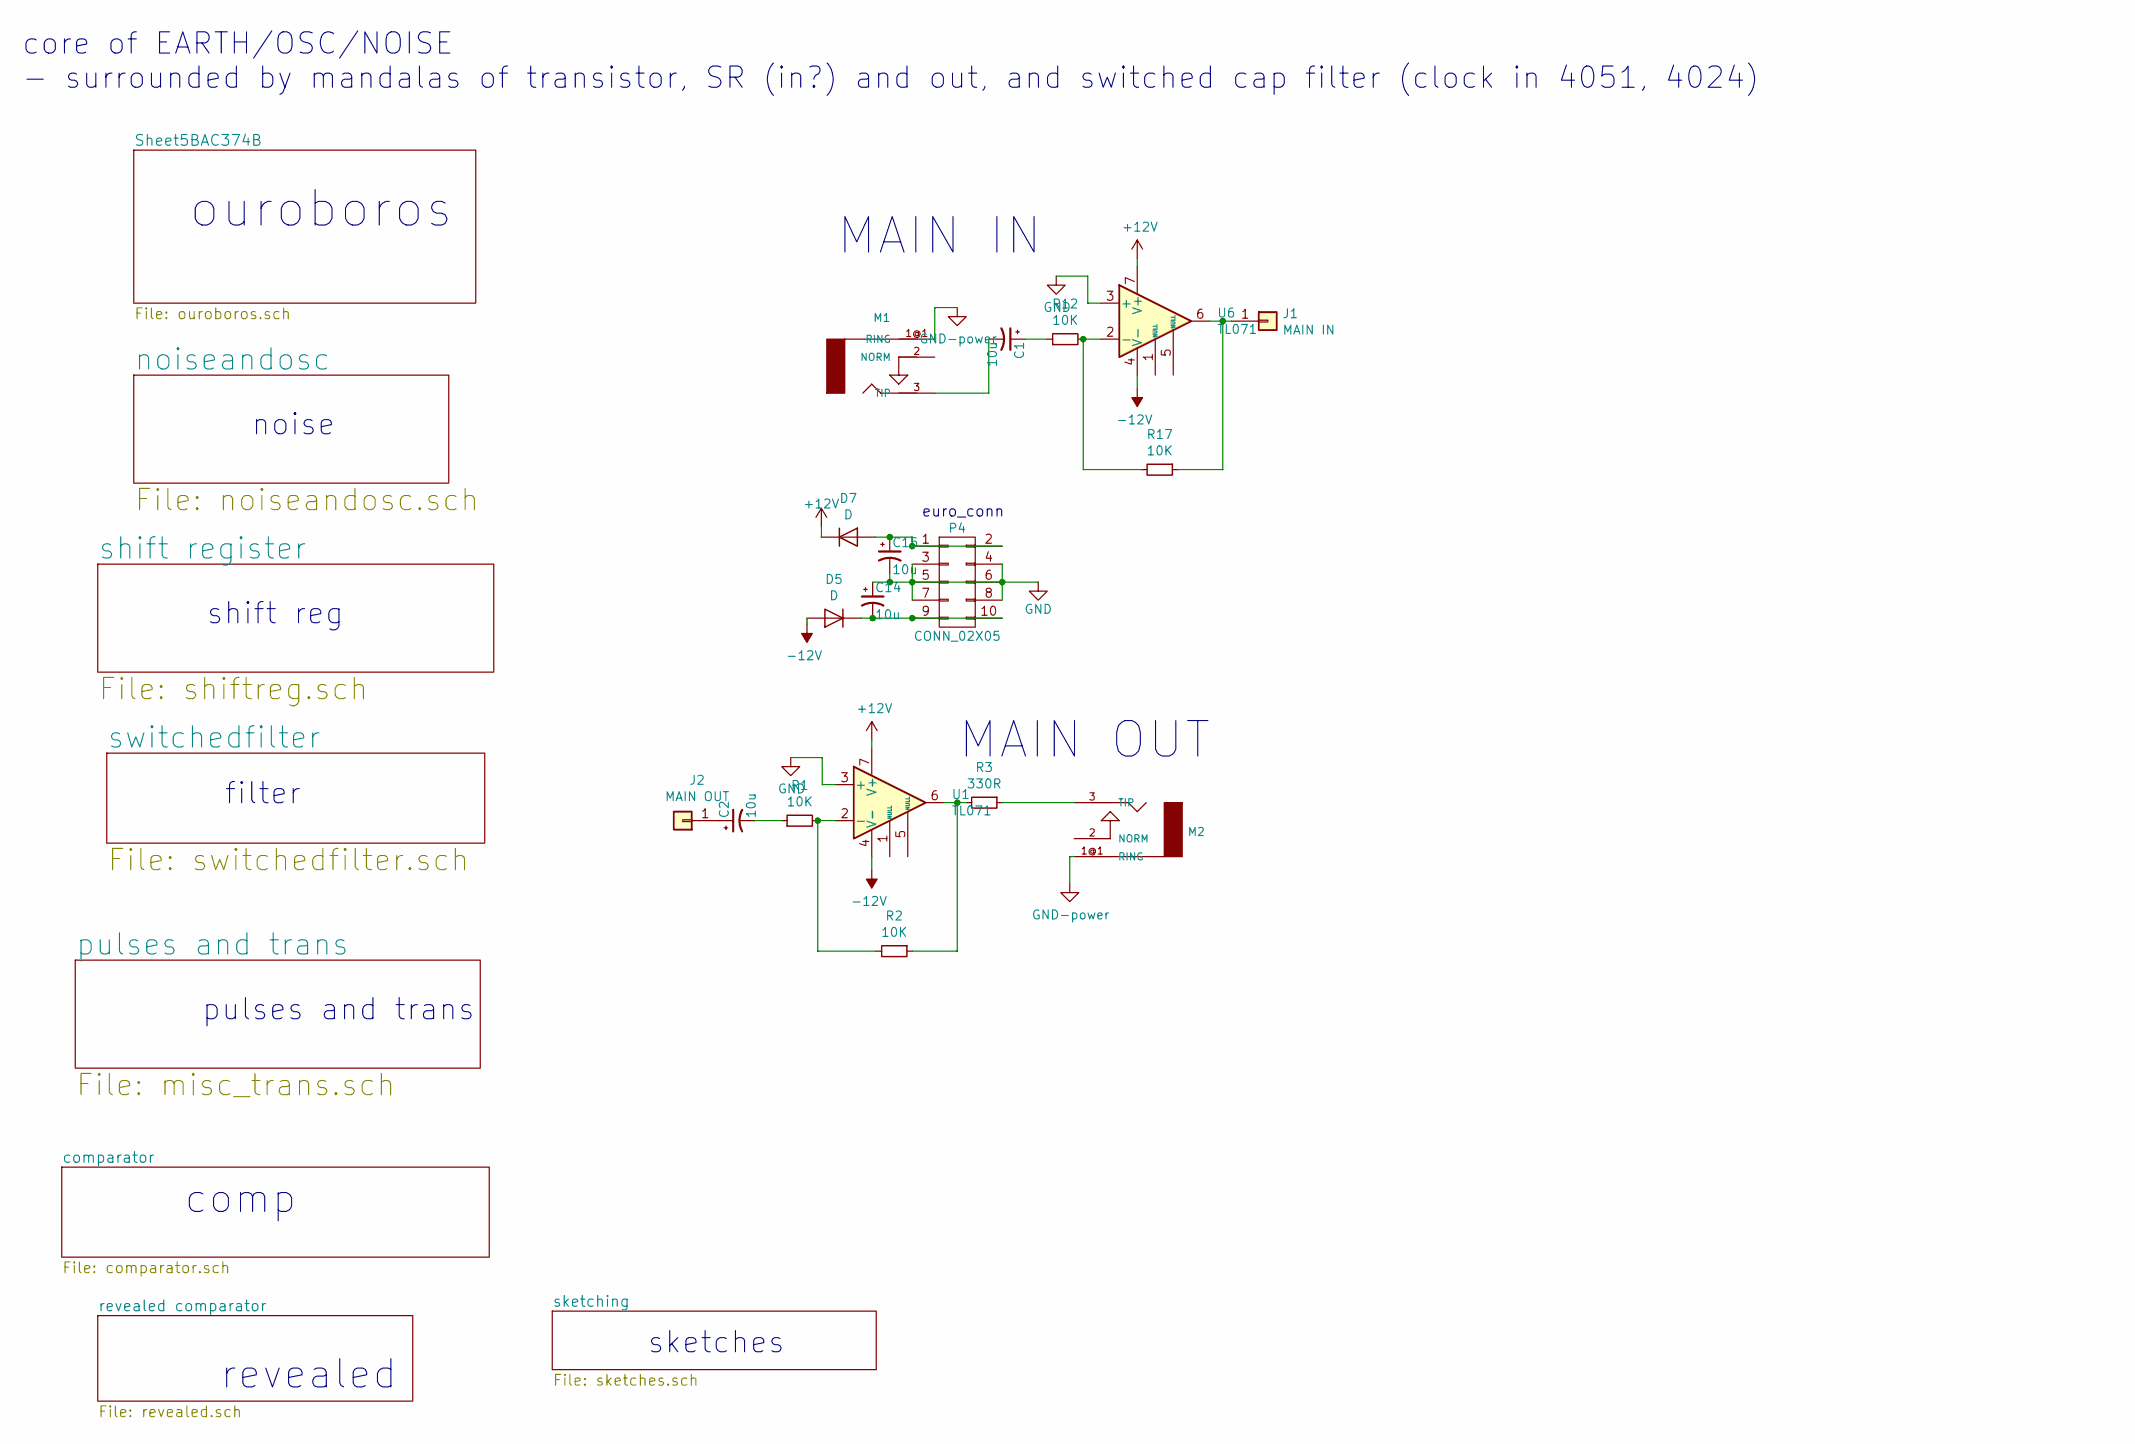
[picture p69: schematic allcolours_analogue.sch]

Parts:
C1, C2, C14, C15: 10u; SMD-1206_Pol
D5, D7: D; D_SOD-123
J1: MAIN IN; Measurement_Point_Square-SMD-Pad_Small
J2: MAIN OUT; Measurement_Point_Square-SMD-Pad_Small
M1, M2: AUDIO-JACKERTHENVAR-erthenvar; ERTHENVAR-JACK
P4: CONN_02X05; Pin_Header_Straight_2x05_Pitch2.54mm
R1, R2, R12, R17: 10K; R_0805
R3: 330R; R_0805
U1, U6: TL071; SOIC-8-N

Connections:
-12V: D5.2 (A), U1.4 (V-), U6.4 (V-); also elsewhere on the board
unnamed: C1.1, R12.1
unnamed: C1.2, M1.3 (TIP)
unnamed: C2.1, J2.1
unnamed: C2.2, R1.1
unnamed: C14.2, D5.1 (K), P4.9, P4.10
unnamed: C15.1, D7.2 (A), P4.1, P4.2
unnamed: J1.1, R17.1, U6.6
unnamed: M2.3 (TIP), R3.1
unnamed: R1.2, R2.2, U1.2 (-)
unnamed: R2.1, R3.2, U1.6
unnamed: R12.2, R17.2, U6.2 (-)

Notes on the sheet:
euro_conn
ouroboros
core of EARTH/OSC/NOISE - surrounded by mandalas of transistor, SR (in?) and out, and switched cap filter (clock in 4051, 4024)
noise
pulses and trans
shift reg
filter
MAIN OUT
MAIN IN
comp
revealed
sketches

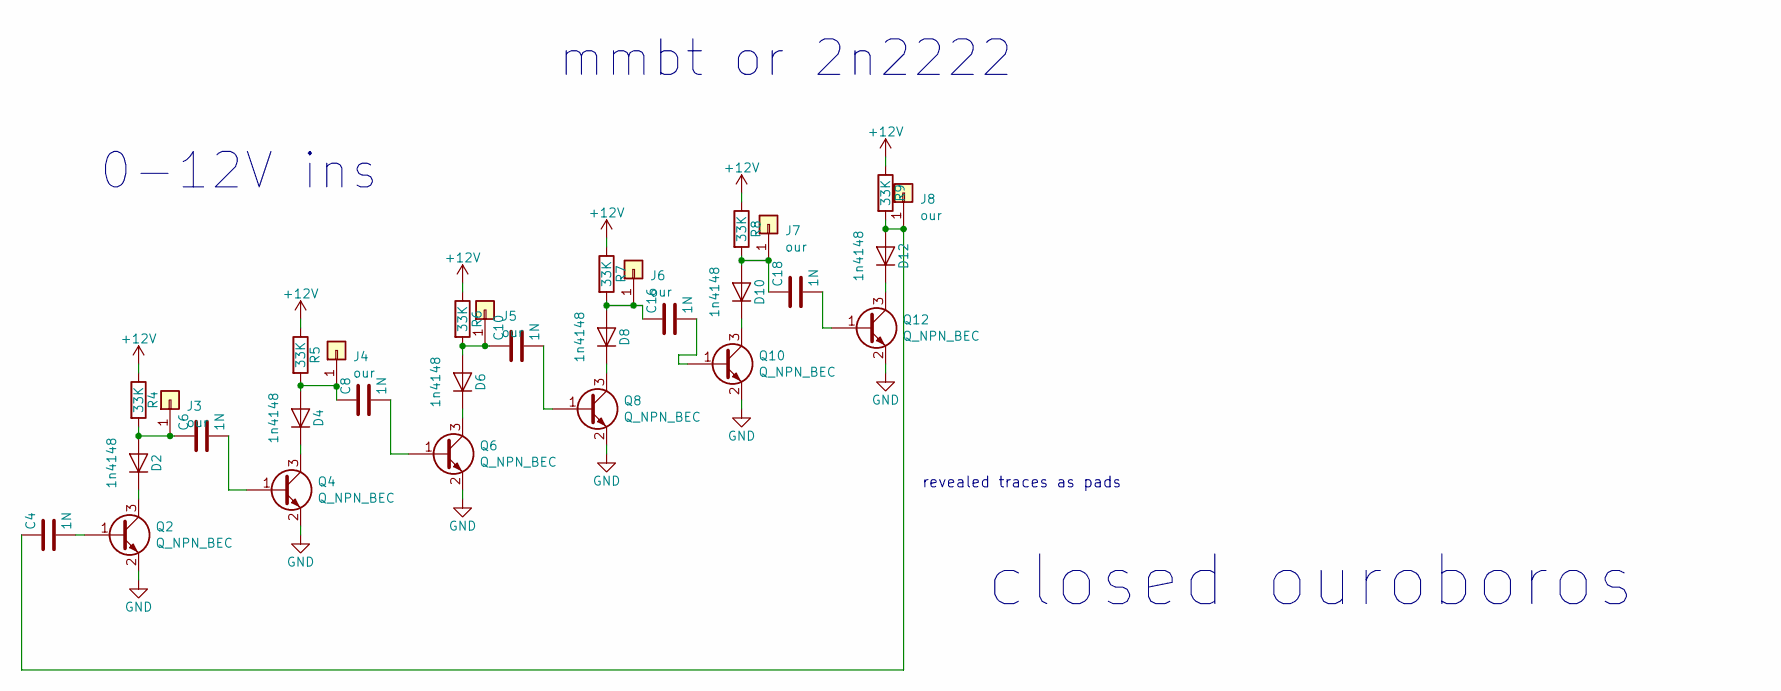
[picture p70: schematic ouroboros.sch]

Parts:
C4, C6, C8, C10, C16, C18: 1N; C_0805
D2, D4, D6, D8, D10, D12: 1n4148; D_SOD-323
J3, J4, J5, J6, J7, J8: our; Measurement_Point_Square-SMD-Pad_Small
Q2, Q4, Q6, Q8, Q10, Q12: Q_NPN_BEC; SOT-23
R4, R5, R6, R7, R8, R9: 33K; R_0805

Connections:
unnamed: C4.1, D12.2 (A), J8.1, R9.2
unnamed: C4.2, Q2.1 (B)
unnamed: C6.1, D2.2 (A), J3.1, R4.2
unnamed: C6.2, Q4.1 (B)
unnamed: C8.1, D4.2 (A), J4.1, R5.2
unnamed: C8.2, Q6.1 (B)
unnamed: C10.1, D6.2 (A), J5.1, R6.2
unnamed: C10.2, Q8.1 (B)
unnamed: C16.1, D8.2 (A), J6.1, R7.2
unnamed: C16.2, Q10.1 (B)
unnamed: C18.1, D10.2 (A), J7.1, R8.2
unnamed: C18.2, Q12.1 (B)
unnamed: D2.1 (K), Q2.3 (C)
unnamed: D4.1 (K), Q4.3 (C)
unnamed: D6.1 (K), Q6.3 (C)
unnamed: D8.1 (K), Q8.3 (C)
unnamed: D10.1 (K), Q10.3 (C)
unnamed: D12.1 (K), Q12.3 (C)

Notes on the sheet:
mmbt or 2n2222
closed ouroboros
revealed traces as pads
0-12V ins

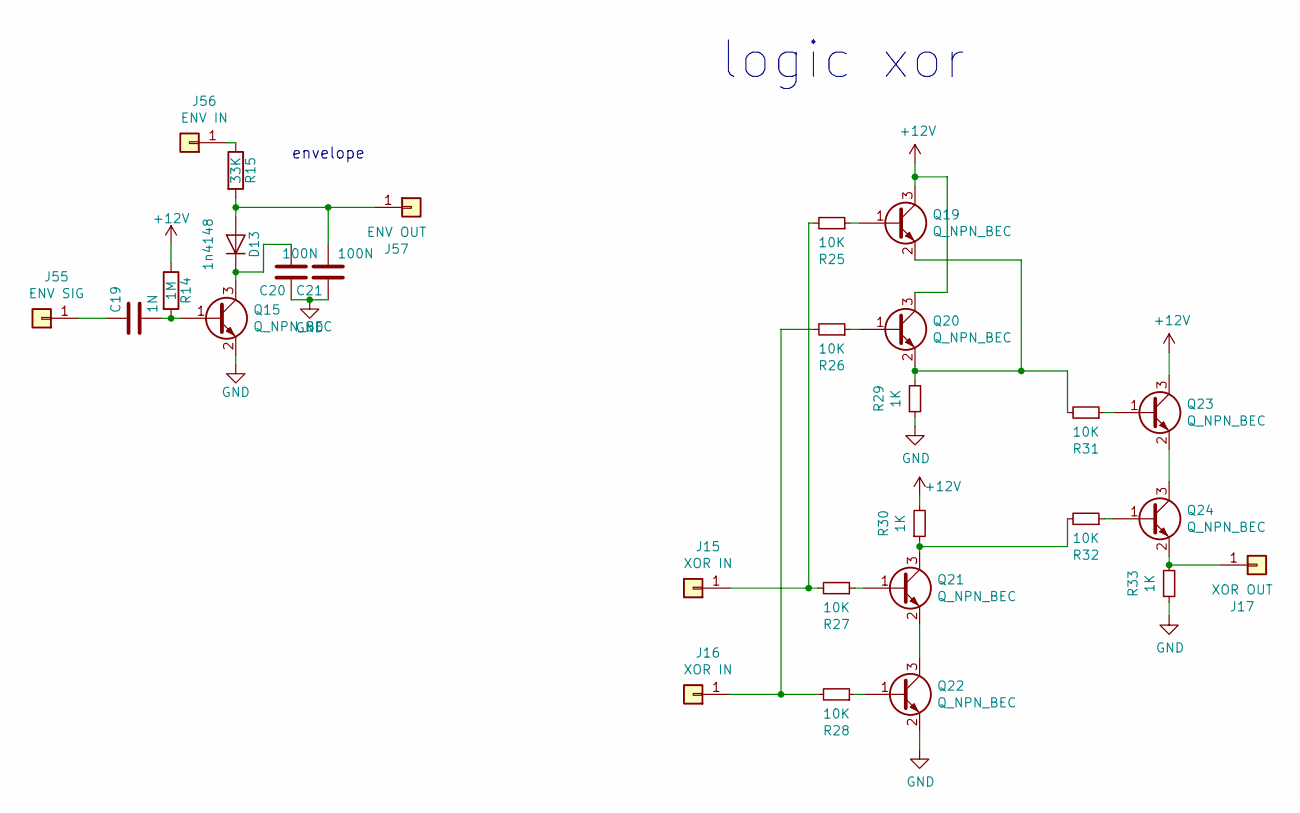
[picture p71: schematic misc_trans.sch]

Parts:
C19: 1N; C_0805
C20, C21: 100N; C_0805
D13: 1n4148; D_SOD-323
J15, J16: XOR IN; Measurement_Point_Square-SMD-Pad_Small
J17: XOR OUT; Measurement_Point_Square-SMD-Pad_Small
J55: ENV SIG; Measurement_Point_Square-SMD-Pad_Small
J56: ENV IN; Measurement_Point_Square-SMD-Pad_Small
J57: ENV OUT; Measurement_Point_Square-SMD-Pad_Small
Q15, Q19, Q20, Q21, Q22, Q23, Q24: Q_NPN_BEC; SOT-23
R14: 1M; R_0805
R15: 33K; R_0805
R25, R26, R27, R28, R31, R32: 10K; R_0805
R29, R30, R33: 1K; R_0805

Connections:
unnamed: C19.1, J55.1
unnamed: C19.2, Q15.1 (B), R14.2
unnamed: C20.2, D13.1 (K), Q15.3 (C)
unnamed: C21.2, D13.2 (A), J57.1, R15.2
unnamed: J15.1, R25.2, R27.2
unnamed: J16.1, R26.2, R28.2
unnamed: J17.1, Q24.2 (E), R33.2
unnamed: J56.1, R15.1
unnamed: Q19.1 (B), R25.1
unnamed: Q19.2 (E), Q20.2 (E), R29.2, R31.2
unnamed: Q20.1 (B), R26.1
unnamed: Q21.1 (B), R27.1
unnamed: Q21.2 (E), Q22.3 (C)
unnamed: Q21.3 (C), R30.1, R32.2
unnamed: Q22.1 (B), R28.1
unnamed: Q23.1 (B), R31.1
unnamed: Q23.2 (E), Q24.3 (C)
unnamed: Q24.1 (B), R32.1

Notes on the sheet:
envelope
logic xor

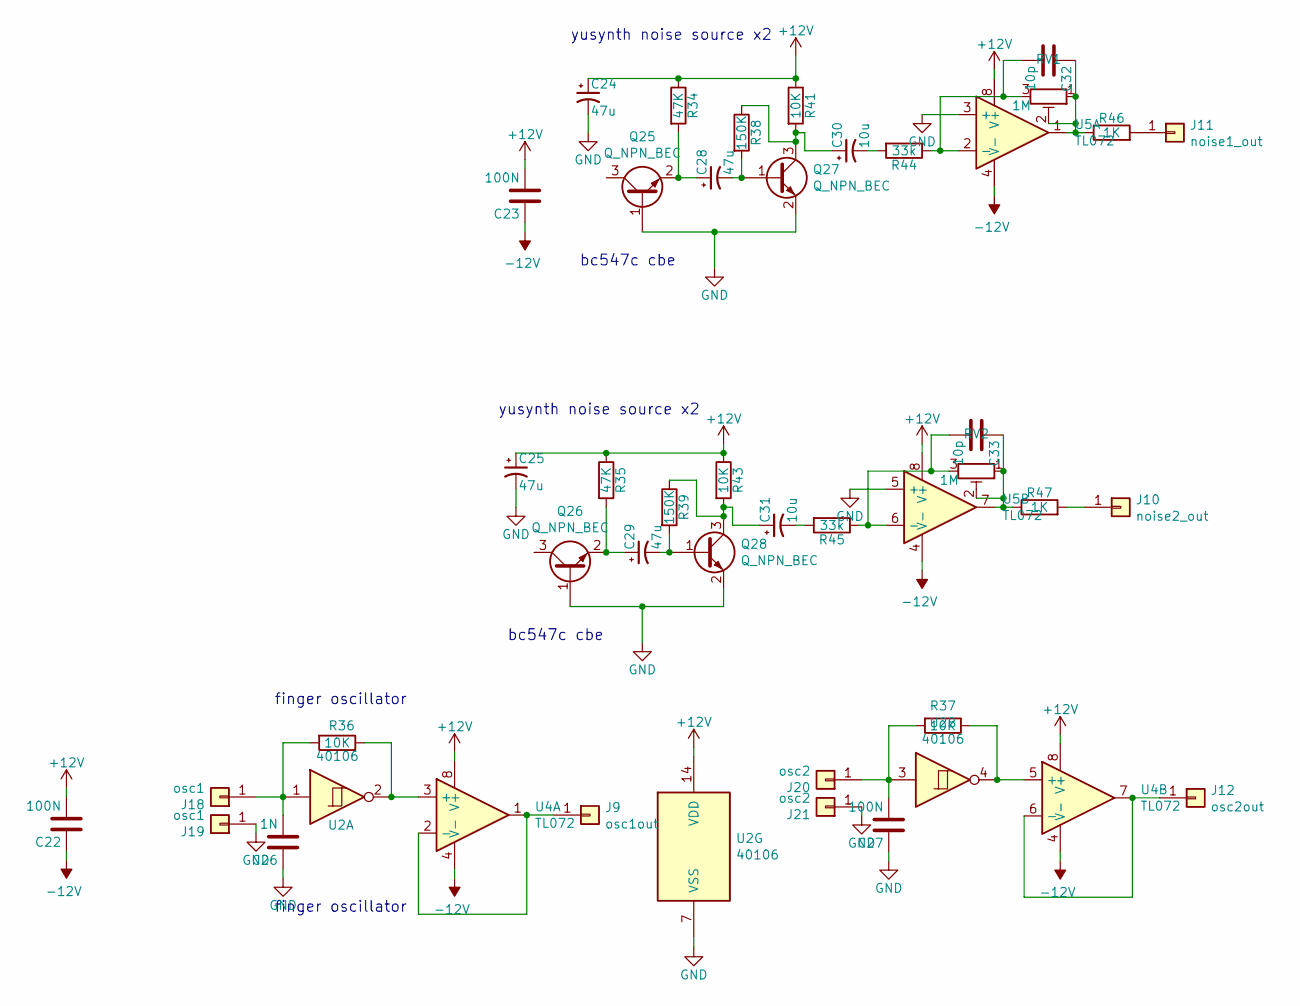
[picture p72: schematic noiseandosc.sch]

Parts:
C22, C23, C27: 100N; C_0805
C24, C25, C28, C29: 47u; SMD-1206_Pol
C26: 1N; C_0805
C30, C31: 10u; SMD-1206_Pol
C32, C33: 10p; C_0805
J9: osc1out; Measurement_Point_Square-SMD-Pad_Small
J10: noise2_out; Measurement_Point_Square-SMD-Pad_Small
J11: noise1_out; Measurement_Point_Square-SMD-Pad_Small
J12: osc2out; Measurement_Point_Square-SMD-Pad_Small
J18, J19: osc1; Measurement_Point_Square-SMD-Pad_Small
J20, J21: osc2; Measurement_Point_Square-SMD-Pad_Small
Q25, Q26, Q27, Q28: Q_NPN_BEC; SOT-23
R34, R35: 47K; R_0805
R36, R37, R41, R43: 10K; R_0805
R38, R39: 150K; R_0805
R44, R45: 33k; R_0805
R46, R47: 1K; R_0805
RV1, RV2: 1M; Potentiometer_Trimmer-EVM3E
U2: 40106; SOIC-14_N
U4, U5: TL072; SOIC-8-N

Connections:
-12V: C22.1, C23.1, U4.4 (V-), U5.4 (V-); also elsewhere on the board
unnamed: C26.2, J18.1, R36.2, U2.1
unnamed: C27.2, J20.1, R37.2, U2.3
unnamed: C28.1, Q25.2 (E), R34.2
unnamed: C28.2, Q27.1 (B), R38.2
unnamed: C29.1, Q26.2 (E), R35.2
unnamed: C29.2, Q28.1 (B), R39.2
unnamed: C30.1, Q27.3 (C), R38.1, R41.2
unnamed: C30.2, R44.2
unnamed: C31.1, Q28.3 (C), R39.1, R43.2
unnamed: C31.2, R45.2
unnamed: C32.1, R46.1, RV1.1, RV1.2, U5.1
unnamed: C32.2, R44.1, RV1.3, U5.2 (-)
unnamed: C33.1, R47.1, RV2.1, RV2.2, U5.7
unnamed: C33.2, R45.1, RV2.3, U5.6 (-)
unnamed: J9.1, U4.1, U4.2 (-)
unnamed: J10.1, R47.2
unnamed: J11.1, R46.2
unnamed: J12.1, U4.6 (-), U4.7
unnamed: R36.1, U2.2, U4.3 (+)
unnamed: R37.1, U2.4, U4.5 (+)

Notes on the sheet:
bc547c cbe
yusynth noise source x2
finger oscillator

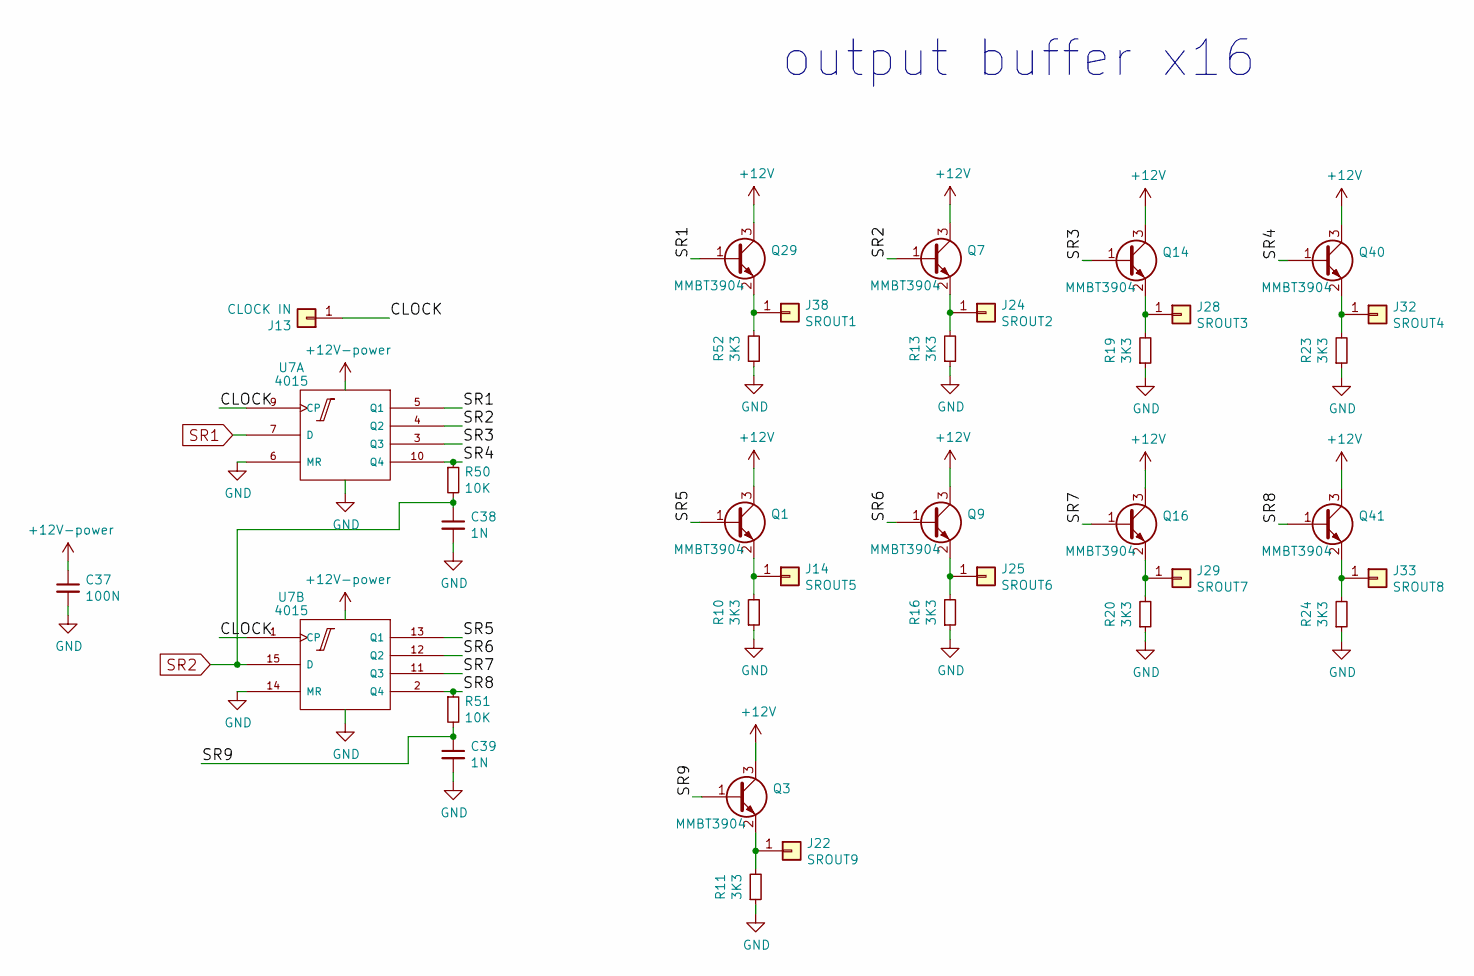
[picture p73: schematic shiftreg.sch]

Parts:
C37: 100N; C_0805
C38, C39: 1N; C_0805
J13: CLOCK IN; Measurement_Point_Square-SMD-Pad_Small
J14: SROUT5; Measurement_Point_Square-SMD-Pad_Small
J22: SROUT9; Measurement_Point_Square-SMD-Pad_Small
J24: SROUT2; Measurement_Point_Square-SMD-Pad_Small
J25: SROUT6; Measurement_Point_Square-SMD-Pad_Small
J28: SROUT3; Measurement_Point_Square-SMD-Pad_Small
J29: SROUT7; Measurement_Point_Square-SMD-Pad_Small
J32: SROUT4; Measurement_Point_Square-SMD-Pad_Small
J33: SROUT8; Measurement_Point_Square-SMD-Pad_Small
J38: SROUT1; Measurement_Point_Square-SMD-Pad_Small
Q1, Q3, Q7, Q9, Q14, Q16, Q29, Q40, Q41: MMBT3904; SOT-23
R10, R11, R13, R16, R19, R20, R23, R24, R52: 3K3; R_0805
R50, R51: 10K; R_0805
U7: 4015; SO-16-N

Connections:
/shift register/CLOCK: J13.1, U7.1 (CP), U7.9 (CP)
/shift register/SR3: Q14.1 (B), U7.3 (Q3)
/shift register/SR4: Q40.1 (B), R50.1, U7.10 (Q4)
/shift register/SR5: Q1.1 (B), U7.13 (Q1)
/shift register/SR6: Q9.1 (B), U7.12 (Q2)
/shift register/SR7: Q16.1 (B), U7.11 (Q3)
/shift register/SR8: Q41.1 (B), R51.1, U7.2 (Q4)
/shift register/SR9: C39.1, Q3.1 (B), R51.2
unnamed: J14.1, Q1.2 (E), R10.2
unnamed: J22.1, Q3.2 (E), R11.2
unnamed: J24.1, Q7.2 (E), R13.2
unnamed: J25.1, Q9.2 (E), R16.2
unnamed: J28.1, Q14.2 (E), R19.2
unnamed: J29.1, Q16.2 (E), R20.2
unnamed: J32.1, Q40.2 (E), R23.2
unnamed: J33.1, Q41.2 (E), R24.2
unnamed: J38.1, Q29.2 (E), R52.2
SR1: Q29.1 (B), U7.5 (Q1), U7.7 (D); also elsewhere on the board
SR2: C38.1, Q7.1 (B), R50.2, U7.4 (Q2), U7.15 (D); also elsewhere on the board

Notes on the sheet:
output buffer x16
