microresearch/allcolours/all_colours_kicad_analogue/allcolours_analogue.kicad_pcb

## KiCad design all_colours_kicad_analogue/allcolours_analogue.kicad_pcb (continued)

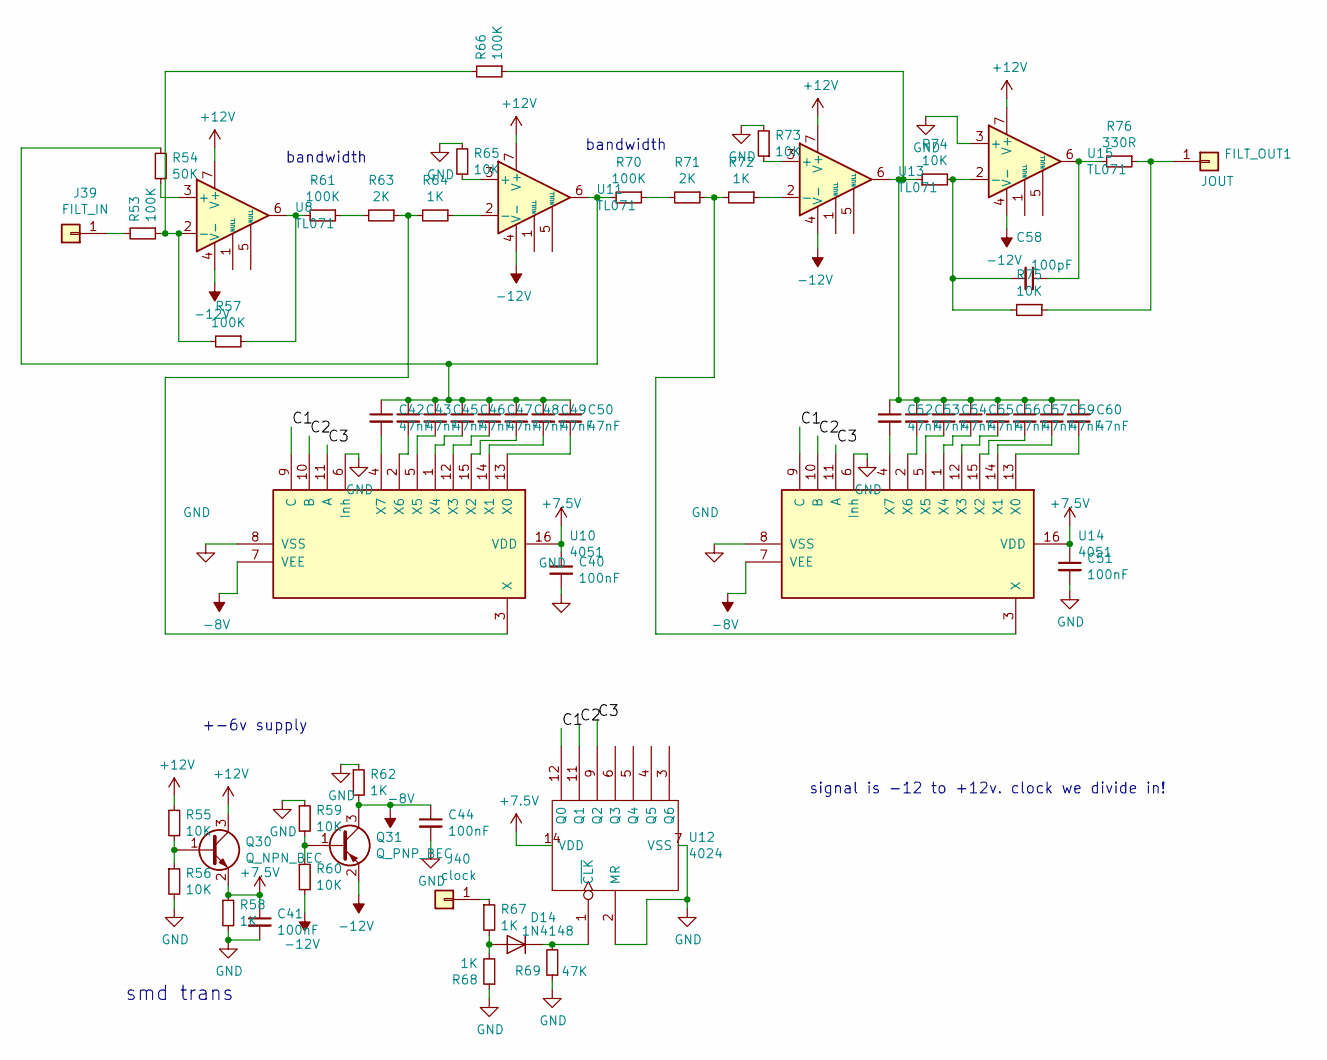
[picture p74: schematic switchedfilter.sch]

Parts:
C40, C41, C44, C51: 100nF; C_0805
C42, C43, C45, C46, C47, C48, C49, C50, C52, C53, C54, C55, C56, C57, C59, C60: 47nF; C_0805
C58: 100pF; C_0805
D14: 1N4148; D_SOD-323
FILT_OUT1: JOUT; Measurement_Point_Square-SMD-Pad_Small
J39: FILT_IN; Measurement_Point_Square-SMD-Pad_Small
J40: clock; Measurement_Point_Square-SMD-Pad_Small
Q30: Q_NPN_BEC; SOT-23
Q31: Q_PNP_BEC; SOT-23
R53, R57, R61, R66, R70: 100K; R_0805
R54: 50K; R_0805
R55, R56, R59, R60, R65, R73, R74, R75: 10K; R_0805
R58, R62, R64, R67, R68, R72: 1K; R_0805
R63, R71: 2K; R_0805
R69: 47K; R_0805
R76: 330R; R_0805
U8, U11, U13, U15: TL071; SOIC-8-N
U10, U14: 4051; SO-16-N
U12: 4024; SOIC-14_N

Connections:
+7.5V: C40.1, C41.1, C51.1, Q30.2 (E), R58.1, U10.16 (VDD), U12.14 (VDD), U14.16 (VDD)
-8V: C44.1, Q31.3 (C), R62.2, U10.7 (VEE), U14.7 (VEE)
-12V: Q31.2 (E), R60.2, U8.4 (V-), U11.4 (V-), U13.4 (V-), U15.4 (V-); also elsewhere on the board
/switchedfilter/C1: U10.9 (C), U12.12 (Q0), U14.9 (C)
/switchedfilter/C2: U10.10 (B), U12.11 (Q1), U14.10 (B)
/switchedfilter/C3: U10.11 (A), U12.9 (Q2), U14.11 (A)
unnamed: C42.1, C43.1, C45.1, C46.1, C47.1, C48.1, C49.1, C50.1, R54.2, R70.2, U11.6
unnamed: C42.2, U10.4 (X7)
unnamed: C43.2, U10.2 (X6)
unnamed: C45.2, U10.5 (X5)
unnamed: C46.2, U10.1 (X4)
unnamed: C47.2, U10.12 (X3)
unnamed: C48.2, U10.15 (X2)
unnamed: C49.2, U10.14 (X1)
unnamed: C50.2, U10.13 (X0)
unnamed: C52.1, C53.1, C54.1, C55.1, C56.1, C57.1, C59.1, C60.1, R66.1, R74.1, U13.6
unnamed: C52.2, U14.4 (X7)
unnamed: C53.2, U14.2 (X6)
unnamed: C54.2, U14.5 (X5)
unnamed: C55.2, U14.1 (X4)
unnamed: C56.2, U14.12 (X3)
unnamed: C57.2, U14.15 (X2)
unnamed: C58.1, R76.2, U15.6
unnamed: C58.2, R74.2, R75.2, U15.2 (-)
unnamed: C59.2, U14.14 (X1)
unnamed: C60.2, U14.13 (X0)
unnamed: D14.1 (K), R69.2, U12.1 (~CLK)
unnamed: D14.2 (A), R67.2, R68.2
unnamed: FILT_OUT1.1, R75.1, R76.1
unnamed: J39.1, R53.2
unnamed: J40.1, R67.1
unnamed: Q30.1 (B), R55.2, R56.1
unnamed: Q31.1 (B), R59.2, R60.1
unnamed: R53.1, R57.2, R66.2, U8.2 (-)
unnamed: R54.1, U8.3 (+)
unnamed: R57.1, R61.2, U8.6
unnamed: R61.1, R63.2
unnamed: R63.1, R64.2, U10.3 (X)
unnamed: R64.1, U11.2 (-)
unnamed: R65.1, U11.3 (+)
unnamed: R70.1, R71.2
unnamed: R71.1, R72.2, U14.3 (X)
unnamed: R72.1, U13.2 (-)
unnamed: R73.1, U13.3 (+)

Notes on the sheet:
+-6v supply
signal is -12 to +12v. clock we divide in!
smd trans
bandwidth

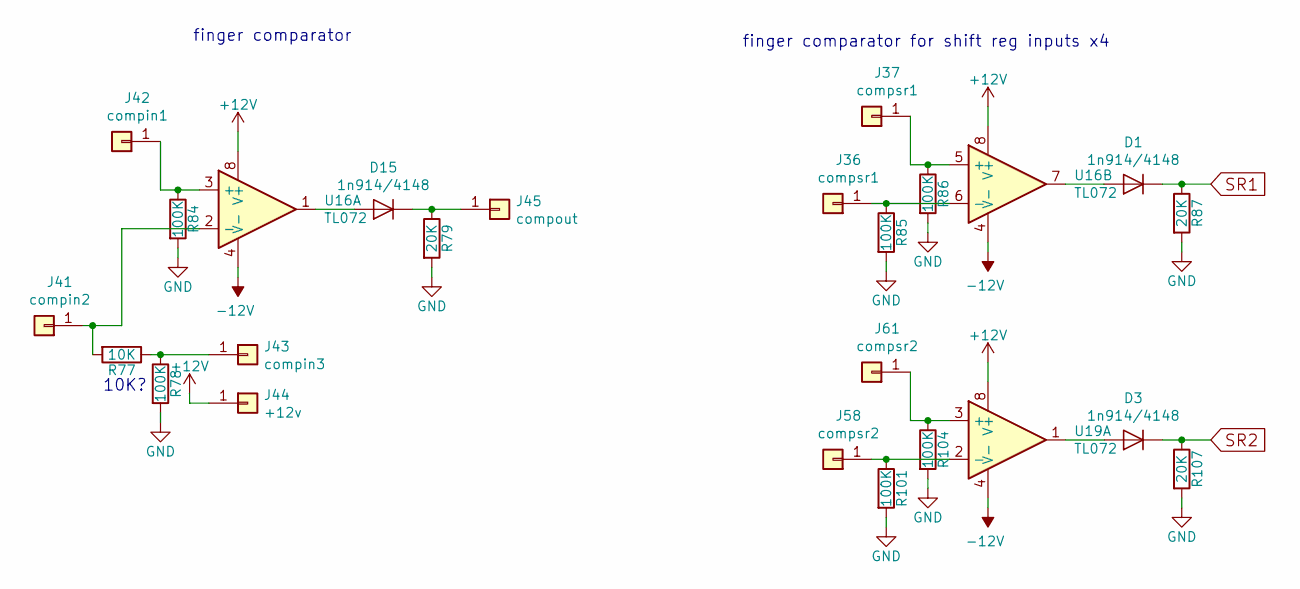
[picture p75: schematic comparator.sch]

Parts:
D1, D3, D15: 1n914/4148; D_SOD-323
J36, J37: compsr1; Measurement_Point_Square-SMD-Pad_Small
J41: compin2; Measurement_Point_Square-SMD-Pad_Small
J42: compin1; Measurement_Point_Square-SMD-Pad_Small
J43: compin3; Measurement_Point_Square-SMD-Pad_Small
J44: +12v; Measurement_Point_Square-SMD-Pad_Small
J45: compout; Measurement_Point_Square-SMD-Pad_Small
J58, J61: compsr2; Measurement_Point_Square-SMD-Pad_Small
R77: 10K; R_0805
R78, R84, R85, R86, R101, R104: 100K; R_0805
R79, R87, R107: 20K; R_0805
U16, U19: TL072; SOIC-8-N

Connections:
-12V: U16.4 (V-), U19.4 (V-); also elsewhere on the board
unnamed: D1.2 (A), U16.7
unnamed: D3.2 (A), U19.1
unnamed: D15.1 (K), J45.1, R79.1
unnamed: D15.2 (A), U16.1
unnamed: J36.1, R85.1, U16.6 (-)
unnamed: J37.1, R86.1, U16.5 (+)
unnamed: J41.1, R77.2, U16.2 (-)
unnamed: J42.1, R84.1, U16.3 (+)
unnamed: J43.1, R77.1, R78.1
unnamed: J58.1, R101.1, U19.2 (-)
unnamed: J61.1, R104.1, U19.3 (+)
SR1: D1.1 (K), R87.1; also elsewhere on the board
SR2: D3.1 (K), R107.1; also elsewhere on the board

Notes on the sheet:
finger comparator
10K?
finger comparator for shift reg inputs x4

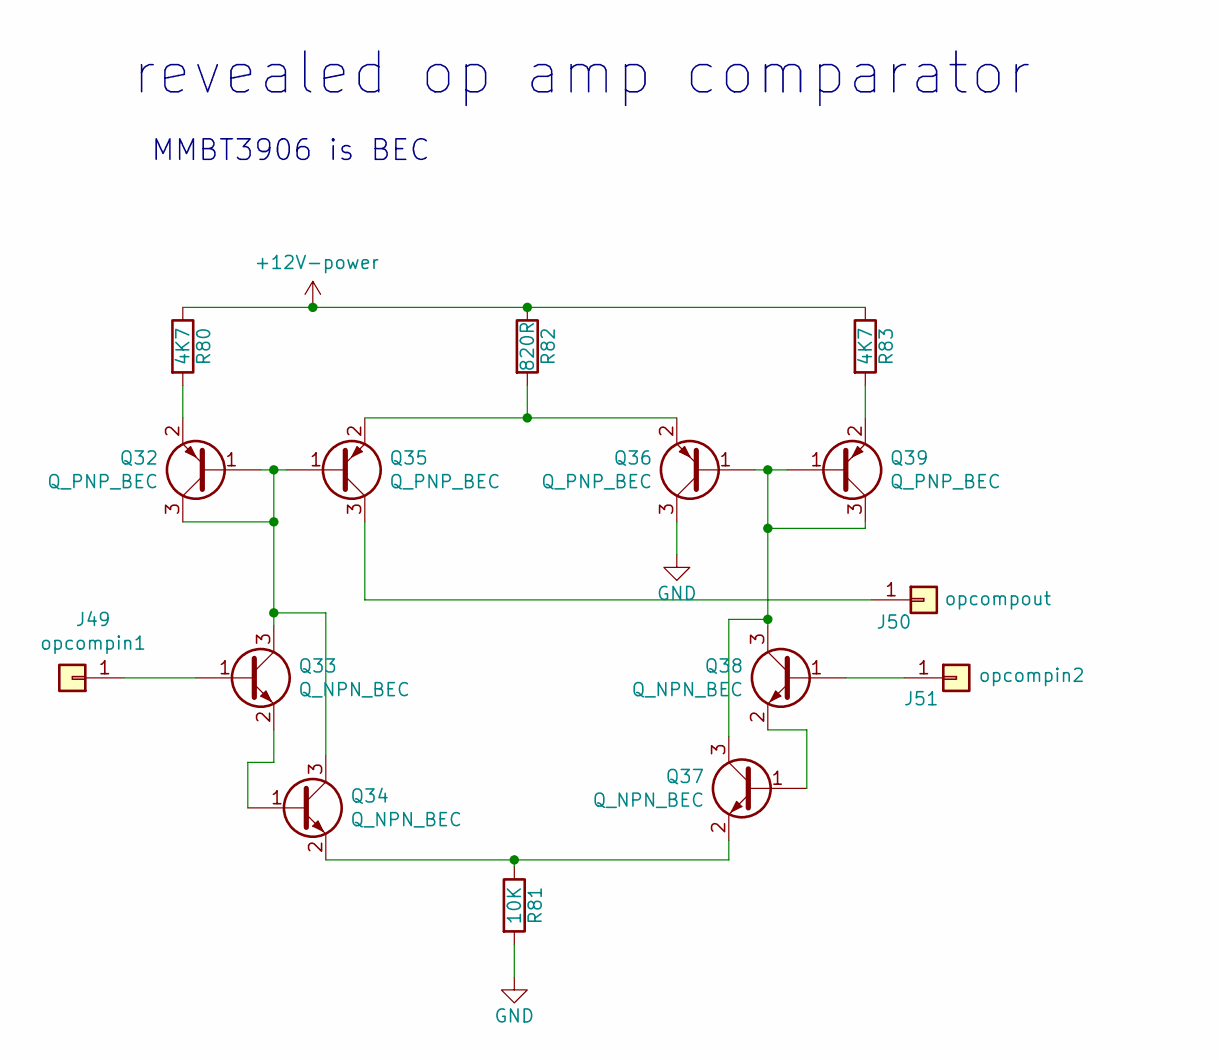
[picture p76: schematic revealed.sch]

Parts:
J49: opcompin1; Measurement_Point_Square-SMD-Pad_Small
J50: opcompout; Measurement_Point_Square-SMD-Pad_Small
J51: opcompin2; Measurement_Point_Square-SMD-Pad_Small
Q32, Q35, Q36, Q39: Q_PNP_BEC; SOT-23
Q33, Q34, Q37, Q38: Q_NPN_BEC; SOT-23
R80, R83: 4K7; R_0805
R81: 10K; R_0805
R82: 820R; R_0805

Connections:
unnamed: J49.1, Q33.1 (B)
unnamed: J50.1, Q35.3 (C)
unnamed: J51.1, Q38.1 (B)
unnamed: Q32.1 (B), Q32.3 (C), Q33.3 (C), Q34.3 (C), Q35.1 (B)
unnamed: Q32.2 (E), R80.2
unnamed: Q33.2 (E), Q34.1 (B)
unnamed: Q34.2 (E), Q37.2 (E), R81.1
unnamed: Q35.2 (E), Q36.2 (E), R82.2
unnamed: Q36.1 (B), Q37.3 (C), Q38.3 (C), Q39.1 (B), Q39.3 (C)
unnamed: Q37.1 (B), Q38.2 (E)
unnamed: Q39.2 (E), R83.2

Notes on the sheet:
revealed op amp comparator
MMBT3906 is BEC

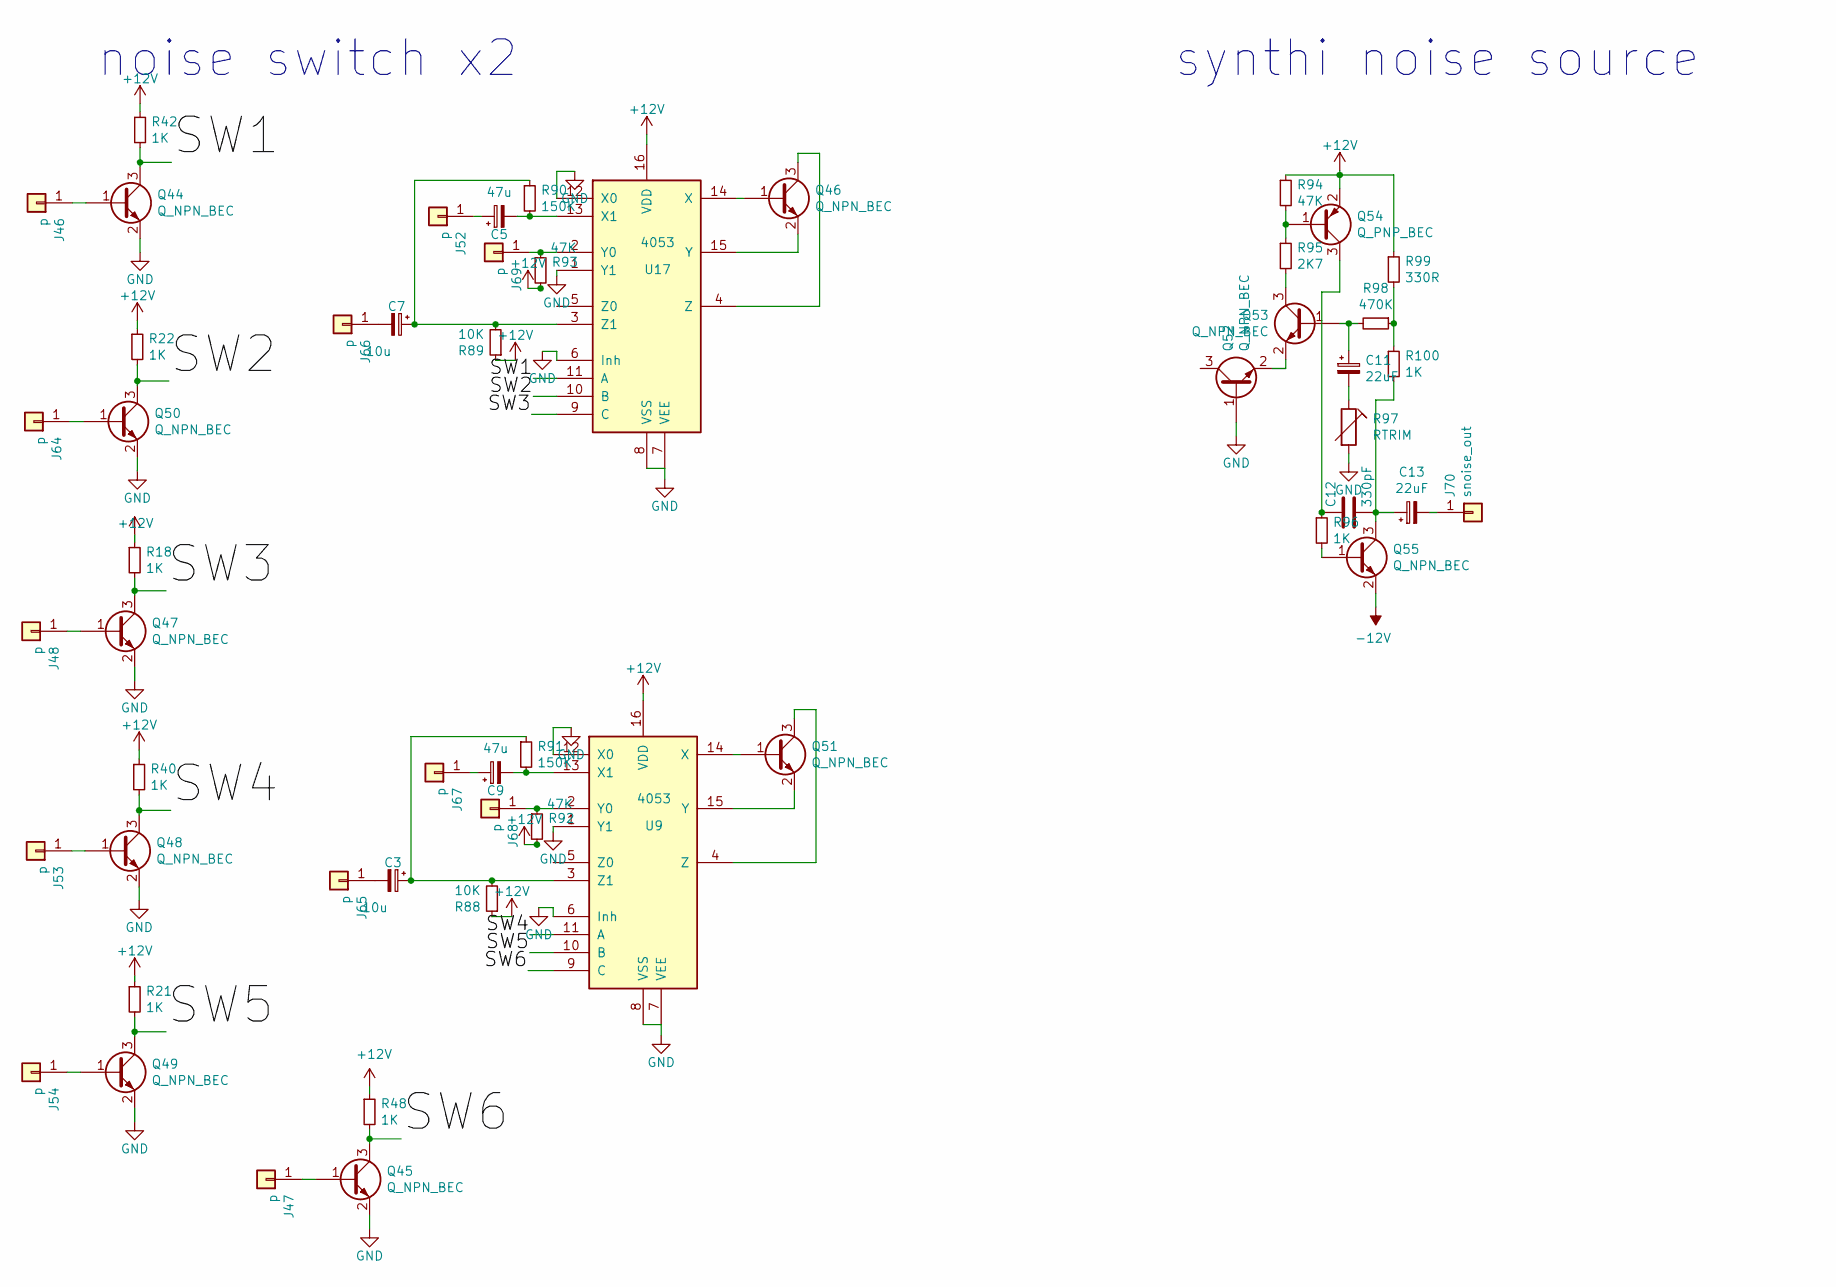
[picture p77: schematic sketches.sch]

Parts:
C3, C7: 10u; SMD-1206_Pol
C5, C9: 47u; SMD-1206_Pol
C11, C13: 22uF; SMD-1206_Pol
C12: 330pF; C_0805
J46, J47, J48, J52, J53, J54, J64, J65, J66, J67, J68, J69: p; Measurement_Point_Square-SMD-Pad_Small
J70: snoise_out; Measurement_Point_Square-SMD-Pad_Small
Q44, Q45, Q46, Q47, Q48, Q49, Q50, Q51, Q52, Q53, Q55: Q_NPN_BEC; SOT-23
Q54: Q_PNP_BEC; SOT-23
R18, R21, R22, R40, R42, R48, R96, R100: 1K; R_0805
R88, R89: 10K; R_0805
R90, R91: 150K; R_0805
R92, R93, R94: 47K; R_0805
R95: 2K7; R_0805
R97: RTRIM; R_0805
R98: 470K; R_0805
R99: 330R; R_0805
U9, U17: 4053; SO-16-N

Connections:
-12V: Q55.2 (E); also elsewhere on the board
/sketching/SW1: Q44.3 (C), R42.2, U17.11 (A)
/sketching/SW2: Q50.3 (C), R22.2, U17.10 (B)
/sketching/SW3: Q47.3 (C), R18.2, U17.9 (C)
/sketching/SW4: Q48.3 (C), R40.2, U9.11 (A)
/sketching/SW5: Q49.3 (C), R21.2, U9.10 (B)
/sketching/SW6: Q45.3 (C), R48.2, U9.9 (C)
unnamed: C3.1, R88.2, R91.1, U9.3 (Z1)
unnamed: C3.2, J65.1
unnamed: C5.1, J52.1
unnamed: C5.2, R90.2, U17.13 (X1)
unnamed: C7.1, R89.2, R90.1, U17.3 (Z1)
unnamed: C7.2, J66.1
unnamed: C9.1, J67.1
unnamed: C9.2, R91.2, U9.13 (X1)
unnamed: C11.1, Q53.1 (B), R98.2
unnamed: C11.2, R97.1
unnamed: C12.1, Q54.3 (C), R96.1
unnamed: C12.2, C13.1, Q55.3 (C), R100.2
unnamed: C13.2, J70.1
unnamed: J46.1, Q44.1 (B)
unnamed: J47.1, Q45.1 (B)
unnamed: J48.1, Q47.1 (B)
unnamed: J53.1, Q48.1 (B)
unnamed: J54.1, Q49.1 (B)
unnamed: J64.1, Q50.1 (B)
unnamed: J68.1, R92.1, U9.2 (Y0)
unnamed: J69.1, R93.1, U17.2 (Y0)
unnamed: Q46.1 (B), U17.14 (X)
unnamed: Q46.2 (E), U17.15 (Y)
unnamed: Q46.3 (C), U17.4 (Z)
unnamed: Q51.1 (B), U9.14 (X)
unnamed: Q51.2 (E), U9.15 (Y)
unnamed: Q51.3 (C), U9.4 (Z)
unnamed: Q52.2 (E), Q53.2 (E)
unnamed: Q53.3 (C), R95.2
unnamed: Q54.1 (B), R94.2, R95.1
unnamed: Q55.1 (B), R96.2
unnamed: R98.1, R99.2, R100.1

Notes on the sheet:
synthi noise source
noise switch x2

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
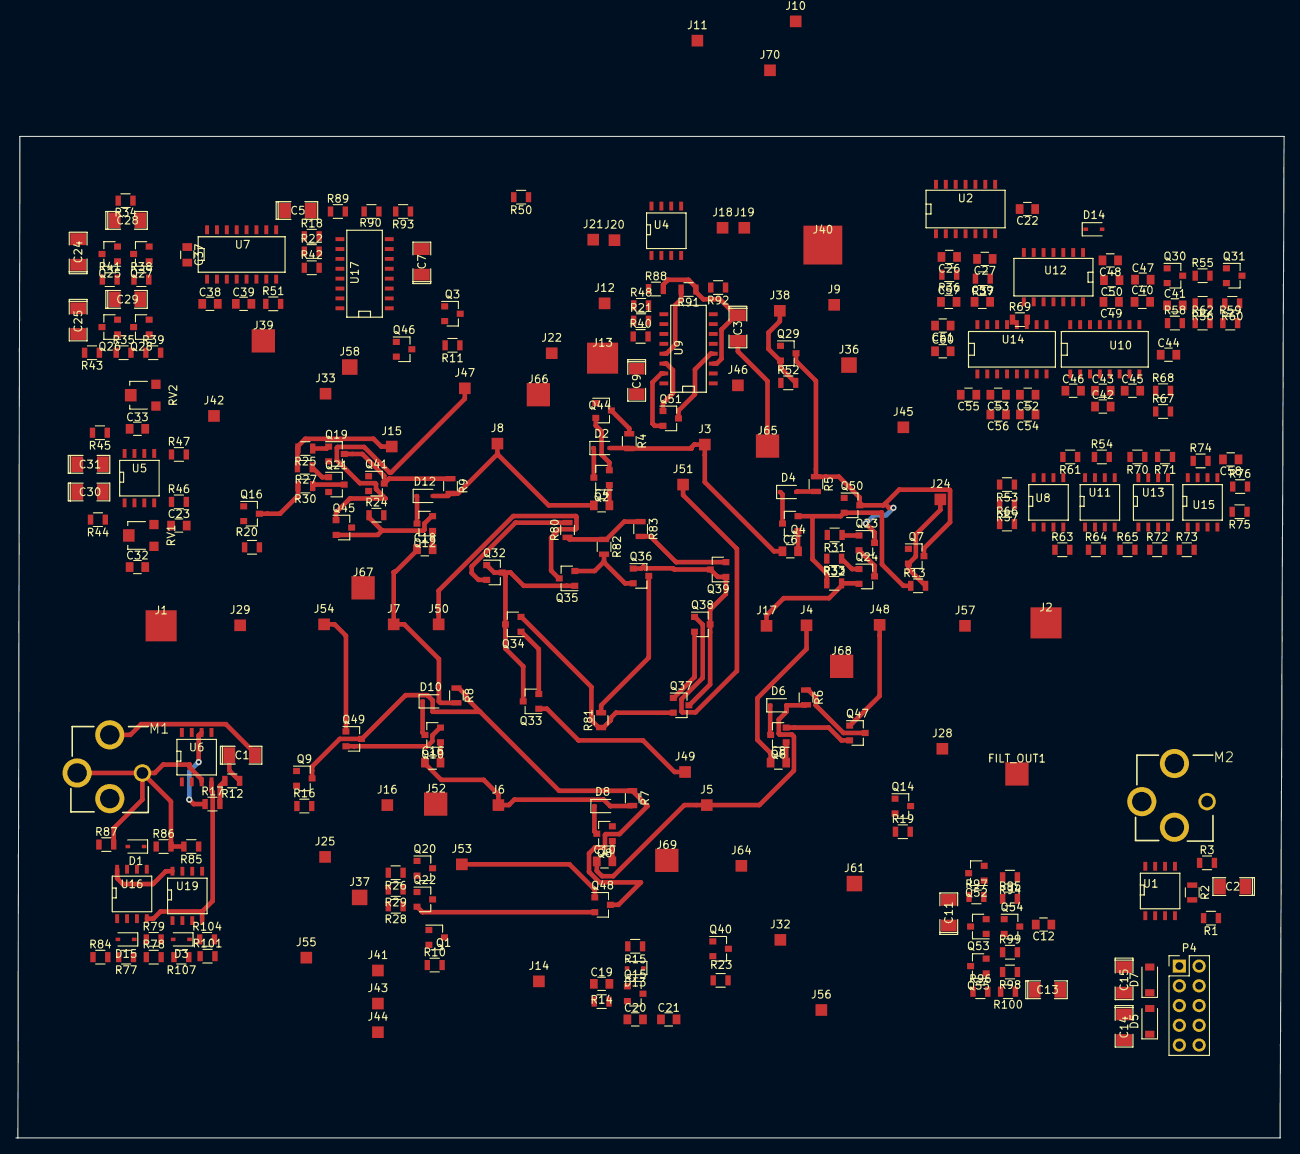
[picture p78: board allcolours_analogue.kicad_pcb from above]

Board: 2 copper layers, 163.1 x 128.8 mm, 301 parts (0 on the bottom side), 192 nets.
