microresearch/allcolours/populus/POPULUS_kicad_old-panelnew/touch_toggle_latest_ADG_lineup.kicad_pcb

## KiCad design populus/POPULUS_kicad_old-panelnew/touch_toggle_latest_ADG_lineup.kicad_pcb (2024-09-28, an earlier design)

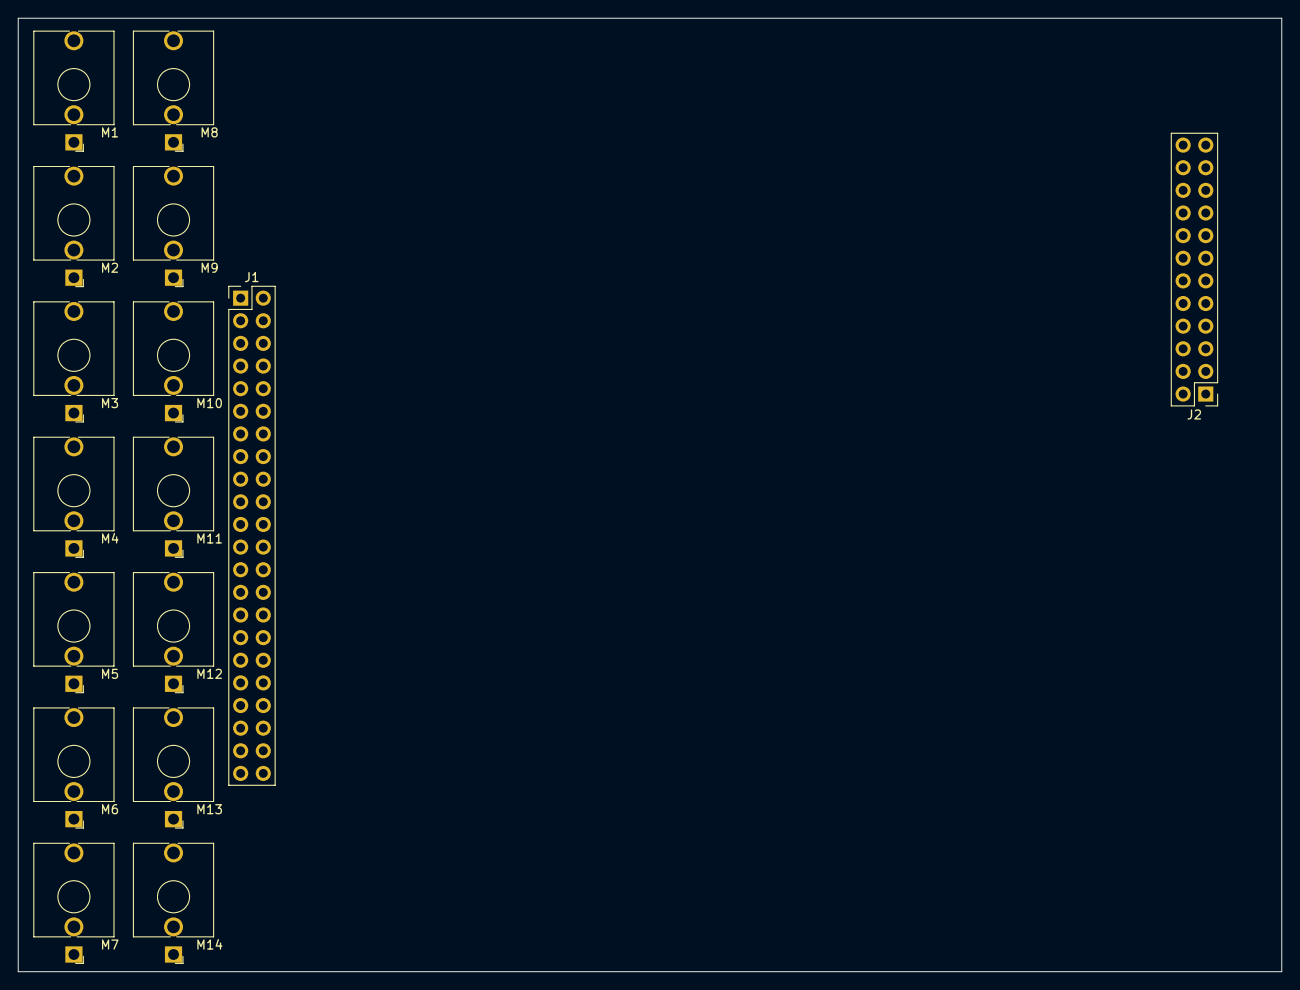
[picture p79: board touch_toggle_latest_ADG_lineup.kicad_pcb from above]

Board: 2 copper layers, 141.8 x 107.0 mm, 16 parts (0 on the bottom side), 15 nets, no tracks yet.

Parts:
J1: Conn_02x18_Odd_Even; PinHeader_2x22_P2.54mm_Vertical
J2: Conn_02x12_Odd_Even; PinHeader_2x12_P2.54mm_Vertical
M1, M2, M3, M4, M5, M6, M7, M8, M9, M10, M11, M12, M13, M14: AUDIO-JACKERTHENVAR-PJ398; Jack_3.5mm_QingPu_WQP-PJ398SM_Vertical_CircularHoles

Connections:
/IN1: J1.1, M1.3 (TIP)
/IN2: J1.3, M2.3 (TIP)
/IN3: J1.5, M3.3 (TIP)
/IN4: J1.7, M4.3 (TIP)
/IN5: J1.9, M5.3 (TIP)
/IN6: J1.11, M6.3 (TIP)
/IN7: J1.13, M7.3 (TIP)
/OUTA: J1.2, M8.3 (TIP)
/OUTB: J1.4, M9.3 (TIP)
/OUTC: J1.6, M10.3 (TIP)
/OUTD: J1.8, M11.3 (TIP)
/OUTE: J1.10, M12.3 (TIP)
/OUTF: J1.12, M13.3 (TIP)
/OUTG: J1.14, M14.3 (TIP)
GND: J1.43, J1.44, J2.21, J2.23, J2.24, M1.1 (RING), M2.1 (RING), M3.1 (RING), M4.1 (RING), M5.1 (RING), M6.1 (RING), M7.1 (RING), M8.1 (RING), M9.1 (RING), M10.1 (RING), M11.1 (RING), M12.1 (RING), M13.1 (RING), M14.1 (RING)
