microresearch/allcolours/touch/touch_kicad_new2024/touch_basecopytotryalign.kicad_pcb

## KiCad design touch/touch_kicad_new2024/touch_basecopytotryalign.kicad_pcb (2020-12-18)

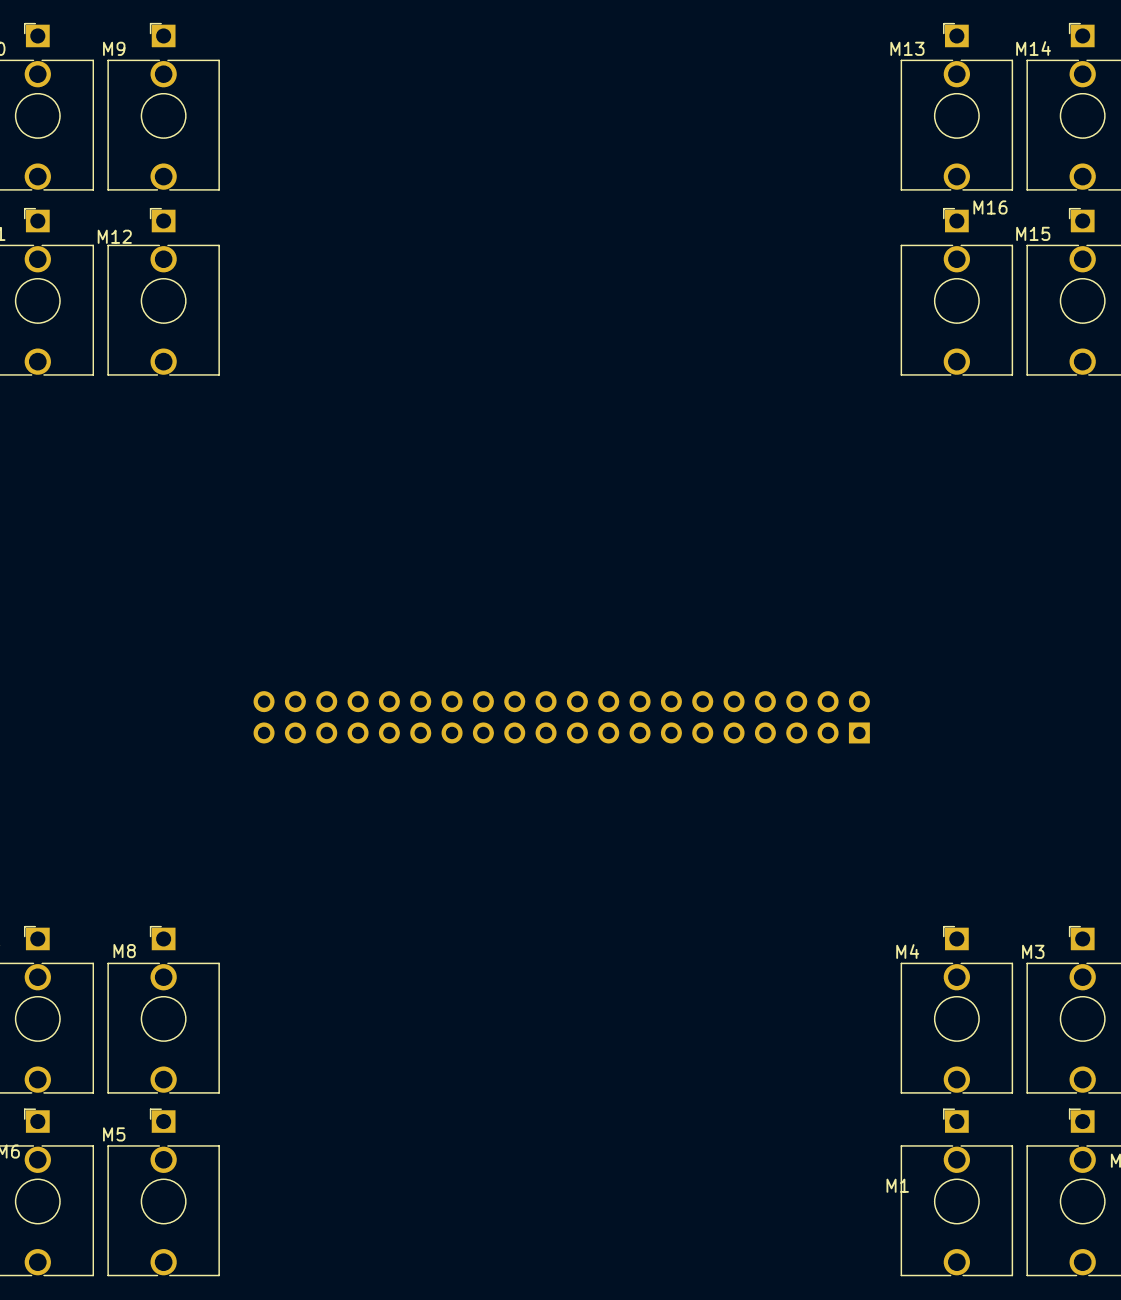
[picture p80: board touch_basecopytotryalign.kicad_pcb from above]

Board: 2 copper layers, 17 parts (1 on the bottom side), 10 nets, no tracks yet.

Parts:
J3: Conn_02x20_Counter_Clockwise; Pin_Header_Straight_2x20_Pitch2.54mm
M1, M2, M3, M4, M5, M6, M7, M8, M9, M10, M11, M12, M13, M14, M15, M16: AUDIO-JACKERTHENVAR-PJ398; Jack_3.5mm_QingPu_WQP-PJ398SM_Vertical_CircularHoles

Connections:
+3.3VA: J3.7, J3.12, J3.25, J3.31, J3.32
C1: J3.15, M2.3
C2: J3.40, M6.3
C3: J3.20, M10.3
C4: J3.2, M14.3
GND: J3.8, J3.9, J3.28, J3.33, M1.1, M2.1, M3.1, M4.1, M5.1, M6.1, M7.1, M8.1, M9.1, M10.1, M11.1, M12.1, M13.1, M14.1, M15.1, M16.1
IN1: J3.17, M3.3
IN2: J3.39, M7.3
IN3: J3.14, M11.3
IN4: J3.5, M15.3
