microresearch/allcolours/touch_toggle_final/touch_toggle_latest_ADG/touch_toggle_latest_ADG.kicad_pcb

## KiCad design touch_toggle_final/touch_toggle_latest_ADG/touch_toggle_latest_ADG.kicad_pcb (2023-12-01)

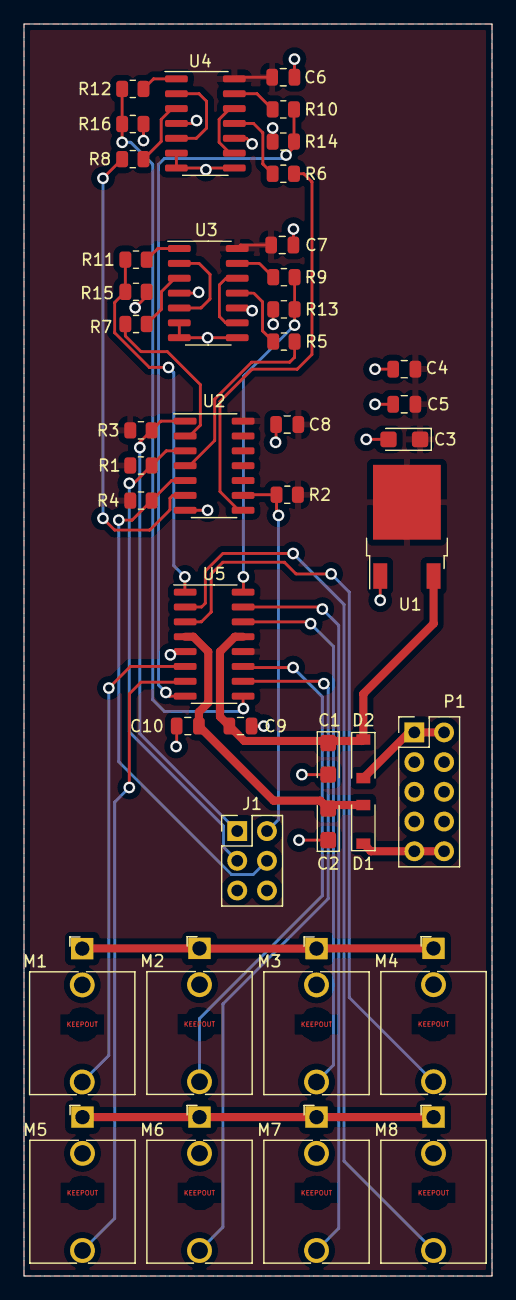
[picture p81: board touch_toggle_latest_ADG.kicad_pcb from above]

Board: 2 copper layers, 40.0 x 107.0 mm, 43 parts (0 on the bottom side), 38 nets.

Parts:
C1, C2, C3: 10u; CP_EIA-3216-18_Kemet-A
C4: 100N; C_0805_2012Metric
C5, C6, C7, C8, C9, C10: 100NF; C_0805_2012Metric
D1, D2: 1N5819; D_SOD-123
J1: Conn_02x03_Odd_Even; PinHeader_2x03_P2.54mm_Vertical
M1, M2, M3, M4, M5, M6, M7, M8: AUDIO-JACKERTHENVAR-PJ398; Jack_3.5mm_QingPu_WQP-PJ398SM_Vertical_CircularHolesKEEPOUT
P1: CONN_02X05; PinHeader_2x05_P2.54mm_Vertical
R1, R2, R3, R4: 4.7M; R_0805_2012Metric
R5, R6, R7, R8, R9, R10, R11, R12: 1K; R_0805_2012Metric
R13, R14, R15, R16: 22K; R_0805_2012Metric
U1: LM1117-5.0; TO-252-2
U2: 40106; SOIC-14_3.9x8.7mm_P1.27mm
U3, U4: 4013; SOIC-14_3.9x8.7mm_P1.27mm
U5: ADG412BNZ; SOIC-16_3.9x9.9mm_P1.27mm

Connections:
+5V: C3.1, C4.1, C5.2, C6.2, C7.2, C8.2, R1.1, R2.1, R3.1, R4.1, U1.2 (VO), U2.14 (VDD), U3.14 (VDD), U4.14 (VDD), U5.12 (VL)
+12V: C1.1, C9.2, D2.1 (K), U1.3 (VI), U5.13 (VDD)
-12V: C2.2, C10.2, D1.2 (A), U5.4 (VSS)
/IN1: M4.3 (TIP), U5.3 (S1)
/IN2: M3.3 (TIP), U5.14 (S2)
/IN3: M2.3 (TIP), U5.11 (S3)
/IN4: M1.3 (TIP), U5.6 (S4)
/OUT1: M8.3 (TIP), U5.2 (D1)
/OUT2: M7.3 (TIP), U5.15 (D2)
/OUT3: M6.3 (TIP), U5.10 (D3)
/OUT4: M5.3 (TIP), U5.7 (D4)
/S1: R11.1, R15.2, U5.1 (IN1)
/S2: R9.1, R13.2, U5.16 (IN2)
/S3: R12.1, R16.2, U5.9 (IN3)
/S4: R10.1, R14.2, U5.8 (IN4)
/SW1: J1.1, R3.2, U2.1
/SW2: J1.3, R1.2, U2.3
/SW3: J1.4, R4.2, U2.5
/SW4: J1.2, R2.2, U2.9
GND: C1.2, C2.1, C3.2, C4.2, C5.1, C6.1, C7.1, C8.1, C9.1, C10.1, J1.5, J1.6, M1.1 (RING), M2.1 (RING), M3.1 (RING), M4.1 (RING), M5.1 (RING), M6.1 (RING), M7.1 (RING), M8.1 (RING), P1.3, P1.4, P1.5, P1.6, P1.7, P1.8, R13.1, R14.1, R15.1, R16.1, U1.1 (GND), U2.7 (VSS), U3.4 (R), U3.6 (S), U3.7 (VSS), U3.8 (S), U3.10 (R), U4.4 (R), U4.6 (S), U4.7 (VSS), U4.8 (S), U4.10 (R), U5.5 (GND)
unnamed: D1.1 (K), P1.9, P1.10
unnamed: D2.2 (A), P1.1, P1.2
unnamed: R5.1, U3.11 (C)
unnamed: R5.2, U2.4
unnamed: R6.1, U4.11 (C)
unnamed: R6.2, U2.8
unnamed: R7.1, U3.3 (C)
unnamed: R7.2, U2.2
unnamed: R8.1, U4.3 (C)
unnamed: R8.2, U2.6
unnamed: R9.2, U3.13 (Q)
unnamed: R10.2, U4.13 (Q)
unnamed: R11.2, U3.1 (Q)
unnamed: R12.2, U4.1 (Q)
unnamed: U3.2 (~Q), U3.5 (D)
unnamed: U3.9 (D), U3.12 (~Q)
unnamed: U4.2 (~Q), U4.5 (D)
unnamed: U4.9 (D), U4.12 (~Q)
