microresearch/allcolours/all_colours_kicad/allcolours_theone.kicad_pcb

## KiCad design all_colours_kicad/allcolours_theone.kicad_pcb (2023-04-05)

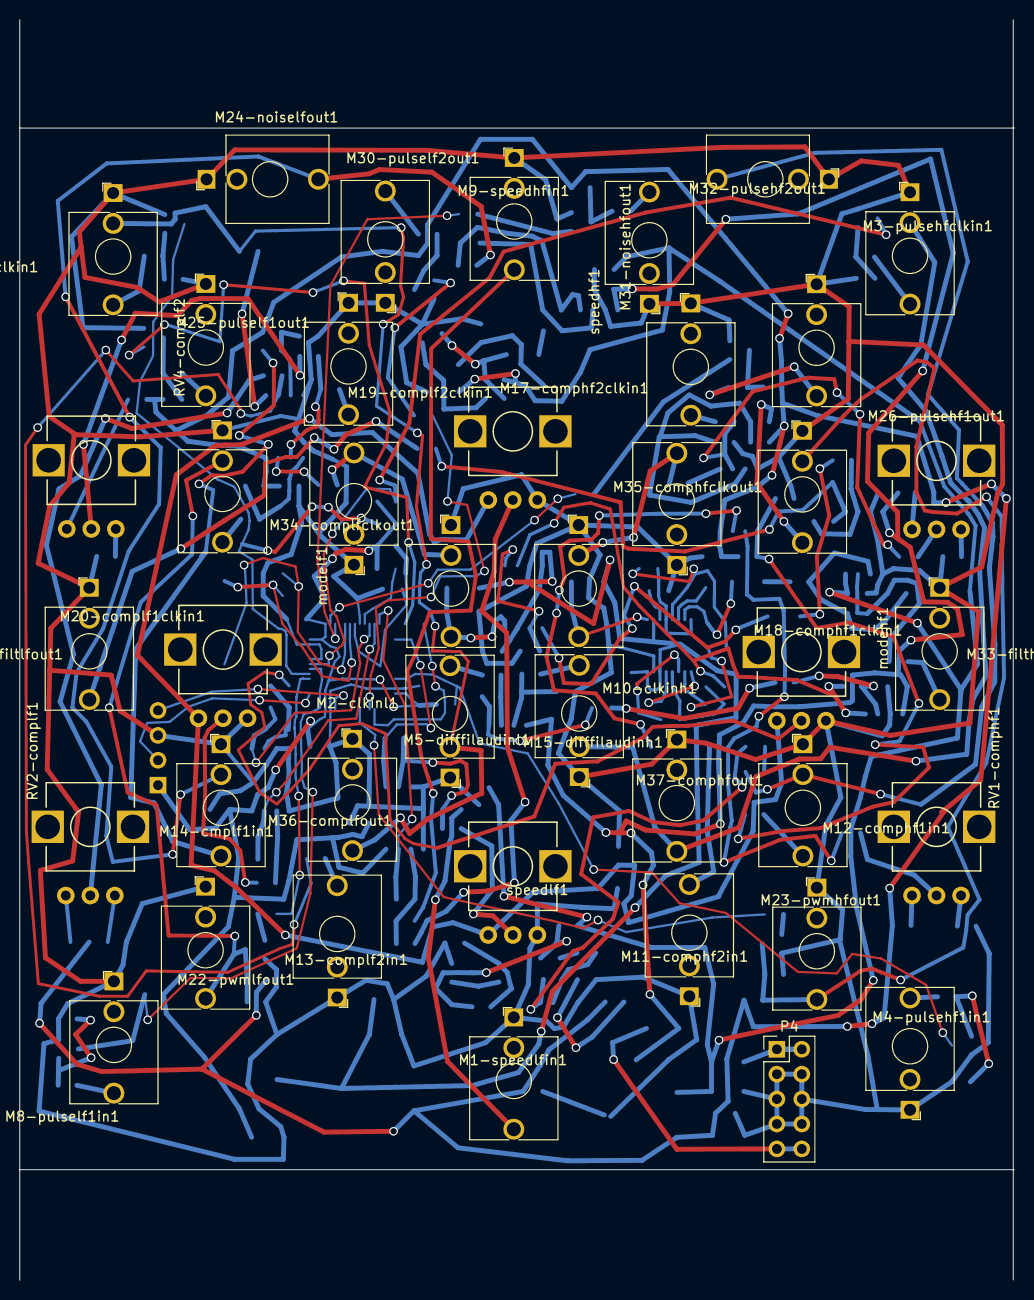
[picture p82: board allcolours_theone.kicad_pcb from above]

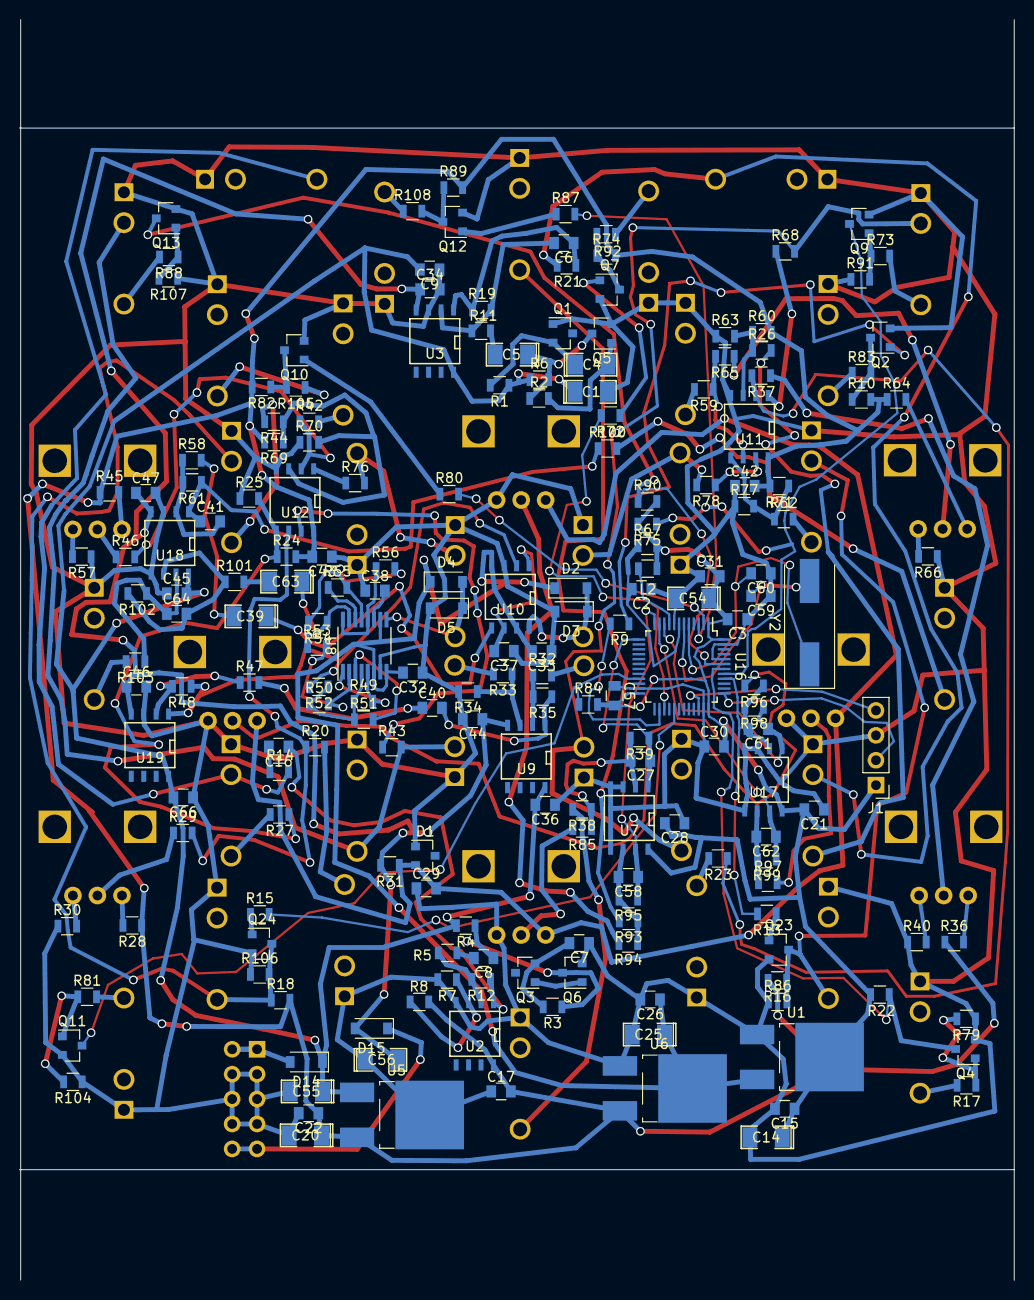
[picture p83: board allcolours_theone.kicad_pcb from below]

Board: 2 copper layers, 101.4 x 128.5 mm, 237 parts (196 on the bottom side), 144 nets.

Parts:
C1, C4: 47u; SMD-1206_Pol
C2, C3, C7, C8, C9, C15, C16, C17, C22, C26, C29, C30, C31, C32, C33, C34, C36, C37, C38, C40, C42, C43, C44, C45, C46, C47, C57, C66: 100N; C_0805
C5, C14, C20, C25, C39, C55, C56, C63: 10u; SMD-1206_Pol
C6: 10p; C_0805
C21, C28: 100nF; C_0805
C27, C58, C61, C62: 1nF; C_0805
C41, C64: 18p; C_0805
C54: 10UF; SMD-1206_Pol
C59, C60: 18P; C_0805
D1: LM4040; SOT-23
D2, D4: BAT85/1n5819; D_SOD-123
D3, D5: 5819; D_SOD-123
D14, D15: D; D_SOD-123
J1: PROG; Pin_Header_Straight_1x04_Pitch2.54mm
L2: INDUCTOR; L_0805
M1-speedlfin1, M2-clkinl1, M3-pulsehfclkin1, M4-pulsehf1in1, M5-difffilaudinl1, M7-pulselfclkin1, M8-pulself1in1, M9-speedhfin1, M10-clkinh1, M11-comphf2in1, M12-comphf1in1, M13-complf2in1, M14-cmplf1in1, M15-difffilaudinh1, M17-comphf2clkin1, M18-comphf1clkin1, M19-complf2clkin1, M20-complf1clkin1, M22-pwmlfout1, M23-pwmhfout1, M24-noiselfout1, M26-pulsehf1out1, M27-filtlfout1, M30-pulself2out1, M31-noisehfout1, M32-pulsehf2out1, M33-filthfout1, M34-complfclkout1, M35-comphfclkout1, M36-complfout1, M37-comphfout1: AUDIO-JACKERTHENVAR; Jack_3.5mm_QingPu_WQP-PJ398SM_Vertical_CircularHoles
M25-pulself1out1: pulself1_out; Jack_3.5mm_QingPu_WQP-PJ398SM_Vertical_CircularHoles
P4: CONN_02X05; Pin_Header_Straight_2x05_Pitch2.54mm
Q1, Q3, Q5, Q6: Q_NPN_BEC; SOT-23
Q2, Q4, Q7, Q9, Q10, Q11, Q12, Q13, Q23, Q24: MMBT3904; SOT-23
R1, R3, R12: 47K; R_0805
R2: 150K; R_0805
R4, R16, R18: 4K7; R_0805
R5, R6, R7, R8, R9, R10, R13, R15, R20, R22, R23, R24, R25, R26, R27, R29, R37, R42, R44, R46, R47, R49, R56, R59, R60, R61, R62, R63, R65, R67, R69, R70, R71, R72, R74, R75, R77, R80, R82, R84, R87, R89, R90, R102: 10K; R_0805
R11: 33k; R_0805
R14, R21, R43, R68, R76, R78, R83, R92, R100, R103, R105, R108: 1K; R_0805
R17, R19, R32, R33, R34, R35, R38, R73, R81, R88, R93: 100K; R_0805
R28, R30, R36, R40, R45, R57, R64, R66: ?adj; R_0805
R31: 470R; R_0805
R39, R95, R98, R99: 66.5K; R_0805
R48, R58, R101: 4.7K; R_0805
R50, R51, R52, R53, R54, R55, R85, R94, R96, R97: 200K; R_0805
R79, R91, R104, R107: 33K; R_0805
R86, R106: 3K3; R_0805
RV1-comphf1, RV2-complf1, RV3-comphf2, RV4-complf2: 10K; Potentiometer_Alps-RK09
U1: LM1117-3.3; TO-252-2_Rectifier
U2, U12: max4392; SOIC-8-N
U3, U9, U11, U18, U19: TL082; SOIC-8-N
U5: L78M10; TO-252-2_Rectifier
U6: LM1117-5.0; TO-252-2_Rectifier
U7, U17: MCP6002; SOIC-8-N
U8: MAX7490-check width; QSOP-16_3.9x4.9mm_Pitch0.635mm
U10: maxim_7400; SOIC-8-N
U16: STM32F103CBTx; LQFP-48_7x7mm_Pitch0.5mm
Y2: 8 MHz; Crystal_SMD_HC49-SD
modehf1: 10K; Potentiometer_Alps-RK09
modelf1: 10K; Potentiometer_Alps-RK09
speedhf1: 10K; Potentiometer_Alps-RK09
speedlf1: 10K; Potentiometer_Alps-RK09

Connections:
+3V3: C3.2, C14.1, C15.1, C21.2, C28.2, C30.2, C31.2, C54.1, C57.2, J1.1, L2.1, R22.2, R67.2, R75.2, R84.2, R90.2, U1.2, U7.8, U16.1, U16.24, U16.36, U16.48, U17.8
+5V: C25.1, C26.1, C32.2, C33.2, D2.1, D4.1, U1.3, U6.2, U8.6, U8.8, U8.10, U10.4, U10.7
+10V: C17.2, C20.1, C22.1, C42.2, C43.2, R8.1, R10.2, R16.2, R18.2, R24.2, R28.1, R36.1, R45.1, R60.2, R64.1, R69.2, R71.2, R74.2, R82.2, R89.2, U2.8, U5.3, U6.3, U11.8, U12.8
+12V: C1.1, C9.2, C36.2, C45.2, C55.1, C66.2, D14.1, R1.1, R4.2, R6.1, U3.8, U5.1, U9.8, U18.8, U19.8
-12VA: C34.1, C44.1, C46.1, C47.1, C56.2, D15.2, R31.2, U3.4, U9.4, U18.4, U19.4
/Sheet5AD5ACBA/RESET: C2.2, R67.1, U16.7
/Sheet5AD5ACBA/SWCLK: J1.2, U16.37
/Sheet5AD5ACBA/SWDIO: J1.4, U16.34
/Sheet5AD5ACBA/modehf: C61.1, R98.1, U16.10, U17.1
/Sheet5AD5ACBA/modelf: C62.1, R99.1, U16.11, U17.7
/Sheet5AD5ACBA/pulsehf1_in: Q11.3, R84.1, U16.21
/Sheet5AD5ACBA/pulsehf1_out: R80.2, U16.2
/Sheet5AD5ACBA/pulsehf2_out: R87.2, U16.3
/Sheet5AD5ACBA/pulsehfclk_in: Q13.3, R90.1, U16.43
/Sheet5AD5ACBA/pulself1_in: Q4.3, R22.1, U16.42
/Sheet5AD5ACBA/pulself1_out: R9.2, U16.26
/Sheet5AD5ACBA/pulself2_out: R72.2, U16.27
/Sheet5AD5ACBA/pulselfclk_in: Q9.3, R75.1, U16.41
/Sheet5AD5ACBA/pwmhf_out: R15.2, U16.29
/Sheet5AD5ACBA/pwmlf_out: R13.2, U16.40
/Sheet5AD5ACBA/speedhf: C58.1, R95.1, U7.7, U16.12
/Sheet5AD5ACBA/speedlf: C27.1, R39.1, U7.1, U16.13
/Sheet5B6C330B/7400_LP: C39.1, U10.5
/Sheet5B6C330B/7490_BP: C63.1, R54.1, U8.15
/Sheet5B6C330B/7490_IN_LOW: R48.1, R52.2, U10.2, U19.1
AREF-10: C29.2, D1.2, R31.1, modehf1.1, modelf1.1, speedhf1.1, speedlf1.1
CLK_INH: D4.2, D5.1, M10-clkinh1.3, U8.9
CLK_INL: D2.2, D3.1, M2-clkinl1.3, U10.8
COMPHF1_CLK_IN: M18-comphf1clkin1.3, R44.2
COMPHF1_IN: M12-comphf1in1.3, R27.2
COMPHF2_CLK_IN: M17-comphf2clkin1.3, R42.2
COMPHF2_IN: M11-comphf2in1.3, R20.2
COMPHFCLK_OUT: M10-clkinh1.2, M35-comphfclkout1.3, R76.2
COMPHF_OUT: M3-pulsehfclkin1.2, M15-difffilaudinh1.2, M37-comphfout1.3, R43.2
COMPLF1_CLK_IN: M20-complf1clkin1.3, R62.2
COMPLF1_IN: M14-cmplf1in1.3, R26.2
COMPLF2_CLK_IN: M19-complf2clkin1.3, R59.2
COMPLF2_IN: M13-complf2in1.3, R23.2
COMPLFCLK_OUT: M2-clkinl1.2, M34-complfclkout1.3, R78.2
COMPLF_OUT: M5-difffilaudinl1.2, M7-pulselfclkin1.2, M36-complfout1.3, R68.2
DIFFAUDOUT: C40.1, R47.2
DIFFFILAUD_INH: M15-difffilaudinh1.3, R33.2
DIFFFILAUD_INL: M5-difffilaudinl1.3, R32.2
FILTHF_OUT: M33-filthfout1.3, R103.2
FILTLF_OUT: M27-filtlfout1.3, R100.2
GND: C1.2, C2.1, C3.1, C7.1, C9.1, C14.2, C15.2, C17.1, C20.2, C21.1, C22.2, C25.2, C26.2, C28.1, C29.1, C30.1, C31.1, C32.1, C33.1, C34.2, C36.1, C37.1, C38.1, C42.1, C43.1, C44.2, C45.1, C46.2, C47.2, C54.2, C55.2, C56.1, C57.1, C59.1, C60.1, C66.1, D1.1, D3.2, D5.2, J1.3, M1-speedlfin1.1, M2-clkinl1.1, M3-pulsehfclkin1.1, M4-pulsehf1in1.1, M5-difffilaudinl1.1, M7-pulselfclkin1.1, M8-pulself1in1.1, M9-speedhfin1.1, M10-clkinh1.1, M11-comphf2in1.1, M12-comphf1in1.1, M13-complf2in1.1, M14-cmplf1in1.1, M15-difffilaudinh1.1, M17-comphf2clkin1.1, M18-comphf1clkin1.1, M19-complf2clkin1.1, M20-complf1clkin1.1, M22-pwmlfout1.1, M23-pwmhfout1.1, M24-noiselfout1.1, M25-pulself1out1.1, M26-pulsehf1out1.1, M27-filtlfout1.1, M30-pulself2out1.1, M31-noisehfout1.1, M32-pulsehf2out1.1, M33-filthfout1.1, M34-complfclkout1.1, M35-comphfclkout1.1, M36-complfout1.1, M37-comphfout1.1, P4.3, P4.4, P4.5, P4.6, P4.7, P4.8, Q1.1, Q2.2, Q4.2, Q5.2, Q6.2, Q7.2, Q9.2, Q10.2, Q11.2, Q12.2, Q13.2, Q23.2, Q24.2, R7.2, R25.1, R30.1, R34.2, R40.1, R57.1, R63.1, R66.1, R70.1, R77.1, R79.1, R86.1, R91.1, R104.1, R106.1, R107.1, U1.1, U2.4, U3.3, U5.2, U6.1, U7.3, U7.4, U7.5, U8.7, U10.3, U11.4, U12.4, U16.8, U16.23, U16.35, U16.44, U16.47, U17.3, U17.4, U17.5, U18.3, U18.5, U19.3, modehf1.3, modelf1.3, speedhf1.3, speedlf1.3
NOISEHF_OUT: M12-comphf1in1.2, M31-noisehfout1.3, R14.1
NOISELF_OUT: M14-cmplf1in1.2, M24-noiselfout1.3, R21.2
unnamed: C4.1, Q1.2, R1.2
unnamed: C4.2, Q5.1, R2.2
unnamed: C5.1, Q5.3, R2.1, R6.2
unnamed: C5.2, R11.2
unnamed: C6.1, R19.1, R21.1, U3.1
unnamed: C6.2, R11.1, R19.2, U3.2
unnamed: C7.2, Q3.2, R3.2
unnamed: C8.1, Q6.3, R3.1, R4.1
unnamed: C8.2, R5.2
unnamed: C16.1, R12.1, U2.1
unnamed: C16.2, R14.2
unnamed: C27.2, R38.1, R39.2, R85.1, U7.2
unnamed: C37.2, U10.1, U10.6
unnamed: C38.2, U8.11
unnamed: C39.2, R58.2
unnamed: C40.2, R35.1, U9.1
unnamed: C41.1, R61.1, R100.1, U18.1
unnamed: C41.2, R58.1, R61.2, U18.2
unnamed: C58.2, R93.1, R94.1, R95.2, U7.6
unnamed: C59.2, U16.6, Y2.2
unnamed: C60.2, U16.5, Y2.1
unnamed: C61.2, R96.1, R98.2, U17.2
unnamed: C62.2, R97.1, R99.2, U17.6
unnamed: C63.2, R101.2
unnamed: C64.1, R102.1, R103.1, U18.7
unnamed: C64.2, R101.1, R102.2, U18.6
unnamed: D14.2, P4.1, P4.2
unnamed: D15.1, P4.9, P4.10
unnamed: L2.2, U16.9
unnamed: Q2.1, R9.1
unnamed: Q2.3, R10.1, R83.2
unnamed: Q3.1, Q6.1
unnamed: Q4.1, R17.1, R79.2
unnamed: Q7.1, R72.1
unnamed: Q7.3, R74.1, R92.2
unnamed: Q9.1, R73.1, R91.2
unnamed: Q10.1, R80.1
unnamed: Q10.3, R82.1, R105.2
unnamed: Q11.1, R81.1, R104.2
unnamed: Q12.1, R87.1
unnamed: Q12.3, R89.1, R108.2
unnamed: Q13.1, R88.1, R107.2
unnamed: Q23.1, R13.1
unnamed: Q24.1, R15.1
unnamed: R7.1, R8.2, U2.3
unnamed: R5.1, R12.2, U2.2
unnamed: R20.1, R29.2, U12.6
unnamed: R23.1, R37.2, U11.2
unnamed: R24.1, R25.2, R27.1, U12.5
unnamed: R26.1, R60.1, R63.2, U11.3
unnamed: R28.2, RV1-comphf1.1
unnamed: R29.1, RV1-comphf1.2
unnamed: R30.2, RV1-comphf1.3
unnamed: R32.1, R35.2, U9.2
unnamed: R33.1, R34.1, U9.3
unnamed: R36.2, RV2-complf1.1
unnamed: R37.1, RV2-complf1.2
unnamed: R40.2, RV2-complf1.3
unnamed: R42.1, R46.2, U12.2
unnamed: R43.1, U12.7
unnamed: R44.1, R69.1, R70.2, U12.3
unnamed: R45.2, RV3-comphf2.1
unnamed: R46.1, RV3-comphf2.2
unnamed: R47.1, R48.2, U19.2
unnamed: R49.1, R50.1, R51.1, R52.1, U8.4
unnamed: R49.2, U8.1, U8.5
unnamed: R50.2, R53.2, U8.2
unnamed: R51.2, U8.3
unnamed: R53.1, R54.2, R55.2, R56.2, U8.13
unnamed: R55.1, U8.14
unnamed: R56.1, U8.12, U8.16
unnamed: R57.2, RV3-comphf2.3
unnamed: R59.1, R65.2, U11.6
unnamed: R62.1, R71.1, R77.2, U11.5
unnamed: R64.2, RV4-complf2.1
unnamed: R65.1, RV4-complf2.2
unnamed: R66.2, RV4-complf2.3
unnamed: R68.1, U11.1
unnamed: R76.1, U12.1
unnamed: R78.1, U11.7
unnamed: R85.2, speedlf1.2
unnamed: R94.2, speedhf1.2
unnamed: R96.2, modehf1.2
unnamed: R97.2, modelf1.2
PULSEHF1_IN: M4-pulsehf1in1.3, R81.2
PULSEHF1_OUT: M26-pulsehf1out1.3, R105.1
PULSEHF2_OUT: M32-pulsehf2out1.3, R108.1
PULSEHFCLK_IN: M3-pulsehfclkin1.3, R88.2
PULSELF1_IN: M8-pulself1in1.3, R17.2
PULSELF1_OUT: M25-pulself1out1.3, R83.1
PULSELF2_OUT: M30-pulself2out1.3, R92.1
PULSELFCLK_IN: M7-pulselfclkin1.3, R73.2
PWMHF_OUT: M18-comphf1clkin1.2, M23-pwmhfout1.3, Q24.3, R18.1, R106.2
PWMLF_OUT: M20-complf1clkin1.2, M22-pwmlfout1.3, Q23.3, R16.1, R86.2
SPEEDHF_IN: M9-speedhfin1.3, R93.2
SPEEDLF_IN: M1-speedlfin1.3, R38.2
