microresearch/allcolours/filter/filter.kicad_pcb

## KiCad design filter/filter.kicad_pcb (2020-07-20)

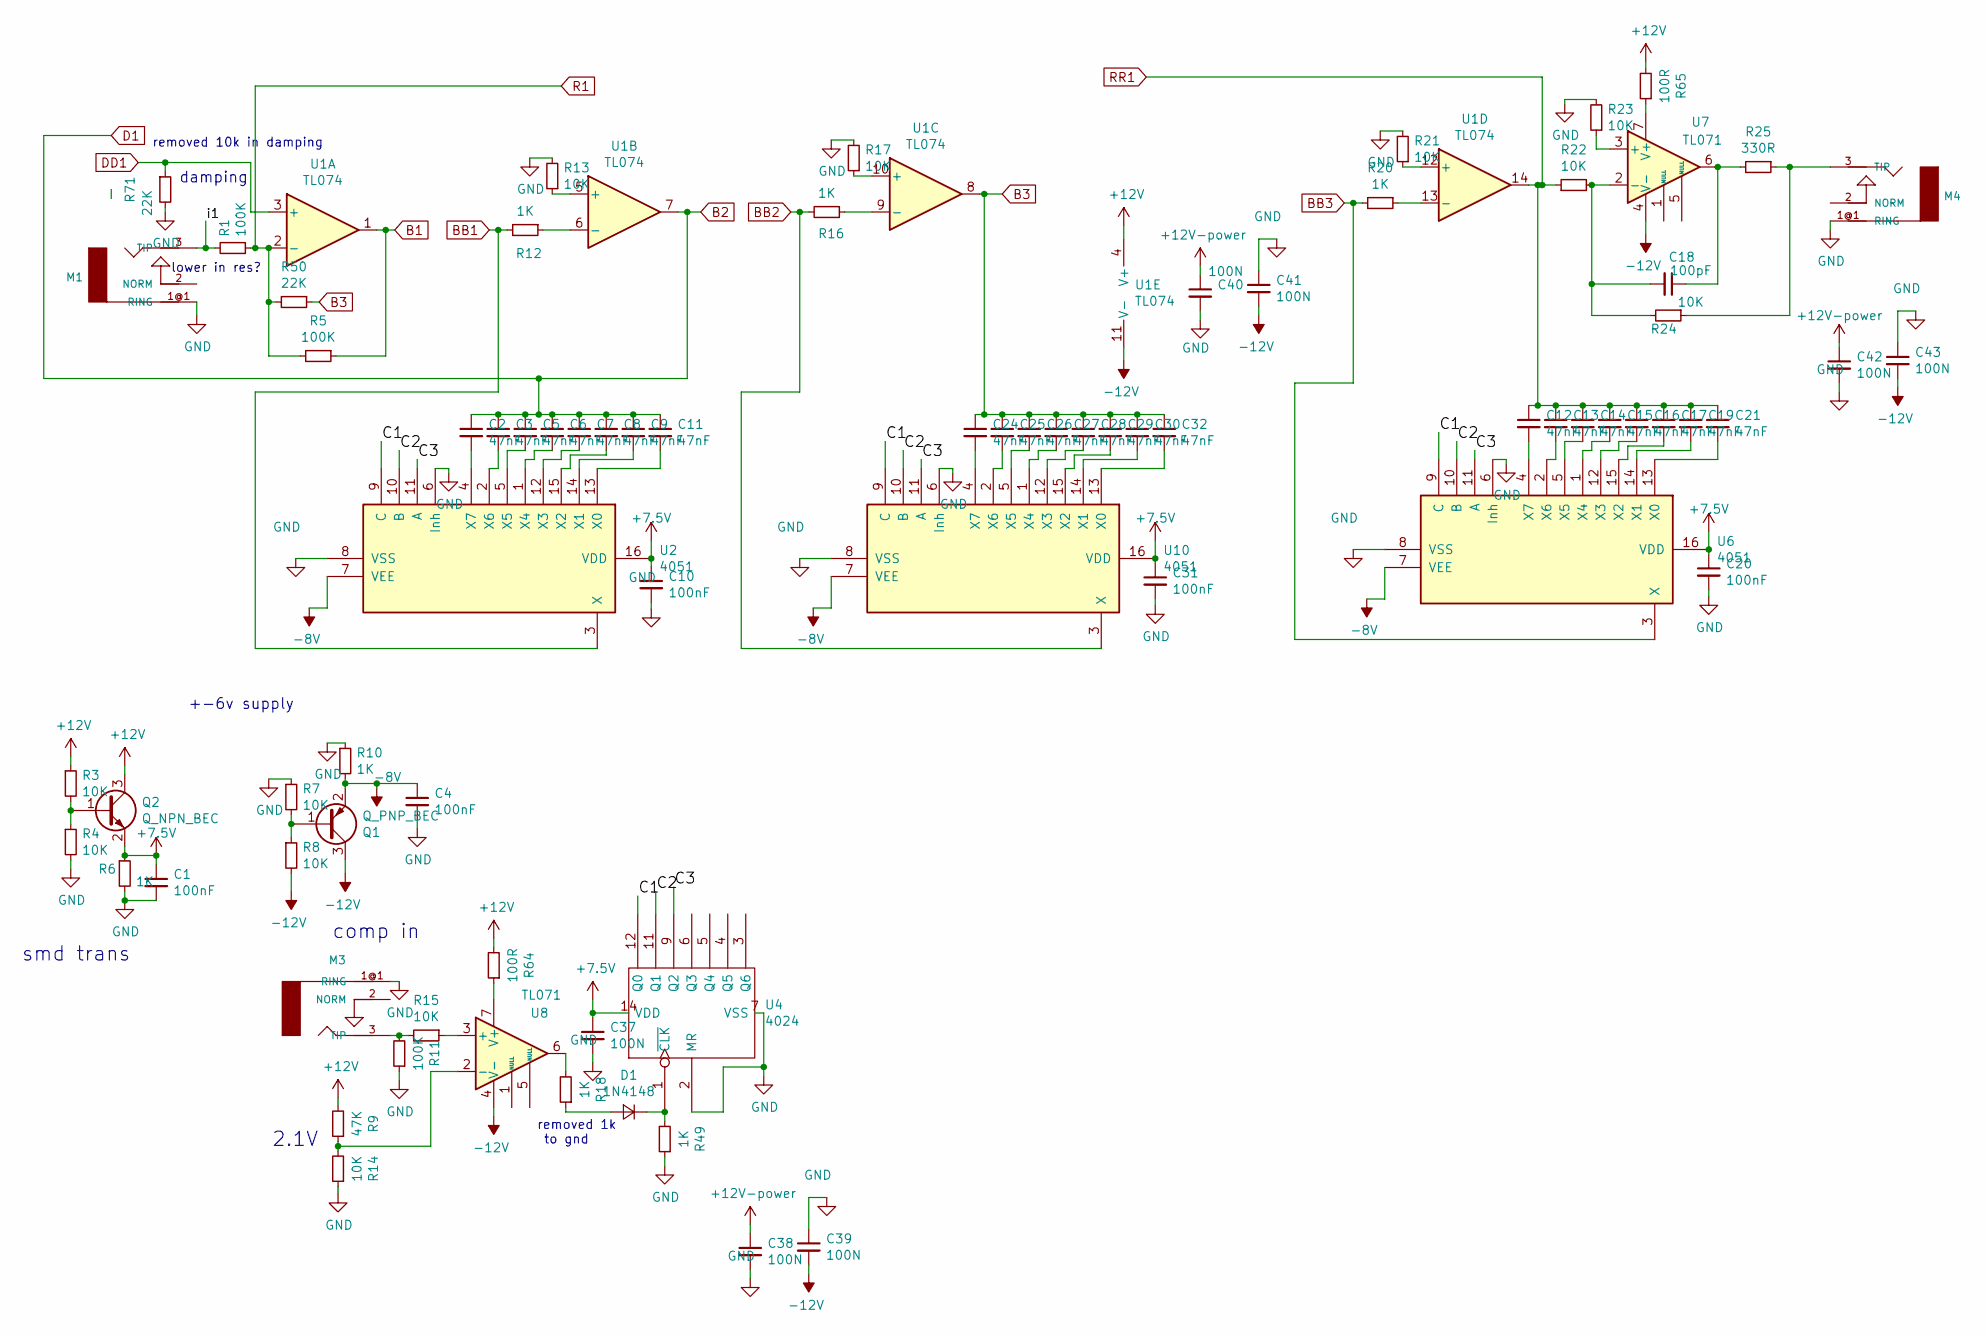
[picture p84: schematic bintic.sch]

Parts:
C1, C4, C10, C20, C31: 100nF; C_0805
C2, C3, C5, C6, C7, C8, C9, C11, C12, C13, C14, C15, C16, C17, C19, C21, C24, C25, C26, C27, C28, C29, C30, C32: 47nF; C_0805
C18: 100pF; C_0805
C37, C38, C39, C40, C41, C42, C43: 100N; C_0805
D1: 1N4148; D_SOD-123
M1, M3, M4: AUDIO-JACKERTHENVAR; ERTHENVAR-JACK
Q1: Q_PNP_BEC; SOT-23
Q2: Q_NPN_BEC; SOT-23
R1, R5, R11: 100K; R_0805
R3, R4, R7, R8, R13, R14, R15, R17, R21, R22, R23, R24: 10K; R_0805
R6, R10, R12, R16, R18, R20, R49: 1K; R_0805
R9: 47K; R_0805
R25: 330R; R_0805
R50, R71: 22K; R_0805
R64, R65: 100R; R_0805
U1: TL074; SOIC-14_N
U2, U6, U10: 4051; SO-16-N
U4: 4024; SOIC-14_N
U7, U8: TL071; SOIC-8-N

Connections:
+7.5V: C1.1, C10.1, C20.1, C31.1, C37.1, Q2.2 (E), R6.1, U2.16 (VDD), U4.14 (VDD), U6.16 (VDD), U10.16 (VDD)
-8V: C4.1, Q1.2 (E), R10.2, U2.7 (VEE), U6.7 (VEE), U10.7 (VEE)
-12V: C39.2, C41.2, C43.2, Q1.3 (C), R8.2, U1.11 (V-), U7.4 (V-), U8.4 (V-); also elsewhere on the board
/bintic/C1: U2.9 (C), U4.12 (Q0), U6.9 (C), U10.9 (C)
/bintic/C2: U2.10 (B), U4.11 (Q1), U6.10 (B), U10.10 (B)
/bintic/C3: U2.11 (A), U4.9 (Q2), U6.11 (A), U10.11 (A)
/bintic/i1: M1.3 (TIP), R1.2
B1: R5.1, U1.1; also elsewhere on the board
B2: C2.1, C3.1, C5.1, C6.1, C7.1, C8.1, C9.1, C11.1, U1.7; also elsewhere on the board
B3: C24.1, C25.1, C26.1, C27.1, C28.1, C29.1, C30.1, C32.1, R50.1, U1.8; also elsewhere on the board
BB1: R12.2, U2.3 (X); also elsewhere on the board
BB2: R16.2, U10.3 (X); also elsewhere on the board
BB3: R20.2, U6.3 (X); also elsewhere on the board
DD1: R71.1, U1.3 (+); also elsewhere on the board
GND: C1.2, C4.2, C10.2, C20.2, C31.2, C37.2, C38.2, C39.1, C40.2, C41.1, C42.2, C43.1, M1.1@1 (RING), M1.1@2 (RING), M3.1@1 (RING), M3.1@2 (RING), M4.1@1 (RING), M4.1@2 (RING), R4.2, R6.2, R7.1, R10.1, R11.1, R13.2, R14.1, R17.2, R21.2, R23.2, R49.1, R71.2, U2.6 (Inh), U2.8 (VSS), U4.2 (MR), U4.7 (VSS), U6.6 (Inh), U6.8 (VSS), U10.6 (Inh), U10.8 (VSS); also elsewhere on the board
unnamed: C2.2, U2.4 (X7)
unnamed: C3.2, U2.2 (X6)
unnamed: C5.2, U2.5 (X5)
unnamed: C6.2, U2.1 (X4)
unnamed: C7.2, U2.12 (X3)
unnamed: C8.2, U2.15 (X2)
unnamed: C9.2, U2.14 (X1)
unnamed: C11.2, U2.13 (X0)
unnamed: C12.2, U6.4 (X7)
unnamed: C13.2, U6.2 (X6)
unnamed: C14.2, U6.5 (X5)
unnamed: C15.2, U6.1 (X4)
unnamed: C16.2, U6.12 (X3)
unnamed: C17.2, U6.15 (X2)
unnamed: C18.1, R25.2, U7.6
unnamed: C18.2, R22.2, R24.2, U7.2 (-)
unnamed: C19.2, U6.14 (X1)
unnamed: C21.2, U6.13 (X0)
unnamed: C24.2, U10.4 (X7)
unnamed: C25.2, U10.2 (X6)
unnamed: C26.2, U10.5 (X5)
unnamed: C27.2, U10.1 (X4)
unnamed: C28.2, U10.12 (X3)
unnamed: C29.2, U10.15 (X2)
unnamed: C30.2, U10.14 (X1)
unnamed: C32.2, U10.13 (X0)
unnamed: D1.1 (K), R49.2, U4.1 (~CLK)
unnamed: D1.2 (A), R18.1
unnamed: M3.3 (TIP), R11.2, R15.2
unnamed: M4.3 (TIP), R24.1, R25.1
unnamed: Q1.1 (B), R7.2, R8.1
unnamed: Q2.1 (B), R3.2, R4.1
unnamed: R12.1, U1.6 (-)
unnamed: R13.1, U1.5 (+)
unnamed: R9.1, R14.2, U8.2 (-)
unnamed: R15.1, U8.3 (+)
unnamed: R16.1, U1.9 (-)
unnamed: R17.1, U1.10 (+)
unnamed: R18.2, U8.6
unnamed: R20.1, U1.13 (-)
unnamed: R21.1, U1.12 (+)
unnamed: R23.1, U7.3 (+)
unnamed: R64.1, U8.7 (V+)
unnamed: R65.1, U7.7 (V+)
R1: R1.1, R5.2, R50.2, U1.2 (-); also elsewhere on the board
RR1: C12.1, C13.1, C14.1, C15.1, C16.1, C17.1, C19.1, C21.1, R22.1, U1.14; also elsewhere on the board

Notes on the sheet:
+-6v supply
smd trans
damping
comp in
2.1V
removed 1k to gnd
lower in res?
removed 10k in damping

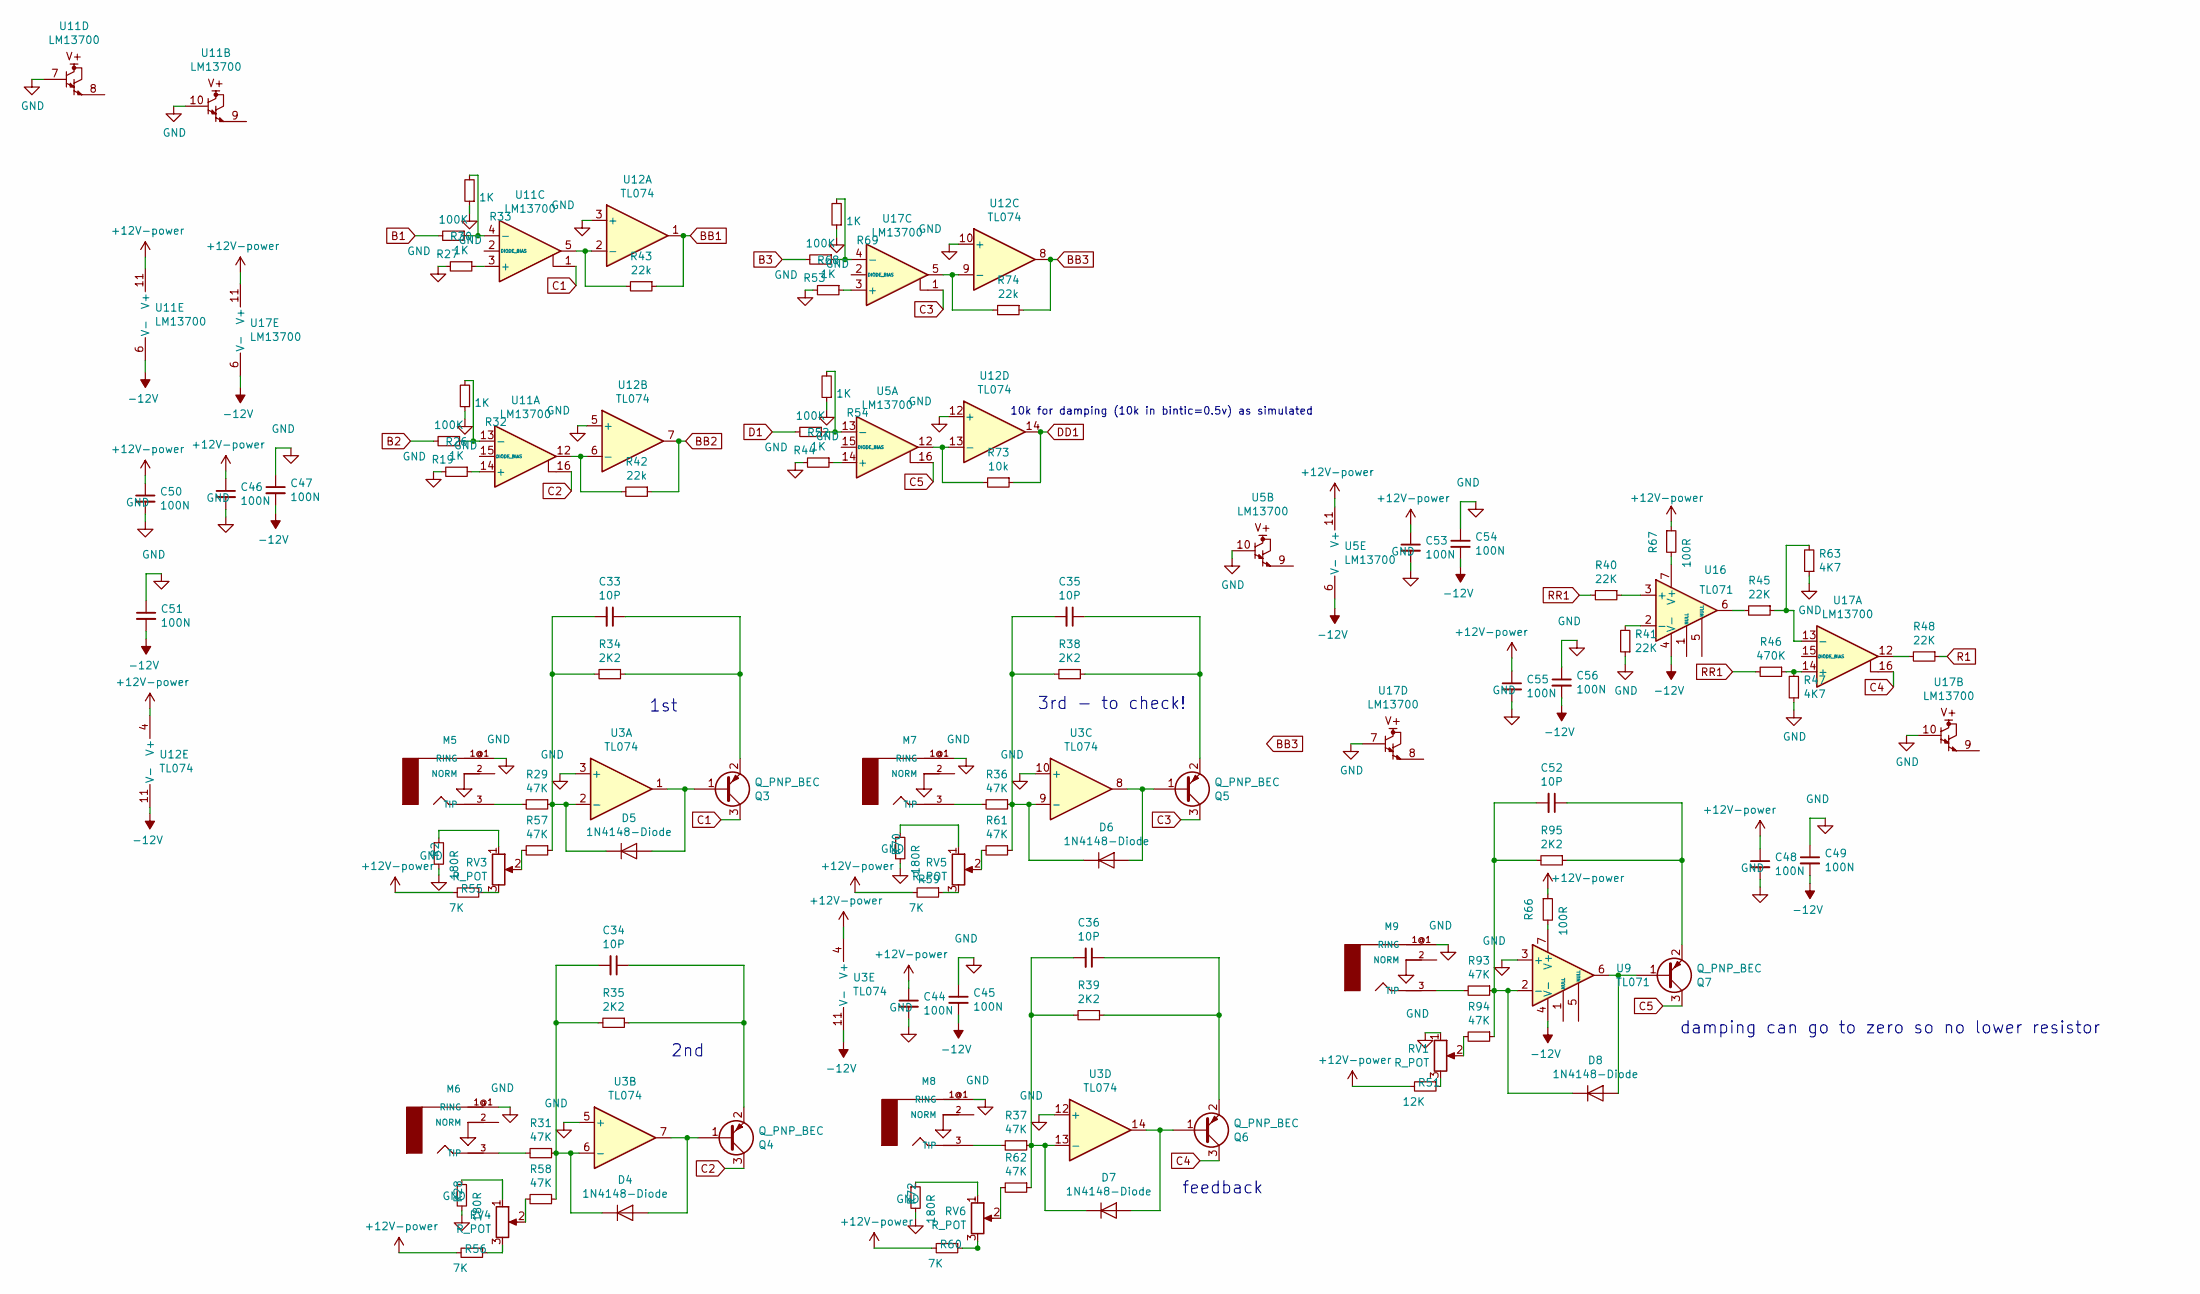
[picture p85: schematic control.sch]

Parts:
C33, C34, C35, C36, C52: 10P; C_0805
C44, C45, C46, C47, C48, C49, C50, C51, C53, C54, C55, C56: 100N; C_0805
D4, D5, D6, D7, D8: 1N4148-Diode; D_SOD-123
M5, M6, M7, M8, M9: AUDIO-JACKERTHENVAR; ERTHENVAR-JACK
Q3, Q4, Q5, Q6, Q7: Q_PNP_BEC; SOT-23
R2, R28, R70, R72: 180R; R_0805
R19, R27, R44, R53: 100K; R_0805
R26, R30, R32, R33, R52, R54, R68, R69: 1K; R_0805
R29, R31, R36, R37, R57, R58, R61, R62, R93, R94: 47K; R_0805
R34, R35, R38, R39, R95: 2K2; R_0805
R40, R41, R45, R48: 22K; R_0805
R42, R43, R74: 22k; R_0805
R46: 470K; R_0805
R47, R63: 4K7; R_0805
R51: 12K; R_0805
R55, R56, R59, R60: 7K; R_0805
R66, R67: 100R; R_0805
R73: 10k; R_0805
RV1, RV3, RV4, RV5, RV6: R_POT; Potentiometer_Alps-RK09
U3, U12: TL074; SOIC-14_N
U5, U11, U17: LM13700; SO-16-N
U9, U16: TL071; SOIC-8-N

Connections:
-12V: C45.2, C47.2, C49.2, C51.2, C54.2, C56.2, U3.11 (V-), U5.6 (V-), U9.4 (V-), U11.6 (V-), U12.11 (V-), U16.4 (V-), U17.6 (V-); also elsewhere on the board
B1: R27.2; also elsewhere on the board
B2: R19.2, R44.2; also elsewhere on the board
B3: R53.2; also elsewhere on the board
BB1: R43.1, U12.1; also elsewhere on the board
BB2: R42.1, U12.7; also elsewhere on the board
BB3: R74.1, U12.8; also elsewhere on the board
C1: Q3.3 (C), U11.1
C2: Q4.3 (C), U11.16
C3: Q5.3 (C), U17.1
C4: Q6.3 (C), U17.16
C5: Q7.3 (C), U5.16
DD1: R73.1, U12.14; also elsewhere on the board
GND: C44.2, C45.1, C46.2, C47.1, C48.2, C49.1, C50.2, C51.1, C53.2, C54.1, C55.2, C56.1, M5.1@1 (RING), M5.1@2 (RING), M6.1@1 (RING), M6.1@2 (RING), M7.1@1 (RING), M7.1@2 (RING), M8.1@1 (RING), M8.1@2 (RING), M9.1@1 (RING), M9.1@2 (RING), R2.2, R26.2, R28.2, R30.2, R32.1, R33.1, R41.1, R47.1, R52.2, R54.1, R63.1, R68.2, R69.1, R70.2, R72.2, RV1.1, U3.3 (+), U3.5 (+), U3.10 (+), U3.12 (+), U5.10, U9.3 (+), U11.7, U11.10, U12.3 (+), U12.5 (+), U12.10 (+), U12.12 (+), U17.7, U17.10; also elsewhere on the board
unnamed: C33.1, Q3.2 (E), R34.1
unnamed: C33.2, D5.1 (K), R29.1, R34.2, R57.1, U3.2 (-)
unnamed: C34.1, Q4.2 (E), R35.1
unnamed: C34.2, D4.1 (K), R31.1, R35.2, R58.1, U3.6 (-)
unnamed: C35.1, Q5.2 (E), R38.1
unnamed: C35.2, D6.1 (K), R36.1, R38.2, R61.1, U3.9 (-)
unnamed: C36.1, Q6.2 (E), R39.1
unnamed: C36.2, D7.1 (K), R37.1, R39.2, R62.1, U3.13 (-)
unnamed: C52.1, Q7.2 (E), R95.1
unnamed: C52.2, D8.1 (K), R93.1, R94.1, R95.2, U9.2 (-)
unnamed: D4.2 (A), Q4.1 (B), U3.7
unnamed: D5.2 (A), Q3.1 (B), U3.1
unnamed: D6.2 (A), Q5.1 (B), U3.8
unnamed: D7.2 (A), Q6.1 (B), U3.14
unnamed: D8.2 (A), Q7.1 (B), U9.6
unnamed: M5.3 (TIP), R29.2
unnamed: M6.3 (TIP), R31.2
unnamed: M7.3 (TIP), R36.2
unnamed: M8.3 (TIP), R37.2
unnamed: M9.3 (TIP), R93.2
unnamed: R2.1, RV3.1
unnamed: R19.1, R32.2, U11.13 (-)
unnamed: R26.1, U11.14 (+)
unnamed: R27.1, R33.2, U11.4 (-)
unnamed: R28.1, RV4.1
unnamed: R30.1, U11.3 (+)
unnamed: R40.1, U16.3 (+)
unnamed: R41.2, U16.2 (-)
unnamed: R42.2, U11.12, U12.6 (-)
unnamed: R43.2, U11.5, U12.2 (-)
unnamed: R44.1, R54.2, U5.13 (-)
unnamed: R45.1, R63.2, U17.13 (-)
unnamed: R45.2, U16.6
unnamed: R46.1, R47.2, U17.14 (+)
unnamed: R48.2, U17.12
unnamed: R51.1, RV1.3
unnamed: R52.1, U5.14 (+)
unnamed: R53.1, R69.2, U17.4 (-)
unnamed: R55.1, RV3.3
unnamed: R56.1, RV4.3
unnamed: R57.2, RV3.2
unnamed: R58.2, RV4.2
unnamed: R59.1, RV5.3
unnamed: R60.1, RV6.3
unnamed: R61.2, RV5.2
unnamed: R62.2, RV6.2
unnamed: R66.2, U9.7 (V+)
unnamed: R67.2, U16.7 (V+)
unnamed: R68.1, U17.3 (+)
unnamed: R70.1, RV5.1
unnamed: R72.1, RV6.1
unnamed: R73.2, U5.12, U12.13 (-)
unnamed: R74.2, U12.9 (-), U17.5
unnamed: R94.2, RV1.2
R1: R48.1; also elsewhere on the board
RR1: R40.2, R46.2; also elsewhere on the board

Notes on the sheet:
damping can go to zero so no lower resistor
feedback
1st
2nd
3rd - to check!
10k for damping (10k in bintic=0.5v) as simulated

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
Board: 2 copper layers, 176 parts (162 on the bottom side), 123 nets, no tracks yet.

Other parts of the board:
C22, C23: 10u; SMD-1206_Pol
D2, D3: 1N5158; D_SOD-123
P1: CONN_02X05; Pin_Header_Straight_2x05_Pitch2.54mm

Their connections:
-12V: C22.2, D2.2; also elsewhere on the board
GND: C22.1, C23.2, P1.3, P1.4, P1.5, P1.6, P1.7, P1.8; also elsewhere on the board
unnamed: D2.1, P1.9, P1.10
unnamed: D3.2, P1.1, P1.2
