microresearch/allcolours/touch/touch_kicad_2024/touch_panel_filter/panel_touch.kicad_sch

## KiCad design touch/touch_kicad_2024/touch_panel_filter/panel_touch.kicad_sch (2023-10-03)

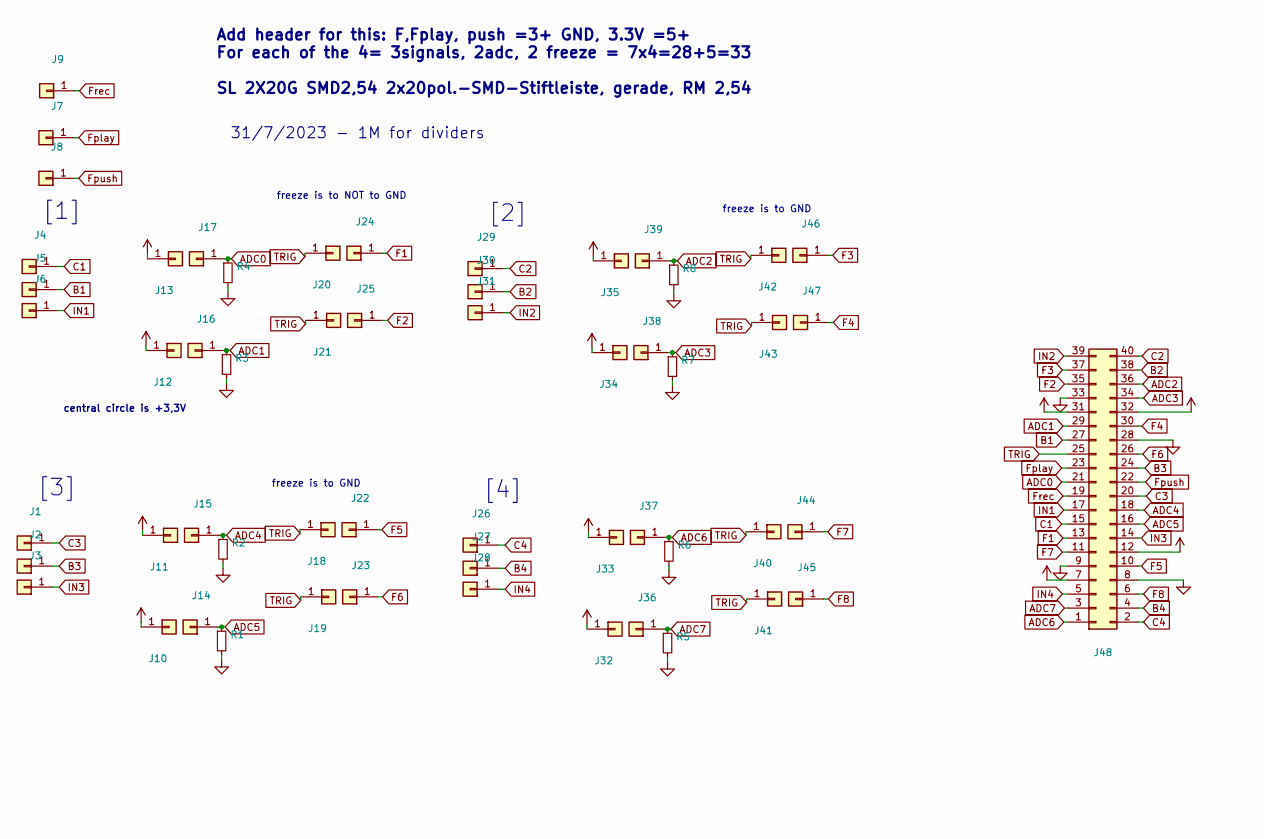
[picture p86: schematic panel_touch.kicad_sch, part in row 1, column 1]

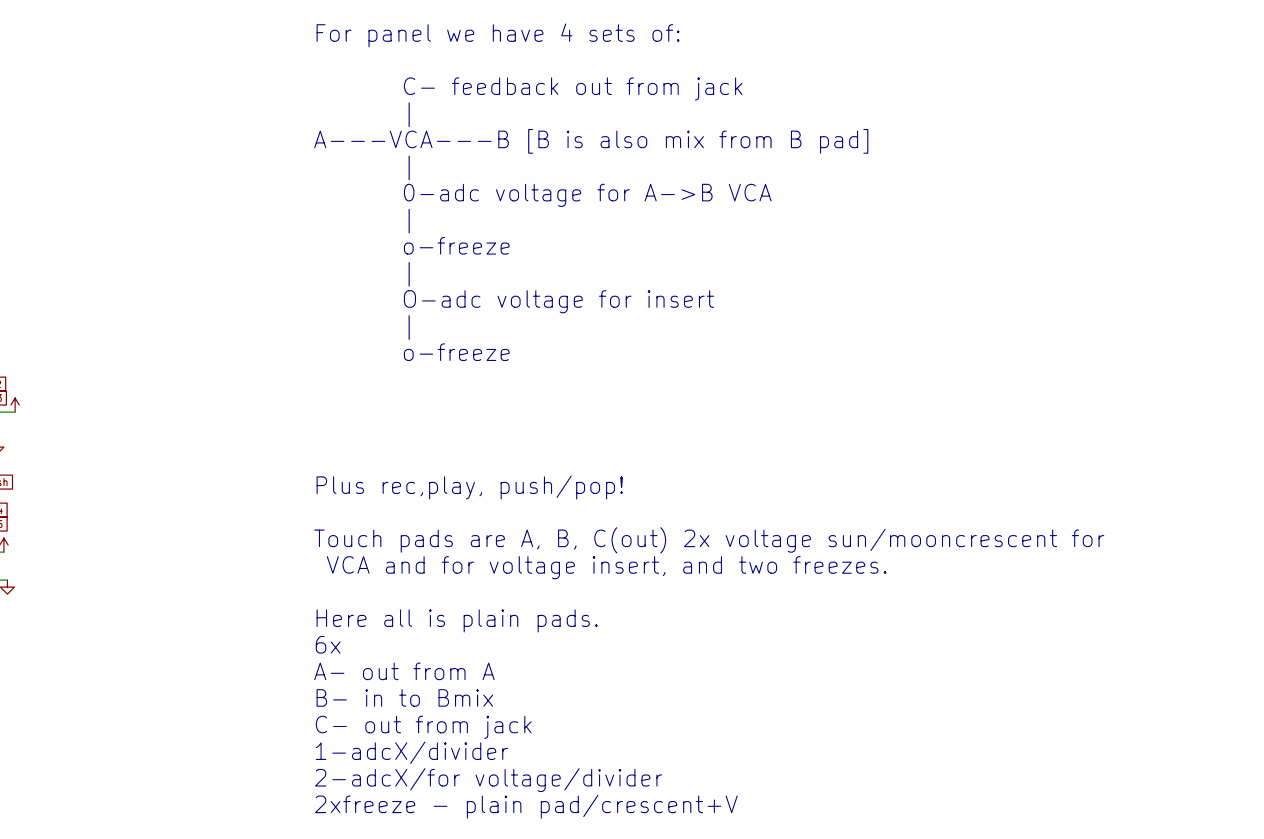
[picture p87: schematic panel_touch.kicad_sch, part in row 1, column 2]

Parts:
J1, J2, J3, J4, J5, J6, J7, J8, J9, J10, J11, J12, J13, J14, J15, J16, J17, J18, J19, J20, J21, J22, J23, J24, J25, J26, J27, J28, J29, J30, J31, J32, J33, J34, J35, J36, J37, J38, J39, J40, J41, J42, J43, J44, J45, J46, J47, J48: (no value)
R1, R2, R3, R4, R5, R6, R7, R8: (no value)

Connections:
ADC0: J17.1, J48.21, R4.1
ADC1: J16.1, J48.29, R3.1
ADC2: J39.1, J48.36, R8.1
ADC3: J38.1, J48.34, R7.1
ADC4: J15.1, J48.18, R2.1
ADC5: J14.1, J48.16, R1.1
ADC6: J37.1, J48.1, R6.1
ADC7: J36.1, J48.3, R5.1
B1: J5.1, J48.27
B2: J30.1, J48.38
B3: J2.1, J48.24
B4: J27.1, J48.4
C1: J4.1, J48.15
C2: J29.1, J48.40
C3: J1.1, J48.20
C4: J26.1, J48.2
F1: J24.1, J48.13
F2: J25.1, J48.35
F3: J46.1, J48.37
F4: J47.1, J48.30
F5: J22.1, J48.10
F6: J23.1, J48.26
F7: J44.1, J48.11
F8: J45.1, J48.6
Fplay: J7.1, J48.23
Fpush: J8.1, J48.22
Frec: J9.1, J48.19
IN1: J6.1, J48.17
IN2: J31.1, J48.39
IN3: J3.1, J48.14
IN4: J28.1, J48.5
unnamed: J10.1, J11.1, J12.1, J13.1, J32.1, J33.1, J34.1, J35.1, J48.7, J48.8, J48.9, J48.12, J48.28, J48.31, J48.32, J48.33, R1.2, R2.2, R3.2, R4.2, R5.2, R6.2, R7.2, R8.2
TRIG: J18.1, J19.1, J20.1, J21.1, J40.1, J41.1, J42.1, J43.1, J48.25

Notes on the sheet:
central circle is +3,3V
[3]
freeze is to GND
[4]
For panel we have 4 sets of: C- feedback out from jack | A---VCA---B [B is also mix from B pad] | 0-adc voltage for A->B VCA | o-freeze | O-adc voltage for insert | o-freeze Plus rec,play, push/pop! Touch pads are A, B, C(out) 2x voltage sun/mooncrescent for VCA and for voltage insert, and two free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
[1]
[2]
freeze is to NOT to GND
Add header for this: F,Fplay, push =3+ GND, 3.3V =5+ For each of the 4= 3signals, 2adc, 2 freeze = 7x4=28+5=33 SL 2X20G SMD2,54 2x20pol.-SMD-Stiftleiste, gerade, RM 2,54
31/7/2023 - 1M for dividers
