microresearch/allcolours/SR_segments/software/discard.c

typedef struct modes_ { // what we need: function, strobey, interpoll, inner_function?, detach?, 
  uint32_t strobey;
  uint32_t interpoll;
  //  uint32_t detachlen;
  uint32_t detachspeed;
  void (*func)(uint8_t w, uint32_t strobey, uint32_t detachlen, uint32_t  detachspeed, uint32_t interpoll, uint32_t (*innerfunc)(uint8_t w));
  uint32_t (*innerfunc)(uint8_t w);
} modez; 


typedef struct stack_ {
  uint32_t (*speedfrom)(uint32_t depth, uint32_t in, uint32_t wh);
  uint32_t* speedcv1;
  uint32_t* speedcv2;
  uint32_t (*bit)(uint32_t depth, uint32_t in, uint32_t wh);
  uint32_t* bitcv1;
  uint32_t* bitcv2;
  uint32_t* lencv;
  uint32_t bitindexy; // bit index for reference
  uint32_t speedindexy; // speed index
} stack;

// what can be removed from here?


//  uint32_t (*bit[64])(uint32_t depth, uint32_t in, uint32_t wh);
  //  uint32_t (*speedfrom[64])(uint32_t depth, uint32_t in, uint32_t wh);
  //  stack stacky[64]; // full stack


// global count for sync=glob   tmp=depth>>8; ///4 bits


// just a test here - uses CVL to select bitfunc
// but can't be in generic

static inline uint32_t Rtest(uint32_t depth, uint32_t in, uint32_t wh){ 
  uint32_t bt=0, bitrr, tmp;
  // fixed binroute
  tmp=binroute[count][wh]|binary[wh];
  for (uint8_t x=0;x<4;x++){
  if (tmp&0x01){
    bitrr = (gate[x].Gshift_[wh]>>SRlength[x]) & 0x01; // if we have multiple same routes they always shift on same one - ind version
    gate[x].Gshift_[wh]=(gate[x].Gshift_[wh]<<1)+bitrr;
    bt^=bitrr;
  }
  tmp=tmp>>1;
  }
  // do changes using depth which can be CVL or...
  bitfunccnt=depth>>8; // 16 is 4 bits
  
  return bt;
}



/*


* plan


for calibration use unipolar out/gnded from Quad slope

CODE: modes? normed clocks, how fast we can run?

basic speed and new CV hardware tests, MANUAL

*20Kz fastest dac speed with 32/16 divider...*

signals are inverted so unipolar 0-5v is from 0-2048 values and bipolar -5 to 5v is 0-4095

-2.5 to +2 is 1024 to 1024+2048 = 3072

/////////////////////////////////////////////////////////

- implement sketch of all modes as below with DAC and ADC options
- check all pulsins, outs and clks/clk norm functions
- test/play
- tweaks for slower speed, CLK norms, what else? how we handle one bit audio filter?


settle speeds and test new voltage/CV scheme: what is Hz for 16 octaves slowest and fastest? 0.25 Hz to 16KHz

older notes:
- thinking on scale/speeds - at the moment we have 0-5v CV input and
  covers 2^10 - so 10 octaves...we want say 13 or 14 octaves - 0.1Hz
  to 5K for 14 octaves/doublings


can we have knob covering this and 0-10v as 1v/OCT

100k instead of 200k for -10v and 33k in loop - as in Tides! (and can we adjust/scale input cv)

// 14 octs in 1024 =73 per octave =140K of cv in maybe approx... (for 730 max)

http://lushprojects.com/circuitjs/circuitjs.html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

or 100k cv in, 23k feedback, and -10v is 70k
*/

/// cleaning caput000


uint32_t funccmax[64][9]={
  {8,2,17,61,23}, // maximum value if x>funcmax... // update these as we add more functions
};

uint32_t cvmax[64][10]={
  {19,19,19,19,19,19,19,19,19,19}, // update for max number of cv options
};


//fspeed, flength, fadc, fbit, fdac,  fnew, fout, gs, out // fnew is parameter function // fout outside
//1       2        3     4     5     6     7     8   9

//basic but remeove adc
//out and fout mixed up in comments

//{1, 1, 1, 2, 0, 0, 0, 0, 0}, //['spdfrac2', 'rlen', 'zadcx', 'binroutfixed', 'ddac0', 'zero', 'vgen', 'gshift0', 'OUT_zero']
//{5, 0, 6, 0, 0, 8, 0, 0, 0, 0}, //['CV', 'null', 'CVL', 'null', 'null', 'ADCin', 'null', 'null', 'null', 'null']
/*
uint32_t funcNN[64][9]={
  {1, 1, 21, 2, 0, 0, 0, 0, 0}, //['spdfrac2', 'rlen', 'zadcx', 'binroutfixed', 'ddac0', 'zero', 'vgen', 'gshift0', 'OUT_zero']
  {1,1,18,2, 0,0,0,0,0}, //  - 18 is select adc with CVM // 20 is new prob test on CVL select on CVM
  {2,0,18,0, 0,0,0,0,0},
};

uint32_t funcLL[64][9]={
  {1, 1, 0, 2, 0, 2, 0, 0, 0}, //['spdfrac2', 'rlen', 'noadcx', 'binroutfixed', 'ddac0', 'zero', 'vgen', 'gshift0', 'OUT_zero'] // altering some
  {1,1,0,1, 0,0,0,0,0}, // 
  {2,0,0,59,0,0,0,0,0},
};

uint32_t funcCC[64][9]={
  //  {1,1,0,2,1, 5,0,6,0,6,0,1,0},
  {1, 1, 0, 2, 0, 0, 0, 0, 0}, //['spdfrac2', 'rlen', 'noadcx', 'binroutfixed', 'ddac0', 'zero', 'vgen', 'gshift0', 'OUT_zero'] // altered for delaylineIn and OUT
  {1,1,0,1, 26,0,0,0,0}, //  - 11 is select speed with CVM 26 dac with cvm
  {1,1,0,60, 0,0,0,0,0}, // rung - speed from cv, route from R //
};

uint32_t funcRR[64][9]={
  {1, 1, 0, 2, 0, 0, 0, 0, 0}, //['spdfrac2', 'rlen', 'noadcx', 'binroutfixed', 'ddac0', 'zero', 'vgen', 'gshift0', 'OUT_zero']
  {1,1,0,1, 0,0,0,0,0}, // 
  {2,1,0,61,0,0,0,0,0}, // route from L, speed from N
};
*/
// cvspeed, cvspeedmod, cvlength, cvdac, cvadc, cvadcIN,  cvbit, cvbitcomp, cvnew, cvout
// 1        2            3         4      5       6        7      8          9      10  

// 0 null 1 0dac 2 1dac 3 2dac 4 3dac 5 CV 6 CVL 7 CVM 8 ADCin 9 Gs0 10 Gs1 11 Gs2 12 Gs3 13 clksr_ 14 param 15 par 16 oldcv 17 oldcvl 18 oldcvm
/*
uint32_t cvNN[64][10]={
  {5, 0, 6, 0, 6, 8, 0, 0, 0, 0}, //['CV', 'null', 'CVL', 'null', 'null', 'ADCin', 'null', 'null', 'null', 'null']
  {5,0,6,0,6,8, 0,0,0,0}, // 8 is ADC itself IN
  {5,6,6,0,6,8,6,7,0,0},
};

uint32_t cvLL[64][10]={
  {15, 0, 6, 0, 0, 0, 0, 0, 7, 0}, //['CV', 'null', 'CVL', 'null', 'null', 'ADCin', 'null', 'null', 'null', 'null'] // altering some
  {5,0,6,0,6,0,4,0,0,0},
  {5,6,6,0,6,0,6,7,0,0}, // rung2 but modded...
};

uint32_t cvCC[64][10]={
  //{1,1,0,2,1, 5,0,6,0,6,0,1,0},
  {5, 0, 6, 0, 0, 0, 0, 0, 0, 0}, //['CV', 'null', 'CVL', 'null', 'null', 'ADCin', 'null', 'null', 'null', 'null']
  {5,0,6,7, 6,0,7,0,0,0},
  {5,0,6,7, 0,0,4,0,0,0}, // rung - speed from cv, route from R //
};

uint32_t cvRR[64][10]={
  {5, 0, 6, 0, 0, 0, 0, 0, 0, 0}, //['CV', 'null', 'CVL', 'null', 'null', 'ADCin', 'null', 'null', 'null', 'null']
  {5,1,6,0,6, 0,7,7,0,0},
  {5,6,6,0,0, 0,1,0,0,0}, // route from L, speed from N
};
*/

//static uint32_t cvcount=0; // for type of CV

// would be nice to have 8 so is 3 bits - logic? logiccount

//uint32_t *countfield[8]={&count, &daccount, &spdcount, &adctypecount, &dactypecount, &binroutetypecount};

//uint32_t *funcfield[8]={&dactypecnt, &spdfuncnt, &lengthfunccnt, &adctypecnt, &bitfunccnt}; // only 5 there


uint32_t options[4][24]={
      {1,3,3, 2,3,3, 3,3,3, 0,1,3, 0,2,3, 2,1,3, 0,1,2, 0,3,3},
      {0,3,3, 2,3,3, 3,3,3, 0,1,3, 0,2,3, 2,1,3, 0,1,2, 1,3,3},
      {0,3,3, 1,3,3, 3,3,3, 0,1,3, 0,2,3, 2,1,3, 0,1,2, 2,3,3},
      {0,3,3, 1,3,3, 2,3,3, 0,1,3, 0,2,3, 2,1,3, 0,1,2, 3,3,3}
    };

// extra files to check...


//#include "modeN.h"
//#include "modeL.h"
//#include "modeR.h"
//#include "modeC.h"
//#include "probability.h" // probability modes

//#include "basis.h" // basics from commented ones just to speed up tests
//#include "experiment.h" // more functional modes - can also shift some things here... trials
//#include "bit.h" // bitmodes but some are still in modeL
//#include "rungler.h"



// how many groups
#define GROUP 14 // for 16

  //re-test all new for crash  {adc2, adc0, adc0, SRminor_vienna, SRrunggenericbitsadcX, SRrunghead0NX, adcLrung0-fixed18/6, adcLrung1fixed, adcLrung2fixed,   adcrung0fixed, adcLbinprobX, noSRadc2sX, noSRadc2sX, adcLabstractLDX, stream4_unshareX, streamX}, //128

 /* 
void (*funcgroups[4][128])(uint8_t w)=
{
    {adc2, adc0, adc0, SRminor_vienna, SRrunggenericbitsadc, SRrunghead0N, adcLrung0, adcLrung1, adcLrung2,   adcrung0, adcLbinprob, noSRadc2s, noSRadc2s, adcLabstractLD, stream4_unshare, stream}, //128
  //    {adc2, adc0, adc2, adc0,  adc2,   adc0, adc2, adc0,adc2,  adc0,adc2, adc0, adc2, adc0, adc2, adc0},
  
  {SRX0, SRX0, SR_layer1, SRminor_vienna, SRrunggenericbitsgenopp, SRrunghead0L, SRrung0,   SRrung1,   SRrung2, SRrung3,  adcLbinprob, SRshroute, noSRcopy, adcLabstractLD, stream4_unshare, stream},  // 128

  {newdac2, dac0, dac0, SRminor_vienna, SRrunggenericbits, SRrungout, dacLrung0, dacLrung0, dacNLRin, dacNLRinlogic, adcLbinprob, dac2, noSRdac2s, dacNLRprobin,   stream4_unshare, stream}, 
  
  {SRX0, SRX0, SR5_feedback, SRminor_vienna, SRrunggenericbitsgen, SRrungbody0, SRRrung0, SRRrung1, SRRrung2, SRRrung3,     adcLbinprob, SRX0,     SRX0, adcLabstractLD, stream4_unshare, stream} //64 
}; // 13 so far -- to add more for lisbon - select at random from 50 - how to do from cards...
*/  
// card for each = 16 possibles... we need 50! - q of slidings - we can slide +-64 except modeR cannot slide so should be most generic

 /*
- how else we can express matrices which makes sense - to match up:

as array for each side:

eg. speed, length, bit FUNCS, adc, which dac // them CV indices

thus:
*/

// collect modes: Lmultiplespeednew // tag modesx modex
/*void (*dofunc[4][64])(uint8_t w)=
{
  {SR_geomantic}, 
  {SR_geomantic}, 
  {SR_geomantic}, 
  {SR_globalbin}
};
*/
  /*  
  for (x=0;x<64;x++){
    for (y=0;y<9;y++){
      gate[0].func[x][y]=funcNN[x][y];
      gate[1].func[x][y]=funcLL[x][y];
      gate[2].func[x][y]=funcCC[x][y];
      gate[3].func[x][y]=funcRR[x][y];
    }
  }

  for (x=0;x<64;x++){
    for (y=0;y<10;y++){
      gate[0].cv[x][y]=cvNN[x][y];
      gate[1].cv[x][y]=cvLL[x][y];
      gate[2].cv[x][y]=cvCC[x][y];
      gate[3].cv[x][y]=cvRR[x][y];
    }
  }
  */


    // tests for stack
    //  pushspeed(3, x); // spdfrac
    //  pushspeedcv(CVlist[x][cvpair[0][0]], CVlist[x][cvpair[0][1]], x);
  // trial functions with length

  //   0:zeros 1:binrout 2:binroutfixed 3:binroutor 4:zsingleroutebits 5:zbinrouteINVbits 6:zbinroutebits_noshift_transit 7:zbinroutebits_noshift 8:zbinroutebitscycle 9:zbinroutebitscyclestr 10:zbinroutebitscycle_noshift 11:zbinroutebitscyclestr_noshift 12:zbinrouteORbits 13:zbinrouteANDbits 14:zbinrouteSRbits 15:zbinroutebitsI 16:zbinroutebitsI_noshift 17:zbinroutebitscycleI_noshift 18:zbinroutebitscyclestrI 19:zosc1bits 20:sigmadelta 21:cipher 22:osceq 23:zSRclksr 24:zSRclksrG 25:zSRNbits 26:zSRLbits 27:zSRCbits 28:zSRRbits 29:zpulsebits 30:zprobbits 31:zprobbitsxorstrobe 32:zprobbitsxortoggle 33:zsuccbits 34:zsuccbitsI 35:zreturnbits 36:zreturnnotbits 37:zosc1bits 38:zwiardbits 39:zwiardinvbits 40:zTMsimplebits 41:zonebits 42:zlfsrbits 43:zllfsrbits 44:zflipbits 45:zosceqbitsI 46:zosc1bitsI 47:zTMsimplebitsI 48:zwiardbitsI 49:zwiardinvbitsI 50:zonebitsI 51:zlfsrbitsI 52:zllfsrbitsI 53:zflipbitsI 54:zpattern4bits 55:zpattern8bits 56:zpattern4bitsI 57:zpattern8bitsI 58:Rtest 59:gensel 60:binroutfixed_prob1R 61:binroutfixed_prob1L 62:binroutfixed_prob2 63:binroutfixed_prob3 64:binroutfixed_prob4 65:SRdelay_lineOUT

    //  pushbit(28, x);  //2: fixed binroute
    //  pushbitcv(CVlist[x][0], CVlist[x][0], x);

  /* 
  www++;
 
  if (www>3) {
    www=0;
    resetz=1;
    (*dotail[tailcount])(); // or this is 5th [www==4] www  - can also be seperate case...
  }
  */

  
  // testing
//  spdfunccnt=cvcount=dactypecnt=lengthfunccnt=adcfunccnt=bitfunccnt=glob;

  // where are these used and is too long as counts every time
  //      counter[4]++; counter[5]++; counter[6]++;

 //SR_geomantic_outer(www); // now this one sets inner function

  //  if (www==3) (*dotail[tailcount])(); // or this is 5th [www==4] www  - can also be seperate case...
  
  // genericLFSR for all probability modes


void testnull(void){
}

uint32_t testmodes[4]={0,0,0,0};



//////////////////////////////////////////////////////////////////////////
// new geomantic functions abstracted
//////////////////////////////////////////////////////////////////////////

// gshifts
static inline uint32_t gshift0(uint32_t w){ 
  GSHIFT_;
  return 0;
}

static inline uint32_t gshiftNOS(uint32_t w){ 
  GSHIFTNOS_;
  return 0;
}

static inline uint32_t gshiftnull(uint32_t w){
  return 0;
}

// what other gshifts there are: only noshift of own SR //GSHIFTNOS_// - so we have 3 options

// split speeds
// temp:  static inline uint32_t OUT_temp(uint32_t depth, uint8_t wh){
static inline uint32_t OUT_splitx(uint32_t depth, uint32_t w){
  int32_t tmp; uint32_t bitn, bitrr, val, x, xx, lengthbit=15, new_stat;
  if (!sbinroute(others[w][0])) { // inversion to avoid running out
      GSHIFTNOS_; // 2.copy gshift on trigger // gate[XX].Gshift[w]&0x01...
    }

  if (!sbinroute(others[w][1])) { //3.advance incoming ghost
    BINROUTEADV_;
  }

  if (!sbinroute(others[w][2])) {
    gate[w].shift_=gate[w].shift_<<1; // 1. shifter
  }

}

static inline uint32_t IN_splitx(uint32_t depth, uint32_t w){ // matches above and must match outfunction     BITN_AND_OUTVXOR_;
  int32_t tmp; uint32_t bitn, bitrr, val, x, xx, lengthbit=15, new_stat;
    BINROUTENOG_; // or not
    return bitn;
}  


static inline uint32_t OUT_zero(uint32_t depth, uint32_t w){ 
  return 0;
}

static inline uint32_t OUT_adc_overonebit(uint8_t w){ // oversample one bit
  uint8_t bt;
  bt=adconebitsx();
  return bt;
}

//////////////////////////////////////////////////////////////////////////
// DACOUT : as generic bits->value
// start to wrap dac functions - there are 24!
// static inline uint32_t DAC_(uint32_t wh, uint32_t shift, uint32_t length, uint32_t type, uint32_t otherpar, uint32_t strobe){  // DAC is 12 bits
// length could also be generic so is just a processor

static inline uint32_t BVddac0(uint32_t depth, uint32_t in, uint32_t wh){ // version for any 12 bit IN value -> bits
  uint32_t val;
  val=DAC_(wh, in, SRlength[wh], 0, depth, gate[wh].trigger);
  return val;
}

static inline uint32_t ddac0(uint32_t depth, uint32_t wh){
  uint32_t val;
  val=DAC_(wh, gate[wh].shift_, SRlength[wh], 0, depth, gate[wh].trigger);
return val;
}

static inline uint32_t ddac1(uint32_t depth, uint32_t wh){
  uint32_t val;
  val=DAC_(wh, gate[wh].shift_, SRlength[wh], 1, depth, gate[wh].trigger);
return val;
}

static inline uint32_t ddac2(uint32_t depth, uint32_t wh){
  uint32_t val;
  val=DAC_(wh, gate[wh].shift_, SRlength[wh], 2, depth, gate[wh].trigger);
return val;
}

static inline uint32_t ddac3(uint32_t depth, uint32_t wh){
  uint32_t val;
  val=DAC_(wh, gate[wh].shift_, SRlength[wh], 3, depth, gate[wh].trigger);
return val;
}

static inline uint32_t ddac4(uint32_t depth, uint32_t wh){
  uint32_t val;
  val=DAC_(wh, gate[wh].shift_, SRlength[wh], 4, depth, gate[wh].trigger);
return val;
}

static inline uint32_t ddac5(uint32_t depth, uint32_t wh){
  uint32_t val;
  val=DAC_(wh, gate[wh].shift_, SRlength[wh], 5, depth, gate[wh].trigger);
return val;
}

static inline uint32_t ddac6(uint32_t depth, uint32_t wh){
  uint32_t val;
  val=DAC_(wh, gate[wh].shift_, SRlength[wh], 6, depth, gate[wh].trigger);
return val;
}

static inline uint32_t ddac7(uint32_t depth, uint32_t wh){
  uint32_t val;
  val=DAC_(wh, gate[wh].shift_, SRlength[wh], 7, depth, gate[wh].trigger);
return val;
}

static inline uint32_t ddac8(uint32_t depth, uint32_t wh){
  uint32_t val;
  val=DAC_(wh, gate[wh].shift_, SRlength[wh], 8, depth, gate[wh].trigger);
return val;
}

static inline uint32_t ddac9(uint32_t depth, uint32_t wh){
  uint32_t val;
  val=DAC_(wh, gate[wh].shift_, SRlength[wh], 9, depth, gate[wh].trigger);
return val;
}

static inline uint32_t ddac10(uint32_t depth, uint32_t wh){
  uint32_t val;
  val=DAC_(wh, gate[wh].shift_, SRlength[wh], 10, depth, gate[wh].trigger);
return val;
}

static inline uint32_t ddac11(uint32_t depth, uint32_t wh){
  uint32_t val;
  val=DAC_(wh, gate[wh].shift_, SRlength[wh], 11, depth, gate[wh].trigger);
return val;
}

static inline uint32_t ddac12(uint32_t depth, uint32_t wh){
  uint32_t val;
  val=DAC_(wh, gate[wh].shift_, SRlength[wh], 12, depth, gate[wh].trigger);
return val;
}

static inline uint32_t ddac13(uint32_t depth, uint32_t wh){
  uint32_t val;
  val=DAC_(wh, gate[wh].shift_, SRlength[wh], 13, depth, gate[wh].trigger);
return val;
}

static inline uint32_t ddac14(uint32_t depth, uint32_t wh){
  uint32_t val;
  val=DAC_(wh, gate[wh].shift_, SRlength[wh], 14, depth, gate[wh].trigger);
return val;
}

static inline uint32_t ddac15(uint32_t depth, uint32_t wh){
  uint32_t val;
  val=DAC_(wh, gate[wh].shift_, SRlength[wh], 15, depth, gate[wh].trigger);
return val;
}

static inline uint32_t ddac16(uint32_t depth, uint32_t wh){
  uint32_t val;
  val=DAC_(wh, gate[wh].shift_, SRlength[wh], 16, depth, gate[wh].trigger);
return val;
}

static inline uint32_t ddac17(uint32_t depth, uint32_t wh){
  uint32_t val;
  val=DAC_(wh, gate[wh].shift_, SRlength[wh], 17, depth, gate[wh].trigger);
return val;
}

static inline uint32_t ddac18(uint32_t depth, uint32_t wh){
  uint32_t val;
  val=DAC_(wh, gate[wh].shift_, SRlength[wh], 18, depth, gate[wh].trigger);
return val;
}

static inline uint32_t ddac19(uint32_t depth, uint32_t wh){
  uint32_t val;
  val=DAC_(wh, gate[wh].shift_, SRlength[wh], 19, depth, gate[wh].trigger);
return val;
}

static inline uint32_t ddac20(uint32_t depth, uint32_t wh){
  uint32_t val;
  val=DAC_(wh, gate[wh].shift_, SRlength[wh], 20, depth, gate[wh].trigger);
return val;
}

static inline uint32_t ddac21(uint32_t depth, uint32_t wh){
  uint32_t val;
  val=DAC_(wh, gate[wh].shift_, SRlength[wh], 21, depth, gate[wh].trigger);
return val;
}

static inline uint32_t ddac22(uint32_t depth, uint32_t wh){
  uint32_t val;
  val=DAC_(wh, gate[wh].shift_, SRlength[wh], 22, depth, gate[wh].trigger);
return val;
}

static inline uint32_t ddac23(uint32_t depth, uint32_t wh){
  uint32_t val;
  val=DAC_(wh, gate[wh].shift_, SRlength[wh], 23, depth, gate[wh].trigger);
return val;
}

static inline uint32_t ddac24(uint32_t depth, uint32_t wh){
  uint32_t val;
  val=DAC_(wh, gate[wh].shift_, SRlength[wh], 24, depth, gate[wh].trigger);
return val;
}

uint32_t (*dacfromsdd[32])(uint32_t depth, uint32_t wh)={ddac0, ddac1, ddac2, ddac3, ddac4, ddac5, ddac6, ddac7, ddac8, ddac9, ddac10, ddac11, ddac12, ddac13, ddac14, ddac15, ddac16, ddac17, ddac18, ddac19, ddac20, ddac21, ddac22, ddac23, ddac24, ddac0, ddac1, ddac2, ddac3, ddac4, ddac5, ddac6};


static inline uint32_t dacselcvl(uint32_t depth, uint32_t wh){  // select adc using CVL
   uint32_t bt;
   // *adcfromsd[32])(uint32_t depth, uint32_t in, uint32_t wh)
   bt=(*dacfromsdd[CVL[wh]>>7])(depth, wh); // 5 bits
   return bt;
}

static inline uint32_t dacselcvm(uint32_t depth, uint32_t wh){  // select adc using CVL
   uint32_t bt;
   // *adcfromsd[32])(uint32_t depth, uint32_t in, uint32_t wh)
   bt=(*dacfromsdd[CVM[wh]>>7])(depth, wh); // 5 bits
   return bt;
}




//eg. outer function: on functionchange select speedfrom using CVL, speedcv is CV, bitin is unchanged, bitcv is unchanged, lencv is unchanged...
// but not ON functionchange we set... as we need CV and to change speedfrom but can be variations:

// 5/8/2022 adding prob/bit




//static uint8_t strobed[4]={0,0,0,0};



/*
latest geomantic:

- CVM more as attaching parameters and functions... but how...// matrix of fixings rather than a stack


     // entry into new modes

how that works... mode as an interpreter...

execution of a matrix that is changed by CVM and feedback onto that matrix... can also be a stack though or...

CVM can only be a meta/mode selector - but then we can't use CV, or CVL as these are part of internals...

unless they get fixed...

//or or modeR CVM - in 4 sections for attachments (also using strobe)... but again we can't use CVL or CV

////

matrix is maybe just values -> indexes and values, no pointers eg.

as array, speedfunc, cv1, cv2, bitin, cv1, cv2, len

gate[w].matrix[0] etc...

{speedfrom/index, speedcv1, speedcv2, bit/index, bitcv1, bitcv2, lencv}

so body is interpreter here - each has an inner and an outer function (what speed does outer run at?) ghost and ghost

could also hold adc there?

and we choose functions to change these: for example copy a matrix to this one - according to what do we choose?  problem is to repeatedly do this...

can also apply a function to a value...

again how to seperate INT/EXT?

4x16 as key ... geomantic figures

*/

// 16 inner x 4 outer??? or vice versa

// trial INNER/OUTER - but for now is just another matrix op/array/could also be stack so we need to do more inside it! it does allow us to leave elements remaining...
// we could have stack with index an mark unchanging as what? - as top bit of 32 bits


// list of functions:

///TODO: still to add some which got left out... // left out from where?

// routes: binrout, binroutfixed, binroutor, zsingleroutebits, zbinrouteINVbits, zbinroutebits_noshift_transit, zbinroutebits_noshift, zbinroutebitscycle, zbinroutebitscyclestr, zbinroutebitscycle_noshift, zbinroutebitscyclestr_noshift, zbinrouteORbits, zbinrouteANDbits, zbinrouteSRbits, zbinroutebitsI, zbinroutebitsI_noshift, zbinroutebitscycleI_noshift, zbinroutebitscyclestrI,

// speeds: spdfrac, spdfrac2, strobe, ones, clksr, clksrG

// bits: sigmadelta, cipher, osceq, zSRclksr, zSRclksrG, zSRNbits, zSRLbits, zSRCbits, zSRRbits, zpulsebits, zprobbits, zprobbitsxorstrobe, zprobbitsxortoggle, zsuccbits, zsuccbitsI, zreturnbits, zreturnnotbits, zosc1bits, zwiardbits, zwiardinvbits, zTMsimplebits, zonebits, zlfsrbits, zllfsrbits, zflipbits, zosceqbitsI, zosc1bitsI, zTMsimplebitsI, zwiardbitsI, zwiardinvbitsI, zonebitsI, zlfsrbitsI, zllfsrbitsI, zflipbitsI, zpattern4bits, zpattern8bits, zpattern4bitsI, zpattern8bitsI,

// zadcx, zadconebitsx, zadconebitsxreset, zadcpadbits, zadc12bits, zadc8bits, zadc4bits, zadceqbits, zadcenergybits, zadc12compbits, zadc8compbits, zadc4compbits, zadccompbits, zadc12onecompbits, zadc8onecompbits, zadc4onecompbits, zadconecompbits

//1speed 
// now with depth/CV

/// we need to list/catalogue: ADCs, speeds, bits of various descriptions... // overlap/overlay of bits and speeds

// that catalogues can also be kind of matrices, with holes and exceptions... used by different interpreters eg. speedfromnostrobe, speedfromabstract, speedfromroutes

//uint32_t (*speedfromsdd[32])(uint32_t depth, uint32_t in, uint32_t wh)={strobe, spdfrac2, spdfrac3, spdfrac, holdlspdfrac, strobe, ztogglebits, ones, clksrG, clksr, strobe, spdfrac2, spdfrac3, spdfrac, holdlspdfrac, strobe, ztogglebits, ones, clksr, clksrG, strobe, spdfrac2, spdfrac3, spdfrac, holdlspdfrac, strobe, ztogglebits, ones, clksr, clksrG, spdfrac, spdfrac}; // is in geogen.h


uint32_t (*metain[64])(uint8_t w, uint32_t mood)={itself};    

 void (*SRgeo_inner[4][64])(uint32_t w)=
{
{SR_geomantic_inneradc},
{SR_geomantic_innernoadc},
{SR_geomantic_innernoadc},
{SR_geomantic_innernoadc}
};


//uint32_t inindex=(*metain[mode[www]])(www, mode[www]); // - functions which generate indices
 uint32_t inindex=0;
 // (*SRgeo_inner[www][inindex])(www); // different indexes for this 
 // SR_geomantic_inner(www); 


// from latest geomantic.h and geogen

//////////////////////////////////////////////////////////////////////////
// speedsels


static inline uint32_t speedselcvl(uint32_t depth, uint32_t in, uint32_t wh){   // toggle - no depth
  static uint32_t bt=0;
  bt=((*speedfromsdd[CVL[wh]>>7])(depth, in, wh));
  return bt;
  }

static inline uint32_t speedselcvm(uint32_t depth, uint32_t in, uint32_t wh){   // toggle - no depth
  static uint32_t bt=0;
  bt=((*speedfromsdd[CVM[wh]>>7])(depth, in, wh));
  return bt;
  }

/*
static inline uint32_t speedseloldcvm(uint32_t depth, uint32_t in, uint32_t wh){   // toggle - no depth 
  static uint32_t bt=0;
  bt=((*speedfromsdd[gate[wh].oldcvm>>7])(depth, in, wh));
  return bt;
  }

static inline uint32_t speedseloldcvl(uint32_t depth, uint32_t in, uint32_t wh){   // toggle - no depth
  static uint32_t bt=0;
  bt=((*speedfromsdd[gate[wh].oldcvm>>7])(depth, in, wh));
  return bt;
  }
*/


//////////////////////////////////////////////////////////////////////////
//0
//lengths


// we can fork in processors here... ???

static inline uint32_t rlen(uint32_t depth, uint32_t wh){
  uint32_t bt=lookuplenall[depth>>7]; // 5 bits
  return bt; // bt is a value
}

static inline uint32_t nlen(uint32_t depth, uint32_t wh){
  return 0; // is just holder
}

// hold old [CVL/depth] length
static inline uint32_t holdlen(uint32_t depth, uint32_t wh){ // we don;t use depth as we just hold // can have same for speed...
  static uint32_t oldd[4]={0,0,0,0};
  if (held[wh]!=0) oldd[wh]=held[wh];
  held[wh]=0;  
  uint32_t bt=lookuplenall[oldd[wh]>>7]; // 5 bits
  return bt; // bt is a value
}


//0function outside speed
uint32_t (*outside[32])(uint32_t depth, uint32_t wh)={OUT_zero, OUT_SRdelay_lineIN}; // delay bin needs to match with delay out, or shared delay lines...

//0.5gshift
uint32_t (*gshifts[32])(uint32_t wh)={gshift0, gshiftnull};

uint32_t (*dacfunc[32])(uint32_t depth, uint32_t wh)={ddac0, ddac1, ddac2, ddac3, ddac4, ddac5, ddac6, ddac7, ddac8, ddac9, ddac10, ddac11, ddac12, ddac13, ddac14, ddac15, ddac16, ddac17, ddac18, ddac19, ddac20, ddac21, ddac22, ddac23, ddac24, dacselcvl, dacselcvm};

//2length IGNORE!
uint32_t (*lengthfromsd[32])(uint32_t depth, uint32_t wh)={nlen, rlen, holdlen}; // we only have 2 functions here so far - nlen is null/hold, what other functions



//5newfunc
//uint32_t (*newfunc[32])(uint32_t depth, uint32_t wh)={zero, bitsmod, cvmod}; //

/*
uint32_t *CVlist[4][22]={ // TAIL is &Gshift_[8] // add in statics for adc, dac and length
  {&nulll, &gate[0].dac, &gate[1].dac, &gate[2].dac, &gate[3].dac, &CV[0], &CVL[0], &CVM[0], &ADCin, &Gshift_[0], &Gshift_[1], &Gshift_[2], &Gshift_[3], &clksr_[0], &param[0], &Gshift_[8], &gate[0].oldcv, &gate[0].oldcvl, &gate[0].oldcvm, &gate[0].adctype, &gate[0].dactype, &SRlength[0]},
  {&nulll, &gate[0].dac, &gate[1].dac, &gate[2].dac, &gate[3].dac, &CV[1], &CVL[1], &CVM[1], &ADCin, &Gshift_[0], &Gshift_[1], &Gshift_[2], &Gshift_[3], &clksr_[1], &param[1], &Gshift_[8], &gate[1].oldcv, &gate[1].oldcvl, &gate[1].oldcvm, &gate[1].adctype, &gate[1].dactype, &SRlength[1]},
  {&nulll, &gate[0].dac, &gate[1].dac, &gate[2].dac, &gate[3].dac, &CV[2], &CVL[2], &CVM[2], &ADCin, &Gshift_[0], &Gshift_[1], &Gshift_[2], &Gshift_[3], &clksr_[2], &param[2], &Gshift_[8], &gate[2].oldcv, &gate[2].oldcvl, &gate[2].oldcvm, &gate[2].adctype, &gate[2].dactype, &SRlength[2]},
  {&nulll, &gate[0].dac, &gate[1].dac, &gate[2].dac, &gate[3].dac, &CV[3], &CVL[3], &CVM[3], &ADCin, &Gshift_[0], &Gshift_[1], &Gshift_[2], &Gshift_[3], &clksr_[3], &param[3], &Gshift_[8], &gate[3].oldcv, &gate[3].oldcvl, &gate[3].oldcvm, &gate[3].adctype, &gate[3].dactype, &SRlength[3]}
};

  // 0,    1             2             3             4             5       6        7            8           9         10     11 -> 19

// 0 null 1 0dac 2 1dac 3 2dac 4 3dac 5 CV 6 CVL 7 CVM 8 ADCin 9 Gs0 10 Gs1 11 Gs2 12 Gs3 13 clksr_ 14 param 15 par 16 oldcv 17 oldcvl 18 oldcvm


// TODO: but this over-rides dacfrom - alternative would be to index as CVlist[dacfrom[w]+1] !!!

//......
// TODO: but these become more like groups now - question is if we have in SR individual array of speedfuncs etc. with own count in
// and we can sync and shift these counts....

// then each would need ref into 4 functions +dac5 + 6 sets of CV???? = 10 or 11 counters each...

enum refs {fspeed, flength, fadc, fbit, fdac, fnew, fout, gs, out}; // 9
enum cvs {cvspeed, cvspeedmod, cvlength, cvdac, cvadc, cvadcIN,  cvbit, cvbitcomp, cvnew, cvout}; //10

// out functions
static inline uint32_t vgen(uint32_t bitn, uint32_t w){
  int32_t tmp; uint32_t xx,val,lengthbit=15, new_stat;
  //  BITN_AND_OUTVgen_;
  return val;
}

//    BITN_AND_OUTVXOR_;
static inline uint32_t vxor(uint32_t bitn, uint32_t w){
  int32_t tmp; uint32_t val, xx, lengthbit=15, new_stat;
  BITN_AND_OUTVXOR_;
  return val;
}

//6 out
uint32_t (*outs[32])(uint32_t bitn, uint32_t wh)={vgen, vxor};

/*
void SR_geomanticxx(uint8_t w){  
  static uint32_t oldspdfunccnt;
  HEADNADA;
  if (interp[gate[w].func[spdfunccnt][fspeed]]){ // gate[w].func[spdfunccnt][fspeed]
    gate[w].alpha = gate[w].time_now - (float)gate[w].int_time;
    gate[w].dac = ((float)delay_buffer[w][DELAY_SIZE-5] * gate[w].alpha) + ((float)delay_buffer[w][DELAY_SIZE-6] * (1.0f - gate[w].alpha));
   if (gate[w].dac>4095) gate[w].dac=4095;
  }
  else gate[w].dac = delay_buffer[w][1];

  CLKSR; // new macro deals with intflag outside speed

      // moved up TODO: - wrap in macro 
    if (gate[w].cvcnt!=gate[w].oldcvcnt || spdfunccnt!=oldspdfunccnt ){ // we have a CV change // can be other changes or strobe or.... ??? 
      gate[w].oldcv=CV[w];
      gate[w].oldcvl=CVL[w];
      gate[w].oldcvm=CVM[w];
    }
    gate[w].oldcvcnt=gate[w].cvcnt;
    oldspdfunccnt=spdfunccnt;

    // function outside speed...
    bitn=(*outside[gate[w].func[outfunccnt][fout]])(*CVlist[w][gate[w].cv[gate[w].cvcnt][cvout]],w);
    
  if ((*speedfromsd[gate[w].func[spdfunccnt][fspeed]])(*CVlist[w][gate[w].cv[gate[w].cvcnt][cvspeed]],*CVlist[w][gate[w].cv[gate[w].cvcnt][cvspeedmod]], w)){ // speedfunc
    LASTSPEED; // new macro to deal with lastspeed 16/6
    
    if (gate[w].func[lengthfunccnt][flength]!=0){ // so function 0 null should just hold length
    SRlength[w]=(*lengthfromsd[gate[w].func[lengthfunccnt][flength]])(*CVlist[w][gate[w].cv[gate[w].cvcnt][cvlength]],w); // lengthfunc - not many?
    }

    //GSHIFT_;
    //(*gshifts[0])(w);
    (*gshifts[gate[w].func[gscnt][gs]])(w);

    // CORE
    
    if (gate[w].cv[gate[w].cvcnt][cvadcIN]==8){ // real ADC
    ADCgeneric2; // input into shared one..
    }

    // 5/7/2022 added in new function//which can generate a param but also modify SR...
    // param needs to have pointer in struct = par
    // 26/7 eg. par can select one of cvs and copy value
    
    gate[w].par=(*newfunc[gate[w].func[extfunccnt][fnew]])(4095-(*CVlist[w][gate[w].cv[gate[w].cvcnt][cvnew]]), w); // invert?
    bitn^=(*adcfromsd[gate[w].func[adcfunccnt][fadc]])(4095-(*CVlist[w][gate[w].cv[gate[w].cvcnt][cvadc]]), *CVlist[w][gate[w].cv[gate[w].cvcnt][cvadcIN]],w); // invert?
    bitn^=(*bitfromsd[gate[w].func[bitfunccnt][fbit]])(*CVlist[w][gate[w].cv[gate[w].cvcnt][cvbit]], *CVlist[w][gate[w].cv[gate[w].cvcnt][cvbitcomp]],w);
    // ENDCORE
    //    if (strobey) bitn|=gate[w].trigger;	 // extra bits in if necessary or is another function
    //BITN_AND_OUTVgen_; // pulsin is in there - added new DAC - but we need alter     gate[w].shift_+=bitn; function in there/
    //final bitnout
    //
    val=(*outs[0])(bitn, w); //(*outs[gate[w].func[outcnt][out]])(bitn, w);
    new_data(val,w);
    }
  }
*/

/*

new geomantic _ what we can simplify it to...

1.remove outside, gshift, think about length ops (how?), [newfunc and par?]

//// we had 8 functions

1outside - we can combine speed and general
2speedfrom
3lengthfrom X we use param for length // length from SR
4gshifts -> what they are. as switch or...
5param (do length here)
6adc - now if we have adc
7bitfrom **
8outs - ???? leave for moment as fixed...

simple model -. no param as this should be another SR  - tail maybe as param SR!

processors for SRs:

value->bits (adc) // valtobits
bits-> value (dac od SRx) // bitstoval

//paramx/length=bitstoval>>xx

//maybe we should head to 8 bits as standard for all - but speed is 10 bits, etc.... so maybe leave as is/open/recheck ADCs // leave for now but...

return to only: speedfrom, bitfrom

2.attach function on entry into new function counter (stack of these)

what stack does - stack overwrites oldest when full  - see test.c (and when is empty?)

function counter for all functions//

*/

typedef uint32_t (* funcy)(uint32_t depth, uint32_t in, uint32_t wh); // use this to simplify matters

typedef struct pair_ {
  uint32_t* cv1;
  uint32_t* cv2;
    } pair;

#define SIZEY 64 

// how to make more generic? we can also think about descending/ascending through a stack of functions which don't differentiate speed, bit etc...
//

// how to do all as one stack ?? length, end and gshift??? stack in modes.h
/*
typedef struct stack_ {
  uint32_t* bitcv1;
  uint32_t* bitcv2;
  uint32_t* speedcv1;
  uint32_t* speedcv2;
  uint32_t (*bit)(uint32_t depth, uint32_t in, uint32_t wh);
  uint32_t (*speedfrom)(uint32_t depth, uint32_t in, uint32_t wh);
  uint32_t bitindexy;
} stack;

// so all will share index - is that ok?!

*/

/// new template with push, pop, peek
void pushspeed(uint32_t index, uint32_t w){ // we just push index
  //  
  //  gate[w].stacky[gate[w].stackindex].speedfrom= speedfromsd[index]; // TESTING new scheme
  gate[w].speedfrom[gate[w].speedfromindex] = speedfromsd[index];
  gate[w].speedfromindex = (gate[w].speedfromindex + 1) % SIZEY;
}

void pushspeedcv(uint32_t *cv1, uint32_t *cv2, uint32_t w){
  gate[w].speedfromcv1[gate[w].speedcvindex] = cv1;
  gate[w].speedfromcv2[gate[w].speedcvindex] = cv2;
  gate[w].speedcvindex = (gate[w].speedcvindex + 1) % SIZEY;  
}

funcy peekspeed(uint32_t w){ // returns a function
  uint32_t ed=(gate[w].speedfromindex - 1 + SIZEY) % SIZEY;
  return gate[w].speedfrom[ed];
}

funcy popspeed(uint32_t w){ // returns a function // but what if there is no function?
  gate[w].speedfromindex=(gate[w].speedfromindex - 1 + SIZEY) % SIZEY;
  return gate[w].speedfrom[gate[w].speedfromindex];
}

pair peekspeedcv(uint32_t w){ //returns two pointers
  pair cvs;
  uint32_t ed=(gate[w].speedcvindex - 1 + SIZEY) % SIZEY;
  cvs.cv1=gate[w].speedfromcv1[ed];
  cvs.cv2=gate[w].speedfromcv2[ed];
  return cvs;
} 

void pushbit(uint32_t index, uint32_t w){ // we just push index
  gate[w].bit[gate[w].bitindex] = bitfromsd[index]; 
  gate[w].bitindexy=index;
  gate[w].bitindex = (gate[w].bitindex + 1) % SIZEY;
}

funcy peekbit(uint32_t w){ // returns a function
  uint32_t ed=(gate[w].bitindex - 1 + SIZEY) % SIZEY;
  return gate[w].bit[ed];
}

pair peekbitcv(uint32_t w){ //returns two pointers
  pair cvs;
  uint32_t ed=(gate[w].bitcvindex - 1 + SIZEY) % SIZEY;
  cvs.cv1=gate[w].bitcv1[ed];
  cvs.cv2=gate[w].bitcv2[ed];
  return cvs;
} 

void pushbitcv(uint32_t *cv1, uint32_t *cv2, uint32_t w){
  gate[w].bitcv1[gate[w].bitcvindex] = cv1;
  gate[w].bitcv2[gate[w].bitcvindex] = cv2;
  gate[w].bitcvindex = (gate[w].bitcvindex + 1) % SIZEY;  
}

uint32_t cvpair[64][2]={ // pairs of CVs which we index into 
  {5,6}, // eg. CV and CVL
  {5,6}, // eg. CV and CVL
  {5,6}, // eg. CV and CVL
};

uint32_t (*speedff[4])(uint32_t depth, uint32_t in, uint32_t wh)={spdfrac2,spdfrac2,spdfrac2,spdfrac2}; // why did we need to initialise this?

uint32_t (*bitff[8])(uint32_t depth, uint32_t in, uint32_t wh)={binroutfixed,binroutfixed,binroutfixed,binroutfixed,binroutfixed,binroutfixed,binroutfixed,binroutfixed}; 

uint32_t lengthindexindex[64]={6,6,6,6,6,6,6,6}; // index into CVlist which matches function index into bitfunction array -- 6 is CVL[w]
uint32_t GSlist[64]={0,0,0,0}; // matching GS types for function index
uint32_t OUTlist[64]={0,0,0,0}; // matching OUT types for function index 

// INSIDE // OUTSIDE functions
// INSIDE flips inside IN to OUTSIDE

// need to take care of which adc and which dac!
void SR_geomanticxxx(uint8_t w){  // with stacks - we push these all in init/caput000 - seems to be working // how to make more generic!
  HEADNADA;
  static pair cvs[4];
  static pair bitcvs[8];
  
  // where do we get that speedfunc and CV indexes from - from a modeR which can allow local changes or change/move from matrices...
  // but why do we have stack... as is all fixed in this change here?
  
  if (gate[w].changedspeed){ 
    //pushspeed(gate[w].speedfunc, w); // pushes as test now in caput000
    speedff[w]=peekspeed(w);
    gate[w].changedspeed=0;
  }

  // attach 2x cv pointers which should be a pair - again abstract out how we arrive at these - 2 uint32_t pointers - lookup for these
  if (gate[w].changedspeedcv){ 
    //pushspeedcv(CVlist[w][cvpair[gate[w].speedcv][0]], CVlist[w][cvpair[gate[w].speedcv][1]], w);
    cvs[w]=peekspeedcv(w);
    gate[w].changedspeedcv=0;
  }
  
  // does it need interpol?
  if (interp[gate[w].speedfunc]){ // gate[w].func[spdfunccnt][fspeed]
    gate[w].alpha = gate[w].time_now - (float)gate[w].int_time;
    gate[w].dac = ((float)delay_buffer[w][DELAY_SIZE-5] * gate[w].alpha) + ((float)delay_buffer[w][DELAY_SIZE-6] * (1.0f - gate[w].alpha));
   if (gate[w].dac>4095) gate[w].dac=4095;
  }
  else gate[w].dac = delay_buffer[w][1];
  
  // do speed
    if ((*speedff[w])(*(cvs[w].cv1), *(cvs[w].cv2), w)){
    LASTSPEED; // new macro to deal with lastspeed 16/6

    switch (GSlist[gate[w].bitindexy])
      {
      case 0:
	GSHIFT_;
	break;
      case 1:
	GSHIFTNOS_;
	break;
      }
	
    // CORE   
    if (w==0){ // real ADC - TESTY - how we will handle adc across all
      ADCgeneric2; // input into shared one..
      // and do ADC
      bitn=(*adcfromsd[gate[w].adcindex])(4095-(*CVlist[w][gate[w].adccvindex]), ADCin, w); // how do we select adc and its CV! // not in stack but index: for cvs too
    }
    
    // BITN
    if (gate[w].changedbit){
    //    pushbit(gate[w].bitfunc, w); // pushes chosen function onto indexy to match length etc...
      bitff[w]=peekbit(w);
      gate[w].lengthindex=lengthindexindex[gate[w].bitindexy];  // there are 64 bitfuncs - but how we access bitfunc
      gate[w].changedbit=0;
  }

    // deal with length too - length is lengthindex[stackindexfrombitfunctionbelow]
    SRlength[w]=lookuplenall[(*CVlist[w][gate[w].lengthindex])>>7];
   
    // and now we need our CVs
    if (gate[w].changedbitcv){ 
    //pushspeedcv(CVlist[w][cvpair[gate[w].speedcv][0]], CVlist[w][cvpair[gate[w].speedcv][1]], w);
    bitcvs[w]=peekbitcv(w);
    gate[w].changedbitcv=0;
  }
    
    bitn^=(*bitff[w])(*bitcvs[w].cv1, *bitcvs[w].cv2, w); // fix CVs
    // ENDCORE // what are possible OUTs? with/without DAC and     gate[w].shift_+=bitn; - we can use switch here
      switch (OUTlist[gate[w].bitindexy])
      {
      case 0:
	BITN_AND_OUTV_; // revert to this one which does not used dacfunc but gate[w].dactype which we need to set... where? TODO!
	break;
      case 1:
	BITN_AND_OUTVXOR_;
      case 2:
	BITN_AND_OUTVNOSHIFT_; // no bitn in!
	break;
      }

      new_data(val,w);
    }
}

//unused below!

  /*
typedef struct stack_ {
  uint32_t (*speedfrom)(uint32_t depth, uint32_t in, uint32_t wh);
  uint32_t* speedcv1;
  uint32_t* speedcv2;
  uint32_t (*bit)(uint32_t depth, uint32_t in, uint32_t wh);
  uint32_t* bitcv1;
  uint32_t* bitcv2;
  uint32_t* lencv;
  uint32_t bitindexy;
  uint32_t speedindexy;
} stack;
  */

//   {&nulll, &gate[0].dac, &gate[1].dac, &gate[2].dac, &gate[3].dac, &CV[0], &CVL[0], &CVM[0], &ADCin, &Gshift_[0], &Gshift_[1], &Gshift_[2], &Gshift_[3], &clksr_[0], &param[0], &Gshift_[8], &gate[0].oldcv, &gate[0].oldcvl, &gate[0].oldcvm, &gate[0].adctype, &gate[0].dactype, &SRlength[0]},
// example // copy to stacky in caput000 
/*

stack stackNN[64]={ //unused and we can't copy or...
  {&spdfrac, &CV[0], &nulll, &binroutfixed, &CVL[0], &nulll, &SRlength[0], 2, 3}, // values and pointers, or even just names of function pointers so we don't lookup ... but speedindex is function index for interpoll lookup eg. spdfrac=3
};

// we need to alter to fix adc/dac parameters and selections // in stack or not
void SR_geomanticxxxx(uint8_t w){  // non-stack version with reduced index (but we use stacky as structure)
  // gate[w].stacky[gate[w].stackindex].speedfrom
  HEADNADA;
  
  // does it need interpol?
  if (interp[gate[w].stacky[gate[w].stackindex].speedindexy]){ // gate[w].func[spdfunccnt][fspeed] // bitindexy is not speedfunc
    gate[w].alpha = gate[w].time_now - (float)gate[w].int_time;
    gate[w].dac = ((float)delay_buffer[w][DELAY_SIZE-5] * gate[w].alpha) + ((float)delay_buffer[w][DELAY_SIZE-6] * (1.0f - gate[w].alpha));
   if (gate[w].dac>4095) gate[w].dac=4095;
  }
  else gate[w].dac = delay_buffer[w][1];
  
  // do speed
    if ((*gate[w].stacky[gate[w].stackindex].speedfrom)(*(gate[w].stacky[gate[w].stackindex].speedcv1), *(gate[w].stacky[gate[w].stackindex].speedcv2), w)){
    LASTSPEED; // new macro to deal with lastspeed 16/6

    switch (GSlist[gate[w].stacky[gate[w].stackindex].bitindexy])
      {
      case 0:
	GSHIFT_;
	break;
      case 1:
	GSHIFTNOS_;
	break;
      }
	
    // CORE   
    if (w==0){ // real ADC - TESTY - how we will handle adc across all
      // TODO: adctype= // adcpar=
      ADCgeneric2; // input into shared one..
      //            bitn=(*gate[w].stacky[gate[w].stackindex].adcfunc)(4095-(*gate[w].stacky[gate[w].stackindex].adccv), ADCin, w); // how do we select adc and its CV! // not in stack but index: for cvs too
      bitn=ADC_(0,SRlength[w],gate[w].adctype,gate[w].trigger,3,gate[w].adcpar, &gate[w].shift_); // fill in regg as 3 and adcpar needs changes, length too or???
    }
    
    // deal with length too - length is lengthindex[stackindexfrombitfunctionbelow]
    SRlength[w]=lookuplenall[(*gate[w].stacky[gate[w].stackindex].lencv)>>7];
       
    bitn^=(*gate[w].stacky[gate[w].stackindex].bit)(*gate[w].stacky[gate[w].stackindex].bitcv1, *gate[w].stacky[gate[w].stackindex].bitcv2, w); // fix CVs
    // ENDCORE // what are possible OUTs? with/without DAC and     gate[w].shift_+=bitn; - we can use switch here - dac is now just dactype but where can we set this?
    // TODO: dactype= // dacpar=
      switch (OUTlist[gate[w].stacky[gate[w].stackindex].bitindexy])
      {
      case 0:
	BITN_AND_OUTV_; // revert to this one which does not used dacfunc but gate[w].dactype, dacpar which we need to set... where? TODO!
	break;
      case 1:
	BITN_AND_OUTVXOR_;
      case 2:
	BITN_AND_OUTVNOSHIFT_; // no bitn in!
	break;
      }

      new_data(val,w);
    }
}

*/


/* from segmodes

discard basic 64x64x64x64 modes with some overlap for other models...

double/ghost tail - how to do this without slowing down...

basis:
[adc/gen types/params -> bit in/prob]
speed/from
length/from
binroute/type/from -> bit in/prob
[dac out/types/interpoll]

from: CV, CVL, DAC1-4, (ADC), CLKSR/strobe, generators/which need params themselves (5th tail as further param)

prob/bitin is: CVvsDACx, CVvsLFSR, DACvsLFSR, strobe

- basic routing modes: type of binroute, permutations below,
- interpol is only for dac/ int/noint across all modes?
- leave speed. length at previous values. eg. early modes can set these quite easily

602 modes extracted: some are duplicates across L and R, also some templates etc... still...

64x4=256! 4x16=64

*what are models to choose from // for major minor modes:*

1-new geomantic/generic model

2-dacbus?  // how?

3-generic vienna model: redo with interpoll (also if this is for major/minor modes how does RSR fit with reduced bits of course?, then RSR is more like tail)

4-abstractions: list these? but still have param shortage...

5-expanded rungler model with different options and switched routings TODO

6-mishmash here: bitmodes, probmodes, recursions, esoteric modes
minor/major modes,

7-bitmodes

8-?

ghost/tails - where do we use these?

layers/hold/detach, 
modes initiate streams (below), 
all as bits and functions/gens, 

what are probable/possible recursions? of dac/sr onto ANY parameter, of dac/sr onto choice of parameter, of dac/sr onto parameter of function outputing parameter...

SR is function, SR recurs... smaller loops eg. N->L->N->C->R->N

** modeN

- too many ADC modes, how do we deal with functions and options for CV ins/params...

param from cv, dac, clkspd/clk:

eg. 

void adc95(uint8_t w){ // strobe toggle in - otherpar selects pattern which is now dac driven - 4 bits
  param[w]=gate[dacfrom[daccount][w]].Gshift_[w]>>8;
  ADCXORIN(95); 
}

standard routing - is no route in option itself or from modeR?

type of adc, type of route in!

type of adc: lists we have, type of param

also use abstract generators here...

** modeC

- no stoppage
- how many dac/options

** modeR

- null mode - 0 out = SRRnada

** LLLRRRetc

speed as CV:
[LEN,   ROUTE]
1 ['DACx', 'genCV']
2 ['DACx', 'CV']
3 ['CV', 'fixed']
4 ['fixed', 'CV']
5 ['genCV', 'fixed']
6 ['CV', 'DACx']
7 ['genCV', 'DACx']
8 ['fixed', 'genCV']

xx[LEN,   ROUTE]
1 ['CV', 'fixed']
2 ['DACx', 'CV']
3 ['fixed', 'CV']
4 ['CV', 'DACx']


genCV uses CV driven gen (which one? as we just have one CV so is fixed gen or no options: to generate route, eg. binroute)

genCV needs to generate 4 bits for route, 5 bits for len

+ type of binroute: 8 options =8x8=64!

always too many options and if we go for major/minor is too fixed...

also for abstract bitstreams we need cv to select and cv/dac as param...



 */

// for new geomantic abstraction: start again again with generics - this one for binroutes
//     [need better labelling scheme]

/*

- how that looks for inputs - what we compare to what?
- or we just have list of probs to make things easier...

- and for bits: bt = (gate[wh].Gshift_[wh]>>SRlength[wh]) & 0x01;

*invert routed/bit*
*routed vs cycling// routed vs inverted cycling*
*routed vs [routed^cycling]*

 */


/*

- for speeds/bits - return bits - for adc=bits: can be adc, dac (as input with adc style processing), or bits as for speed/bits - make more generic

but speed ones handle dac/interpol

- for length: return length/0-31 - could plug in other functions
// so length as seperate or as a re-processor...

merge all bits for speeds, for adc

how to label/categorise: 

- deal with a route
- abstract bit routines
- process a value
- deal with adc
- deal with dac but:

could we even abstract out further so adc/13 is depth input - but also look at adcs
and function is a processor of these to return bits

return a value from bits (this is what dacs do)... process a value... generate a value (eg. from a route)

value to bits (adc)
bits to values (dac)

*/  

// generic probability to test for adapted rungler in // unused
static inline uint32_t genericprob(uint32_t cv, uint32_t against, uint32_t bit1, uint32_t bit2){
  if (cv>against) return bit1;
  else return bit2;
}



uint32_t funcmax[64][13]={
  {8,2,17,61,23, 11,11,11,11,11,11,11,11}, // maximum value if x>funcmax... // update these as we add more functions
};

uint32_t funcN[64][13]={
  //  {1,1,1,0,0, 5,0,6,0,6,8,0,0}, // first set is from geomantic.h with test of dacmix!
      {2,0,1,59,0, 5,6,6,0,6,8,6,7}, // for rungler with speed from R
};

uint32_t funcL[64][13]={
  //    {1,1,0,2,0, 5,0,6,0,6,0,1,0},
    {2,0,0,59,0, 5,6,6,0,6,0,6,7}, // rung2
};

uint32_t funcC[64][13]={
  //  {1,1,0,2,1, 5,0,6,0,6,0,1,0},
  {1,0,0,60,1, 5,0,6,7,0,0,4,0}, // rung - speed from cv, route from R //
};


uint32_t funcR[64][13]={
  {2,1,0,61,0, 5,6,6,0,0,0,1,0}, // route from L, speed from N
};


// counts for maps eg. routes, dacfrom, lengthfrom...
// maps below... for routes
// uint32_t *countfield[8]={&count, &daccount, &spdcount, &adccount, &dactcount, &binroutetypecount, &lengthcount};

// for functions we need to have: 

// speedfunccnt, dactypecnt, lengthfunccnt, adcfunccnt, bitfunccnt ///are indexes
// cvcount

uint32_t *funcfield[8]={&dactypecnt, &spdfunccnt, &lengthfunccnt, &adcfunccnt, &bitfunccnt, &cvcount}; // only 6 there

// TODO: versions of this...
// possibly more generic with grid of CV, CVL, DAC[x] which we index from table and pass to speedfrom/bitfroms etc????

// we already have: uint32_t *CVlist[4][16]={
//  {&gate[0].dac, &gate[1].dac, &gate[2].dac, &gate[3].dac, &CV[0], &CVL[0], &gate[0].Gshift_[0], &clksr_[0]}, // etc
// so we can also index with dacfrom 0-3 as first ones
// ... but Gshift is 32 bits and clksr we don't use...

//1speed 
uint32_t speedfunc[64][4]={ 
{1,1,1,1}, // 
};

//2length
uint32_t lengthfunc[64][4]={ // these need to return a value 3->31
{1,1,1,0}, // 
};

//3adc
uint32_t adcfunc[64][4]={ 
{1,0,0,0}, // 
};

//4bits
uint32_t bitfunc[64][4]={  //  below just to test things 16 so far - but problem is it can select itself out of the equation unless all are there...
  {3,3,3,1}, // was 3,3,3,1
{3,3,4,1},
{3,3,5,1},
{3,3,6,1},

{3,3,7,1},
{3,3,8,1},
{3,3,9,1},
{3,3,10,1},

{3,3,11,1},
{3,3,12,1},
{3,3,13,1},
{3,3,14,1},

{3,3,15,1},
{3,3,16,1},
{3,3,17,1},
{3,3,18,1},
};
//......//

uint32_t whichdac[64][4]={ // some dacs use param/cv??? which -> 10,12,13,14,16
{0,0,0,0},
};

// binroutetypes is in tables.h for now

// just for speedfrom and bitfrom maybe or...
// so we need index into this list eg.

// TEST: should cvcount be for all - so is gridlike
// 4x4 - geomantic figures - now we have 6 sets here
//  {&nulll, &gate[0].dac, &gate[1].dac, &gate[2].dac, &gate[3].dac, &CV[3], &CVL[3], &ADCin, &Gshift_[3], &clksr_[3], &param[3]}
//   0,        1             2             3             4             5       6        7            8           9         10

uint32_t speedcvin[64][4]={ 
  {5,5,5,5}, // all CV
  {4,1,1,1}, // default - these next are from speedfrom
  {1,1,1,1}, // synced...
  {2,2,2,2}, // synced...
  {3,3,3,3}, // synced...
  {4,4,4,4}, // synced...
  {1,2,3,4}, // itself...

};

uint32_t speedcv[64][4]={ 
  {0,0,0,0}, // this is the modifier
  {5,5,5,5}, // all CV
  {5,5,5,5}, // all CV
  {5,5,5,5}, // all CV
  {5,5,5,5}, // all CV
  {5,5,5,5}, // all CV
  {5,5,5,5}, // all CV
};

uint32_t lengthcv[64][4]={ 
  {6,6,6,6}, // all appropriate CVL  
};

uint32_t daccv[64][4]={ 
  {0,0,0,0}, // 
};


uint32_t adccv[64][4]={ 
  {6,6,6,6}, 
};

uint32_t adccvv[64][4]={ // this is adc itself IN
  {7,0,0,0}, 
};

uint32_t bitcv[64][4]={ 
  {5,5,5,5}, // CVL for tests now = 5,5,5,5
  {4,4,4,2}, // default - brought in from dacfrom and incremented
  {2,4,2,2}, // new one for rungling 24/1/2022
  {4,1,2,3}, // from latest notebook prev ones: 3,0,1,2
  {1,2,3,4}, // itself
  {4,3,2,1}, // reverse
  {4,4,4,4},
  {3,3,3,3},
  {2,2,2,2},
  {4,4,2,2},
  {2,2,4,4},
  {3,4,1,2}, // opposites
  {2,1,4,3},
  {2,3,4,1}, // nexts
  {4,3,2,1}, /// rev
  {2,4,2,2},
  {2,4,2,2}
};

uint32_t bitcvv[64][4]={ // for comparator functions
  {0,0,0,0}
};

// speedfunccnt, dactypecnt, lengthfunccnt, adcfunccnt, butfunccnt are indexes
// cvcount

// as prototype with modeR global functions but this one can also be adapted... eg. changes of gshift etc...
// also versions with individual entries in and length etc. as just staying static...
// also use some with index as CVlist[dacfrom[w]+1] !!!
void SR_geomantic(uint8_t w){  // working now for basics
  HEADNADA;
  if (interp[speedfunc[spdfunccnt][w]]){   // pulled out interp:
    gate[w].alpha = gate[w].time_now - (float)gate[w].int_time;
    gate[w].dac = ((float)delay_buffer[w][DELAY_SIZE-5] * gate[w].alpha) + ((float)delay_buffer[w][DELAY_SIZE-6] * (1.0f - gate[w].alpha));
    if (gate[w].dac>4095) gate[w].dac=4095;
  }
  else gate[w].dac = delay_buffer[w][1];

  CLKSR; // new macro deals with intflag outside speed
  if ((*speedfromsd[speedfunc[spdfunccnt][w]])(*CVlist[w][speedcvin[cvcount][w]],*CVlist[w][speedcv[cvcount][w]], w)){ // speedfunc
    LASTSPEED; // new macro to deal with lastspeed 16/6
    gate[w].dactype=whichdac[dactypecnt][w]; // question of dactypes which need param/cv also
    gate[w].dacpar=*CVlist[w][daccv[cvcount][w]];
    if (lengthfunc[lengthfunccnt][w]!=0){ // so function 0 null should just hold length
    SRlength[w]=(*lengthfromsd[lengthfunc[lengthfunccnt][w]])(*CVlist[w][lengthcv[cvcount][w]],w); // lengthfunc
    }
    GSHIFT_;  // replace with types of gshift - gshiftfuncs...
    // CORE
    if (adccvv[cvcount][w]==8){ // real ADC
      ADCgeneric2; // input into shared one..
    }
    bitn=(*adcfromsd[adcfunc[adcfunccnt][w]])(4095-(*CVlist[w][adccv[cvcount][w]]), *CVlist[w][adccvv[cvcount][w]],w); // extra param which is INPUT - inverted?
    bitn^=(*bitfromsd[bitfunc[bitfunccnt][w]])(*CVlist[w][bitcv[cvcount][w]], *CVlist[w][bitcvv[cvcount][w]],w); // extra param for comparators?
    // ENDCORE
    //    if (strobey) bitn|=gate[w].trigger;	 // extra bits in if necessary or is another function
    BITN_AND_OUTV_; // pulsin is in there
    new_data(val,w);
}  
}

/*
from CVM-12 bits-> spdfunc, lengthfunc, adcfrom, bitfrom, dactype

or CVM can be xxxfuncnct - how we organise this?

// 

 */

void SR_geomanticx(uint8_t w){  // for alternative arrays... working now
  HEADNADA;
  if (interp[gate[w].func[spdfunccnt][fspeed]]){ // gate[w].func[spdfunccnt][fspeed]

    gate[w].alpha = gate[w].time_now - (float)gate[w].int_time;
    gate[w].dac = ((float)delay_buffer[w][DELAY_SIZE-5] * gate[w].alpha) + ((float)delay_buffer[w][DELAY_SIZE-6] * (1.0f - gate[w].alpha));
   if (gate[w].dac>4095) gate[w].dac=4095;
  }
  else gate[w].dac = delay_buffer[w][1];

  CLKSR; // new macro deals with intflag outside speed
  if ((*speedfromsd[gate[w].func[spdfunccnt][fspeed]])(*CVlist[w][gate[w].func[cvcount][cvspeed]],*CVlist[w][gate[w].func[cvcount][cvspeedmod]], w)){ // speedfunc
    LASTSPEED; // new macro to deal with lastspeed 16/6
    gate[w].dactype=gate[w].func[dactypecnt][fdac]; // question of dactypes which need param/cv also
    gate[w].dacpar=*CVlist[w][gate[w].func[cvcount][cvdac]];

    
    if (gate[w].func[lengthfunccnt][flength]!=0){ // so function 0 null should just hold length
    SRlength[w]=(*lengthfromsd[gate[w].func[lengthfunccnt][flength]])(*CVlist[w][gate[w].func[cvcount][cvlength]],w); // lengthfunc
    }
    GSHIFT_;  // replace with types of gshift - gshiftfuncs...
    // CORE
    
    if (gate[w].func[cvcount][cvadcIN]==8){ // real ADC
    ADCgeneric2; // input into shared one..
    }
    bitn=(*adcfromsd[gate[w].func[adcfunccnt][fadc]])(4095-(*CVlist[w][gate[w].func[cvcount][cvadc]]), *CVlist[w][gate[w].func[cvcount][cvadcIN]],w); // invert?
    bitn^=(*bitfromsd[gate[w].func[bitfunccnt][fbit]])(*CVlist[w][gate[w].func[cvcount][cvbit]], *CVlist[w][gate[w].func[cvcount][cvbitcomp]],w);
    // ENDCORE
    //    if (strobey) bitn|=gate[w].trigger;	 // extra bits in if necessary or is another function
    BITN_AND_OUTV_; // pulsin is in there
    new_data(val,w);
}  
}


//enum refs {fspeed, flength, fadc, fbit, fdac, cvspeed, cvspeedmod, cvlength, cvdac, cvadc, cvadcIN,  cvbit, cvbitcomp};

/*

GRID? which needs to occupy CV and CVL

speedfroms:
whichdac:
lengthsfroms:
whichadc:
bitfromsd:
bitcv:

how to line up?

 */

/*
- what the sixteen rmodes could be to manipulate these counts: list what we manipulate here and what needs to stay in groups and 
  what can change independently

// uint32_t *countfield[8]={&count, &daccount, &spdcount, &adccount, &dactcount, &binroutetypecount, &lengthcount}; // do we use all of these?
// uint32_t *funcfield[8]={&dactypecnt, &spdfunccnt, &lengthfunccnt, &adctypecnt, &bitfunccnt}; // only 5 there

// countfield is routings, funcfield always needs to match in uses of CV - or could double up?

- we have some below. resetall is on last stop! 63

we have 8 counts we can shift independently with setall below which is clocked by strobe...
or we can have 8 functions for select...

we can bump on all, just one set/group, with strobe, with cv

binary manipulations we have below (one)

also advanced and more recursion of SR (which?) on to groups eg. we can use another speedfrom to bump on counts

 */



//prev groups

adcdraft0, adcdraft1, adcLparallel, adcLparallel2, adcLdraft2, adcnoroute0, adc0nog, adcorxor0, adcbumproute0, adcbumproutebin0, adcghostroute0, adcDACroute0, adcSRroute0, adcbin1_0, adcLCVDACroute, adcmultiplespeednew0, adcLdoublelength, adcLflip, adcLbinrstr, adcLbitprob, adcspeedstream, adcbinspeedstream, binspeedcycle, binnospeedcycle, adcLabstract, adcLabstractNOG, adcLabstractI, adcLabstractQIN, adcLTMinTM, adcLabstractTM, adcLFROM, adcLpattern95, adcLpatternbin95, adcLtm101, adcLtm102, adcLtm103, adcLtm104, adcLtm105, adcLcomp20, adcLsub92, adcLsplice100, adcLBURST0, adcLseladc, adcLcutfeedback86, adcLseladc1, adcLseladc2, adcLseladc5th, adcLseladcdac5th, adcdacmod5th, adcLpulse89, adcLSRlengthsel, adcLSRlengthsel0, adcLLswop0, adcgenericprobx, adcdacadditself0, adcdacghostitself0, adcdacghostincoming0, adcdacseladd0, adcdacseloffosc, adcdacseloffosc2, adcLrung0, adcLrung1, adcLrung2, adcrung0, adcdacadd0, adcdacaddmax0, adcdacminus0, adcdacspeedminus0, adcdacmod0, adcdacB0, adcdacoffset0, adcLdacadc, SR_binr_adc0, adc_overonebit, adcone_bitreset, adc0_newgsr, ADCovers, ADCoverss, ADCoversss, ADCoverssss, ADChold, ADCholdcycle, ADCnoisecmp, adccipher, adccipher2, noSRadc, adcLrung0, adcLrung1, adcLrung2, adcrung0, adcdacadd0, adcdacaddmax0, adcdacminus0, adcdacspeedminus0, adcdacmod0, adcdacB0, adcdacoffset0, adcLdacadc, SR_binr_adc0, adc_overonebit, adcone_bitreset, adc0_newgsr, ADCovers, ADCoverss, ADCoversss, ADCoverssss, ADChold, ADCholdcycle, ADCnoisecmp, adccipher, adccipher2, noSRadc

SR_cvbits, SRdacplusminus, SR_binr_fixed, SR_binr, SR_binr_dac0, SR_routeSRbits00, SR_routeSRbits01, SR_routeSRbits02, SR_layer12, SR_reflect, SR_altbin1, SR_binspdx, SR_insert_zero, SR_insert_zero_dac2, SRdelay_lineIN, SRintodel, SR_probbin, SRX0_newgsr, SRX0_newgsr_nores, SRholdspd, SRownspd, SR_recbin, SR_splitx, SRhold, SRholdfromdac, SRothers, SR_genspeed2, SR_genspeed3, SRghost, SRghostlatch, SRxorSR, SRxorroutes, SRaddroutes, SR_vienna, SR_switchspeed, SR_selspeed, SRprobxortog, SRprobxortogx, SRmatch, SRshare, abstractoutinterpolnoshift, abstractoutinterpol, abstractoutinterpolroute, abstractoutinterpolrung, SRmultiplespeednewdac0, SRmultiplespeednewdac, noSRdelay_line, SRdelay_lineSH, SRdelay_lineSH2, SRdelay_line, SRpattern_unshare, SRLdecaying, SRGswop, noSRselxorroutes, SRprobwheel, dacNbinprob, SRLprobnog, SRsigma, SRshiftQ1, SRsuccroute, SRNwas14, SRNprob, SRNwas15, SRN3, SRN4, SRN5, SRN6, SRN7, SRN8, SRN10, SRN11, SRN12, SRN13, SRN14, SRN15, SRN21, SRN22, SRN29, SRN30, SRN33, SRN33cipher, SRN34, SRNsr35, SRN35, SRN36, SRN38, SRN40, SRLLswop, SRN42, SRN46, SRN48, SRN50, SRN62, SRN65, SRNwas13, SRno, SR0, SR0nog, SR1, SR2, SR3, SR4, SRosc, SRmod, SRbumproute, SRLLbumproute, SRDACroute, SRSRroute, SR32, SRmultiplespeednew, SRmultiplespeed0, SRmultiplespeed1, SRmultiplespeed2


              dacNLRin, dacNLRinlogic, dacLRprob, dacLRprobxorN, dacNLRprobin1311, dacLNLRin, dacadc, dacosc0, dacLLswop, dacN, dacLBURST0, dacL16slide, dacLrung0, dacN17_0, dacN18_0, dacLDACSEL0, dacL12, dacLDACSRSEL0, dac0, dacnov0, dac0nog, dac1, dac3, dac4, dac5, dac6, dac7, dac8, dac9, dac10, dac11, dac12, dac13, dac14, dac15, dacreal15, dac17, dac18, dac19, dac20, dac21, dac67_4bits, dac67_4bitsNOGG, dac66, dac68, dacbumproute0, dacDACroute0, dacSRroute0, dac32, dacdacadditself0, dacdacghostitself0, dacdacghostincoming0, dacdacseladd0, dacdacadd0, dacdacminus0, dacdacspeedminus0, dacdacmod0, dacB0, dacdacoffset0, dacbus, dacbusothers, dacbusothers_clk, dacbusothers_sr, dacbusothers_own, noSRdac, noSRdac2sRLxor, SR_cvbits, SRdacplusminus, SR_binr_fixed, SR_binr, SR_binr_dac0, SR_routeSRbits00, SR_routeSRbits01, SR_routeSRbits02, SR_layer12, SR_reflect, SR_altbin1, SR_binspdx, SR_insert_zero, SR_insert_zero_dac2, SRdelay_lineIN, SRintodel, SR_probbin, SRX0_newgsr, SRX0_newgsr_nores, SRholdspd, SRownspd, SR_recbin, SR_splitx, SRhold, SRholdfromdac, SRothers, SR_clksrG, SR_clksr, SR_genspeed2, SR_genspeed3, SRghost, SRghostlatch, SRxorSR, SRxorroutes, SRaddroutes, SR_vienna, SR_switchspeed, SR_selspeed, SRprobxortog, SRprobxortogx, SRmatch, SRshare, abstractoutinterpolnoshift, abstractoutinterpol, abstractoutinterpolroute, abstractoutinterpolrung, SRmultiplespeednewdac0

  SR_cvbits, SRdacplusminus, SR_binr_fixed, SR_binr, SR_binr_dac0, SR_routeSRbits00, SR_routeSRbits01, SR_routeSRbits02, SR_layer12, SR_reflect, SR_altbin1, SR_binspdx, SR_insert_zero, SR_insert_zero_dac2, SRdelay_lineIN, SRintodel, SR_probbin, SRX0_newgsr, SRX0_newgsr_nores, SRholdspd, SRownspd, SR_recbin, SR_splitx, SRhold, SRholdfromdac, SRothers, SR_clksrG, SR_clksr, SR_genspeed2, SR_genspeed3, SRghost, SRghostlatch, SRxorSR, SRxorroutes, SRaddroutes, SR_vienna, SR_switchspeed, SR_selspeed, SRprobxortog, SRprobxortogx, SRmatch, SRshare, abstractoutinterpolnoshift, abstractoutinterpol, abstractoutinterpolroute, abstractoutinterpolrung, SRmultiplespeednewdac0, noSRdelay_line, SRdelay_line



// 15 octaves now
const float slowerlog[1024]  __attribute__ ((section (".flash"))) = {1.000000f, 0.989888f, 0.979878f, 0.969970f, 0.960161f, 0.950452f, 0.940841f, 0.931328f, 0.921910f, 0.912588f, 0.903360f, 0.894225f, 0.885183f, 0.876232f, 0.867371f, 0.858600f, 0.849918f, 0.841324f, 0.832816f, 0.824395f, 0.816059f, 0.807807f, 0.799638f, 0.791552f, 0.783548f, 0.775625f, 0.767782f, 0.760018f, 0.752333f, 0.744725f, 0.737195f, 0.729740f, 0.722361f, 0.715056f, 0.707826f, 0.700668f, 0.693583f, 0.686570f, 0.679627f, 0.672755f, 0.665952f, 0.659218f, 0.652552f, 0.645953f, 0.639421f, 0.632955f, 0.626555f, 0.620219f, 0.613948f, 0.607739f, 0.601594f, 0.595511f, 0.589489f, 0.583528f, 0.577627f, 0.571786f, 0.566005f, 0.560281f, 0.554616f, 0.549007f, 0.543456f, 0.537960f, 0.532521f, 0.527136f, 0.521805f, 0.516529f, 0.511306f, 0.506135f, 0.501017f, 0.495951f, 0.490936f, 0.485972f, 0.481058f, 0.476193f, 0.471378f, 0.466611f, 0.461893f, 0.457222f, 0.452599f, 0.448022f, 0.443492f, 0.439007f, 0.434568f, 0.430174f, 0.425824f, 0.421518f, 0.417255f, 0.413036f, 0.408860f, 0.404725f, 0.400633f, 0.396581f, 0.392571f, 0.388602f, 0.384672f, 0.380782f, 0.376932f, 0.373120f, 0.369347f, 0.365612f, 0.361915f, 0.358256f, 0.354633f, 0.351047f, 0.347497f, 0.343983f, 0.340505f, 0.337062f, 0.333653f, 0.330280f, 0.326940f, 0.323634f, 0.320361f, 0.317122f, 0.313915f, 0.310741f, 0.307598f, 0.304488f, 0.301409f, 0.298361f, 0.295344f, 0.292358f, 0.289401f, 0.286475f, 0.283578f, 0.280711f, 0.277872f, 0.275062f, 0.272281f, 0.269528f, 0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

    //    bitn=ADC_(w,SRlength[w], whichadc[adctypecnt][w],bitn,dacfrom[daccount][w],param[w], &gate[w].shift_); // as adc functions or as bitfuncs????

// now for length
static inline uint32_t lcvl(uint8_t wh){ 
  uint32_t bt=lookuplenall[CVL[wh]>>7]; // 5 bits
  return bt;
}



/*
// for manual binroute
    tmp=(tmpp&15); // lowest 4 bits - other logical ops - logops from bits - noisy as CV noise
    for (x=0;x<4;x++){
      if (tmp&0x01){
	bitrr = (gate[x].Gshift_[w]>>SRlength[x]) & 0x01; 
	gate[x].Gshift_[w]=(gate[x].Gshift_[w]<<1)+bitrr; 
	bitn^=bitrr;
      }
      tmp=tmp>>1; // 4 bits
    }
*/



uint32_t neworder[4]={3,2,1,0}; // order backwards

uint32_t neworders[24][4]={
  {0,1,2,3},
  {0,1,3,2},
  {0,2,1,3},
  {0,2,3,1},
  {0,3,1,2},
  {0,3,2,1},
  {1,2,3,0},
  {1,2,0,3},
  {1,3,2,0},
  {1,3,0,2},
  {1,0,2,3},
  {1,0,3,2},
  {2,3,0,1},
  {2,3,1,0},
  {2,0,1,3},
  {2,0,3,1},
  {2,1,3,0},
  {2,1,0,3},
  {3,0,1,2},
  {3,0,2,1},
  {3,1,2,0},
  {3,1,0,2},
  {3,2,1,0},
  {3,2,0,1}  
};


static inline uint32_t adc4bits_unshare(uint32_t depth, uint8_t wh){ // use wh too so matches other gens
  uint32_t bt, k;
  static uint32_t fast=0, khh;
  static int32_t bc[4]={0,0,0,0};
  static uint32_t kh[4]={0,0,0,0};

  // run at fastest - but all of them are running this! 
  if (fast>3){  
  ADCgeneric;
  khh=k>>8;
  fast=0;
  }
  fast++;
  
  if (bc[wh]<0) {
    kh[wh]=khh;
    bc[wh]=3; 
  }
  bt = (kh[wh]>>bc[wh])&0x01; // this means that MSB comes out first
  bc[wh]--;
  return bt;
}


// was speed.h

void Ndacoffset0(void){
  uint8_t w=0;
  float speedf__;
  float mmm=(float)(1024-(CVL[0]>>2))/1024.0f;
  HEADSINN;
  tmp=(1024-(CV[0]>>2)) + (int)((float)(gate[dacfrom[daccount][0]].dac>>2)*mmm);
  if (tmp>1023) tmp=1023;
  speedf__=logspeed[tmp]; // 9 bits + 9 to 10 bits - we still have one bit - must  be outside...
  if (speedf__==2.0f) speedf__=LOWEST;

  CVOPENDAC;
  if(gate[w].last_time<gate[w].int_time)      {
    GSHIFT_;
    BINROUTE_;
    PULSIN_XOR;
    BITN_AND_OUTV_;
    ENDER;
  }
}


void Rdacadditself0(void){ // tested//trial itself as DAC - can also be other variants TODO
  HEADR;
  uint8_t w=3;
  float speedf__;
  speedf__=logspeed[(CV[3]&511)+(gate[3].dac>>3)];
  if (speedf__==2.0f) speedf__=LOWEST;
  CVOPENDAC;
  if(gate[w].last_time<gate[w].int_time)      {
    GSHIFT_;
    BINROUTE_;
    BITN_AND_OUTVN_;
    ENDER;
  }
}

void Rdacghostitself0(void){ // own ghost from next 1 - could also select incoming ghost which would be: gate[3].Gshift_[0]//gate[x].Gshift_[w]
  HEADR;
  uint8_t w=3;
  float speedf__;
  speedf__=logspeed[(CV[3]&511)+((gate[3].Gshift_[routeto[count][3]])&511)];
  if (speedf__==2.0f) speedf__=LOWEST;
  CVOPENDAC;
  if(gate[w].last_time<gate[w].int_time)      {
    GSHIFT_;
    BINROUTE_;
    BITN_AND_OUTVN_;
    ENDER;
  }
}

void Rdacghostincoming0(void){ // own ghost from next 1 - could also select incoming ghost which would be: gate[3].Gshift_[0]//gate[x].Gshift_[w]
  HEADR;
  uint8_t w=3;
  float speedf__;
  speedf__=logspeed[(CV[3]&511)+((gate[3].Gshift_[inroute[count][3]])&511)];
  if (speedf__==2.0f) speedf__=LOWEST;
  CVOPENDAC;
  if(gate[w].last_time<gate[w].int_time)      {
    GSHIFT_;
    BINROUTE_;
    BITN_AND_OUTVN_;
    ENDER;
  }
}

void Rdacseladd0(void){
  HEADR;
  uint8_t w=3;
  float speedf__;
  uint8_t whic=(CV[3]>>9)&3; //12 bits -> 2 bits
  speedf__=logspeed[(CV[3]&511)+(gate[whic].dac>>3)]; // 9 bits + 9 to 10 bits - we still have one bit - must  be outside...
  if (speedf__==2.0f) speedf__=LOWEST;
  CVOPENDAC;
  if(gate[w].last_time<gate[w].int_time)      {
    GSHIFT_;
    BINROUTE_;
    BITN_AND_OUTVN_;
    ENDER;
  }
}

void Rdacadd0(void){
  HEADR;
  uint8_t w=3;
  float speedf__;
  speedf__=logspeed[(CV[3]&511)+(gate[dacfrom[daccount][3]].dac>>3)];
  if (speedf__==2.0f) speedf__=LOWEST;
  CVOPENDAC;
  if(gate[w].last_time<gate[w].int_time)      {
    GSHIFT_;
    BINROUTE_;
    BITN_AND_OUTVN_;
    ENDER;
  }
}

void Rdacminus0(void){
  HEADR;
  uint8_t w=3;
  int32_t cv;
  float speedf__;
  cv=(gate[dacfrom[daccount][3]].dac>>2)-(1024-(CV[3]>>2));
  if (cv<0) cv=0;
  speedf__=logspeed[cv];
  if (speedf__==2.0f) speedf__=LOWEST;
  CVOPENDAC;
  if(gate[w].last_time<gate[w].int_time)      {
    GSHIFT_;
    BINROUTE_;
    BITN_AND_OUTVN_;
    ENDER;
  }
}

void Rdacspeedminus0(void){
  HEADR;
  uint8_t w=3;
  int32_t cv;
  float speedf__;
  cv=(CV[3]>>2)-(gate[dacfrom[daccount][3]].dac>>2); 
  if (cv<0) cv=0;
  speedf__=logspeed[cv];
  if (speedf__==2.0f) speedf__=LOWEST;
  CVOPENDAC;
  if(gate[w].last_time<gate[w].int_time)      {
    GSHIFT_;
    BINROUTE_;
    BITN_AND_OUTVN_;
    ENDER;
  }
}

void Rdacmod0(void){
  HEADR;
  uint8_t w=3;
  int32_t cv;
  float speedf__;
  cv=((CV[3]>>2)+1); // modulo code
  speedf__=logspeed[(gate[dacfrom[daccount][3]].dac>>2)%cv];
  if (speedf__==2.0f) speedf__=LOWEST;
  CVOPENDAC;
  if(gate[w].last_time<gate[w].int_time)      {
    GSHIFT_;
    BINROUTE_;
    BITN_AND_OUTVN_;
    ENDER;
  }
}

void RB0(void){// with oscillator
  HEADR;
  uint8_t w=3;
  int32_t cv;
  float speedf__;
  cv=(CV[3]>>2)-(gate[dacfrom[daccount][3]].dac>>2);
  if (cv<0) cv=0;
  speedf__=logspeed[cv];
  if (speedf__==2.0f) speedf__=LOWEST;  
  CVOPENDAC;
  if(gate[w].last_time<gate[w].int_time)      {
    GSHIFT_;
    bitn=ADC_(1,SRlength[w],30,gate[w].trigger,dacfrom[daccount][1],gate[w].adcpar, &gate[w].shift_); // oscillator
    BINROUTE_;
    PULSIN_XOR;
    BITN_AND_OUTV_;
    ENDER;
  }
}

// sources: adc, dac, oscillator, clock?-return last strobe, impulses(TODO) - // add in different DACs, SR bits output
// but some of these are single bits so doesn't make sense

uint32_t fadc(void){
  uint32_t k;
  ADC_RegularChannelConfig(ADC1, ADC_Channel_13, 1, ADC_SampleTime_3Cycles);
  ADC_SoftwareStartConv(ADC1);
  while(!ADC_GetFlagStatus(ADC1, ADC_FLAG_EOC));
  k=ADC_GetConversionValue(ADC1);
  return k;
}

uint32_t fdac(void){
  uint32_t k;
  k=gate[3].dac;
  return k;
}

uint32_t (*fff[8])(void)={fadc, fdac};

// how we can start to abstract source out - but few sources...
static inline uint32_t bits(uint32_t depth, uint8_t func){ // max 12 bits // func is index into function array
  uint32_t bt;
  static int32_t bc=31;
  static uint32_t k;
  if (depth>11) depth=11; // max depth
    if (bc<0) {
      k=(*fff[func])(); // new 12 bits but only in case of adc/dac
      k=k>>(11-depth);
	bc=depth; // was 11
  }
    bt = (k>>bc)&0x01; // this means that MSB comes out first
    bc--;
    return bt;
}


/* // why we lost this?
// Nint70 - if we can change type of gate[3].dac in dac mixes 66,67,68 or pure dac ins (?)
void Nint70(void){
  uint8_t w=0;				       
  HEADN;  
  if (gate[w].trigger)      {
    GSHIFT_;
    gate[3].dactype=15-(CV[0]>>8);     // 4 bits for type
    bitn=ADC_(0,SRlength[w],67,gate[w].trigger,3,gate[3].dac, &gate[w].shift_);  // 4 bits for type  66=modulo, 67=add, 68=and
    //BINROUTE_; // no route in in this case
    BITN_AND_OUTNINT_; // for no pulse out
  } 
}
*/

/*
void NLintprob084(void){ // own dac as comparator against DAC+CV 
  // can also detach length and have this as prob mode too - prob of cycle or ADC. prob of cycle or routein
  uint8_t w=0;				       
  HEADSINN;  
  if (gate[w].trigger)      {
    GSHIFT_;
    if (((LFSR_[0] & 4095 ) > CVL[0])){   // thsi way round
    bitn=ADC_(0,SRlength[w],84,gate[w].trigger,dacfrom[daccount][0],CV[0], &gate[w].shift_);
    }
    else JUSTCYCLE_;
    BITN_AND_OUTNINT_; // for no pulse out
  } 
}
*/


// try N0-N7 with ADCORIN() - these all fade out


  void Nor0(void){ 
  ADCORIN(0);
  }

  void Nor1(void){ 
  ADCORIN(1);
  }

  void Nor2(void){ 
  ADCORIN(2);
  }

  void Nor3(void){ 
  ADCORIN(3);
  }

  void Nor4(void){
  ADCORIN(4);
  }

  void Nor5(void){ 
  ADCORIN(5);
  }

  void Nor6(void){
  ADCORIN(6);
  }

  void Nor7(void){
  ADCORIN(7);
  }




void Ntestorxor1_0(void){ // lower bits of CVL select xor or or in  -- version 2 below makes more sense
  // speed is temp>>7 so 5 bits 0-31 so we want ((CVL[w]&64)>>6) 
  uint8_t w=0;
  HEADN;
  if (speedf_[w]!=2.0f){
  CVOPEN;
  if(gate[w].last_time<gate[w].int_time){
  GSHIFT_;
  bitn=ADC_(0,SRlength[0],0,gate[0].trigger,dacfrom[daccount][0],param[0], &gate[0].shift_);
  
  if ((CVL[w]&64)>>6) {
    BINROUTEOR_;
  }
  else {
    BINROUTE_;
    }
  BITN_AND_OUTVN_;
  ENDER;
  }
}
}

void Ntestorxor2_0(void){ // - or have 2 sets of 0-31 for length or/xor
  // detach length
  uint8_t w=0;
  HEADSINN; // detach
  SRlength[w]=31-((CVL[w]>>6)%32);
  if (speedf_[w]!=2.0f){
  CVOPEN;
  if(gate[w].last_time<gate[w].int_time){
  GSHIFT_;
  bitn=ADC_(0,SRlength[0],0,gate[0].trigger,dacfrom[daccount][0],param[0], &gate[0].shift_);
  if (((CVL[w]>>6)&32)==1) {
    BINROUTEOR_;
  }
  else {
    BINROUTE_;
    }
  BITN_AND_OUTVN_;
  ENDER;
  }
}
}


//  if (speedf_[0]==2.0f) speedf_[0]=LOWEST;
  //  speedf__= (speedf_[0]-logspeed[1023-(gate[which].dac>>2)]);

//  speedf__= logspeed[1023-(gate[speedfrom_[0]].dac>>2)];
//  speedf__=(speedf_[0] -((4095-gate[speedfrom_[0]].dac)/4095.0f));
//  speedf__=speedf_[0];
  //  if (speedf__>1.0f) speedf__=1.0f;
  // if (speedf__<LOWEST) speedf__=LOWEST;
  //  speedf__=1.0f;


// how we can OR in for route 0 - below but doesn't work so well
#define BINROUTE {				\
  tmp=binroute[count][w];				\
  for (x=0;x<4;x++){					\
  if (tmp&0x01){					\
  bitrr = (Gshift_[x][w]>>SRlength[x]) & 0x01;		\
  Gshift_[x][w]=(Gshift_[x][w]<<1)+bitrr;		\
  bitn^=bitrr;					\
  }							\
  tmp=tmp>>1;						\
  }							\
  }



// test logic for minor major modes
// say 4 major modes

// but how we can split modes?
major=mode[3]>>4; // from 64=6bits to 2 bits 

if (w!=3){
switch(major){
 case 0:
   // we do all modes for all except 3
   switch(mode[w]{ // or this would be a bit interpretation and we have no switch
       case 0:
	 break;
     }
   break;
     }
 }//major
 }//w!=3
 else {
   // w==3 modes
   switch(mode[3]){// here we have 16 (x4-64) minor modes for the right side...
   case 0: 
     break;
   }
 }//w==3




//unused
#define BINROUTEOR {				\
  tmp=binroute[count][w];				\
  for (x=0;x<4;x++){					\
  if (tmp&0x01){					\
  bitrr = (Gshift_[x][w]>>SRlength[x]) & 0x01;		\
  Gshift_[x][w]=(Gshift_[x][w]<<1)+bitrr;		\
  bitn|=bitrr;						\
  }							\
  tmp=tmp>>1;						\
  }							\
  }

#define BINROUTELOGOP {				\
  tmp=binroute[count][w];				\
  for (x=0;x<4;x++){					\
  if (tmp&0x01){					\
  bitrr = (Gshift_[x][w]>>SRlength[x]) & 0x01;		\
  Gshift_[x][w]=(Gshift_[x][w]<<1)+bitrr;		\
  bitn=logop(bitn,bitrr,logtable[w]);			\
  }							\
  tmp=tmp>>1;						\
  }							\
  }


#define BINROUTEANDCYCLE {				\
  tmp=binroute[count][w];				\
  for (x=0;x<4;x++){					\
    if ((tmp&0x01) || (x==w)){				\
  bitrr = (Gshift_[x][w]>>SRlength[x]) & 0x01;		\
  Gshift_[x][w]=(Gshift_[x][w]<<1)+bitrr;		\
  bitn^=bitrr;						\
  }							\
  tmp=tmp>>1;						\
  }							\
  }

#define JUSTCYCLE {				\
  bitrr = (shift_[w]>>SRlength[w]) & 0x01;		\
  bitn^=bitrr;						\
  }


// if we go with singular defroute
#define BITNNN {								\
  bitn = (Gshift_[defroute[w]][w]>>SRlength[defroute[w]]) & 0x01;	\
  Gshift_[defroute[w]][w]=(Gshift_[defroute[w]][w]<<1)+bitn;		\
  }

//if w==3 count=0 means just to reset binroute when we are out of modes which altered it
// macro for alt routes for ADC and DAC
// try with binrouteOR
#define ADCDACETC1(X, Y){			\
  bitn=0;					\
  GSHIFT;						\
  if (w==0)      {					\
  bitn=ADC_(0,SRlength[0],X,trigger[0],reggg,adcpar);	\
  BINROUTEOR;						\
  }							\
  if (w==2)      {					\
  dactype[2]=Y;					\
  BINROUTE;						\
  }							\
}

#define ADCDACNOGS(X, Y){			\
  bitn=0;					\
  if (w==0)      {					\
  bitn=ADC_(0,SRlength[0],X,trigger[0],reggg,adcpar);	\
  BINROUTE;						\
  }							\
  if (w==2)      {					\
    dactype[2]=Y;					\
    BINROUTE;						\
  }							\
}

// we still specify type of DAC here but we leave
//  if (w==2)      {
//  BINROUTE; // TODO: substitute alt routes here for DAC. eg cycle, probability etc. 4x4 for 16-31
//  }
//  else {

// still we have DACtype here
#define ADCONLY(X, Y){						\
    bitn=0;							\
    dactype[2]=Y;						\
    if (w==3) count=0;						\
    GSHIFT;							\
    if (w==0)							\
  {								\
      bitn=ADC_(0,SRlength[0],X,trigger[0],reggg,adcpar);	\
      BINROUTEOR;						\
  }								\
}

//// older

#define GSHIFT {				\
  counter[w]=0;					\
  Gshift_[w][0]=shift_[w];			\
  Gshift_[w][1]=shift_[w];			\
  Gshift_[w][2]=shift_[w];			\
  Gshift_[w][3]=shift_[w];			\
  shift_[w]=shift_[w]<<1;			\
}

#define GS(X) {					\
  Gshift_[X][0]=shift_[X];			\
  Gshift_[X][1]=shift_[X];			\
  Gshift_[X][2]=shift_[X];			\
  Gshift_[X][3]=shift_[X];			\
}


#define BITN_AND_OUT {						\
    shift_[w]+=bitn;						\
    dac[w]=DAC_(w, SRlength[w], dactype[w],dacpar,trigger[w]);	\
    tmp=(w<<1);							\
  if (bitn) *pulsoutLO[tmp]=pulsouts[tmp];	  \
  else *pulsoutHI[tmp]=pulsouts[tmp];		  \
  lengthbit=(SRlength[w]>>1);			      \
  new_stat=(shift_[w] & (1<<lengthbit))>>lengthbit;   \
  if (prev_stat[w]==0 && new_stat==1) flipd[w]^=1;    \
  prev_stat[w]=new_stat;			      \
  tmp++;					      \
  if (flipd[w]) *pulsoutLO[tmp]=pulsouts[tmp];	      \
  else *pulsoutHI[tmp]=pulsouts[tmp];		      \
}

// this one is for fractional speeds/interpol
#define BITN_AND_OUTV {				\
    shift_[w]+=bitn;						\
    val=DAC_(w, shift_[w], SRlength[w], dactype[w],dacpar,trigger[w]);	\
    tmp=(w<<1);							\
  if (bitn) *pulsoutLO[tmp]=pulsouts[tmp];	  \
  else *pulsoutHI[tmp]=pulsouts[tmp];		  \
  lengthbit=(SRlength[w]>>1);			      \
  new_stat=(shift_[w] & (1<<lengthbit))>>lengthbit;   \
  if (prev_stat[w]==0 && new_stat==1) flipd[w]^=1;    \
  prev_stat[w]=new_stat;			      \
  tmp++;					      \
  if (flipd[w]) *pulsoutLO[tmp]=pulsouts[tmp];	      \
  else *pulsoutHI[tmp]=pulsouts[tmp];		      \
}



    /*
  case 0: // ADc x bits out but only 12/8/4/2/1 bits
    if (length<8){ // 1 bit
      if ((shift_[reg]&(1<<length))==(1<<length)) x=4095;
      else x=0;
    }
    else x=(shift_[reg]&masky[length])>>newr[length])<<news[length];
    break;
    */
    /*
  case 0: // testing 12 bits out
    if (n[reg]>length) { // slow...
      n[reg]=0;
      //      nom[reg]=shift_[reg]&4095;
      nom[reg]=((shift_[reg]&masky[length])>>newr[length])<<news[length];
    }
    n[reg]++;
    x=nom[reg];
    break;
    */


    //    x=rand()%4095;
     /*
    if (length==3){
      if (shift_[reg]&4) x=4095;
      else x=0;
    }
    else     x=( (shift_[reg] & masky[length])>>(rightshift[length]))<<leftshift[length];
    */




void testNint(void){ // no interpolation
  uint8_t w=0;				       
  HEAD;  
  if (gate[w].trigger)      {
    GSHIFT_;
    bitn=ADC_(0,SRlength[w],gate[w].adctype,gate[w].trigger,3,gate[w].adcpar, &gate[w].shift_); 
    BINROUTE_;
    BITN_AND_OUTNINT_; // for no pulse out
  } 
}

void testN(void){ // speed template
  uint8_t w=0;
  HEAD;
  if (speedf_[w]!=2.0f){ 
  CVOPEN;
  if(gate[w].last_time<gate[w].int_time)      {
    GSHIFT_;
    bitn=ADC_(0,SRlength[w],gate[w].adctype,gate[w].trigger,3,gate[w].adcpar, &gate[w].shift_); 
    BINROUTE_;
    BITN_AND_OUTVN_; // for no pulse out
    ENDER;
  }
  }
}


case 80: // basic sequential length of upto 12 bits cycling in MSB first    
      if (length>11) length=11;
      if (n[reg]<0) {
	k=(adc_buffer[12])>>(11-length);
	n[reg]=length;
    }
      bt = ((k>>n[reg])&0x01) ^ strobe; // this means that MSB comes out first
    n[reg]--;    
    break;

  case 81: // equivalent bits: we don't need limit on number of bits
    if (n[reg]>length) {
      k=(adc_buffer[12]); //
      k=k/divy[length];
      n[reg]=0;
    }
    if (k!=0) {
      bt=1;
      k--;
    }
    else bt=0;
    bt ^= strobe;
    n[reg]++;    
    break;

  case 82: // variations on one bit audio - also phasey
    k=(adc_buffer[12]); // from 0 to 4095 but where is the middle? - also we do nothing here with length
    integrator+=(k-oldValue);
   if(integrator>2048)
  {
     oldValue=4095;
     bt=1;
  }
   else
   {
      oldValue=0;
      bt=0;
   }
   bt ^= strobe;
   break;    

  case 83: // basic sequential length as in 0 but with padding if >11 bits **
    if (n[reg]<0) { // 12 bits
      if (length<12) {
	k=(adc_buffer[12])>>(11-length);
	n[reg]=length;
      }
      else {
	k=(adc_buffer[12]);
	n[reg]=11;
      }
    }
    bt = ((k>>n[reg])&0x01) ^ strobe;;
    n[reg]--;    
    break;
    
  case 84: // basic sequential length of upto 12 bits cycling in - can also be xbits from param, max bits etc...
    if (n[reg]<0) { // 12 bits = can also be 8 bits or less
	k=(adc_buffer[12]);
	n[reg]=11;
    }
    bt = ((k>>n[reg])&0x01) ^ strobe; // top bit first
    n[reg]--;    
    break;

  case 85: // padded version of SR of bitsin
      if (n[reg]>length) {
	if (length<12) ADCshift_[reg]=(adc_buffer[12])>>(11-length); 
	else ADCshift_[reg]=(adc_buffer[12])<<(length-11);
	n[reg]=0;
    }
    n[reg]++;
    bt=((ADCshift_[reg]>>length)&0x01) ^ strobe;;
    ADCshift_[reg]=(ADCshift_[reg]<<1)+bt;
    break;
    
    


// from adcetc

// 0-31 (32)modes +1 INTmode
// arrange modes now as most important first...

   
   /*  case 63: // =- input regardless of length - this was same as 5 but MSB 
    // also try as MSB - now...
    if (n[reg]<0) { // 12 bits = can also be 8 bits or less
	k=(adc_buffer[12]);
	n[reg]=11;
    }
    bt = (k>>n[reg])&0x01; // top bit first
    n[reg]--;    
    break;
   */

   /*
  case 64: // was strobe mode for cycling bits a la TM - no input but now uses ADC input as probability! - cvmode
    bt=(*SR>>length)& 0x01; //cycling bit but what if we are already cycling then just inverts it
    if (((LFSR_[reg] & 4095 ) < adc_buffer[12])){
      bt=!bt;// invert cycling bit
    }
    break;
   */    


// 18/1/22 but we don't use this
// more generic ADC_ in = so income is passed in function and can be LFSR so we have different handlings
static inline int ADCg_(uint32_t reg, uint32_t length, uint32_t type, uint32_t strobe, uint32_t regg, uint32_t otherpar, uint32_t *SR, uint32_t *income){
  static int32_t n[4]={0,0,0,0}, nn[4]={0,0,0,0}, nnn[4]={0,0,0,0}; // counters
  static int32_t integrator=0.0f, oldValue=0.0f;
  static uint32_t k, lastbt=0; // 21/9 - we didn't have k for one bits as static - FIXED/TEST!
  static uint8_t toggle=0, lc=0;
  uint32_t bt=0, bit=0;
  float inb;

  switch(type){
    
  case 0: // basic sequential length of upto 12 bits cycling in MSB first    
      if (length>11) length=11;
      if (n[reg]<0) {
	k=(*income)>>(11-length);
	n[reg]=length;
    }
      bt = (k>>n[reg])&0x01; // this means that MSB comes out first
    n[reg]--;    
    break;
  }
}


    /* // LSB first
  case 0: // basic sequential length of upto 12 bits cycling in    
      if (length>11) length=11;
      if (n[reg]>length) {
	k=(adc_buffer[12])>>(11-length);
      n[reg]=0;
    }
      bt = (k>>n[reg])&0x01; // this means that LSB comes out first
    n[reg]++;    
    break;
    */


    /*
  case 2: // one bit audio input - can also change the 48??? - this one makes wierd phase effects
    n[reg]++;
  if (n[reg]>48) {
    k=(adc_buffer[12]); 
    n[reg]=0;
  }
  integrator+=k-oldValue;
   if(integrator>0)
  {
     oldValue=MAXVALUE;
     bt=1;
  }
   else
   {
      oldValue=0;
      bt=0;
   }   
   break;
    */
        


    /*
  case 2: // try with float but this is the same with phasings
    inb=(((float)adc_buffer[12])/2048.0f)-1.0f; // from 0 to 4095 but where is the middle?
    integrator+=(inb-oldValue);
   if(integrator>0.0f)
  {
     oldValue=1.0f;
     bt=1;
  }
   else
   {
      oldValue=-1.0f;
      bt=0;
   }   
   break;    
    */     

   /*      
  case 3: // basic sequential length as in 0 but with padding if >11 bits **
      if (n[reg]>length) {
	if (length<12) k=(adc_buffer[12])>>(11-length); //
	else {
	  k=(adc_buffer[12]);//<<(length-11); // should be -11 // pads with 0s at the bottom LSB first
	  //	  k+=((k>>length-11)&masky[length-11]); // pad with a repeat?
	  //	  k+=padding[length-11]; // TESTY! - padding with 1s
	}
	n[reg]=0;
    }
    bt = (k>>n[reg])&0x01;
    n[reg]++;    
    break;
   */

   /*
  case 3: // basic sequential length as in 0 but with padding if >11 bits **
    // REVERSAL again doesn't change much
      if (n[reg]<0) {
	if (length<12) k=(adc_buffer[12])>>(11-length); //
	else {
	  k=(adc_buffer[12])<<(length-11); // should be -11 // pads with 0s at the bottom LSB first
	  // double up
	  //  k+=((k>>length-11)&masky[length-11]); // pad with a repeat?
	  //	  k+=padding[length-11]; // TESTY! - padding with 1s - doesn't change much
	}
	n[reg]=length;
    }
    bt = (k>>n[reg])&0x01;
    n[reg]--;    
    break;
   */
   /*
  case 3: // basic sequential length of upto 12 bits cycling in MSB first    
        if (n[reg]<0) {
	  //	  k=pow(2,length)+1;
	  k++;
	  if (k>4095) k=0;
	n[reg]=length;
    }
      bt = (k>>n[reg])&0x01; // this means that MSB comes out first
    n[reg]--;    
    break;
   */
   /*  case 3: // basic sequential length of upto 12 bits cycling in MSB first    
        if (n[reg]<0) {
	  k=adc_buffer[12];
	  n[reg]=length;
    }
      bt = (k>>n[reg])&0x01; // this means that MSB comes out first
    n[reg]--;    
    break;
   */   



/* options here:
1. 9 bit speed +dac ->   speedf__=logspeed[(CV[0]&511)+(gate[whic].dac>>3)];

2. speed+dac with max:
cv=(CV[0]>>2)+(gate[3].dac>>2);
if (cv>1023) cv=1023;
speedf__=logspeed[cv];

3. DAC - (1024-speed) // so if speed is 0-fastest 
cv=(gate[3].dac>>2)-(1024-(CV[0]>>2));
if (cv<0) cv=0;
speedf__=logspeed[cv];

4. speed-dac
cv=(CV[0]>>2)-(gate[3].dac>>2)-
if (cv<0) cv=0;
speedf__=logspeed[cv];


5. DAC % speed we have below
 */

//  if (speedf_[0]==2.0f) speedf_[0]=0.000990f;
  //  speedf__= (speedf_[0]-logspeed[1023-(gate[speedfrom_[0]].dac>>2)]);
//  speedf__= logspeed[1023-(gate[speedfrom_[0]].dac>>2)];
//  speedf__=(speedf_[0] -((4095-gate[speedfrom_[0]].dac)/4095.0f));
//  speedf__=speedf_[0];
  //  if (speedf__>1.0f) speedf__=1.0f;
  //  if (speedf__<0.000990f) speedf__=0.000990f;
  //  speedf__=1.0f;
  //  speedf__=logspeed[(CV[0]>>3)+(gate[3].dac>>3)];


void trial(void){
  static uint32_t xxxx=0;
  xxxx^=1;
  if (xxxx) gate[2].dac = 4095;
  else gate[2].dac=0;
    //  gate[2].dac=100;
}

void trial2(void){
  gate[0].dac=0;
}





// from main


older: fast interrupt (TIM?) for all shift registers with counters,
interrupt for ADCs (TIM?), interrupt for pulsed SR, PWM for
default/normed clockings (set by speed pot)

or just one timer for all and run at max speed with counters

- ADC input schemes - number of bits, sigma/delta, bit equality (unary - no weighting) with x bits
- 4x pin interrupts, how many timers
- working with sigma delta ADC, DAC out, digital filter simulator and list first all possible modes and ways of operating
- clock from speed/cv, clock from external pulse, clock from other
  shift register // combos of thse so could be ext pulse AND/XOR/OR
  other shift reg or clocked speed pulse etc.
- bitdsp library borrowings?
- fakes, ghosts, SR_IN_SR, overlaps
- add artificial drift and dropped bits

Sigma/delta out as pulses and as DAC (low pass?)


/////

TODO: new notes, collect all notes, modes and speed/basic tests

Questions: how we use the 5 fake pulse outs normed to pulse ins: PB10-PB15 ! 

Newest PCB (14/5/2021) with new ADC(ADC12//on pin PC3) TESTED ALL FINE

9/7/2021: ADC in and DAC tested correctly with 11vPP for 0-4095

14/7/2021 - retested allFINE: 

all ADC ins: mode, spd and len x4

  // map ADCs: note all modes are inverted

  // 0: nspd, 1: nlen, 2: nmode
  // 3: lspd, 4: llen, 5: lmode
  // 6: rspd, 7: rlen, 8: rmode
  // 9: cspd, 10: , 11: cmode

/ pulse ins: PC7 is RSRIN, PC8 is LSRIN XDONE

/ interrupt ins: LSR, RSR, CSR, NSR -DONE / PWM outX, pulse outsXDONE

CSRCLKIN moved from PC3 to PB7

///

Newest PCB: all working 19/4 but we will need to re-work ADC entry -
test now with lower cap on say ADC0 - nspeedin c30->100pf//33k, removed cap (but leave on schematic)
and increased ADC speed, changed to continuous mode and we have a high
sample rate in 100kHZ
 
16/4/2021->19/4/2021:

- what needs testing? DAC outDONE, ADCs inDONE, 

- all pulses in //(and volts knob for ADC pulsed in: PC9->PC14-REDO)DONE

- pulses outDONE

TIM1-CH1 normings WORKING - so is TIM1 normed to top clock/NSR

----> could do with organizing all a bit better with arrays

///


TESTED/WORKING: ADC all tested, DAC out tested, pulses out all tested, TIM1-CH1 norming to top clock, volts knob/primitive ADC, pulse ins, interrupt pulse ins 

/////////

// copied over from TOUCH so we need to change ADCsDONE, DAC out is the same, add timers and change interrupt timing, add external interrupts, PWMS.

TODO: list our new I/O here, check interrupts and PWM

- general scheme of things

///// OLDER

Testing on STM32F446 NUCLEO. Prog header is same as TOUCH. STM is same as touch

This was copied from TOUCH so some things will need to change: 

But we can keep DAC on PA4


fast interrupt (TIM?) for all shift registers with counters, interrupt for ADCs (TIM?), interrupt for pulsed SR, PWM for default/normed clockings (set by speed pot)

I/O:

- pulse ins: PC3-5 + PB6 clkins(interrupts), PC7/8 pulsein, PC9-MSB, to PC14-LSB of 6 bits
- ADC 0-11 see adc.c
- DAC out PA4
- TIM1-CH1 drived normed top LFSR - and we need 2 extra internal timers! 
- 11 pulse outs: PB2,3,4,10,12,13,14 = 5 fakes and 6 real out + now we have changed for schematic: PA11=pulse6, PA12=pulse4, PC15=pulse5, PB15=pulse7

apparently there are 12x 16bit and 2x 32 bit timers (TIM2, TIM5) 

 */

/// Copied 23/2/2021 from TOUCH code...

/*
void TIM2_IRQHandler(void) {
  // flash on update event
  if (TIM2->SR & TIM_SR_UIF) GPIOA->ODR ^= (1 << 5);
   
  TIM2->SR = 0x0; // reset the status register
  }*/



// from draftspeed:



  // crash detect ++ 32/64 in main.c is 14KHz //and/or speed check...
  //    flipper^=1;
  //  if (param[0]>4090){
  //    if (flipper) GPIOB->BSRRH = (1)<<12;  // clear bits PB12 - left normed clock I think
  //    else   GPIOB->BSRRL=(1)<<12; //  write bits   
  //  }

    /* // we don't deal with CLKs now!  
    //TODO: ghostSRs for normed clks (with speed of these from what, from RDAC?)
  if (w==2 && counter[2]>speed[w] && speedfrom[2]==1){ // 2 is Cspeed - but we have a problem when Cspeed is from an interrupt as this is never generated...FIXED HERE
      counter[2]=0;
      flipper^=1;
      if (flipper) GPIOB->BSRRH = clk_route[clkr];  // clear bits of fake_one - clkr is 7 so all of them
      // or we can set L and R from an independent SR with only CSR as clocked from here
      else   GPIOB->BSRRL=clk_route[clkr]; //  write bits       
    }
  */


  /*
  if (time_now[w]>32768){
      int_time[w]=0; 
      time_now[w]-=32768.0f;
    }

  // fixed interpol
      alpha = time_now[w] - (float)int_time[w];
      dac[w] = ((float)delay_buffer[w][DELAY_SIZE-5] * alpha) + ((float)delay_buffer[w][DELAY_SIZE-6] * (1.0f - alpha)); // interpol but is just last and before last
      if (dac[w]>4095) dac[w]=4095;
      else if (dac[w]<0) dac[w]=0;
      //      dac[w]=lastdac[w];

  time_now[w] += speedf_[w];
  last_time[w] = int_time[w];
  int_time[w] = time_now[w];

  if(last_time[w]<int_time[w])      {
    // do all
    // test as a function pointer
    //    mode[w]=testmodes[w];
    //    val=(*dofunc[mode[w]])(w); // this seems to work
    //    val=(*gate[L].dofunc[0])(w);
    
    GSHIFT;


void Rnofrac0(void){
  uint8_t w=3;
  HEAD;
  if (counter[3]>speed[3] && speed[3]!=1024){
    counter[3]=0;			       
    GSHIFT_;
    BINROUTE_;
    PULSIN_XOR;
    BITN_AND_OUTVINT_; 
  }
}


void Cnofrac0(void){
  gate[2].dactype=0; gate[2].dacpar=param[2];
  uint8_t w=2;
  HEAD;
  if (counter[2]>speed[2] && speed[2]!=1024){
    counter[2]=0;				
    GSHIFT_;
    BINROUTE_;
    BITN_AND_OUTVINT_; 
  }
}

void Lnofrac0(void){
  uint8_t w=1;
  HEAD;
  if (counter[1]>speed[1] && speed[1]!=1024){
    counter[1]=0;				
    GSHIFT_;
    BINROUTE_;
    PULSIN_XOR;
    BITN_AND_OUTVINT_; 
    }
}

void Nnofrac0(void){
  uint8_t w=0;
  HEAD;
  if (counter[0]>speed[0] && speed[0]!=1024){
    counter[0]=0;			      
    GSHIFT_;
    bitn=ADC_(0,SRlength[0],0,gate[0].trigger,3,param[0], &gate[w].shift_);    
    BITN_AND_OUTVINT_; 
  }
}



    if (w==0){
      bitn=ADC_(0,SRlength[0],0,trigger[0],reggg,adcpar); 
    }
    BINROUTE;
    if (LR[w]){
      PULSIN_XOR;
    }
    BITN_AND_OUTV; // special version for this in macros.h  
    new_data(val,w);
    //    lastdac[w]=val;
    last_time[w] += 1;
    
  } // lasttime
  */


// worm speed

if (time_now>32768){
    int_time=0; 
    time_now-=32768.0f;
    }

alpha = time_now - (float)int_time;

outt = ((float)delay_buffer[DELAY_SIZE-5] * alpha) + ((float)delay_buffer[DELAY_SIZE-6] * (1.0f - alpha)); // interpol but is just last and before last
if (outt>LIMIN) outt=LIMIN;
 else if (outt<-LIMIN) outt=-LIMIN;
out[ii]=outt;

  time_now += factor;
  last_time = int_time;
  int_time = time_now;

while(last_time<int_time)      {
    doadc();
    int16_t val=getsample();
    new_data(val);
    last_time += 1;
  }
 }
}



//    dac[2]=(adc_buffer[12]);
    /*        k=(adc_buffer[12]); // from 0 to 4095 but where is the middle?
    integrator+=(k-oldValue);
   if(integrator>2048)
  {
     oldValue=4095;
     bt=4095;
  }
   else
   {
      oldValue=0;
      bt=0;
   }   
   dac[2]=bt;
    */

    //    bt = ((ADCshift_[0] >> (lfsr_taps[SRlength[0]][0])) ^ (ADCshift_[0] >> (lfsr_taps[SRlength[0]][1])) ^ (ADCshift_[0] >> (lfsr_taps[SRlength[0]][2])) ^ (ADCshift_[0] >> (lfsr_taps[SRlength[0]][3]))) & 1u;
      //            bt^=1;
      //          if (rand()%4) bt^=1;

      //      ADCshift_[0]=(ADCshift_[0]<<1)+(bt&1);
      //      x=(((ADCshift_[0] & masky[SRlength[2]])<<8));//<<leftshift[SRlength[2]])&4095);//>>(rightshift[length]))<<leftshift[length];
      //      dac[2]=x;//(bt*4095);




// draft for INTmodes - - TODO: probability of advance on trigger using CV as prob
case 50:
  param[w]=adc_buffer[lookupadc[w]];
  if (trigger[w] && (shift_[LFSR[w]] & 4095) > (param[w] & 4095) ){ // or this could be based on a real: shift_[3] which we try here for better effect
    dacpar=0; adcpar=param[0]; reggg=0; // params - reggg is for ADC // adcpar=adc_buffer[lookupadc[w]] - 12 bits
    ADCDACETC1(0, 0);
    if (LR[w]){
      //////////////////////////////////HERE!
      BINROUTE; // TODO: fill in L and R modes here - BINROUTE is standard routings
      /////////////////////////////////////...
      PULSIN_XOR;
    } 
    BITN_AND_OUT;
  }
  break;

// draft for CV with INT - where to place this? and we can't really use CV as param here!
case 49:
    if (counter[w]>speed[w] && speed[w]!=1024){
      if (trigger[w]){
	param[w]=adc_buffer[lookupadc[w]];// ??? use another param eg.
	dacpar=0; adcpar=param[0]; reggg=0; // params - reggg is for ADC // adcpar=adc_buffer[lookupadc[w]] - 12 bits
	ADCDACETC1(0, 0);
	if (LR[w]){
	//////////////////////////////////HERE!
	BINROUTE; // TODO: fill in L and R modes here - BINROUTE is standard routings
	/////////////////////////////////////...
	PULSIN_XOR;
      } 
      BITN_AND_OUT;
    }
}
break;



/// intmodes

  case 24: // len is otherpar but there is no shift - OTHERPAR! 12 bits
    //basic sequential length of upto 12 bits cycling in - can also be xbits from param, max bits etc...
    otherpar=otherpar&31; // 5 bits
      if (n[reg]>otherpar) {
	k=adc_buffer[12]; //
      n[reg]=0;
    }
    bt = (k>>n[reg])&0x01;
    n[reg]++;    
    break;
    
  case 25: // len is otherpar but there is shift from otherpar  - OTHERPAR! 12 bits
    //basic sequential length of upto 12 bits cycling in - can also be xbits from param, max bits etc...
        otherpar=otherpar&31; // 5 bits
      if (n[reg]>otherpar) {
	if (otherpar<12) k=(adc_buffer[12])>>(11-otherpar); 
	else k=(adc_buffer[12])<<(otherpar-11);
	n[reg]=0;
    }
    bt = (k>>n[reg])&0x01;
    n[reg]++;    
    break;

  case 28:// ADC prob mode using otherpar - 10 bits in this case  - OTHERPAR! 12 bits
      // basic sequential length of upto 12 bits cycling in - can also be xbits from param, max bits etc...
    if ((LFSR_[reg] & 4095 ) < (otherpar&4095)) { 
  if (length>11) length=11;
      if (n[reg]>length) {
	k=(adc_buffer[12])>>(11-length); //
      n[reg]=0;
    }
    bt = (k>>n[reg])&0x01;
    n[reg]++;
      }
    break;

    // we use otherpar to determine number of bits - equal or otherwise  - OTHERPAR! 12 bits
     // we can also use otherpar=CV or otherwise as padding, length of bits which is not LEN!
  case 29:   // as case 17: // basic sequential length as in 0 but with padding if >11 bist
    // maybe restrict otherpar
    otherpar=otherpar&31; // 5 bits
      if (n[reg]>length) {
	if (otherpar<12) {
	  k=(adc_buffer[12])>>(11-otherpar); //
	}
	else k=(adc_buffer[12])<<(otherpar-11);
	n[reg]=0;
    }
    bt = (k>>n[reg])&0x01;
    n[reg]++;    
    break;

  case 33: //  ADC prob mode using otherpar - 10 bits in this case  - OTHERPAR! 12 bits - else is returning bit
      // basic sequential length of upto 12 bits cycling in - can also be xbits from param, max bits etc...
    if ((LFSR_[reg] & 4095 ) < (otherpar&4095)) { 
  if (length>11) length=11;
      if (n[reg]>length) {
	k=(adc_buffer[12])>>(11-length); //
      n[reg]=0;
    }
    bt = (k>>n[reg])&0x01;
    n[reg]++;
      }
    else
      {
	bt=(shift_[reg]>>length)& 0x01; //cycling bit but what if we are already cycling then just inverts it
      }
    break;

  case 34: // prob mode for cycling bits a la TM
    bt=(shift_[reg]>>length)& 0x01; //cycling bit but what if we are already cycling then just inverts it
    if ((LFSR_[reg] & 4095 ) < (otherpar&4095)) {
      bt=!bt;// invert cycling bit
    }
    break;
    ////////    
    // INT MODES ONLY FROM HERE ON! but these are just copies of some modes above!
     /*
  case 60: // INT // CV as comparator - for INT modes ONLY which don't use CV! can also be CV+DAC
    // we can also compare to: DAC, CV+DAC, to clksr_, to param - feed these into otherpar or have as options
     bt=0;
         if (adc_buffer[12]>adc_buffer[lookupadc[reg]]) bt=1; // can also be otherpar to make cleaner = then is same as mode 26!
     break;

  case 61:  // was case 6 //param[reg] seq input - what is size of param? /or we can also just feed in otherpar = CV in
    otherpar=otherpar>>7; // 5 bits
      if (length>11) length=11; //XXX12 bits or 8 bits
      if (n[reg]>length) {
	k=(otherpar])>>(11-length); 
      n[reg]=0;
    }
    bt = (k>>n[reg])&0x01;
    n[reg]++;    
    break;

  case 63: // XOR or OR of case 4 - 1 bit oscillator and input bits  - OTHERPAR! 12 bits
  if (length>11) length=11;
      if (nnn[reg]>length) {
	k=(adc_buffer[12])>>(11-length); 
      nnn[reg]=0;
    }
    bt = (k>>nnn[reg])&0x01;
    nnn[reg]++;    

    otherpar=otherpar>>4; // how long? it should be?
     if (n[reg]>length) { // 0s
       bt|=0; // XOR TODO
       if (nn[reg]>otherpar) {
	 n[reg]=0;
       }
       nn[reg]++;
     }
     else {
       bt|=1; // XOR TODO
       n[reg]++;
       nn[reg]=0;
     }         
     break;    
     */


     // TODO: CV+ADC as input for some of the INT modes perhaps
     // CV can modulus ADC input




case 15: // basic sequential length of upto 12 bits cycling in - leave out of cvmodes!!
  if (length>11) length=11;
      if (n[reg]>length) {
	k=(otherpar)>>(11-length); //
      n[reg]=0;
    }
    bt = (k>>n[reg])&0x01;
    n[reg]++;    
    break;

// discard

  case 19: // sequential clksr in TESTED! - lose this one as we have 18 - clkbits in anyways
    if (n[reg]>length) {
      k=(clksr_[reg])>>(31-length); 
      n[reg]=0;
    }
    bt = (k>>n[reg])&0x01;
    n[reg]++;    
    break;


/// strobes

  case 17: // basic sequential length of bits cycling in but zeroed by strobe
  if (length>11) length=11; //XXXmax12bits
      if (n[reg]>length) {
	k=(adc_buffer[12])>>(11-length); //
      n[reg]=0;
    } 
     if (strobe) bt=0;
      else bt = (k>>n[reg])&0x01;
    n[reg]++;    
    break;
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
