microresearch/allcolours/SR_segments/software/geoCC.h

//////////////////////////////////////////////////////////////////////////////////////////////////////
/// INNER

void SR_geo_inner_globalC(uint32_t w){  // fixed route only - no probability, no adc - this can be generic
  HEADNADA;
  if (interpfromnostrobe[gate[w].matrix[0]>>7]){ 
    gate[w].alpha = gate[w].time_now - (float)gate[w].int_time;
    gate[w].dac = ((float)delay_buffer[w][DELAY_SIZE-5] * gate[w].alpha) + ((float)delay_buffer[w][DELAY_SIZE-6] * (1.0f - gate[w].alpha));
    if (gate[w].dac>4095) gate[w].dac=4095;
  }
  else gate[w].dac = delay_buffer[w][1];

    if ((*speedfromnostrobe[gate[w].matrix[0]>>7])(gate[w].matrix[1], gate[w].matrix[2], w)){ // speedfunc
    GSHIFT_;
    SRlength[w]=lookuplenall[gate[w].matrix[6]>>7];
    if (w==0) bitn=(*inall[gate[w].matrix[7]>>6])(gate[w].matrix[8], gate[w].matrix[21], w);
    else if (w==3) bitn=(*abstractbitsz[gate[w].matrix[20]>>7])(gate[w].matrix[5], gate[w].matrix[4], w); // problem is same CVs - or switch round//done
    bitn^=binroutesel0(0,0,w); // global route and uses routetype not depth
    BITN_AND_OUTV_; 
    new_data(val,w);
    }
}

void SR_geo_inner_function(uint32_t w){  
  HEADNADA;
  if (interpfromnostrobe[gate[w].matrix[0]>>7]){ 
    gate[w].alpha = gate[w].time_now - (float)gate[w].int_time;
    gate[w].dac = ((float)delay_buffer[w][DELAY_SIZE-5] * gate[w].alpha) + ((float)delay_buffer[w][DELAY_SIZE-6] * (1.0f - gate[w].alpha));
    if (gate[w].dac>4095) gate[w].dac=4095;
  }
  else gate[w].dac = delay_buffer[w][1];

    if ((*speedfromnostrobe[gate[w].matrix[0]>>7])(gate[w].matrix[1], gate[w].matrix[2], w)){ // speedfunc
    GSHIFT_;
    SRlength[w]=lookuplenall[gate[w].matrix[6]>>7];
    if (w==0) bitn=(*inall[gate[w].matrix[7]>>6])(gate[w].matrix[8], gate[w].matrix[21], w); 
    bitn^=(gate[w].funcbit[gate[w].matrix[3]>>gate[w].extent])(gate[w].matrix[4], gate[w].matrix[5], w); 
    BITN_AND_OUTV_; 
    new_data(val,w);
    }
}

void SR_geo_inner_testdacasdepth(uint32_t w){  //
  HEADNADA;
  if (interpfromnostrobe[gate[w].matrix[0]>>7]){ 
    gate[w].alpha = gate[w].time_now - (float)gate[w].int_time;
    gate[w].dac = ((float)delay_buffer[w][DELAY_SIZE-5] * gate[w].alpha) + ((float)delay_buffer[w][DELAY_SIZE-6] * (1.0f - gate[w].alpha));
    if (gate[w].dac>4095) gate[w].dac=4095;
  }
  else gate[w].dac = delay_buffer[w][1];

    if ((*speedfromnostrobe_noIN[gate[w].matrix[0]>>7])(gate[w].matrix[1], gate[w].matrix[2], w)){ // speedfunc
    GSHIFT_;
    SRlength[w]=lookuplenall[gate[w].matrix[6]>>7]; 
    bitn=(gate[w].funcbit[gate[w].matrix[3]>>gate[w].extent])(gate[w].matrix[4], gate[w].matrix[5], w); 
    BITN_AND_OUTV_; 
    new_data(val,w);
    }
}

void SR_geo_inner_function_strobexor(uint32_t w){ 
  HEADNADA;
  gate[w].dac = delay_buffer[w][1];

  if ((*speedfromnostrobe[gate[w].matrix[0]>>7])(gate[w].matrix[1], gate[w].matrix[2], w) ^ (*speedfromstrobe_nodepth[gate[w].matrix[15]>>8])(0,0,w))    { // speedfunc
    GSHIFT_;
    SRlength[w]=lookuplenall[gate[w].matrix[6]>>7];
    if (w==0) bitn=(*inall[gate[w].matrix[7]>>6])(gate[w].matrix[8], gate[w].matrix[21], w);
    else if (w==3) bitn=(*abstractbitsz[gate[w].matrix[20]>>extent_abstractbits])(gate[w].matrix[5], gate[w].matrix[4], w); 
    else bitn=(gate[w].funcbit[gate[w].matrix[3]>>gate[w].extent])(gate[w].matrix[4], gate[w].matrix[5], w); 
    BITN_AND_OUTV_; 
    new_data(val,w);
    }
}

void SR_geo_inner_dacspeed4(uint32_t w){  
  HEADNADA;
  gate[w].dac = delay_buffer[w][1];

  if (spdfracdac4x(gate[w].matrix[1], gate[w].matrix[2], w)){ // speedfunc/
    GSHIFT_;
    SRlength[w]=lookuplenall[gate[w].matrix[6]>>7]; 
    if (w==0) bitn=(*inall[gate[w].matrix[7]>>6])(gate[w].matrix[8], gate[w].matrix[21], w);
    else bitn=(gate[w].funcbit[gate[w].matrix[3]>>gate[w].extent])(gate[w].matrix[4], gate[w].matrix[5], w); 
    BITN_AND_OUTV_; 
    new_data(val,w);
    }
}

void SR_geo_inner_dacspeed3(uint32_t w){  
  HEADNADA;
  gate[w].dac = delay_buffer[w][1];

  if (spdfracdac3x(gate[w].matrix[1], gate[w].matrix[2], w)){ // speedfunc
    GSHIFT_;
    SRlength[w]=lookuplenall[gate[w].matrix[6]>>7]; 
    if (w==0) bitn=(*inall[gate[w].matrix[7]>>6])(gate[w].matrix[8], gate[w].matrix[21], w);
    else bitn=(gate[w].funcbit[gate[w].matrix[3]>>gate[w].extent])(gate[w].matrix[4], gate[w].matrix[5], w); 
    BITN_AND_OUTV_; 
    new_data(val,w);
    }
}

void SR_geo_inner_str_function(uint32_t w){  // for strobe functions  - but here we do just in nor in^bit
  HEADNADA;
  gate[w].dac = delay_buffer[w][1];

  if ((*speedfromstrobe_nodepth[gate[w].matrix[15]>>8])(0, 0, w)){ // speedfunc
    GSHIFT_;
    SRlength[w]=lookuplenall[gate[w].matrix[6]>>7];
    if (w==0) bitn=(*inall[gate[w].matrix[7]>>6])(gate[w].matrix[8], gate[w].matrix[21], w); 
    bitn^=(gate[w].str_funcbit[gate[w].matrix[17]>>gate[w].str_extent])(gate[w].matrix[4], gate[w].matrix[5], w); 
    BITN_AND_OUTVS_; 
    new_data(val,w);
    }
}

// just changes for NN/RR
void SR_geo_inner_str_functionN(uint32_t w){  // for strobe functions  - but here we do just in or in^bit
  HEADNADA;
  gate[w].dac = delay_buffer[w][1];

  if ((*speedfromstrobe_nodepth[gate[w].matrix[15]>>8])(0, 0, w)){ // speedfunc
    GSHIFT_;
    SRlength[w]=lookuplenall[gate[w].matrix[6]>>7];
    if (w==0) bitn=(*inall[gate[w].matrix[7]>>6])(gate[w].matrix[8], gate[w].matrix[21], w);
    else if (w==3) bitn=(*abstractbitsz[gate[w].matrix[20]>>extent_abstractbits])(gate[w].matrix[5], gate[w].matrix[4], w); 
    else bitn=(gate[w].str_funcbit[gate[w].matrix[17]>>gate[w].str_extent])(gate[w].matrix[4], gate[w].matrix[5], w); 
    BITN_AND_OUTVS_; 
    new_data(val,w);
    }
}

void SR_geo_inner_str_function2(uint32_t w){  // for strobe functions  speedfromstrobe_depth >>8
  HEADNADA;
  gate[w].dac = delay_buffer[w][1];

  if ((*speedfromstrobe_depth[gate[w].matrix[15]>>8])(gate[w].matrix[1], gate[w].matrix[2], w)){ // speedfunc
    GSHIFT_;
    SRlength[w]=lookuplenall[gate[w].matrix[6]>>7]; 
    if (w==0) bitn=(*inall[gate[w].matrix[7]>>6])(gate[w].matrix[8], gate[w].matrix[21], w); 
    else if (w==3) bitn=(*abstractbitsz[gate[w].matrix[20]>>extent_abstractbits])(gate[w].matrix[5], gate[w].matrix[4], w); 
    else bitn=(gate[w].str_funcbit[gate[w].matrix[17]>>gate[w].str_extent])(gate[w].matrix[4], gate[w].matrix[5], w); 
    BITN_AND_OUTVS_; 
    new_data(val,w);
    }
}

void SR_geo_inner_functionprobzero(uint32_t w){  
  HEADNADA;
  if (interpfromnostrobe[gate[w].matrix[0]>>7]){ 
    gate[w].alpha = gate[w].time_now - (float)gate[w].int_time;
    gate[w].dac = ((float)delay_buffer[w][DELAY_SIZE-5] * gate[w].alpha) + ((float)delay_buffer[w][DELAY_SIZE-6] * (1.0f - gate[w].alpha));
    if (gate[w].dac>4095) gate[w].dac=4095;
  }
  else gate[w].dac = delay_buffer[w][1];

    if ((*speedfromnostrobe[gate[w].matrix[0]>>7])(gate[w].matrix[1], gate[w].matrix[2], w)){ // speedfunc
    GSHIFT_;
    SRlength[w]=lookuplenall[gate[w].matrix[6]>>7]; 

    if (!(*probf_anystrobe_depth[gate[w].matrix[9]>>6])(gate[w].matrix[10], gate[w].matrix[11], w)){
      if (w==0) bitn=(*inall[gate[w].matrix[7]>>6])(gate[w].matrix[8], gate[w].matrix[21], w);
      else bitn=(gate[w].funcbit[gate[w].matrix[3]>>gate[w].extent])(gate[w].matrix[4], gate[w].matrix[5], w); 
      }
      else {
	bitn = 0;
      }
    BITN_AND_OUTV_; 
    new_data(val,w);
    }
}

void SR_geo_inner_probcycleC(uint32_t w){ 
  // what cv we need: probfs: 9type,10comp... 11IN 3,4,5 is gapped...
  HEADNADA;

  if (interpfromnostrobe[gate[w].matrix[0]>>7]){ 
    gate[w].alpha = gate[w].time_now - (float)gate[w].int_time;
    gate[w].dac = ((float)delay_buffer[w][DELAY_SIZE-5] * gate[w].alpha) + ((float)delay_buffer[w][DELAY_SIZE-6] * (1.0f - gate[w].alpha));
    if (gate[w].dac>4095) gate[w].dac=4095;
  }
  else gate[w].dac = delay_buffer[w][1];

  if ((*speedfromnostrobe[gate[w].matrix[0]>>7])(gate[w].matrix[1], gate[w].matrix[2], w)){ // speedfunc
    GSHIFT_;
    SRlength[w]=lookuplenall[gate[w].matrix[6]>>7]; 

    if ((*probf_anystrobe_depth[gate[w].matrix[9]>>6])(gate[w].matrix[10], gate[w].matrix[11], w)){
      if (w==0) bitn=(*inall[gate[w].matrix[7]>>6])(gate[w].matrix[8], gate[w].matrix[21], w);
      else bitn=(gate[w].funcbit[gate[w].matrix[3]>>gate[w].extent])(gate[w].matrix[4], gate[w].matrix[5], w); 
  }
  else {
    bitn = (gate[w].Gshift_[w]>>SRlength[w]) & 0x01;	   // cycle bit
  }    
    BITN_AND_OUTV_; 
    new_data(val,w);
    }
}


void SR_geo_inner_probcycleCnodepth(uint32_t w){  
  // what cv we need: probfs: 9type,10comp... 11IN 3,4,5 is gapped...
  HEADNADA;

  if (interpfromnostrobe[gate[w].matrix[0]>>7]){ 
    gate[w].alpha = gate[w].time_now - (float)gate[w].int_time;
    gate[w].dac = ((float)delay_buffer[w][DELAY_SIZE-5] * gate[w].alpha) + ((float)delay_buffer[w][DELAY_SIZE-6] * (1.0f - gate[w].alpha));
    if (gate[w].dac>4095) gate[w].dac=4095;
  }
  else gate[w].dac = delay_buffer[w][1];

  if ((*speedfromnostrobe[gate[w].matrix[0]>>7])(gate[w].matrix[1], gate[w].matrix[2], w)){ // speedfunc
    GSHIFT_;
    SRlength[w]=lookuplenall[gate[w].matrix[6]>>7]; 

    if ((*probf_anystrobe_nodepth[gate[w].matrix[9]>>8])(0,0, w)){
      bitn=(gate[w].funcbit[gate[w].matrix[3]>>gate[w].extent])(gate[w].matrix[4], gate[w].matrix[5], w); 
  }
  else {
    if (w==0) bitn=(*inall[gate[w].matrix[7]>>6])(gate[w].matrix[8], gate[w].matrix[21], w);
    else if (w==3) bitn=(*abstractbitsz[gate[w].matrix[20]>>extent_abstractbits])(gate[w].matrix[5], gate[w].matrix[4], w); 
    else bitn = (gate[w].Gshift_[w]>>SRlength[w]) & 0x01;	   // cycle bit    
  }    
    BITN_AND_OUTV_; 
    new_data(val,w);
    }
}

void SR_geo_inner_probcyclexorC(uint32_t w){  
  // what cv we need: probfs: 9type,10comp... 11IN 3,4,5 is gapped...
  HEADNADA;

  if (interpfromnostrobe[gate[w].matrix[0]>>7]){ 
    gate[w].alpha = gate[w].time_now - (float)gate[w].int_time;
    gate[w].dac = ((float)delay_buffer[w][DELAY_SIZE-5] * gate[w].alpha) + ((float)delay_buffer[w][DELAY_SIZE-6] * (1.0f - gate[w].alpha));
    if (gate[w].dac>4095) gate[w].dac=4095;
  }
  else gate[w].dac = delay_buffer[w][1];

  if ((*speedfromnostrobe[gate[w].matrix[0]>>7])(gate[w].matrix[1], gate[w].matrix[2], w)){ // speedfunc
    GSHIFT_;
    SRlength[w]=lookuplenall[gate[w].matrix[6]>>7]; 

    bitn=(gate[w].funcbit[gate[w].matrix[3]>>gate[w].extent])(gate[w].matrix[4], gate[w].matrix[5], w); 

    if (!(*probf_anystrobe_depth[gate[w].matrix[9]>>6])(gate[w].matrix[10], gate[w].matrix[11], w)){
      if (w==0)     bitn^=(*inall[gate[w].matrix[7]>>6])(gate[w].matrix[8], gate[w].matrix[21], w);  
      else bitn^=((gate[w].Gshift_[w]>>SRlength[w]) & 0x01);	   // cycle bit
    }
    BITN_AND_OUTV_; 
    new_data(val,w);
    }
}

void SR_geo_inner_probcyclexorCnodepth(uint32_t w){  
  // what cv we need: probfs: 9type,10comp... 11IN 3,4,5 is gapped...
  HEADNADA;

  if (interpfromnostrobe[gate[w].matrix[0]>>7]){ 
    gate[w].alpha = gate[w].time_now - (float)gate[w].int_time;
    gate[w].dac = ((float)delay_buffer[w][DELAY_SIZE-5] * gate[w].alpha) + ((float)delay_buffer[w][DELAY_SIZE-6] * (1.0f - gate[w].alpha));
    if (gate[w].dac>4095) gate[w].dac=4095;
  }
  else gate[w].dac = delay_buffer[w][1];

  if ((*speedfromnostrobe[gate[w].matrix[0]>>7])(gate[w].matrix[1], gate[w].matrix[2], w)){ // speedfunc
    GSHIFT_;
    SRlength[w]=lookuplenall[gate[w].matrix[6]>>7]; 

    bitn=(gate[w].funcbit[gate[w].matrix[3]>>gate[w].extent])(gate[w].matrix[4], gate[w].matrix[5], w); 

    if (!(*probf_anystrobe_nodepth[gate[w].matrix[9]>>8])(gate[w].matrix[10], gate[w].matrix[11], w)){
      if (w==0) bitn^=(*inall[gate[w].matrix[7]>>6])(gate[w].matrix[8], gate[w].matrix[21], w);
      else if (w==3) bitn^=(*abstractbitsz[gate[w].matrix[20]>>extent_abstractbits])(gate[w].matrix[5], gate[w].matrix[4], w); 
      else bitn^=((gate[w].Gshift_[w]>>SRlength[w]) & 0x01);	   // cycle bit
    }
    BITN_AND_OUTV_; 
    new_data(val,w);
    }
}

void SR_geo_inner_rungC(uint32_t w){ 
  HEADNADA;
  if ((*speedfromnostrobe[gate[w].matrix[0]>>7])(gate[w].matrix[1], gate[w].matrix[2], w)){ // speedfunc
    gate[w].dac = delay_buffer[w][1];
    GSHIFT_;
    SRlength[w]=lookuplenall[gate[w].matrix[6]>>7]; 

    if (w==0) bitn=(*inall[gate[w].matrix[7]>>6])(gate[w].matrix[8], gate[w].matrix[21], w);  /// new one with mix
    else  bitn=(*abstractbits_forrung[gate[w].matrix[20]>>extent_abstractbits])(gate[w].matrix[5], gate[w].matrix[4], w); // problem is same CVs - or switch round//done
    bitn^=(gate[w].funcbit[gate[w].matrix[3]>>gate[w].extent])(gate[w].matrix[4], gate[w].matrix[5], w); 
    BITN_AND_OUTV_; 
    new_data(val,w);
    }
}

void SR_geo_inner_probnodepth(uint32_t w){  // draft for probs with no depth
  HEADNADA;
  if (interpfromnostrobe[gate[w].matrix[0]>>7]){ 
    gate[w].alpha = gate[w].time_now - (float)gate[w].int_time;
    gate[w].dac = ((float)delay_buffer[w][DELAY_SIZE-5] * gate[w].alpha) + ((float)delay_buffer[w][DELAY_SIZE-6] * (1.0f - gate[w].alpha));
    if (gate[w].dac>4095) gate[w].dac=4095;
  }
  else gate[w].dac = delay_buffer[w][1];

  if ((*speedfromnostrobe[gate[w].matrix[0]>>7])(gate[w].matrix[1], gate[w].matrix[2], w)){ // speedfunc
    GSHIFT_;
    SRlength[w]=lookuplenall[gate[w].matrix[6]>>7]; 

    if ((*probf_anystrobe_nodepth[gate[w].matrix[9]>>8])(gate[w].matrix[10], gate[w].matrix[11], w)){
        bitn=(gate[w].funcbit[gate[w].matrix[3]>>gate[w].extent])(gate[w].matrix[4], gate[w].matrix[5], w);
    }
  else {
    if (w==0) bitn=(*inall[gate[w].matrix[7]>>6])(gate[w].matrix[8], gate[w].matrix[21], w);
    else if (w==3) bitn=(*abstractbitsz[gate[w].matrix[20]>>extent_abstractbits])(gate[w].matrix[5], gate[w].matrix[4], w); 
    else bitn=(routebits_nodepth_typesz[gate[w].matrix[12]>>extent_routebits_nodepth_typesz])(gate[w].matrix[5], gate[w].matrix[4], w); // swopped - fix now so is different
  }
    BITN_AND_OUTV_; 
    new_data(val,w);
    }
}

void SR_geo_inner_probdepthnodepth(uint32_t w){  // draft for probs with no depth alt
  HEADNADA;
  if (interpfromnostrobe[gate[w].matrix[0]>>7]){ 
    gate[w].alpha = gate[w].time_now - (float)gate[w].int_time;
    gate[w].dac = ((float)delay_buffer[w][DELAY_SIZE-5] * gate[w].alpha) + ((float)delay_buffer[w][DELAY_SIZE-6] * (1.0f - gate[w].alpha));
    if (gate[w].dac>4095) gate[w].dac=4095;
  }
  else gate[w].dac = delay_buffer[w][1];

  if ((*speedfromnostrobe[gate[w].matrix[0]>>7])(gate[w].matrix[1], gate[w].matrix[2], w)){ // speedfunc
    GSHIFT_;
    SRlength[w]=lookuplenall[gate[w].matrix[6]>>7]; 

    if ((*probf_anystrobe_depth[gate[w].matrix[9]>>6])(gate[w].matrix[10], gate[w].matrix[11], w)){
        bitn=(gate[w].funcbit[gate[w].matrix[3]>>gate[w].extent])(gate[w].matrix[4], gate[w].matrix[5], w);
    }
  else {
    if (w==0) bitn=(*inall[gate[w].matrix[7]>>6])(gate[w].matrix[8], gate[w].matrix[21], w); 
    else bitn=(routebits_nodepth_typesz[gate[w].matrix[12]>>extent_routebits_nodepth_typesz])(gate[w].matrix[5], gate[w].matrix[4], w); // swopped - fix now so is different
  }
    BITN_AND_OUTV_; 
    new_data(val,w);
    }
}

void SR_geo_inner_probdepth(uint32_t w){  // draft for probs with depth
  HEADNADA;
  if (interpfromnostrobe[gate[w].matrix[0]>>7]){ 
    gate[w].alpha = gate[w].time_now - (float)gate[w].int_time;
    gate[w].dac = ((float)delay_buffer[w][DELAY_SIZE-5] * gate[w].alpha) + ((float)delay_buffer[w][DELAY_SIZE-6] * (1.0f - gate[w].alpha));
    if (gate[w].dac>4095) gate[w].dac=4095;
  }
  else gate[w].dac = delay_buffer[w][1];

  if ((*speedfromnostrobe[gate[w].matrix[0]>>7])(gate[w].matrix[1], gate[w].matrix[2], w)){ // speedfunc
    GSHIFT_;
    SRlength[w]=lookuplenall[gate[w].matrix[6]>>7]; 

    if ((*probf_anystrobe_depth[gate[w].matrix[9]>>6])(gate[w].matrix[10], gate[w].matrix[11], w)) {
      bitn=(gate[w].funcbit[gate[w].matrix[3]>>gate[w].extent])(gate[w].matrix[4], gate[w].matrix[5], w);
    }
  else {
    if (w==0) bitn=(*inall[gate[w].matrix[7]>>6])(gate[w].matrix[8], gate[w].matrix[21], w);
    else if (w==3) bitn=(*abstractbitsz[gate[w].matrix[20]>>extent_abstractbits])(gate[w].matrix[5], gate[w].matrix[4], w); 
    else bitn=(routebits_depth_typesz[gate[w].matrix[12]>>extent_routebits_depth_typesz])(gate[w].matrix[5], gate[w].matrix[4], w); // swopped - fix now so is different
    // what alts there could be - but this is good as default
  }
    BITN_AND_OUTV_; 
    new_data(val,w);
    }
}

///////// for matrixP ops!
void SR_geo_inner_probdepthdepthS(uint32_t w){  // draft for probs with depth uses matrixX! 
  HEADNADA;
  if (interpfromnostrobe[gate[w].matrixX[0]>>7]){ 
    gate[w].alpha = gate[w].time_now - (float)gate[w].int_time;
    gate[w].dac = ((float)delay_buffer[w][DELAY_SIZE-5] * gate[w].alpha) + ((float)delay_buffer[w][DELAY_SIZE-6] * (1.0f - gate[w].alpha));
    if (gate[w].dac>4095) gate[w].dac=4095;
  }
  else gate[w].dac = delay_buffer[w][1];

  if ((*speedfromnostrobe[gate[w].matrixX[0]>>7])(gate[w].matrixX[1], gate[w].matrixX[2], w)){ // speedfunc
    GSHIFT_;
    SRlength[w]=lookuplenall[gate[w].matrixX[6]>>7]; 

    if (!(*probf_anystrobe_depth[gate[w].matrixX[9]>>6])(gate[w].matrixX[10], gate[w].matrixX[11], w)) {
      bitn=(gate[w].funcbit[gate[w].matrixX[3]>>gate[w].extent])(gate[w].matrixX[4], gate[w].matrixX[5], w);
    }
  else {
    if (w==0) bitn=(*inall[gate[w].matrixX[7]>>6])(gate[w].matrixX[8], gate[w].matrixX[21], w);  // fixed
    else bitn=(routebits_depth_typesz[gate[w].matrixX[12]>>extent_routebits_depth_typesz])(gate[w].matrixX[5], gate[w].matrixX[4], w);
  }
    BITN_AND_OUTVXS_; 
    new_data(val,w);
    }
}

// changes for w==0 and for alt
void SR_geo_inner_probdepthdepthSS(uint32_t w){  // draft for probs with depth uses matrixX! 
  HEADNADA;
  if (interpfromnostrobe[gate[w].matrixX[0]>>7]){ 
    gate[w].alpha = gate[w].time_now - (float)gate[w].int_time;
    gate[w].dac = ((float)delay_buffer[w][DELAY_SIZE-5] * gate[w].alpha) + ((float)delay_buffer[w][DELAY_SIZE-6] * (1.0f - gate[w].alpha));
    if (gate[w].dac>4095) gate[w].dac=4095;
  }
  else gate[w].dac = delay_buffer[w][1];

  if ((*speedfromnostrobe[gate[w].matrixX[0]>>7])(gate[w].matrixX[1], gate[w].matrixX[2], w)){ // speedfunc
    GSHIFT_;
    SRlength[w]=lookuplenall[gate[w].matrixX[6]>>7]; 

    if (!(*probf_anystrobe_depth[gate[w].matrixX[9]>>6])(gate[w].matrixX[10], gate[w].matrixX[11], w)) {
      bitn=(gate[w].funcbit[gate[w].matrixX[3]>>gate[w].extent])(gate[w].matrixX[4], gate[w].matrixX[5], w);
    }
  else {
    if (w==0) {
      bitn=(gate[w].str_funcbit[gate[w].matrixX[17]>>gate[w].str_extent])(gate[w].matrixX[4], gate[w].matrixX[5], w); 
      bitn^=(*inall[gate[w].matrixX[7]>>6])(gate[w].matrixX[8], gate[w].matrixX[21], w);  // fixed
    }
    else bitn=(routebits_nodepth_typesz[gate[w].matrixX[12]>>extent_routebits_nodepth_typesz])(gate[w].matrixX[5], gate[w].matrixX[4], w);
  }
    BITN_AND_OUTVXS_; 
    new_data(val,w);
    }
}

void SR_geo_inner_matrixreduceX(uint32_t w){  // reduced
  HEADNADA;
  if (interpfromnostrobe[gate[w].matrixX[0]>>7]){ 
    gate[w].alpha = gate[w].time_now - (float)gate[w].int_time;
    gate[w].dac = ((float)delay_buffer[w][DELAY_SIZE-5] * gate[w].alpha) + ((float)delay_buffer[w][DELAY_SIZE-6] * (1.0f - gate[w].alpha));
    if (gate[w].dac>4095) gate[w].dac=4095;
  }
  else gate[w].dac = delay_buffer[w][1];

  if ((*speedfromnostrobe[gate[w].matrixX[0]>>7])(gate[w].matrixX[1], gate[w].matrixX[2], w)){ // speedfunc
    GSHIFT_;
    SRlength[w]=lookuplenall[gate[w].matrixX[6]>>7]; 
    if (w==0) bitn=(*inall[gate[w].matrixX[7]>>6])(gate[w].matrixX[8], gate[w].matrixX[21], w);  // fixed
    else bitn=(gate[w].funcbit[gate[w].matrixX[3]>>gate[w].extent])(gate[w].matrixX[4], gate[w].matrixX[5], w);
    BITN_AND_OUTVXS_; 
    new_data(val,w);
  }
}

// for matrixP
void SR_geo_inner_str_probfunctionX(uint32_t w){  // generic prob 	// routebits_nostrobe_depth_notypesz >>8
  HEADNADA;
  gate[w].dac = delay_buffer[w][1];

  if ((*speedfromstrobe_all[gate[w].matrixX[15]>>7])(gate[w].matrixX[1], gate[w].matrixX[2], w)){ // speedfunc
    GSHIFT_;
    SRlength[w]=lookuplenall[gate[w].matrixX[6]>>7]; 
          if ((*probf_nostrobe_depth[gate[w].matrixX[9]>>7])(gate[w].matrixX[10], gate[w].matrixX[11], w)){
	    bitn=(gate[w].str_funcbit[gate[w].matrixX[17]>>gate[w].str_extent])(gate[w].matrixX[4], gate[w].matrixX[5], w); 
          }
          else {
	    if (w==0)     bitn=(*inall[gate[w].matrixX[7]>>6])(gate[w].matrixX[8], gate[w].matrixX[21], w);  /// WHICH WAY round?
	    else bitn=(routebits_nostrobe_depth[gate[w].matrixX[12]>>extent_routebits_nostrobe_depth])(gate[w].matrixX[5], gate[w].matrixX[4], w); // swopped
	  }	  
    BITN_AND_OUTVXS_; 
    new_data(val,w);
    }
}

// just differs for w==0 and now nostrobe_nodepth!
void SR_geo_inner_str_probfunctionXX(uint32_t w){  // generic prob 	// routebits_nostrobe_depth_notypesz >>8
  HEADNADA;
  gate[w].dac = delay_buffer[w][1];

  if ((*speedfromstrobe_all[gate[w].matrixX[15]>>7])(gate[w].matrixX[1], gate[w].matrixX[2], w)){ // speedfunc
    GSHIFT_;
    SRlength[w]=lookuplenall[gate[w].matrixX[6]>>7]; 
          if ((*probf_nostrobe_depth[gate[w].matrixX[9]>>7])(gate[w].matrixX[10], gate[w].matrixX[11], w)){
	    bitn=(gate[w].str_funcbit[gate[w].matrixX[17]>>gate[w].str_extent])(gate[w].matrixX[4], gate[w].matrixX[5], w); 
          }
          else {
	    if (w==0) {
	      bitn=(gate[w].str_funcbit[gate[w].matrixX[17]>>gate[w].str_extent])(gate[w].matrixX[4], gate[w].matrixX[5], w); 
	      bitn^=(*inall[gate[w].matrixX[7]>>6])(gate[w].matrixX[8], gate[w].matrixX[21], w);  /// WHICH WAY round?
	    }
	    else bitn=(routebits_nostrobe_nodepth[gate[w].matrixX[12]>>extent_routebits_nostrobe_nodepth])(gate[w].matrixX[5], gate[w].matrixX[4], w); // swopped
	  }	  
    BITN_AND_OUTVXS_; 
    new_data(val,w);
    }
}

void SR_geo_inner_probdepthx(uint32_t w){  // draft for probs with depth NOIN
  HEADNADA;
  if (interpfromnostrobe[gate[w].matrix[0]>>7]){ 
    gate[w].alpha = gate[w].time_now - (float)gate[w].int_time;
    gate[w].dac = ((float)delay_buffer[w][DELAY_SIZE-5] * gate[w].alpha) + ((float)delay_buffer[w][DELAY_SIZE-6] * (1.0f - gate[w].alpha));
    if (gate[w].dac>4095) gate[w].dac=4095;
  }
  else gate[w].dac = delay_buffer[w][1];

  if ((*speedfromnostrobe[gate[w].matrix[0]>>7])(gate[w].matrix[1], gate[w].matrix[2], w)){ // speedfunc
    GSHIFT_;
    SRlength[w]=lookuplenall[gate[w].matrix[6]>>7]; 

        if (!(*probf_anystrobe_depth_noin[gate[w].matrix[9]>>7])(gate[w].matrix[10], gate[w].matrix[11], w)) {
          bitn=(gate[w].funcbit[gate[w].matrix[3]>>gate[w].extent])(gate[w].matrix[4], gate[w].matrix[5], w);
        }
      else {
    if (w==0) bitn=(*inall[gate[w].matrix[7]>>6])(gate[w].matrix[8], gate[w].matrix[21], w); 
    else bitn=(routebits_depth_typesz[gate[w].matrix[12]>>extent_routebits_depth_typesz])(gate[w].matrix[5], gate[w].matrix[4], w); // swopped - fix now so is different
    // can be alts...
      }
    BITN_AND_OUTV_; 
    new_data(val,w);
    }
}

void SR_geo_inner_gappedfunction(uint32_t w){  // depth or alt
  HEADNADA;
  if (interpfromnostrobe[gate[w].matrix[0]>>7]){ 
    gate[w].alpha = gate[w].time_now - (float)gate[w].int_time;
    gate[w].dac = ((float)delay_buffer[w][DELAY_SIZE-5] * gate[w].alpha) + ((float)delay_buffer[w][DELAY_SIZE-6] * (1.0f - gate[w].alpha));
    if (gate[w].dac>4095) gate[w].dac=4095;
  }
  else gate[w].dac = delay_buffer[w][1];

    if ((*speedfromnostrobe[gate[w].matrix[0]>>7])(gate[w].matrix[1], gate[w].matrix[2], w)){ // speedfunc
    GSHIFT_;
    SRlength[w]=lookuplenall[gate[w].matrix[6]>>7];
    if (gate[w].depths[gate[w].matrix[3]>>gate[w].extent]) {// we use depth // *if (!depth_routebits_nostrobe_notypesz[gate[w].matrix[3]>>7])*
      if (w==0)     bitn=(*inall[gate[w].matrix[7]>>6])(gate[w].matrix[8], gate[w].matrix[21], w);  
      bitn^=(gate[w].funcbit[gate[w].matrix[3]>>gate[w].extent])(gate[w].matrix[4], gate[w].matrix[5], w); 
    }
    else { 
        if (!(*probf_anystrobe_depth[gate[w].matrix[9]>>6])(gate[w].matrix[10], gate[w].matrix[11], w)){
	  bitn=(gate[w].funcbit[gate[w].matrix[3]>>gate[w].extent])(gate[w].matrix[4], gate[w].matrix[5], w); 
      }
      else {
	if (w==0)     bitn=(*inall[gate[w].matrix[7]>>6])(gate[w].matrix[8], gate[w].matrix[21], w);  
	else bitn=(routebits_depth_typesz[gate[w].matrix[12]>>extent_routebits_depth_typesz])(gate[w].matrix[5], gate[w].matrix[4], w);
      }
    }
    BITN_AND_OUTV_; 
    new_data(val,w);
    }
}

void SR_geo_inner_gappedfunctionC(uint32_t w){  // depth or alt
  HEADNADA;
  if (interpfromnostrobe[gate[w].matrix[0]>>7]){ 
    gate[w].alpha = gate[w].time_now - (float)gate[w].int_time;
    gate[w].dac = ((float)delay_buffer[w][DELAY_SIZE-5] * gate[w].alpha) + ((float)delay_buffer[w][DELAY_SIZE-6] * (1.0f - gate[w].alpha));
    if (gate[w].dac>4095) gate[w].dac=4095;
  }
  else gate[w].dac = delay_buffer[w][1];

    if ((*speedfromnostrobe[gate[w].matrix[0]>>7])(gate[w].matrix[1], gate[w].matrix[2], w)){ // speedfunc
    GSHIFT_;
    SRlength[w]=lookuplenall[gate[w].matrix[6]>>7]; 
    if (gate[w].depths[gate[w].matrix[3]>>gate[w].extent]) {// we use depth // *if (!depth_routebits_nostrobe_notypesz[gate[w].matrix[3]>>7])*
      if (w==0)     bitn=(*inall[gate[w].matrix[7]>>6])(gate[w].matrix[8], gate[w].matrix[21], w);  
      bitn^=(gate[w].funcbit[gate[w].matrix[3]>>gate[w].extent])(gate[w].matrix[4], gate[w].matrix[5], w); 
    }
    else { 
        if (!(*probf_anystrobe_depth[gate[w].matrix[9]>>6])(gate[w].matrix[10], gate[w].matrix[11], w)){
	  bitn=(gate[w].funcbit[gate[w].matrix[3]>>gate[w].extent])(gate[w].matrix[4], gate[w].matrix[5], w); 
	}
      else {
	if (w==0)     bitn=(*inall[gate[w].matrix[7]>>6])(gate[w].matrix[8], gate[w].matrix[21], w);   // prob of entry
	else bitn = (gate[w].Gshift_[w]>>SRlength[w]) & 0x01;	   // cycle bit
      }
    }
    BITN_AND_OUTV_; 
    new_data(val,w);
    }
}

void SR_geo_inner_str_gappedfunction(uint32_t w){  // depth or cycle prob
  HEADNADA;
  gate[w].dac = delay_buffer[w][1];

  if ((*speedfromstrobe_nodepth[gate[w].matrix[15]>>8])(0, 0, w)){ // speedfunc
    GSHIFT_;
    SRlength[w]=lookuplenall[gate[w].matrix[6]>>7];
    if (w==0)     bitn=(*inall[gate[w].matrix[7]>>6])(gate[w].matrix[8], gate[w].matrix[21], w);  
    if (gate[w].str_depths[gate[w].matrix[17]>>gate[w].str_extent]) {// we use depth // *if (!depth_routebits_nostrobe_notypesz[gate[w].matrix[3]>>7])*   
      bitn^=(gate[w].str_funcbit[gate[w].matrix[17]>>gate[w].str_extent])(gate[w].matrix[4], gate[w].matrix[5], w); 
    }
    else { 
      if (!(*probf_nostrobe_depth[gate[w].matrix[9]>>7])(gate[w].matrix[10], gate[w].matrix[11], w)){
	bitn^=(gate[w].str_funcbit[gate[w].matrix[17]>>gate[w].str_extent])(gate[w].matrix[4], gate[w].matrix[5], w); 
      }
      else {
	bitn^=(routebits_nostrobe_depth[gate[w].matrix[12]>>extent_routebits_nostrobe_depth])(gate[w].matrix[5], gate[w].matrix[4], w);
      }	  
    }
    BITN_AND_OUTVS_; 
    new_data(val,w);
    }
}

void SR_geo_inner_str_probfunction(uint32_t w){  // generic prob 	// routebits_nostrobe_depth_notypesz >>8
  HEADNADA;
  gate[w].dac = delay_buffer[w][1];

  if ((*speedfromstrobe_nodepth[gate[w].matrix[15]>>8])(0, 0, w)){ // speedfunc
    GSHIFT_;
    SRlength[w]=lookuplenall[gate[w].matrix[6]>>7]; 
      if (!(*probf_nostrobe_depth[gate[w].matrix[9]>>7])(gate[w].matrix[10], gate[w].matrix[11], w)){
	bitn=(gate[w].str_funcbit[gate[w].matrix[17]>>gate[w].str_extent])(gate[w].matrix[4], gate[w].matrix[5], w); 
      }
      else {
	if (w==0) bitn=(*inall[gate[w].matrix[7]>>6])(gate[w].matrix[8], gate[w].matrix[21], w);
	else if (w==3) bitn=(*abstractbitsz_nostr[gate[w].matrix[20]>>extent_abstractbits])(gate[w].matrix[5], gate[w].matrix[4], w); 
	else	bitn=(routebits_nostrobe_depth[gate[w].matrix[12]>>extent_routebits_nostrobe_depth])(gate[w].matrix[5], gate[w].matrix[4], w); // swopped
      }	  
      BITN_AND_OUTVS_; 
      new_data(val,w);
    }
}

void SR_geo_inner_str_probfunctionalt(uint32_t w){  // generic prob 	//routebits_nostrobe_depth_typesz >>7
  HEADNADA;
  gate[w].dac = delay_buffer[w][1];

  if ((*speedfromstrobe_nodepth[gate[w].matrix[15]>>8])(0, 0, w)){ // speedfunc
    GSHIFT_;
    SRlength[w]=lookuplenall[gate[w].matrix[6]>>7]; 

    if (!(*probf_nostrobe_depth[gate[w].matrix[9]>>7])(gate[w].matrix[10], gate[w].matrix[11], w)){
	bitn=(gate[w].str_funcbit[gate[w].matrix[17]>>gate[w].str_extent])(gate[w].matrix[4], gate[w].matrix[5], w); 
      }
      else {
	if (w==0) bitn=(*inall[gate[w].matrix[7]>>6])(gate[w].matrix[8], gate[w].matrix[21], w);
	else if (w==3) bitn=(*abstractbitsz_nostr[gate[w].matrix[20]>>extent_abstractbits])(gate[w].matrix[5], gate[w].matrix[4], w); 
	else bitn=(routebits_nostrobe_nodepth[gate[w].matrix[12]>>extent_routebits_nostrobe_nodepth])(gate[w].matrix[5], gate[w].matrix[4], w); // swopped
      }	  
      BITN_AND_OUTVS_; 
      new_data(val,w);
    }
}

void SR_geo_inner_null(uint32_t w){
  // nada
}

void SR_geo_inner_xxxxx(uint32_t w){ // crash test
  (gate[w].str_funcbit[7777])(gate[w].matrix[4], gate[w].matrix[5], w); 
}


void SR_geo_innerxorC(uint32_t w){  
  HEADNADA;
  gate[w].dac = delay_buffer[w][1];
  //
  if ( (*speedfromcvforxor[gate[w].matrix[0]>>7])(gate[w].matrix[1],gate[w].matrix[2], w) ^ zbinroutfixed_noshift(0,0,w) ){ // speedfunc xor with fromforxor->binroutfixed...
    GSHIFT_;
    SRlength[w]=lookuplenall[gate[w].matrix[6]>>7]; 
    if (w==0) bitn=(*inall[gate[w].matrix[7]>>6])(gate[w].matrix[8], gate[w].matrix[21], w); 
    else bitn=(gate[w].str_funcbit[gate[w].matrix[17]>>gate[w].str_extent])(gate[w].matrix[4], gate[w].matrix[5], w); 

    BITN_AND_OUTV_; 
    new_data(val,w);
    }
}


////////////////////////////////////////////////////////////////////////////////////////////////////////////////
// OUTER

void SR_geo_outer_route(uint32_t w){  // fixed route // the most basic but no reset
  gate[w].matrix[0]=3<<7; // spdfracend with interpoll
  gate[w].matrix[1]=CV[w];//gate[dacfrom[daccount][w]].dac; // speed
  gate[w].inner=SR_geo_inner_globalC; // global route
}

void SR_geo_outer_null(uint32_t w){  // nada
  gate[w].inner=SR_geo_inner_null;
}

void SR_geo_outer_xxxxx(uint32_t w){  // crash
  gate[w].inner=SR_geo_inner_xxxxx;
}

// {0speedfrom/index, 1speedcv1, 2speedcv2, 3bit/index, 4bitcv1, 5bitcv2, 6lencv, 7adc, 8adccv, 9prob/index, 10probcv1, 11probvcv2, 12altfuncindex, 13dactype, 14dacpar, 15strobeindex, 16type, 17route

//0.0////////

void SR_geo_outer_C00(uint32_t w){  // set dactype, spdfrac, fixed route // for NN: set ADCtype, LL/RR: length
  if (gate[w].changed==1) 
    {
    RESETC; // added 21/12 only reset on change
    gate[w].changed=0;
  }
  gate[w].matrix[0]=0<<7; // spdfrac
  gate[w].matrix[1]=CV[w];// speed
  gate[w].matrix[13]=CVL[w]; // dactype = 13 /5,6,17 are strobed
  gate[w].inner=SR_geo_inner_globalC; // routetype/theroute so always at reset route/base global
}

void SR_geo_outer_C01(uint32_t w){ // prob2 - invert
  if (gate[w].changed==0) { 
  gate[w].matrix[0]=0<<7; // spdfrac
  gate[w].matrix[1]=CV[w];// speed
  gate[w].matrix[3]=6<<6; // 6=NZbinroutfixed_prob2 - type/prob against LFSR and globflag // or 14 prob3? inv cycle - checked for new array and is 6
  gate[w].matrix[4]=CVL[w]; //
  gate[w].funcbit=routebits_depth_typesz;
  gate[w].extent=extent_routebits_depth_typesz;
  gate[w].inner=SR_geo_inner_function;
  }
}

void SR_geo_outer_C02(uint32_t w){ // prob1 - route vs cycle
  if (gate[w].changed==0) { 
  gate[w].matrix[0]=0<<7; // spdfrac
  gate[w].matrix[1]=CV[w];// speed
  gate[w].matrix[3]=5<<6; // NZbinroutfixed_prob1 - type/prob against LFSR and globflag - checked for new array
  gate[w].matrix[4]=CVL[w]; //
  gate[w].funcbit=routebits_depth_typesz;
  gate[w].extent=extent_routebits_depth_typesz; 
  gate[w].inner=SR_geo_inner_function;
  }
}

void SR_geo_outer_C03(uint32_t w){ // prob4 - route vs. [route^cycle]
  if (gate[w].changed==0) {
  gate[w].matrix[0]=0<<7; // spdfrac
  gate[w].matrix[1]=CV[w];// speed
  gate[w].matrix[3]=8<<6; // NZbinroutfixed_prob4 - type/prob against LFSR and globflag
  gate[w].matrix[4]=CVL[w]; //
  gate[w].funcbit=routebits_depth_typesz;
  gate[w].extent=extent_routebits_depth_typesz; 
  gate[w].inner=SR_geo_inner_function;
  }
}

//1.0//////// 

void SR_geo_outer_C10(uint32_t w){ // change type.
  if (gate[w].changed==0) {
  gate[w].matrix[0]=0<<7; // spdfrac
  gate[w].matrix[1]=CV[w];// speed
  SETROUTETYPECV; 
  gate[w].inner=SR_geo_inner_globalC; // was depth route
  }
}

uint32_t dacy[32]={1,1,1,1, 1,1,1,1, 1,1,1,1, 1,1,1,1, 1,1,1,1, 1,1,1,1, 1,1,1,1, 1,1,0,0};

void SR_geo_outer_C11(uint32_t w){ // dacparam... 
  if (gate[w].changed==0) {
    if (w==3) gate[w].matrix[0]=3<<7; // spdfracend
    else  gate[w].matrix[0]=0<<7; // spdfrac
  gate[w].matrix[1]=CV[w];// speed
  if (dacy[gate[w].matrix[13]>>7]) gate[w].matrix[14]=CVL[w]; // set dacparam
  else gate[w].matrix[6]=CVL[w];// length
  gate[w].inner=SR_geo_inner_globalC; 
  }
}

void SR_geo_outer_C12(uint32_t w){ // length - length only notices at slower speeds
  if (gate[w].changed==0) {
    if (w==3) gate[w].matrix[0]=3<<7; // spdfracend
    else  gate[w].matrix[0]=0<<7; // spdfrac
  gate[w].matrix[1]=CV[w];// speed
  gate[w].matrix[6]=CVL[w]; // length
  gate[w].inner=SR_geo_inner_globalC; 
  }
}

void SR_geo_outer_C13(uint32_t w){ // change route. gapped type // depth as route
  if (gate[w].changed==0) {
  gate[w].matrix[0]=0<<7; // spdfrac
  gate[w].matrix[1]=CV[w];// speed
  gate[w].matrix[3]=0<<6; // Zbinrout_strip=0 checked
  gate[w].matrix[4]=CVL[w];
  gate[w].funcbit=routebits_depth_typesz;
  gate[w].extent=extent_routebits_depth_typesz; 
  gate[w].inner=SR_geo_inner_function; 
  }
}

//2.0//////// select functions, cv->depth
void SR_geo_outer_C20(uint32_t w){ // change function. nodepth. types
  if (gate[w].changed==0) {
    if (w==3) gate[w].matrix[0]=3<<7; // spdfracend
    else  gate[w].matrix[0]=0<<7; // spdfrac
  gate[w].matrix[1]=CV[w];// speed
  gate[w].matrix[3]=CVL[w]; // function  select
  //  gate[w].matrix[5]=(gate[dacfrom[daccount][w]].dac); // cv2 no depth
  gate[w].funcbit=routebits_nodepth_typesz; //new one // alts: routebits_nodepth_typesz[64] >>6 extent and routebits_depth_typesz[32]  >>7 extent // trial these
  gate[w].extent=extent_routebits_nodepth_typesz; 
  gate[w].depths=depth_routebits_nodepth_typesz;
  gate[w].inner=SR_geo_inner_function; 
  }
}

// routebits_anystrobe_nodepth_notypesz [32] (with depth as sel) // no depth: routebits_nodepth_typesz, routebits_anystrobe_nodepth_notypesz 
void SR_geo_outer_C21(uint32_t w){ // change function. nodepth no types
  if (gate[w].changed==0) {
    if (w==3) gate[w].matrix[0]=3<<7; // spdfracend
    else  gate[w].matrix[0]=0<<7; // spdfrac

  gate[w].matrix[1]=CV[w];// speed
  gate[w].matrix[3]=CVL[w]; // function  select
  //  gate[w].matrix[5]=(gate[dacfrom[daccount][w]].dac); // cv2
  gate[w].funcbit=routebits_anystrobe_nodepth_notypesz;
  gate[w].extent=extent_routebits_anystrobe_nodepth_notypesz; 
  gate[w].depths=depth_routebits_anystrobe_nodepth_notypesz;
  gate[w].inner=SR_geo_inner_function; 
  }
}

void SR_geo_outer_C22(uint32_t w){ // sel function. array with depth...routebits_depth_typesz
  if (gate[w].changed==0) {
    if (w==3) gate[w].matrix[0]=3<<7; // spdfracend
    else  gate[w].matrix[0]=0<<7; // spdfrac
  gate[w].matrix[1]=CV[w];// speed
  gate[w].matrix[3]=CVL[w]; // function  select routebits_depth_typesz[32] 20 is good!
  gate[w].matrix[5]=(gate[dacfrom[daccount][w]].dac); // cv2
  gate[w].funcbit=routebits_depth_typesz; //routebits_typeszz; //new one // alts: routebits_nodepth_typesz[64] >>6 extent and routebits_depth_typesz[32]  >>7 extent // trial these
  gate[w].extent=extent_routebits_depth_typesz; 
  gate[w].depths=depth_routebits_depth_typesz;
  gate[w].inner=SR_geo_inner_function; 
  }
}

void SR_geo_outer_C23(uint32_t w){ // depth - note depth will also leak into others with gapped depth like next one...
  if (gate[w].changed==0) {
    if (w==3) gate[w].matrix[0]=3<<7; // spdfracend
    else  gate[w].matrix[0]=0<<7; // spdfrac
  gate[w].matrix[1]=CV[w];// speed
  gate[w].matrix[4]=CVL[w]; // depth
  gate[w].matrix[5]=(gate[dacfrom[daccount][w]].dac); // cv2
  gate[w].funcbit=routebits_depth_typesz; //routebits_typeszz; //new one // alts: routebits_nodepth_typesz[64] >>6 extent and routebits_depth_typesz[32]  >>7 extent // trial these
  gate[w].extent=extent_routebits_depth_typesz; //
  gate[w].depths=depth_routebits_depth_typesz;
  gate[w].inner=SR_geo_inner_function; 
  }
}

//3.0/////// 
//
void SR_geo_outer_C30(uint32_t w){ //  // notypes select
  if (gate[w].changed==0) {
    if (w==3) gate[w].matrix[0]=3<<7; // spdfracend
    else  gate[w].matrix[0]=0<<7; // spdfrac
  gate[w].matrix[1]=CV[w];// speed
  gate[w].matrix[3]=CVL[w]; // sel function
  gate[w].matrix[5]=(gate[dacfrom[daccount][w]].dac); // cv2
  gate[w].funcbit=routebits_anystrobe_depth_notypesz;
  gate[w].extent=extent_routebits_anystrobe_depth_notypesz; //7 
  gate[w].depths=depth_routebits_anystrobe_depth_notypesz;
  gate[w].inner=SR_geo_inner_function; 
  }
}

void SR_geo_outer_C31(uint32_t w){ // notypes. depth
  if (gate[w].changed==0) {
    if (w==3) gate[w].matrix[0]=3<<7; // spdfracend
    else  gate[w].matrix[0]=0<<7; // spdfrac

  gate[w].matrix[1]=CV[w];// speed
  gate[w].matrix[4]=CVL[w]; // depth ok
  gate[w].matrix[5]=(gate[dacfrom[daccount][w]].dac); // cv2
  gate[w].funcbit=routebits_anystrobe_depth_notypesz;
  gate[w].extent=extent_routebits_anystrobe_depth_notypesz; // 
  gate[w].depths=depth_routebits_anystrobe_depth_notypesz;
  gate[w].inner=SR_geo_inner_function; 
  }
}

void SR_geo_outer_C32(uint32_t w){ // draft gapped funcbit - if depthbit is 0 do prob of cycle
  if (gate[w].changed==0) {
    if (w==3) gate[w].matrix[0]=3<<7; // spdfracend
    else  gate[w].matrix[0]=0<<7; // spdfrac
  gate[w].matrix[1]=CV[w];// speed
  gate[w].matrix[5]=(gate[dacfrom[daccount][w]].dac); // cv2
  gate[w].matrix[9]=0<<6; // select probfs - zprobbits here against LFSR__
  gate[w].matrix[4]=CVL[w];
  gate[w].matrix[10]=CVL[w];  
  gate[w].inner=SR_geo_inner_gappedfunctionC; // 24/2 
  }
}

void SR_geo_outer_C33(uint32_t w){ // do prob anyways but different [ func [xor] func with cycle] 
  if (gate[w].changed==0) {
    if (w==3) gate[w].matrix[0]=3<<7; // spdfracend
    else  gate[w].matrix[0]=0<<7; // spdfrac
  gate[w].matrix[1]=CV[w];// speed
  gate[w].matrix[5]=(gate[dacfrom[daccount][w]].dac); // cv2
  gate[w].matrix[9]=0<<6; // select probfs - zprobbits here against LFSR__
  gate[w].matrix[10]=CVL[w];
  gate[w].inner=SR_geo_inner_probcyclexorC; 
  }
}
	  
//4.0/////// rungler + speeds //  gapped funcs

void SR_geo_outer_C40(uint32_t w){ // speed function select
  if (gate[w].changed==0) {
    gate[w].matrix[0]=CVL[w]; 
    gate[w].matrix[1]=CV[w];// speed
    gate[w].matrix[2]=gate[speedfrom[spdcount][w]].dac; // 2nd speed cv
    gate[w].matrix[5]=(gate[dacfrom[daccount][w]].dac); // cv2
    gate[w].inner=SR_geo_inner_function; 
  }
}

void SR_geo_outer_C41(uint32_t w){ // basic rungler with gapped route function
  if (gate[w].changed==0) {
    gate[w].matrix[0]=24<<7; //zbinrouteSRbits checked
    gate[w].matrix[1]=CV[w]; // depth as route in this case
    gate[w].matrix[9]=0<<6; // select probfs - zinvprobbits here against LFSR__
    gate[w].matrix[4]=CVL[w];
    gate[w].matrix[10]=CVL[w];  
    gate[w].matrix[5]=(gate[dacfrom[daccount][w]].dac); // cv2
    gate[w].inner=SR_geo_inner_gappedfunction;
  }
}

void SR_geo_outer_C42(uint32_t w){   // dacspeed3 as fixed speedfunc .. 
  if (gate[w].changed==0) {
    gate[w].matrix[1]=CV[w];// speed
    gate[w].matrix[2]=CVL[w];//speed2
    gate[w].matrix[5]=(gate[dacfrom[daccount][w]].dac); // cv2
    gate[w].inner=SR_geo_inner_dacspeed3; 
  }
}

void SR_geo_outer_C43(uint32_t w){   
  int32_t in, tmp, depth;
  if (gate[w].changed==0) {
    gate[w].matrix[0]=CVL[w]; // changes all speeds
    in=gate[speedfrom[spdcount][w]].dac; // and other operations to trial
    depth=CV[w];
    /*

      2.   tmp=(in>>1)+(depth>>1);
      if (tmp>4095) tmp=4095;
      
      3.   tmp=(depth)-2048; // adapted for full bits
      tmp+=in;  
      if (tmp<0) tmp=0;
      else if (tmp>4095) tmp=4095;

      4,  tmp=in+depth;
      tmp=tmp&4095;

     */
    tmp=(depth)-2048; // adapted for full bits
    tmp+=in;  
    if (tmp<0) tmp=0;
    else if (tmp>4095) tmp=4095;

    gate[w].matrix[1]=tmp;
    gate[w].inner=SR_geo_inner_testdacasdepth;
  }
}

////////////////////////////////////////////////////////////////////////////////////////////////////////////
// 5.0 - generic probs with gapped speeds 

void SR_geo_outer_C50(uint32_t w){ // select prob function ??? but how when we cant feel difference - set halfway //cycle
  if (gate[w].changed==0) {
  gate[w].matrix[1]=CV[w];// speed
  gate[w].matrix[2]=gate[speedfrom[spdcount][w]].dac; // 2nd speed cv
  gate[w].matrix[5]=(gate[dacfromopp[daccount][w]].dac); // cv2  
  gate[w].matrix[9]=CVL[w]; // select prob function
  gate[w].matrix[10]=(gate[dacfrom[daccount][w]].dac); // do any use IN? yes spdfrac versions - should have basic prob vs in tho... // was 11
  gate[w].inner=SR_geo_inner_probcycleC; 
  }
}

void SR_geo_outer_C51(uint32_t w){ // probzeroes with depth
   if (gate[w].changed==0) {
  gate[w].matrix[1]=CV[w];// speed
  gate[w].matrix[2]=gate[speedfrom[spdcount][w]].dac; // 2nd speed cv
  gate[w].matrix[5]=(gate[dacfromopp[daccount][w]].dac); // cv2
  //  gate[w].matrix[9]=25<<6; // what is that prob? zsuccbitsI_noshift???
  gate[w].matrix[10]=CVL[w]; // prob depth
  gate[w].matrix[11]=(gate[dacfrom[daccount][w]].dac); // do any use IN? yes spdfrac versions - should have basic prob vs in tho...
  gate[w].inner=SR_geo_inner_functionprobzero;//
  }
}

void SR_geo_outer_C52(uint32_t w){ // probcycle with depth
  if (gate[w].changed==0) {
  gate[w].matrix[1]=CV[w];// speed
  gate[w].matrix[2]=gate[speedfrom[spdcount][w]].dac; // 2nd speed cv
  gate[w].matrix[5]=(gate[dacfromopp[daccount][w]].dac); // cv2
  gate[w].matrix[10]=CVL[w];// prob depth 28<<6; // 
  gate[w].matrix[11]=(gate[dacfrom[daccount][w]].dac); // do any use IN? yes spdfrac versions - should have basic prob vs in tho...
  gate[w].inner=SR_geo_inner_probcycleC; 
  }
}

void SR_geo_outer_C53(uint32_t w){  //probcyclexor with depth
  if (gate[w].changed==0) {
  gate[w].matrix[1]=CV[w];// speed
  gate[w].matrix[2]=gate[speedfrom[spdcount][w]].dac; // 2nd speed cv
  gate[w].matrix[5]=(gate[dacfromopp[daccount][w]].dac); // cv2
  gate[w].matrix[10]=CVL[w]; // probCV1
  gate[w].matrix[11]=(gate[dacfrom[daccount][w]].dac); // do any use IN? yes spdfrac versions - should have basic prob vs in tho...
  gate[w].inner=SR_geo_inner_probcyclexorC; 
  }
}

 
// 6.0 prob functions  
void SR_geo_outer_C60(uint32_t w){ // select prob function // also: probf_anystrobe_nodepth >>8 // 16
  if (gate[w].changed==0) {
  gate[w].matrix[1]=CV[w];// speed
  gate[w].matrix[2]=gate[speedfrom[spdcount][w]].dac; // 2nd speed cv
  gate[w].matrix[5]=(gate[dacfromopp[daccount][w]].dac); // cv2  
  gate[w].matrix[9]=CVL[w]; // select prob function
  //  gate[w].matrix[11]=(gate[dacfrom[daccount][w]].dac); // do any use IN? yes spdfrac versions - should have basic prob vs in tho...
  gate[w].inner=SR_geo_inner_probcycleCnodepth; 
  }
}

void SR_geo_outer_C61(uint32_t w){ // select prob function // also: probf_anystrobe_nodepth >>8 // 16
  if (gate[w].changed==0) {
  gate[w].matrix[1]=CV[w];// speed
  gate[w].matrix[2]=gate[speedfrom[spdcount][w]].dac; // 2nd speed cv
  gate[w].matrix[5]=(gate[dacfromopp[daccount][w]].dac); // cv2  
  gate[w].matrix[9]=CVL[w]; // select prob function
  gate[w].inner=SR_geo_inner_probcyclexorCnodepth; 
  }
}

// can select alt func for this prob -> 12][ SR_geo_inner_probnodepth
void SR_geo_outer_C62(uint32_t w){ 
  if (gate[w].changed==0) {
  gate[w].matrix[1]=CV[w];// speed
  gate[w].matrix[2]=gate[speedfrom[spdcount][w]].dac; // 2nd speed cv
  gate[w].matrix[5]=(gate[dacfromopp[daccount][w]].dac); // cv2  
  if (w==3) gate[w].matrix[20]=CVL[w];
  else gate[w].matrix[12]=CVL[w]; 
  gate[w].inner=SR_geo_inner_probnodepth; 
  }
}

// back to full depths as we have sel and alt. cv as depth
void SR_geo_outer_C63(uint32_t w){ // prob with depth
  if (gate[w].changed==0) {
  gate[w].matrix[1]=CV[w];// speed
  gate[w].matrix[2]=gate[speedfrom[spdcount][w]].dac; // 2nd speed cv
  gate[w].matrix[5]=(gate[dacfromopp[daccount][w]].dac); // cv2  
  gate[w].matrix[10]=CVL[w]; // prob depth CV1
  gate[w].matrix[11]=(gate[dacfrom[daccount][w]].dac); 
  gate[w].inner=SR_geo_inner_probdepth; 
  }
}

// 7.0- TODO: dacfroms - can also be placed after probs - gapped all but selectors - or shift earlier...
// depth as dacfrom /// depth for bits, for prob - then CVL as selectors: speed, bits, prob, altprobfunc
// gapped bitfuncs

void SR_geo_outer_C70(uint32_t w){ // gapped speedfunc. dac for depth...
  if (gate[w].changed==0) {
    gate[w].matrix[1]=CV[w];// speed
    gate[w].matrix[2]=gate[speedfrom[spdcount][w]].dac; // 2nd speed cv
    gate[w].matrix[3]=CVL[w]; // select function
    gate[w].matrix[5]=(gate[dacfromopp[daccount][w]].dac); // cv2

    //    gate[w].matrix[9]=0<<6; // select probfs - zinvprobbits here against LFSR__ gap that
    gate[w].matrix[4]=(gate[dacfrom[daccount][w]].dac); 
    gate[w].matrix[10]=(gate[dacfrom[daccount][w]].dac);
    gate[w].matrix[11]=(gate[dacfromopp[daccount][w]].dac);
    gate[w].inner=SR_geo_inner_gappedfunction; // 
  }
}

void SR_geo_outer_C71(uint32_t w){ // gapped speedfunc. gapped func. dac for length // or if w==0
  if (gate[w].changed==0) {
    gate[w].matrix[1]=CV[w];// speed
    gate[w].matrix[2]=gate[speedfrom[spdcount][w]].dac; // 2nd speed cv
    gate[w].matrix[3]=CVL[w]; // select function or could be depth
    gate[w].matrix[5]=(gate[dacfromopp[daccount][w]].dac); // cv2
    if (w==0) {
    if (inall_depth[gate[w].matrix[7]>>6]==1) gate[w].matrix[8]=(gate[dacfrom[daccount][w]].dac);
    else if (inall_depth[gate[w].matrix[7]>>6]==2) gate[w].matrix[21]=(gate[dacfrom[daccount][w]].dac); // mix for dacs
    else gate[w].matrix[6]=(gate[dacfrom[daccount][w]].dac); // length
    }
    else if (w==2 && (dacy[gate[w].matrix[13]>>7])) gate[w].matrix[14]=(gate[dacfrom[daccount][w]].dac); // dacparam
    else gate[w].matrix[6]=(gate[dacfrom[daccount][w]].dac);  // length
    gate[w].inner=SR_geo_inner_function; // 
  }
}

void SR_geo_outer_C72(uint32_t w){ // as above but cv sel of alt function
  if (gate[w].changed==0) {
  gate[w].matrix[1]=CV[w];// speed
  gate[w].matrix[2]=gate[speedfrom[spdcount][w]].dac; // 2nd speed cv
  gate[w].matrix[5]=(gate[dacfromopp[daccount][w]].dac); // cv2  
  if (w==0) {
    gate[w].matrix[7]=CVL[w];
    if (inall_depth[gate[w].matrix[7]>>6]==1) gate[w].matrix[8]=(gate[dacfrom[daccount][w]].dac);
    else if (inall_depth[gate[w].matrix[7]>>6]==2) gate[w].matrix[21]=(gate[dacfrom[daccount][w]].dac); // mix for dacs
    else gate[w].matrix[6]=(gate[dacfrom[daccount][w]].dac); // length
  }
  else {
    gate[w].matrix[12]=CVL[w]; // select alt
    gate[w].matrix[6]=(gate[dacfrom[daccount][w]].dac);  // length
  }
  gate[w].inner=SR_geo_inner_probdepthx; //x 
  }
}

// dac as prob depth
void SR_geo_outer_C73(uint32_t w){ // prob with depth
  if (gate[w].changed==0) {
  gate[w].matrix[1]=CV[w];// speed
  gate[w].matrix[2]=gate[speedfrom[spdcount][w]].dac; // 2nd speed cv
  gate[w].matrix[5]=(gate[dacfromopp[daccount][w]].dac); // cv2  
  gate[w].matrix[9]=CVL[w]; // select prob function
  gate[w].matrix[10]=(gate[dacfrom[daccount][w]].dac); 
  gate[w].inner=SR_geo_inner_probdepthx; 
  }
}

// 8.0 strobes

void SR_geo_outer_C80(uint32_t w){   // simple fixed strobe with sel bitfunc and depth: routebits_nostrobe_depth_typesz >>7
  if (gate[w].changed==0) {
    gate[w].matrix[15]=0<<8;//  simple strobe
    if (w==0) {
      gate[w].matrix[7]=CV[w]; // adc/abstract mode
      if (inall_depth[gate[w].matrix[7]>>6]==1) gate[w].matrix[8]=CVL[w];
      else if (inall_depth[gate[w].matrix[7]>>6]==2) gate[w].matrix[21]=CVL[w]; // mix for dacs
      else gate[w].matrix[6]=CVL[w]; // length
    }
    else if (w==3){
      gate[w].matrix[5]=CVL[w]; // depth
      gate[w].matrix[20]=CV[w]; // bit mode
    }
    else {
      gate[w].matrix[4]=CVL[w]; // depth
      gate[w].matrix[17]=CV[w]; // bit mode
    }
    gate[w].matrix[5]=(gate[dacfromopp[daccount][w]].dac); // cv2    
    gate[w].str_funcbit=routebits_nostrobe_depth_typesz;   // we make sure function is NO STROBE!
    gate[w].str_extent=extent_routebits_nostrobe_depth_typesz;
    gate[w].str_depths=depth_routebits_nostrobe_depth_typesz;

    gate[w].inner=SR_geo_inner_str_functionN; // just changes for NN solo no route in
  }
}

// we also have TYPE, length 
void SR_geo_outer_C81(uint32_t w){   // simple fixed strobe with sel bitfunc and depth: routebits_nostrobe_depth_notypesz >>8
  if (gate[w].changed==0) {
    gate[w].matrix[15]=0<<8;//  simple strobe
    /*    if (w==0) {
      gate[w].matrix[7]=CV[w]; // adc/abstract mode
      if (inall_depth[gate[w].matrix[7]>>6]==1) gate[w].matrix[8]=CVL[w];
      else if (inall_depth[gate[w].matrix[7]>>6]==2) gate[w].matrix[21]=CVL[w]; // mix for dacs
      else gate[w].matrix[6]=CVL[w]; // length
    }
    else {*/
      gate[w].matrix[4]=CVL[w]; // depth
      gate[w].matrix[17]=CV[w]; // bit mode
//    }
    gate[w].matrix[5]=(gate[dacfromopp[daccount][w]].dac); // cv2
  
    gate[w].str_funcbit=routebits_nostrobe_depth_notypesz;   // we make sure function is NO STROBE!
    gate[w].str_extent=extent_routebits_nostrobe_depth_notypesz;
    gate[w].str_depths=depth_routebits_nostrobe_depth_notypesz;

    gate[w].inner=SR_geo_inner_str_function;
  }
}

//routebits_nostrobe_nodepth_typesz >>8 //  TYPE
void SR_geo_outer_C82(uint32_t w){   //
  if (gate[w].changed==0) {
    gate[w].matrix[15]=0<<8;//  simple strobe
    gate[w].matrix[17]=CV[w]; // bit mode 
    gate[w].matrix[5]=(gate[dacfromopp[daccount][w]].dac); // cv2
    SETROUTETYPECV; 
    gate[w].str_funcbit=routebits_nostrobe_nodepth_typesz;   // we make sure function is NO STROBE!
    gate[w].str_extent=extent_routebits_nostrobe_nodepth_typesz;
    gate[w].str_depths=depth_routebits_nostrobe_nodepth_typesz;
    gate[w].inner=SR_geo_inner_str_function;
  }
}

// for routebits_nostrobe_nodepth_notypesz >>7 - new strobe prob func
void SR_geo_outer_C83(uint32_t w){   //
  if (gate[w].changed==0) {
    gate[w].matrix[15]=0<<8;//  simple strobe
    gate[w].matrix[17]=CV[w]; // bit mode 
    gate[w].matrix[5]=(gate[dacfromopp[daccount][w]].dac); // cv2
    gate[w].str_funcbit=routebits_nostrobe_nodepth_notypesz;   // we make sure function is NO STROBE!
    gate[w].str_extent=extent_routebits_nostrobe_nodepth_notypesz;
    gate[w].str_depths=depth_routebits_nostrobe_nodepth_notypesz;
    gate[w].matrix[9]=0; // probbits // gapped probs
    gate[w].matrix[10]=CVL[w];
    gate[w].matrix[11]=(gate[dacfrom[daccount][w]].dac);
    gate[w].inner=SR_geo_inner_str_probfunction;
  }
}

////////////////
//9.0

// select strobe speed function with no depth
void SR_geo_outer_C90(uint32_t w){   // gapped now but no depth // no NN route in
  if (gate[w].changed==0) {
    gate[w].matrix[15]=CVL[w];// speed func
    if (w==0) gate[w].matrix[7]=CV[w]; // 
    else if (w==3) gate[w].matrix[20]=CV[w]; // 
    else gate[w].matrix[17]=CV[w]; // bit mode

    gate[w].matrix[5]=(gate[dacfromopp[daccount][w]].dac); // cv2
    // what is bitfunc?
    //    gate[w].str_funcbit=routebits_nostrobe_nodepth_typesz;   // we make sure function is NO STROBE!
    //    gate[w].str_extent=extent_routebits_nostrobe_nodepth_typesz;
    //    gate[w].str_depths=depth_routebits_nostrobe_nodepth_typesz;
    gate[w].inner=SR_geo_inner_str_functionN; // no route in
  }
}

void SR_geo_outer_C91(uint32_t w){   // routes with depth and gapped strobe speed // gapped with depth
  if (gate[w].changed==0) {
    gate[w].matrix[17]=CV[w];
    gate[w].matrix[4]=CVL[w];
    gate[w].matrix[10]=CVL[w]; // for gapped
    gate[w].matrix[5]=(gate[dacfromopp[daccount][w]].dac); // cv2
    gate[w].matrix[11]=(gate[dacfrom[daccount][w]].dac); 

    //    gate[w].str_funcbit=routebits_nostrobe_depth_typesz;   // we make sure function is NO STROBE!
    //    gate[w].str_extent=extent_routebits_nostrobe_depth_typesz;
    //    gate[w].str_depths=depth_routebits_nostrobe_depth_typesz;
    
    gate[w].inner=SR_geo_inner_str_gappedfunction;
  }
}

void SR_geo_outer_C92(uint32_t w){   // // routes with depth and gapped strobe speed // c92 length and depth 
  if (gate[w].changed==0) {
    gate[w].matrix[4]=CVL[w];
    gate[w].matrix[10]=CVL[w]; // for gapped
    gate[w].matrix[5]=(gate[dacfromopp[daccount][w]].dac); // cv2
    gate[w].matrix[11]=(gate[dacfrom[daccount][w]].dac);
    
    if (w==0) {
    if (inall_depth[gate[w].matrix[7]>>6]==1) gate[w].matrix[8]=CV[w];
    else if (inall_depth[gate[w].matrix[7]>>6]==2) gate[w].matrix[21]=CV[w]; // mix for dacs
    else gate[w].matrix[6]=CV[w]; // length
    }
    else gate[w].matrix[6]=CV[w]; // length

    //    gate[w].str_funcbit=routebits_nostrobe_depth_typesz;   // we make sure function is NO STROBE!
    //    gate[w].str_extent=extent_routebits_nostrobe_depth_typesz;
    //    gate[w].str_depths=depth_routebits_nostrobe_depth_typesz;
    
    gate[w].inner=SR_geo_inner_str_gappedfunction;
  }
}

// // select strobe speed function with depth and gap function // not so XXXXX
void SR_geo_outer_C93(uint32_t w){   // speedfromstrobe_depth >>8
  if (gate[w].changed==0) {
    gate[w].matrix[15]=CVL[w]; // select
    gate[w].matrix[1]=CV[w]; // speed
    gate[w].matrix[5]=(gate[dacfromopp[daccount][w]].dac); // cv2
    gate[w].inner=SR_geo_inner_str_function2; // now no route in for NN
  }
}

// 10.0
// or throw in dacfrom depth and length here...
void SR_geo_outer_C100(uint32_t w){   // depth
  if (gate[w].changed==0) {
    gate[w].matrix[15]=CVL[w];// speed func
    gate[w].matrix[17]=CV[w]; // bit mode
    gate[w].matrix[5]=(gate[dacfromopp[daccount][w]].dac); // cv2
    // gapped func
    //    gate[w].matrix[9]=0<<6; // select probfs - zinvprobbits here against LFSR__ // or gapped
    gate[w].matrix[4]=(gate[dacfrom[daccount][w]].dac); 
    gate[w].matrix[10]=(gate[dacfrom[daccount][w]].dac); 
    gate[w].matrix[11]=(gate[dacfromopp[daccount][w]].dac); 
    gate[w].inner=SR_geo_inner_str_gappedfunction;
  }
}

void SR_geo_outer_C101(uint32_t w){   // length
  if (gate[w].changed==0) {
    gate[w].matrix[15]=CVL[w];// speed func
    //    gate[w].matrix[17]=CV[w]; // bit mode
    /*        if (w==0) {
      gate[w].matrix[7]=CV[w]; // adc/abstract mode
    }
    else if (w==3){
      gate[w].matrix[20]=CV[w]; // bit mode
    }
    else {*/
      gate[w].matrix[17]=CV[w]; // bit mode
      //    }
    gate[w].matrix[5]=(gate[dacfromopp[daccount][w]].dac); // cv2
    gate[w].matrix[6]=(gate[dacfrom[daccount][w]].dac);     // length
    // gapped func
    gate[w].inner=SR_geo_inner_str_function;
  }
}

void SR_geo_outer_C102(uint32_t w){   // strobexor with gapped/fixed strobe
  if (gate[w].changed==0) {
    gate[w].matrix[0]=CVL[w]; // select spdfrom mode
    gate[w].matrix[1]=CV[w];// speed
    gate[w].matrix[2]=gate[speedfrom[spdcount][w]].dac; // 2nd speed cv
    gate[w].matrix[5]=(gate[dacfromopp[daccount][w]].dac); // cv2
    // other funcs or just gap it?
    //    gate[w].funcbit=routebits_nostrobe_depth_notypesz;   // we make sure function is NO STROBE!
    //    gate[w].extent=extent_routebits_nostrobe_depth_notypesz; 
    //    gate[w].depths=depth_routebits_nostrobe_depth_notypesz;
    //    gate[w].matrix[15]=0; // fixed strobe   or gap it
    gate[w].inner=SR_geo_inner_function_strobexor; // now no route in
  }
} 

void SR_geo_outer_C103(uint32_t w){   // strobexor with var strobe
  if (gate[w].changed==0) {
    //    gate[w].matrix[0]=CVL[w]; // select spdfrom mode
    gate[w].matrix[1]=CV[w];// speed
    gate[w].matrix[2]=gate[speedfrom[spdcount][w]].dac; // 2nd speed cv
    gate[w].matrix[5]=(gate[dacfromopp[daccount][w]].dac); // cv2
    // other funcs or just gap it?
    //    gate[w].funcbit=routebits_nostrobe_depth_notypesz;   // we make sure function is NO STROBE!
    //    gate[w].extent=extent_routebits_nostrobe_depth_notypesz; // checked!
    //    gate[w].depths=depth_routebits_nostrobe_depth_notypesz;
    gate[w].matrix[15]=CVL[w]; // strobe  func sel
    gate[w].inner=SR_geo_inner_function_strobexor;
  }
} 

// // 11.0 strobes including wider probs/probfunctions - how we organise CV/CVL// strobe with no depth
// prob mode, prob depth... CV CVL
void SR_geo_outer_C110(uint32_t w){   // all
  if (gate[w].changed==0) {
    gate[w].matrix[5]=(gate[dacfromopp[daccount][w]].dac); // cv1/cv2
    // first func is gapped
    gate[w].matrix[10]=CVL[w]; // depth
    if (w==0)  gate[w].matrix[7]=CV[w]; // all functions
    else if (w==3) gate[w].matrix[20]=CV[w];
    else gate[w].matrix[12]=CV[w];
    gate[w].matrix[11]=(gate[dacfrom[daccount][w]].dac);
    gate[w].inner=SR_geo_inner_str_probfunction; 
  }
} 

void SR_geo_outer_C111(uint32_t w){  
  if (gate[w].changed==0) {
    if (w==0) {
      if (inall_depth[gate[w].matrix[7]>>6]==1) gate[w].matrix[8]=(gate[dacfrom[daccount][w]].dac);
      else if (inall_depth[gate[w].matrix[7]>>6]==2) gate[w].matrix[21]=(gate[dacfrom[daccount][w]].dac); // mix for dacs
      else gate[w].matrix[6]=(gate[dacfrom[daccount][w]].dac); // length
    }
    else gate[w].matrix[5]=(gate[dacfromopp[daccount][w]].dac);
    // first func is gapped
    gate[w].matrix[10]=CVL[w]; // depth
    gate[w].matrix[9]=CV[w]; // selprob
    gate[w].matrix[11]=(gate[dacfrom[daccount][w]].dac);
    gate[w].inner=SR_geo_inner_str_probfunction; 
  }
} 

void SR_geo_outer_C112(uint32_t w){  //alt probfunction does not impact on w==0 or 3
  if (gate[w].changed==0) {
    if (w==0) {
      if (inall_depth[gate[w].matrix[7]>>6]==1) gate[w].matrix[8]=(gate[dacfrom[daccount][w]].dac);
      else if (inall_depth[gate[w].matrix[7]>>6]==2) gate[w].matrix[21]=(gate[dacfrom[daccount][w]].dac); // mix for dacs
      else gate[w].matrix[6]=(gate[dacfrom[daccount][w]].dac); // length
    }
    else gate[w].matrix[5]=(gate[dacfromopp[daccount][w]].dac);
    gate[w].matrix[17]=CV[w]; // bitfunc in strobe case
    gate[w].matrix[10]=CVL[w]; // depth of prob
    gate[w].matrix[11]=(gate[dacfrom[daccount][w]].dac);
    gate[w].inner=SR_geo_inner_str_probfunctionalt; 
  }
} 

void SR_geo_outer_C113(uint32_t w){  // alt
  if (gate[w].changed==0) {
    //    gate[w].matrix[5]=(gate[dacfromopp[daccount][w]].dac); // cv1/cv2 gap it
    // first func is gapped
    if (w==0) {
    if (inall_depth[gate[w].matrix[7]>>6]==1) gate[w].matrix[8]=CV[w];
    else if (inall_depth[gate[w].matrix[7]>>6]==2) gate[w].matrix[21]=CV[w]; // mix for dacs
    else gate[w].matrix[6]=CV[w]; // length
    }
    else gate[w].matrix[5]=CV[w];
    gate[w].matrix[10]=CVL[w]; // depth probf
    gate[w].matrix[11]=(gate[dacfrom[daccount][w]].dac);
    gate[w].inner=SR_geo_inner_str_probfunction; 
  }
} 

////////////////////////////////////////////////////////////////////////////////////////////////////////
// start with matrixp strobe modes

// {0speedfrom/index, 1speedcv1, 2speedcv2, 3bit/index, 4bitcv1, 5bitcv2, 6lencv, 7adc, 8adccv, 9prob/index, 10probcv1, 11probvcv2, 12altfuncindex, 13dactype, 14dacpar, 15strobespd, 16troutetype, 17 route->now strobe function index}, 18 is abstract CV, 19 is now glob, 20 is now abstract index, 21 is mix

//uint32_t fixed=0, gap=0;

// cut to 16 here and we don't use fixed/gap // lose param
// and these all need to be 12 bit versions
uint32_t *fixedvars[4][16]={ //was 20 
  {&gate[2].dac, &gate[3].dac, &gate[0].dac, &gate[1].dac, &CV[0], &CVL[0], &ADCin, &Gshift__[0], &Gshift__[1], &Gshift__[2], &Gshift__[3], &clksr__[0], &Gshift__[4], &LFSR__[0], &LFSR__[1], &LFSR__[2]},
  {&gate[3].dac, &gate[0].dac, &gate[1].dac, &gate[2].dac, &CV[1], &CVL[1], &ADCin, &Gshift__[0], &Gshift__[1], &Gshift__[2], &Gshift__[3], &clksr__[1], &Gshift__[4], &LFSR__[0], &LFSR__[1], &LFSR__[2]},
  {&gate[0].dac, &gate[1].dac, &gate[2].dac, &gate[3].dac, &CV[2], &CVL[2], &ADCin, &Gshift__[0], &Gshift__[1], &Gshift__[2], &Gshift__[3], &clksr__[2], &Gshift__[4], &LFSR__[0], &LFSR__[1], &LFSR__[2]},
  {&gate[1].dac, &gate[2].dac, &gate[3].dac, &gate[0].dac, &CV[3], &CVL[3], &ADCin, &Gshift__[0], &Gshift__[1], &Gshift__[2], &Gshift__[3], &clksr__[3], &Gshift__[4], &LFSR__[0], &LFSR__[1], &LFSR__[2]},
};

// fixed 21/2/2023

// trial remap of fixedvars to avoid CV and CVL
uint32_t remap[16]={0,1,2,3, 0,1,6,7, 8,9,10,11, 12,13,14,15};

// {0speedfrom/index, 1speedcv1, 2speedcv2, 3bit/index, 4bitcv1, 5bitcv2, 6lencv, 7adc, 8adccv, 9prob/index, 10probcv1, 11probvcv2, 12altfuncindex, 13dactype, 14dacpar, 15strobespd, 16troutetype, 17 route->now strobe function index}, 18 is abstract CV-unused, 19 is now glob, 20 is now abstract index, 21 is mix


uint32_t *map;
uint32_t maparrayCCS[16]={1, 15, 2, 17,  4, 5, 6, 13,  14, 16, 9, 10,  11, 12, 15, 1}; // strobes
uint32_t maparrayCCSA[16]={1, 15, 2, 17,  4, 5, 6, 7,  8, 20, 21, 9,  10, 11, 13, 14};// 16

uint32_t maparrayCC[16]= {1, 0, 2, 3, 4, 5, 6, 13, 14, 16, 9, 10, 11, 12, 20, 1}; 
uint32_t maparrayCCA[16]= {1, 0, 2, 3,  4, 5, 6, 16,  9, 10, 11, 7,  8, 21, 13, 14};// 16 // not use 12 or 20

uint32_t maparrayCCAreduce[16]= {1, 1, 0, 0,  2, 2, 6, 6,  7, 7, 8, 8,  21, 21, 13, 13};// 16 // reduced map for w==0/A with no route in/bitfunc:
uint32_t maparrayCCreduce[16]= {1, 0, 2, 3,  4, 5, 6, 13,  14, 16, 20, 0,  1, 2, 3, 4};// and for no probs

//.////
void SR_geomantic_matrixcopyz(uint32_t w){ 
  uint32_t x;
  for (x=0;x<22;x++){
        gate[w].matrixX[x]=*gate[w].matrixp[x];//*(gate[w].matrixp[x]); // value at
  }
}

void SR_geomantic_matrixcopyoffsetz(uint32_t w){ 
  uint32_t x;
  for (x=0;x<22;x++){
    gate[w].matrixX[x]=(*(gate[w].matrixp[x]))+gate[w].offset[x]; // value at + offset
    gate[w].matrixX[x]=gate[w].matrixX[x]%4095;
  }
}

static inline void setfixedvarz(uint32_t wh, uint32_t which, uint32_t var){ // sets fixed value at var var
  gate[wh].matrix[which]=*fixedvars[wh][var];
  gate[wh].matrixp[which]=&gate[wh].matrix[which]; 
}

static inline void setvarz(uint32_t wh, uint32_t which, uint32_t var){ // plain set across all
  gate[wh].matrixp[which]=fixedvars[wh][var]; 
}

static inline void setgapz(uint32_t wh, uint32_t which){ 
    gate[wh].matrix[which]=gate[wh].matrixX[which]; // value
    gate[wh].matrixp[which]=&gate[wh].matrix[which]; // pointer
}

// 8/3/2023 ??
static inline void setvargapzbleed(uint32_t wh, uint32_t which, uint32_t var){ // bleeds values across but obscures any attachments // tested...test.c
  gate[wh].matrixp[gate[wh].oldgap]=&gate[wh].matrix[gate[wh].oldgap]; // old one points back to matrix
  gate[wh].matrixp[which]=fixedvars[wh][var]; // new one
  gate[wh].matrix[which]=*gate[wh].matrixp[which]; // value at matrix is updated... // or we have that copy in main copy
  gate[wh].oldgap=which;
}

//////////////////////////////////////////

// resett=1 is bleed... 
static inline void setvargapz(uint32_t wh, uint32_t layer, uint32_t which, uint32_t var, uint32_t resset){ // sets gap with one of fixedvars - tested in test2.c 9/3/
  /* // test2.c follows
      matrixp[oldgap[wh][layer]]=matrixpG[oldgap[wh][layer]];//
      matrixpG[which]=matrixp[which]; // previous  
      matrixp[which]=varr[var]; // new one
      oldgap[wh][layer]=which;
  */
  
  gate[wh].matrixp[gate[wh].oldgapp[layer]]=gate[wh].matrixpG[gate[wh].oldgapp[layer]];
  gate[wh].matrixpG[which]=gate[wh].matrixp[which]; 
  gate[wh].matrixp[which]=fixedvars[wh][var]; // new one pointer

  if (resset==1){ //reset back = bleed
    //	matrix[which]=*varr[var];
    //	matrixp[oldgap[wh][layer]]=&matrix[which];

    gate[wh].matrix[which]=*fixedvars[wh][var]; // new one value
    gate[wh].matrixp[gate[wh].oldgapp[layer]]=&gate[wh].matrix[which];
  }

  gate[wh].oldgapp[layer]=which;
}

//////////////////////////////////////////////////////
/*
setgapz.
setvarz- just attach... CV and CVL
setfixedvars - set value from eg. CVL etc...

120: strobe: set to CV, CVL, gshift, dacfrom (as we have)
130: strobe: CV to CVL XY, set gap, bleed of XY, empty one
140: nostr: set triggered cnt to CVL, to dacfrom, dacfrom chosen is set to CV, on trigger and dacfrom set to CV
150: nostr, CV to CVL XY, SR bits set, gaps from SR bits, then 153 final reset

 */

// CV attach using CVL with model here
void SR_geo_outer_C120(uint32_t w){ // CV/CVL  
  if (gate[w].changed==0) {
    if (w==0) map=maparrayCCSA;
    else map=maparrayCCS;
    setvargapzbleed(w, map[(CV[w]>>8)], remap[CVL[w]>>8]);  // or vargapz
    SR_geomantic_matrixcopyz(w);
    gate[w].routetype=gate[w].matrixX[16]>>9;
    gate[w].inner=SR_geo_inner_str_probfunctionX; 
  }
}

void SR_geo_outer_C121(uint32_t w){ // all layers
  if (gate[w].changed==0) {
    if (w==0) map=maparrayCCSA;
    else map=maparrayCCS;
    setvargapz(w, remap[CVL[w]>>8], map[CV[w]>>8], remap[CVL[w]>>8], 0); //CVL is var...
    SR_geomantic_matrixcopyz(w);
    gate[w].routetype=gate[w].matrixX[16]>>9;
    gate[w].inner=SR_geo_inner_str_probfunctionX; 
  }
}

void SR_geo_outer_C122(uint32_t w){ //SR_geomantic_matrixcopyoffsetz
  if (gate[w].changed==0) {
    if (w==0) map=maparrayCCSA;
    else map=maparrayCCS;
    gate[w].offset[map[CV[w]>>8]]=CVL[w];
    SR_geomantic_matrixcopyoffsetz(w);
    gate[w].routetype=gate[w].matrixX[16]>>9;
    gate[w].inner=SR_geo_inner_str_probfunctionX; 
  }
}

void SR_geo_outer_C123(uint32_t w){ // CV/CVL  one layer
  if (gate[w].changed==0) {
    if (w==0) map=maparrayCCSA;
    else map=maparrayCCS;
    setvargapz(w, 16, map[(CV[w]>>8)], remap[CVL[w]>>8],0);  // or vargapz
    SR_geomantic_matrixcopyz(w);
    gate[w].routetype=gate[w].matrixX[16]>>9;
    gate[w].inner=SR_geo_inner_str_probfunctionX; 
  }
}

//setfixedvarz cv cvl
void SR_geo_outer_C130(uint32_t w){   
  if (gate[w].changed==0) {
    if (w==0) map=maparrayCCSA;
    else map=maparrayCCS;
    setfixedvarz(w, map[(CV[w]>>8)], remap[CVL[w]>>8]); 		   
    SR_geomantic_matrixcopyz(w);
    gate[w].routetype=gate[w].matrixX[16]>>9;
    gate[w].inner=SR_geo_inner_str_probfunctionXX; 
  }
}

void SR_geo_outer_C131(uint32_t w){   
  if (gate[w].changed==0) {
    if (w==0) map=maparrayCCSA;
    else map=maparrayCCS;
    setvarz(w, map[(CV[w]>>8)], remap[CVL[w]>>8]); 		   
    SR_geomantic_matrixcopyz(w);
    gate[w].routetype=gate[w].matrixX[16]>>9;
    gate[w].inner=SR_geo_inner_str_probfunctionXX; 
  }
}

// 1010101 from SR sets matrixp to CV/CVL chosen fixedvar - probably better as strobe
void SR_geo_outer_C132(uint32_t w){ 
  if (gate[w].changed==0) {
    uint32_t x;
    uint32_t tmp=(gate[dacfrom[daccount][w]].shift_);//&0b1111111111111111;
    if (w==0) map=maparrayCCSA;
    else map=maparrayCCS;

    for (x=0;x<16;x++){
      if (tmp&0x01) setfixedvarz(w,map[CV[w]>>8],remap[CVL[w]>>8]); // can also be others - sets value at x in CV[w] chosen param
      tmp=tmp>>1;
    }
    SR_geomantic_matrixcopyz(w); // or offset?
    gate[w].routetype=gate[w].matrixX[16]>>9;
    gate[w].inner=SR_geo_inner_str_probfunctionXX;
  }
}

// gapz
void SR_geo_outer_C133(uint32_t w){  // // can also be gaps and 2 processes against each other
  if (gate[w].changed==0) {
    uint32_t x;
    uint32_t tmp=(gate[dacfrom[daccount][w]].shift_);//&0b1111111111111111;
    if (w==0) map=maparrayCCSA;
    else map=maparrayCCS;

    for (x=0;x<16;x++){
      if (tmp&0x01)       setgapz(w, map[x]);
      tmp=tmp>>1;
    }
      // and then do CV, CVL on top - could also be setvarz
      setfixedvarz(w, map[(CV[w]>>8)], remap[CVL[w]>>8]); 		   
      SR_geomantic_matrixcopyz(w); // or offset?
      gate[w].routetype=gate[w].matrixX[16]>>9;
      gate[w].inner=SR_geo_inner_str_probfunctionXX;
  }
}

void SR_geo_outer_C133x(uint32_t w){  
  if (gate[w].changed==0) {
    uint32_t x;
    uint32_t tmp=(gate[dacfrom[daccount][w]].shift_);//&0b1111111111111111;
    if (w==0) map=maparrayCCSA;
    else map=maparrayCCS;

    for (x=0;x<16;x++){
      setvargapz(w, remap[CVL[w]>>8], map[CV[w]>>8], remap[CVL[w]>>8], (tmp&0x01)); 
      tmp=tmp>>1;
    }
      SR_geomantic_matrixcopyz(w); // or offset?
      gate[w].routetype=gate[w].matrixX[16]>>9;
      gate[w].inner=SR_geo_inner_str_probfunctionXX;
  }
}

/////////////////////////////
 // CV speeds

// CV attach using CVL
void SR_geo_outer_C140(uint32_t w){   // if trigger then bleed 
  if (gate[w].changed==0) {
    // what event we can trigger on and what to release 0,1 or 2
    if (w==0) map=maparrayCCA;
    else map=maparrayCC;

    setvargapz(w, 4, map[(CVL[w]>>8)], 4, gate[w].trigger); 
    SR_geomantic_matrixcopyz(w);
    gate[w].routetype=gate[w].matrixX[16]>>9;
    gate[w].inner=SR_geo_inner_probdepthdepthS;//SR_geo_inner_gappedfunction;// S sets strobe
  }
}

void SR_geo_outer_C141(uint32_t w){   // if trigger then bleed // CVL attach using CV
  if (gate[w].changed==0) {
    // what event we can trigger on and what to release 0,1 or 2
    if (w==0) map=maparrayCCA;
    else map=maparrayCC;

    setvargapz(w, 5, map[(CV[w]>>8)], 5, gate[w].trigger);  // 5
    SR_geomantic_matrixcopyz(w);
    gate[w].routetype=gate[w].matrixX[16]>>9;
    gate[w].inner=SR_geo_inner_probdepthdepthS;//SR_geo_inner_gappedfunction;// S sets strobe
  }
}

void SR_geo_outer_C142(uint32_t w){   // if trigger then bleed 
  if (gate[w].changed==0) {
    if (w==0) map=maparrayCCA;
    else map=maparrayCC;

    if (map[(CVL[w]>>8)]==1){ // speedcv // fixed...
    setvargapz(w, 7+speedfrom[spdcount][w], 0, 7+speedfrom[spdcount][w], gate[w].trigger);  // speedfrom
    }
    else {
    setvargapz(w, 7+dacfrom[daccount][w], map[(CVL[w]>>8)], 7+dacfrom[daccount][w], gate[w].trigger);  // gshift
    }
    gate[w].offset[1]=CV[w]; // offset speed???
    SR_geomantic_matrixcopyoffsetz(w);
    gate[w].routetype=gate[w].matrixX[16]>>9;
    gate[w].inner=SR_geo_inner_probdepthdepthS;
  }
}

//cv/cvl version - seems work fine no remap
void SR_geo_outer_C143(uint32_t w){   // if trigger then bleed 
  if (gate[w].changed==0) {
    if (w==0) map=maparrayCCA;
    else map=maparrayCC;
    setvargapz(w, CVL[w]>>8, map[(CV[w]>>8)], CVL[w]>>8, gate[w].trigger); 
    SR_geomantic_matrixcopyz(w);
    gate[w].routetype=gate[w].matrixX[16]>>9;
    gate[w].inner=SR_geo_inner_probdepthdepthS;
  }
}

//layers as sep functions we have but also can be in one - see notes // as bleed/no bleed/triggers bleed
void SR_geo_outer_C150(uint32_t w){
  uint32_t tmp;
  if (gate[w].changed==0) {
    if (w==0) map=maparrayCCA;
    else map=maparrayCC;
    tmp=CV[w]>>8;// 4 bits 16 layers
    if (gate[w].trigger) setvargapz(w, CVL[w]>>8, map[tmp], CVL[w]>>8, 1); //CVL is var...
    SR_geomantic_matrixcopyz(w);
    gate[w].routetype=gate[w].matrixX[16]>>9;
    gate[w].inner=SR_geo_inner_probdepthdepthSS;
  }
}

void SR_geo_outer_C151(uint32_t w){   // reduced array
  uint32_t tmp;
  if (gate[w].changed==0) {
    if (w==0) map=maparrayCCAreduce;
    else map=maparrayCCreduce;
    tmp=CV[w]>>8;// 4 bits 16 layers
    if (gate[w].trigger) setvargapzbleed(w, map[tmp], remap[CVL[w]>>8]); //CVL is var... //    setvargapzbleed(w, map[(CV[w]>>8)], CVL[w]>>8);  // or vargapz
    SR_geomantic_matrixcopyz(w);
    gate[w].routetype=gate[w].matrixX[16]>>9;
    gate[w].inner=SR_geo_inner_matrixreduceX;
  }
}

void SR_geo_outer_C152(uint32_t w){   // offset
  if (gate[w].changed==0) {
    if (w==0) map=maparrayCCA;
    else map=maparrayCC;
    gate[w].offset[map[CV[w]>>8]]=CVL[w];
    SR_geomantic_matrixcopyoffsetz(w);
    gate[w].routetype=gate[w].matrixX[16]>>9;
    gate[w].inner=SR_geo_inner_probdepthdepthS;
  }
}

// C153 in RR

////////////////////////////////////////////////////////////////////////
