microresearch/allcolours/(commit log)

2018-07-27 Makefile for straight to arduino
2018-08-15 panel skecth
    [allcolfilter.sch, allcolours.sch, file5AD5ACBA.sch]
2018-08-22 added env
    [allcolfilter.sch, allcolours.sch]
2018-09-29 ouroboros transistor aff
    [allcolfilter.sch, allcolours.sch, file5AD5ACBA.sch]
2018-10-18 analogue also
    [allcolfilter.sch, allcolours_analogue.sch, file5AD5ACBA.sch, misc_trans.sch, noiseandosc.sch, ouroboros.sch, shiftreg.sch, switchedfilter.sch]
2019-08-15 pcb rough placement
    [allcolours.kicad_pcb, file5AD5ACBA.sch]
2019-08-19 first finishhh
    [allcolours.kicad_pcb, allcolours_theone.kicad_pcb]
2019-10-09 panel finished i think
    [allcolours_panel.kicad_pcb]
2019-10-10 fixed TIM3 PB4 partial remap
    [main.c]
2019-10-14 changed comparators
    [allcolours.sch, allcolours_panel.kicad_pcb]
2019-10-16 pwm clicks reduced with extra pre-load line
2019-10-29 pcb fixes
    [allcolours.kicad_pcb, allcolours.sch, allcolours_prelastchanges.kicad_pcb]
2019-12-30 started on BOM for pcbcart
    [allcolfilter.sch, allcolours.kicad_pcb, allcolours.sch, allcolours_bom_.csv, allcolours_in_progress.xls]
2019-12-30 bom nearlly
    [allcolours_in_progress.xls, file5AD5ACBA.sch]
2020-01-13 changed comparators back plus chnaged c7 to 1UF
    [allcolours.kicad_pcb, allcolours.sch, file5AD5ACBA.sch]
2020-01-13 - changed c7, changed comparator, changed 12v on pulse and pwm outs and added divider for pulse outs...
    [allcolours.kicad_pcb, allcolours.sch, file5AD5ACBA.sch]
2020-01-14 added filter protection diodes
    [allcolfilter.sch, allcolours.kicad_pcb, file5AD5ACBA.sch]
2020-01-14 final checks pcb schematic
    [allcolfilter.sch, allcolours.kicad_pcb, allcolours.sch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]
2020-01-15 pre vias
    [allcolfilter.sch, allcolours.kicad_pcb, allcolours.sch]
2020-01-17 new normings
    [allcolours.kicad_pcb, file5AD5ACBA.sch, ionorms.sch]
2020-01-17 testing, small changes on comparators
    [allcolours.kicad_pcb, allcolours.sch]
2020-01-29 pcb ordered
    [allcolours.kicad_pcb]
2020-03-30 shift reg work
    [segments.kicad_pcb, segments.sch]
2020-05-22 pcb and changes
    [allcolfilter.sch, allcolours.kicad_pcb, allcolours.sch, bintic.sch, control.sch]
2020-06-11 fixed q1 orient
    [bintic.sch, filter.kicad_pcb]
2020-06-18 touch and touch_toggle
    [euro_power.sch, euro_touch.sch, panel_touch.sch, touch.kicad_pcb, touch.sch]
2020-06-24 own touch broken down
    [euro_touch.sch, panel_touch.sch, power.sch, toggle.sch, touch.kicad_pcb, touch.sch]
2020-06-26 own thru hole - revert now to smd version with stm32f466 on board
    [euro_touch.sch, power.sch, toggle.sch, touch.kicad_pcb, touch.sch]
2020-07-07 new touch_kicad overwrites all versions now
    [euro_power.sch, euro_touch.sch, micro.sch, mix.sch, panel_touch.sch, power.sch, pulsesetc.sch, segments.sch]
2020-07-17 moved around values for printing
    [filter.kicad_pcb]
2020-07-18 TODO notes
    [bintic.sch, control.sch]
2020-08-04 net and footprints assoc. reduced to 4 sets of connection...
    [IOjacks.sch, euro_power.sch, euro_touch.sch, euro_touch2.sch, freeze.sch, micro.sch, mixetc.sch, panel_touch.sch]
2020-09-10 xls for BOM
    [allcolfilter.sch, allcolours.kicad_pcb, allcolours_in_progress_newest.xls]
2020-09-30 vca touch checked and tested
    [euro_touch.sch]
2020-10-05 new TOAD dir, and copies micro.sch to SEGMENTS
    [bintic.sch, control.sch, filter.kicad_pcb, filter.sch, micro.sch, micro_old.sch, oldDAC.sch, power.sch]
2020-10-07 added SIGNUM
    [signum.sch]
2020-10-21 using housing SOIC 8 corrected for pcbacrt and TODO for other design
    [allcolours_fixed21102020.kicad_pcb, bintic.sch]
2020-10-21 changed all footprints to 3.9mm housings-SOIC
    [CV.sch, allcolfilter.sch, bintic.sch, control.sch, euro_touch.sch, file5AD5ACBA.sch, freeze.sch, mixetc.sch]
2020-10-26 broken out to panel and back - panel finished with 2x20conn
    [IOjacks.sch, euro_power.sch, euro_touch.sch, freeze.sch, micro.sch, mix.sch, mixetc.sch, panel_connector.sch]
2020-10-26 added thru panel connector
    [IOjacks.sch, euro_power.sch, euro_touch.sch, freeze.sch, micro.sch, mixetc.sch, panel_connector.sch, touch.sch]
2020-11-16 touch only
    [touch.kicad_pcb, touch_panel.kicad_pcb]
2020-12-01 fixed bom for pcb manufacture
    [AllColoursoct12_fixed100k_2020.xls]
2020-12-04 touch pcb placement done
    [touch.kicad_pcb]
2020-12-08 main timing reduced to avoid intereference across modes
    [main.c]
2020-12-16 touch pcb
    [micro.sch, touch.kicad_pcb]
2020-12-18 lined up with jacks and jacks moved 1.3mm right on right side
    [touch.kicad_pcb, touch_basecopytotryalign.kicad_pcb]
2020-12-29 segements and some touch
    [CV.sch, inout.sch, micro.sch, panel_touch.sch, panelcopyforliningupwithjacks.kicad_pcb, power.sch, pulsesetc.sch, segments.sch]
2021-01-04 mostly segments
    [inout.sch, micro.sch, panelcopyforliningupwithjacks.kicad_pcb, power.sch, pulsesetc.sch, segments.kicad_pcb, segments.sch, touch.kicad_pcb]
2021-01-05 TOAD pcb
    [control.sch, filter.kicad_pcb]
2021-01-06 final hell pcb
    [micro.sch, segments_for_panelNEWEST.kicad_pcb, segments_liningup.kicad_pcb, segments_panel.kicad_pcb, segments_panel.sch]
2021-01-12 tocuh toggle smd version nearly done
    [filter.kicad_pcb, micro.sch, segments_for_panelNEWEST.kicad_pcb, segments_liningup.kicad_pcb, touch.kicad_pcb, touch.sch]
2021-01-18 final pcbs first protos
    [filter.kicad_pcb, segments_for_panelNEWEST.kicad_pcb, segments_liningup.kicad_pcb]
2021-02-05 fixed toad holes
2021-02-05 fixed touch panel
    [panelcopyforliningupwithjacks.kicad_pcb]
2021-02-08 fising segemnts panel and pcb
    [segments_for_panelNEWEST.kicad_pcb, segments_liningup.kicad_pcb]
2021-02-12 but now interrupt stopped
2021-02-12 added panel holding holes for TOAD!
2021-02-15 getting there...
    [st.cfg]
2021-04-07 2nd TOAD
    [anlog.sch, bintic.sch, control.sch, filter.sch, power.sch, toad2.kicad_pcb, toad2.sch]
2021-04-08 toggle_smd fixed for puldown and added donum dei based panel
    [anlog.sch, panel_touch.sch, touch.kicad_pcb, touch.sch, touch_panel.kicad_pcb, touch_panel.sch]
2021-04-13 latest touch pcb working for basics
2021-04-21 segments new pcb design/schematic fixes adc
    [CV.sch, IO.sch, allcolfilter.sch, file5AD5ACBA.sch, inout.sch, ionorms.sch, micro.sch, micro_old.sch]
2021-04-21 seg2 toad2
    [anlog.sch, bintic.sch, control.sch, power.sch, segments.kicad_pcb, toad2.sch]
2021-04-23 added touch headers on back of base pcb
    [IOjacks.sch, touch.kicad_pcb]
2021-05-17 fixing triggers which will need hardware changes...
    [main.c]
2021-06-04 low pass on adcs
    [panel_touch.sch, touch_panel.kicad_pcb, touch_panel.sch]
2021-12-28 speed issues to resolve
    [adcetc.h, main.c, resources.h, test2.c]
2022-03-23 missing sch
    [sigma.sch]
2023-04-03 pcb new
    [inout.kicad_sch, segments.kicad_pcb, segments.kicad_sch]
2023-04-24 final toad
    [toad2.kicad_pcb]
2023-05-23 touch bom to check
    [touch.kicad_pcb, touch_final_000_22050223.xls]
